FilipPaul/DIPLOMKA/tex/aktualni_19_05_2023/text/zkratky.tex

\cleardoublepage
\chapter*{\listofabbrevname}
\phantomsection
\addcontentsline{toc}{chapter}{\listofabbrevname}

\begin{acronym}[HowMuchSpace]
	\acro{ADC}{Analogově-Digitální Převodník}
	\acro{ARP}{Address Resolution Protocol}
	\acro{A/D}{Analogově-Digitální Převodník}
	\acro{bRC}{piny na spodní straně fixture}
	\acro{DAC}{Digitálně-Analogový Převodník}
	\acro{D/A}{Digitálně-Analogový Převodník}
	\acro{EEPROM}{Electrically Erasable Programmable Read-Only Memory}
	\acro{ESD}{Electrostatic Discharge - elektrostatický výboj}
	\acro{Fixture}{Vyměnitelný adaptér se zakládacím polem pro ICT testery}
	\acro{LED}{Light Emitting Diode}
	\acro{LWIP}{Lightweight IP}
	\acro{I2C}{Inter-Integrated Circuit}
	\acro{MAC}{Media Access Control}
	\acro{MDIX}{Medium Dependent Interface Crossover}
	\acro{PC}{Personal Computer - Počítač}
	\acro{PCB}{Printed Circuit Board - Deska plošných spojů}
	\acro{PHY}{Physical Layer - fyzická vrstva}
	\acro{Probes}{Testovací jehly}
	\acro{USB OTG}{USB On-The-Go}
	\acro{RMII}{Reduced Media Independent Interface}
\end{acronym}
