FilipPaul/DIPLOMKA/tex/aktualni_19_05_2023/text/literatura.tex

% Pro sazbu seznamu literatury použijte jednu z následujících možností

%%%%%%%%%%%%%%%%%%%%%%%%%%%%%%%%%%%%%%%%%%%%%%%%%%%%%%%%%%%%%%%%%%%%%%%%%
%1) Seznam citací definovaný přímo pomocí prostředí literatura / thebibliography

\begin{thebibliography}{99}

\bibitem{HOROWITZ}
    HOROWITZ, P., HILL, W.:
    \emph{The Art of Electronics.}\/ [online].
    2015, New York: Cambridge University Press, [cit.\,27.\,12.\,2022].
    Dostupné z~URL (direct download):\\
    <\url{https://www.uvm.edu/~gpetrucc/courses/Chem219/Lectures/Paul%20Horowitz,%20Winfield%20Hill%20-%20The%20Art%20of%20Electronics-Cambridge%20University%20Press%20(2015).pdf}>.

\bibitem{MARTINT}
    MARTIN, T.:
    \emph{he Insider's Guide to the STM32 ARM Based Microcontroller.}\/ [online].
    2008, T Coventry: Hitex Ltd., UK, [cit.\,27.\,12.\,2022].
    Dostupné z~URL:\\
    <\url{https://www.hitex.com/fileadmin/documents/tools/dev_tools/dt_protected/insiders-guides/stm32/isg-stm32-v18d-scr.pdf
    }>.

\bibitem{ICTkeysight}
    KEYSIGHT TECHNOLOGIES:
    \emph{Keysight Medalist i3070 Series 5}\/ [online].
		2017, Product datasheet Nr. 5990-4344EN [cit.\,27.\,12.\,2022].
    Dostupné z~URL:\\
    <\url{https://www.keysight.com/zz/en/assets/7018-02227/data-sheets/5990-4344.pdf}>.

\bibitem{ICT_picture}
    ACCULOGIC:
    \emph{Keysight (Agilent) 3070 Test Program}\/ [online].
    Keysight (Agilent) 3070 Test Program - product webpage [cit.\,27.\,12.\,2022].
    Dostupné z~URL:\\
    <\url{https://acculogic.com/services/test-engineering-services/in-circuit-test-programming-services/agilent-hp-3070-test-program-development-services/}>.

\bibitem{ICT_guidline}
    TERADYNE, Smith, J. Michael:
    \emph{ICT Fixture Guidelines}\/ [online].
    ICT Fixture Guidelines, Test Techniques and Practices [cit.\,27.\,12.\,2022].
    Dostupné z~URL (direct download):\\
    <\url{https://courseware.zcu.cz/CoursewarePortlets2/DownloadDokumentu?id=114866}>.

\bibitem{CAD_wiki}
    Wikipedia:
    \emph{CAD data exchange}\/ [online].
    2022, Wikipedia - CAD data exchange [cit.\,27.\,12.\,2022].
    Dostupné z~URL:\\
    <\url{https://en.wikipedia.org/wiki/CAD_data_exchange}>.

\bibitem{Sensitivity_embedded}
    Mark Fortunato:
    \emph{Analyzing circuit sensitivity for analog circuit design}\/ [online].
    2008, Analyzing circuit sensitivity for analog circuit design - Embedded Staff magazine [cit.\,27.\,12.\,2022].
    Dostupné z~URL:\\
    <\url{https://www.embedded.com/analyzing-circuit-sensitivity-for-analog-circuit-design/}>.

\bibitem{Sensitivity_2}
    Emmanuel A. Gonzalez,  Martin Christian G. Leonor, Leonard U. Ambata:
    \emph{Analyzing Sensitivity in Electric Circuits}\/ [online].
    2007,Analyzing Sensitivity in Electric Circuits - IEEE MULTIDISCIPLINARY ENGINEERING EDUCATION MAGAZINE [cit.\,27.\,12.\,2022].
    Dostupné z~URL (direct download):\\
    <\url{https://nanopdf.com/download/analyzing-sensitivity-in-electric-circuits_pdf}>.

\bibitem{PMOS_datasheet}
    TOSHIBA:
    \emph{SSM3J358R}\/ [online].
    SSM3J358R - Product datasheet [cit.\,27.\,12.\,2022].
    Dostupné z~URL:\\
    <\url{https://cz.mouser.com/datasheet/2/408/SSM3J358R_datasheet_en_20170124-1916450.pdf}>.

\bibitem{NMOS_datasheet}
    PANJIT Semiconductor:
    \emph{PJA3432}\/ [online].
    PJA3432 - Product datasheet [cit.\,27.\,12.\,2022].
    Dostupné z~URL:\\
    <\url{https://cz.mouser.com/datasheet/2/1057/PJA3432-1867274.pdf}>.

\bibitem{comp_datasheet}
    TEXAS INSTRUMENTS:
    \emph{LM393LV-Q1 Dual and LM339LV-Q1 Quad Low Voltage, RRI Automotive Comparators}\/ [online].
    LM393LV-Q1 Dual and LM339LV-Q1 Quad Low Voltage, RRI Automotive Comparators - Product datasheet [cit.\,27.\,12.\,2022].
    Dostupné z~URL:\\
    <\url{https://www.ti.com/lit/ds/symlink/lm393lv-q1.pdf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}>.

\bibitem{shift_datasheet}
    TEXAS INSTRUMENTS:
    \emph{SNx4AHCT595 8-Bit Shift Registers With 3-State Output Registers}\/ [online].
    SNx4AHCT595 8-Bit Shift Registers With 3-State Output Registers - Product datasheet [cit.\,27.\,12.\,2022].
    Dostupné z~URL:\\
    <\url{https://www.ti.com/lit/ds/symlink/sn74ahct595.pdf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}>.

\bibitem{mux_datasheet}
    TEXAS INSTRUMENTS:
    \emph{TMUX13xx-Q1 Automotive 5-V, Bidirectional 8:1, 1-Channel and 4:1, 2-Channel
    Multiplexers with Injection Current Control}\/ [online].
    TMUX13xx-Q1 Automotive 5-V, Bidirectional 8:1, 1-Channel and 4:1, 2-Channel
    Multiplexers with Injection Current Control - Product datasheet [cit.\,27.\,12.\,2022].
    Dostupné z~URL:\\
    <\url{https://www.ti.com/lit/ds/symlink/tmux1308-q1.pdf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}>.

\bibitem{regulator_datasheet}
    TEXAS INSTRUMENTS:
    \emph{TLV767 1-A, 16-V Precision Linear Voltage Regulator}\/ [online].
    TLV767 1-A, 16-V Precision Linear Voltage Regulator - Product datasheet [cit.\,27.\,12.\,2022].
    Dostupné z~URL:\\
    <\url{https://www.ti.com/lit/ds/symlink/tlv767.pdf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}>.

\bibitem{DAC}
    STMICROELECTRONICS:
    \emph{Extending the DAC performance of STM32 microcontrollers}\/ [online].
    Application note - AN4566 [cit.\,27.\,12.\,2022].
    Dostupné z~URL:\\
    <\url{https://www.st.com/resource/en/application_note/an4566-extending-the-dac-performance-of-stm32-microcontrollers-stmicroelectronics.pdf}>.

\bibitem{DAC_stability}
    Soufiane Bendaoud, Giampaolo Marino:
    \emph{Practical Techniques to Avoid Instability Due to Capacitive Loading}\/ [online].
    Ask The Application Engineer - 32 [cit.\,27.\,12.\,2022].
    Dostupné z~URL:\\
    <\url{https://ez.analog.com/cfs-file/__key/telligent-evolution-components-attachments/00-383-00-00-00-01-74-37/plugin_2D00_capacitive_5F00_loading_2D00_1.pdf}>.

\bibitem{OPA_stability}
    Tim Green, Texas Instruments:
    \emph{Operational Amplifier Stability Part 6 of 15: Capacitance-Load Stability}\/ [online].
    Burr-Brown Products from Texas Instruments, published in analogZone [cit.\,27.\,12.\,2022].
    Dostupné z~URL:\\
    <\url{https://picture.iczhiku.com/resource/eetop/sYKySllZpyOOSBNB.pdf}>.

\bibitem{OPA_datasheet}
    ANALOG DEVICES:
    \emph{Low Cost, 250 mA Output Single-Supply Amplifiers}\/ [online].
    AD8531/AD8532/AD8534 - Product datasheet [cit.\,30.\,04.\,2022].
    Dostupné z~URL:\\
    <\url{https://pdf1.alldatasheet.com/datasheet-pdf/view/48476/AD/AD8532.html}>.

\end{thebibliography}

%%%%%%%%%%%%%%%%%%%%%%%%%%%%%%%%%%%%%%%%%%%%%%%%%%%%%%%%%%%%%%%%%%%%%%%%%
%%2) Seznam citací pomocí BibTeXu
%% Při použití je nutné v TeXnicCenter ve výstupním profilu aktivovat spouštění BibTeXu po překladu.
%% Definice stylu seznamu
%\bibliographystyle{unsrturl}
%% Pro českou sazbu lze použít styl czechiso.bst ze stránek
%% http://www.fit.vutbr.cz/~martinek/latex/czechiso.tar.gz
%%\bibliographystyle{czechiso}
%% Vložení souboru se seznamem citací
%\bibliography{text/literatura}
%
%% Následující příkaz je pouze pro ukázku sazby literatury při použití BibTeXu.
%% Způsobí citaci všech zdrojů v souboru literatura.bib, i když nejsou citovány v textu.
%\nocite{*}
