FilipPaul/DIPLOMKA/tex/aktualni_19_05_2023/obrazky/general_dVF-eps-converted-to.pdf

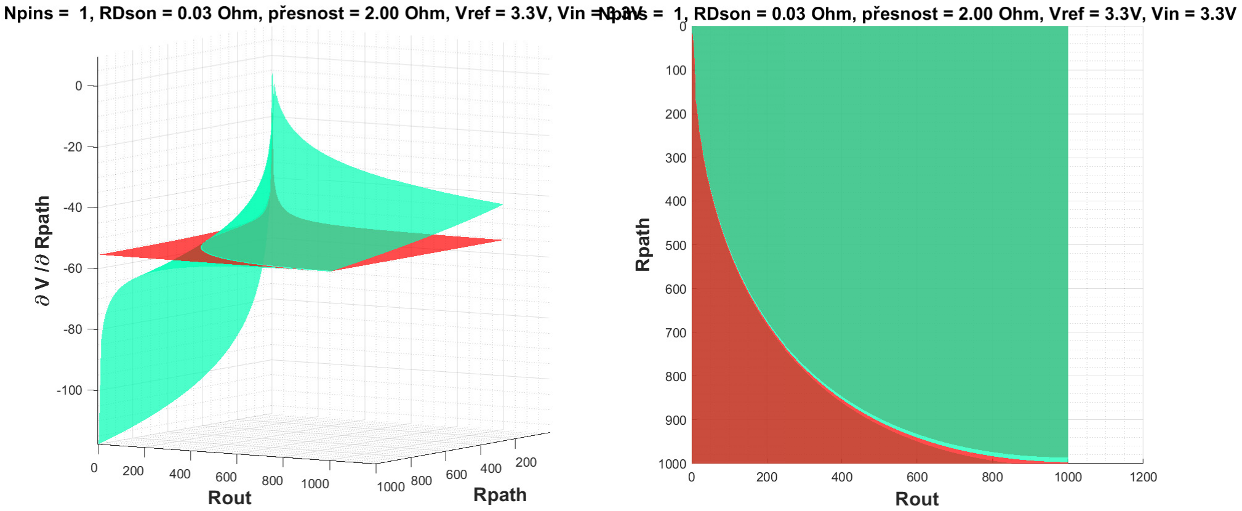
[picture p42: page 1]
