FilipPaul/DIPLOMKA/tex/aktualni_19_05_2023/obrazky/MERENI_JEDNOHO_PINU-eps-converted-to.pdf

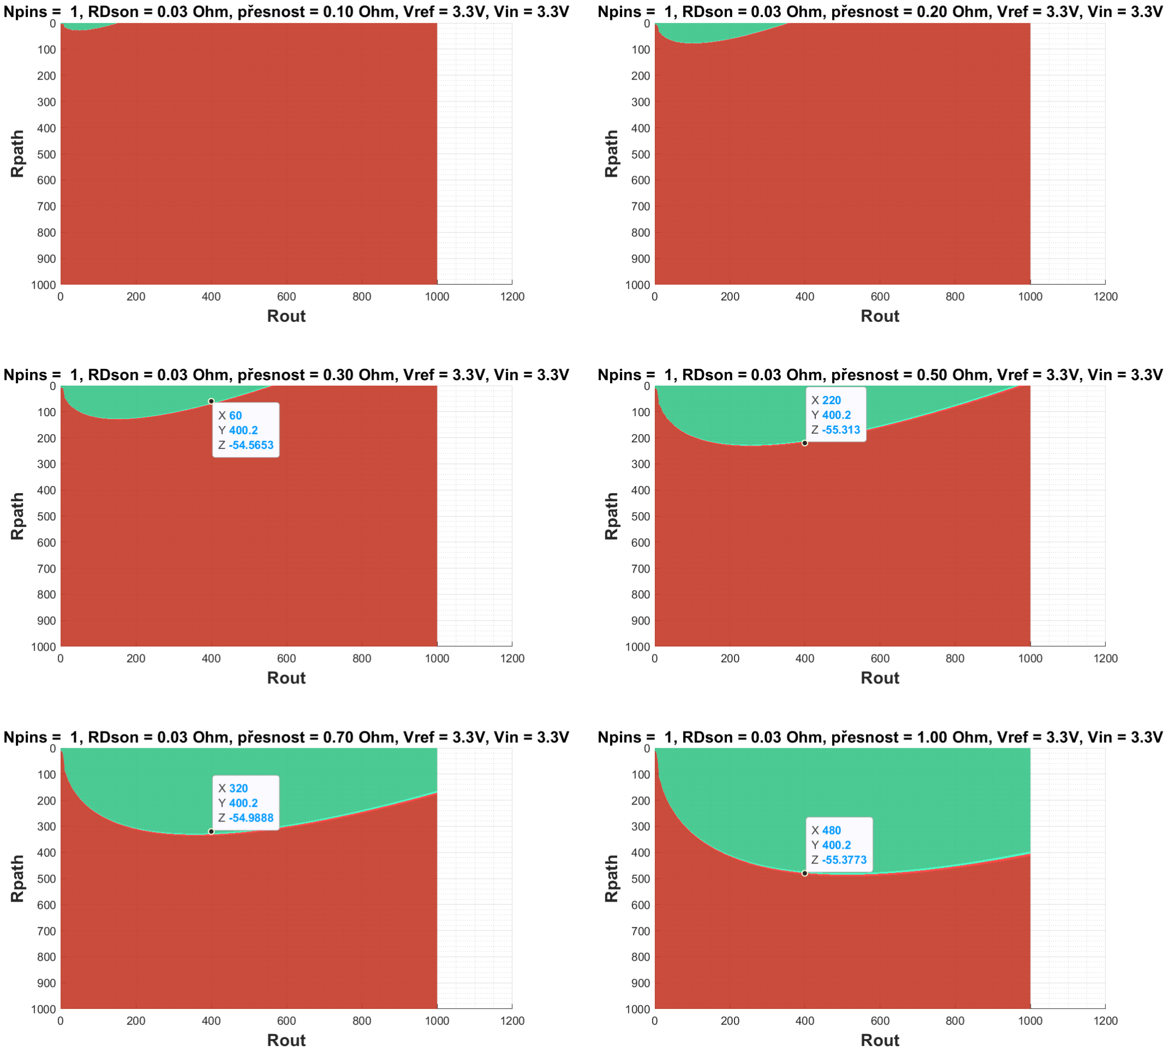
[picture p43: page 1]
