FilipPaul/DIPLOMKA/tex/aktualni_19_05_2023/obrazky/PASS_FAIL_MERENI-eps-converted-to.pdf

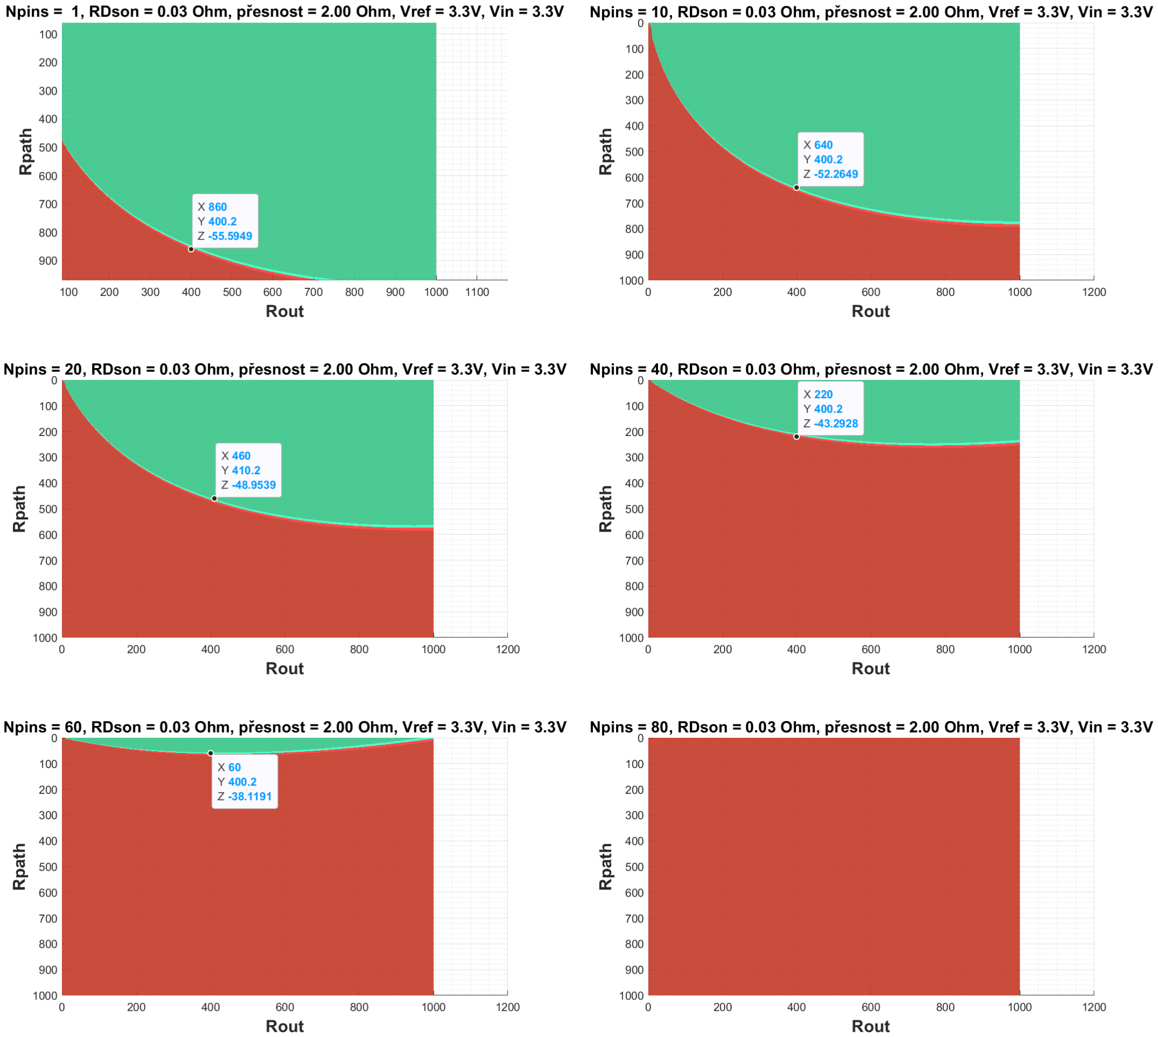
[picture p44: page 1]
