FilipPaul/DIPLOMKA/tex/aktualni_19_05_2023/obrazky/R_net_3D_view-eps-converted-to.pdf

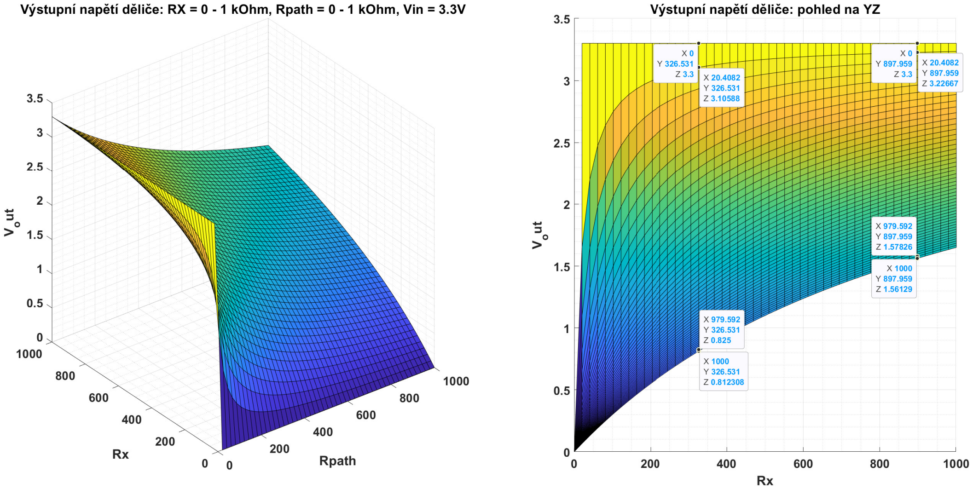
[picture p45: page 1]
