FilipPaul/DIPLOMKA/tex/aktualni_19_05_2023/obrazky/vliv_RDSON-eps-converted-to.pdf

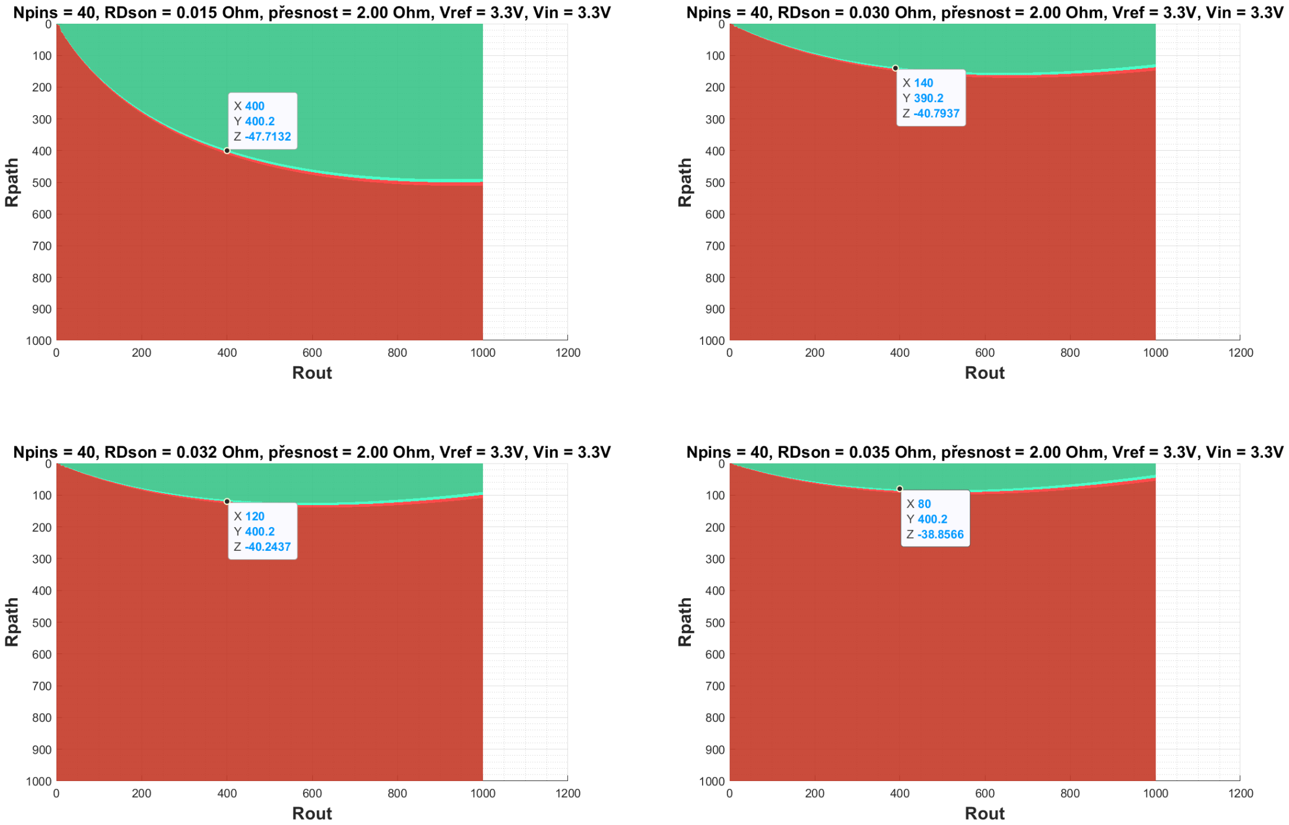
[picture p46: page 1]
