FilipPaul/DIPLOMKA/tex/aktualni_19_05_2023/obrazky/Vout3D-eps-converted-to.pdf

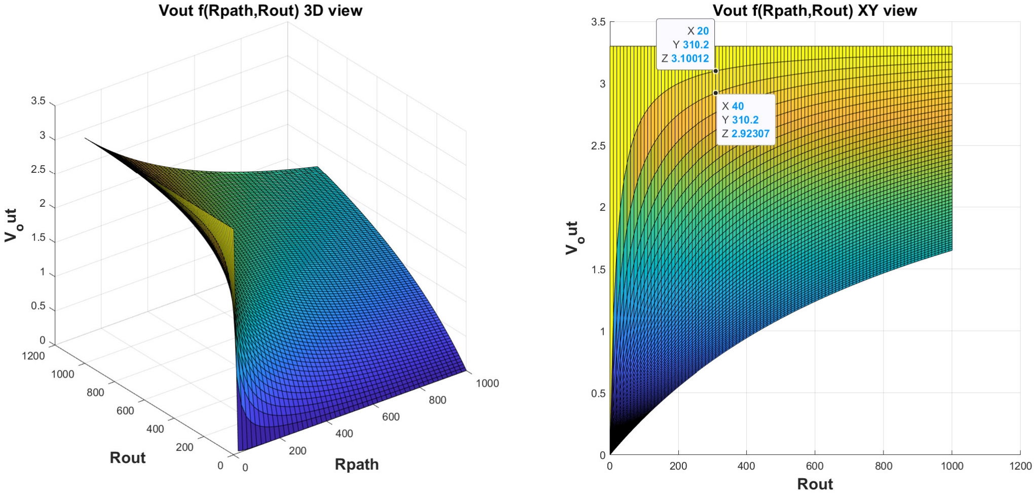
[picture p47: page 1]
