FilipPaul/DIPLOMKA/PSCM_7Fold_STA3/output.png

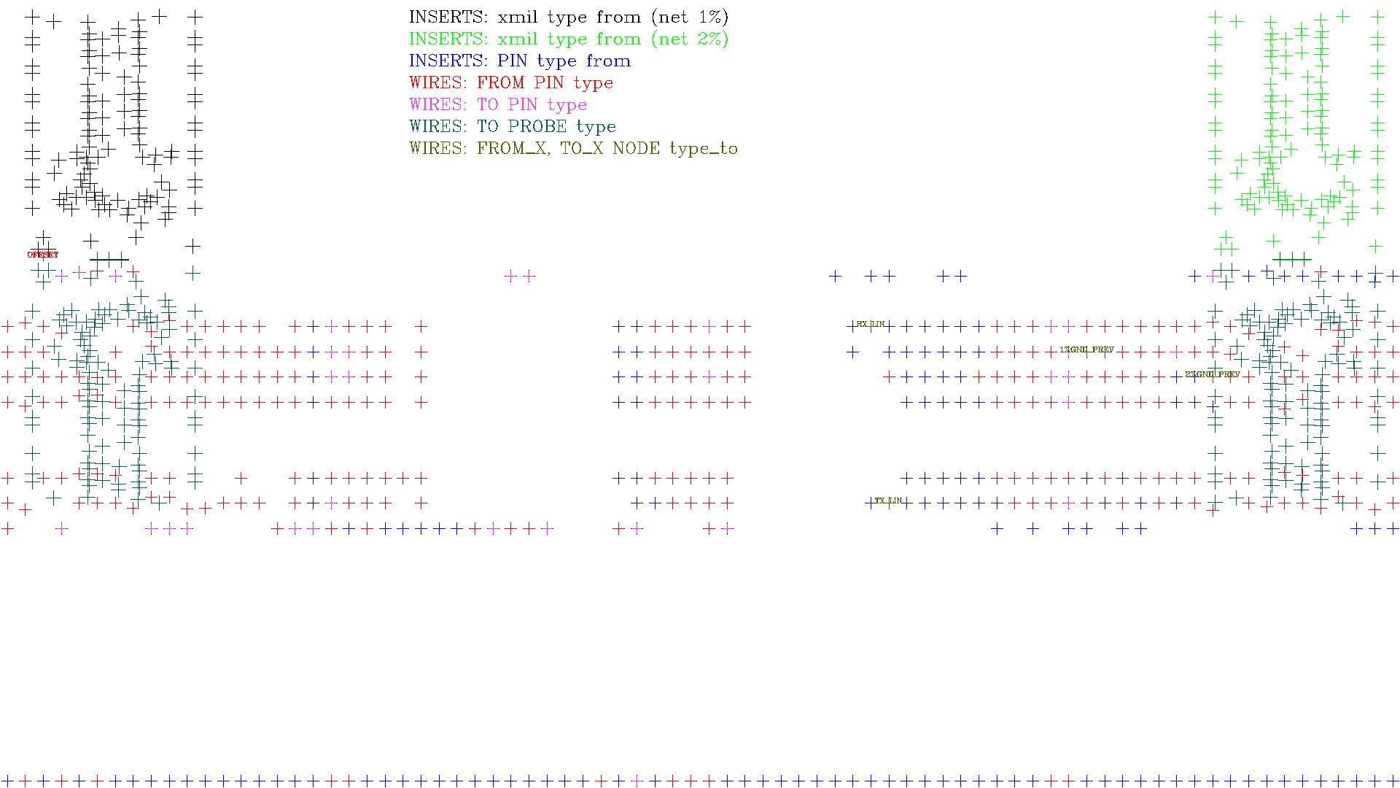
PSCM_7Fold_STA3/output.png
