FilipPaul/DIPLOMKA/PSCM_7Fold_STA3/trace_wires.png

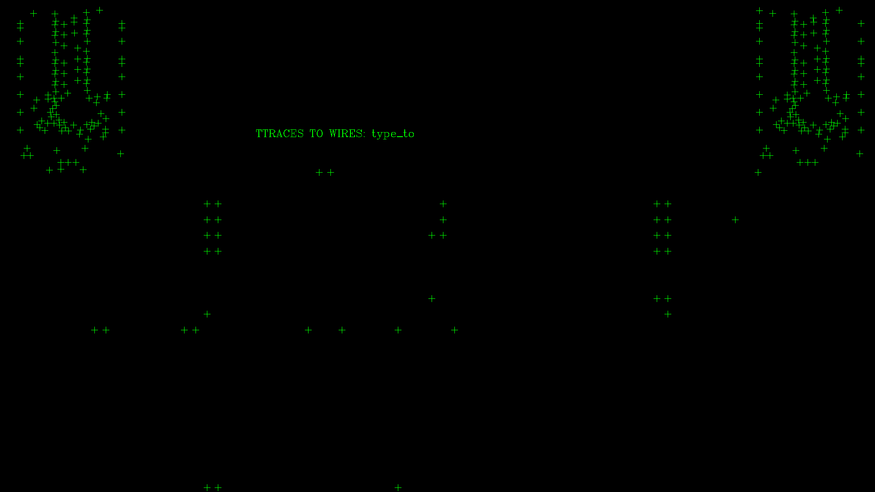
PSCM_7Fold_STA3/trace_wires.png
