FilipPaul/DIPLOMKA/tex/aktualni_19_05_2023/obrazky/CLK_config.png

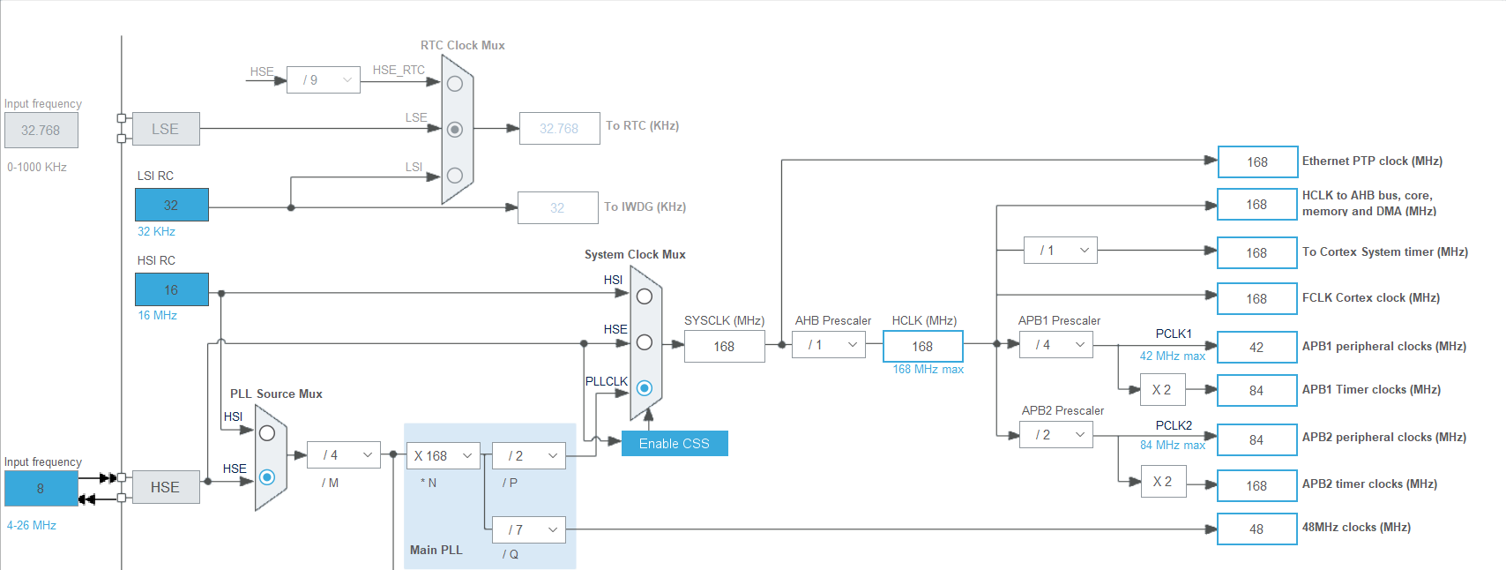
tex/aktualni_19_05_2023/obrazky/CLK_config.png
