FilipPaul/DIPLOMKA/tex/aktualni_19_05_2023/obrazky/CLK_rezonator.png

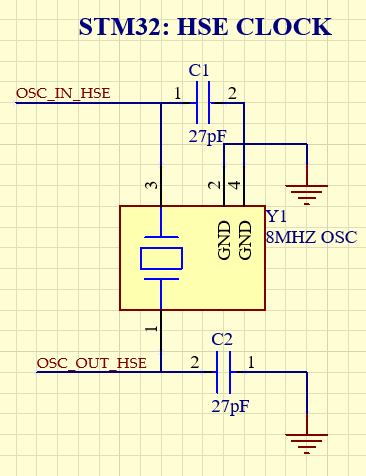
tex/aktualni_19_05_2023/obrazky/CLK_rezonator.png
