FilipPaul/DIPLOMKA/tex/aktualni_19_05_2023/obrazky/final_analog_frontend.png

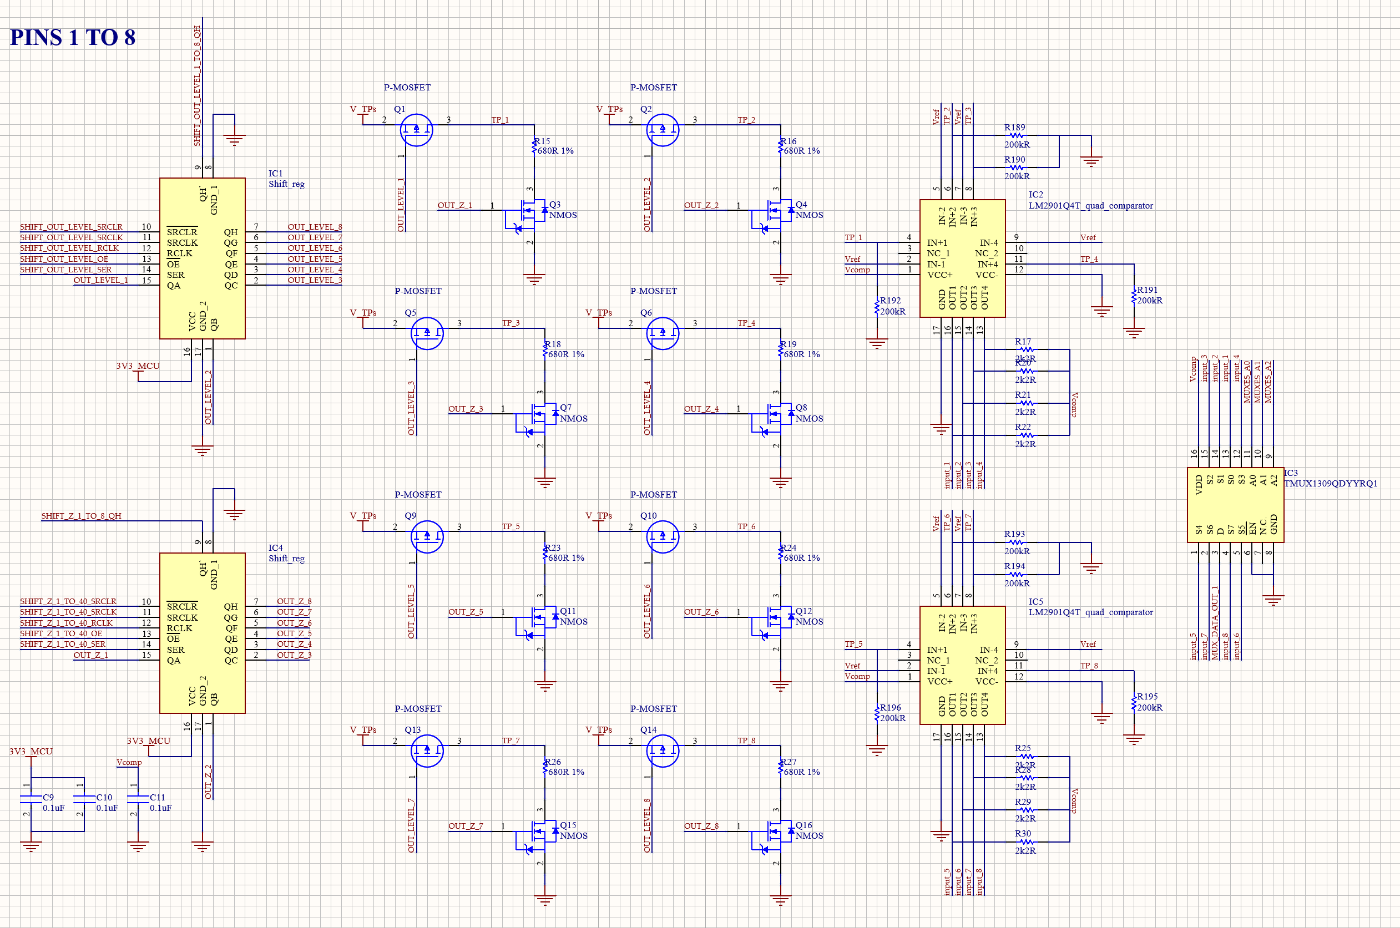
tex/aktualni_19_05_2023/obrazky/final_analog_frontend.png
