FilipPaul/DIPLOMKA/tex/aktualni_19_05_2023/obrazky/IMG_20220402_110809.jpg

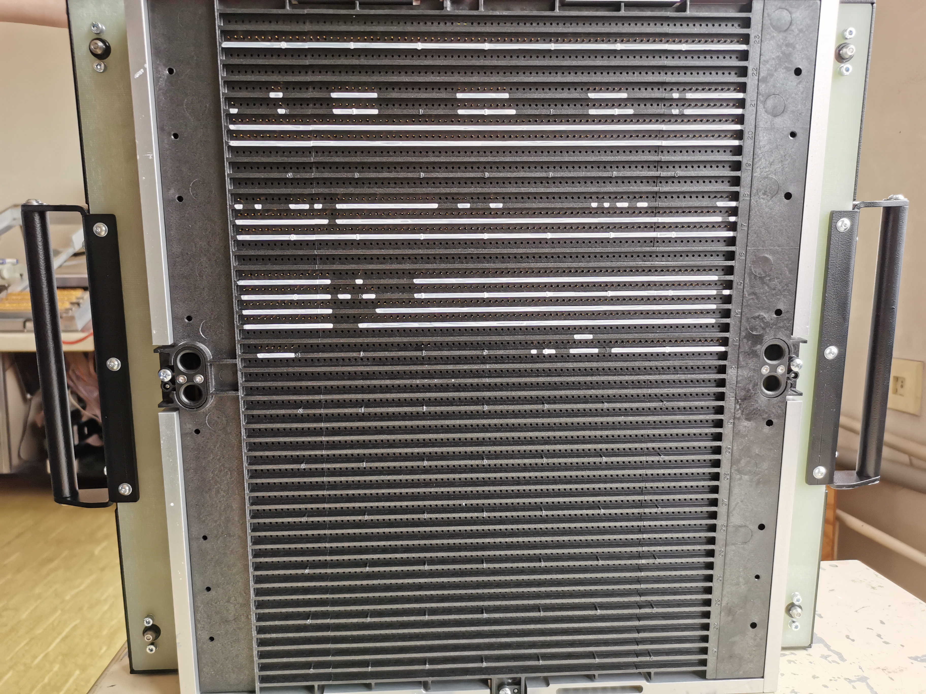
tex/aktualni_19_05_2023/obrazky/IMG_20220402_110809.jpg
