FilipPaul/DIPLOMKA/tex/aktualni_19_05_2023/obrazky/IMG_20220402_110835.jpg

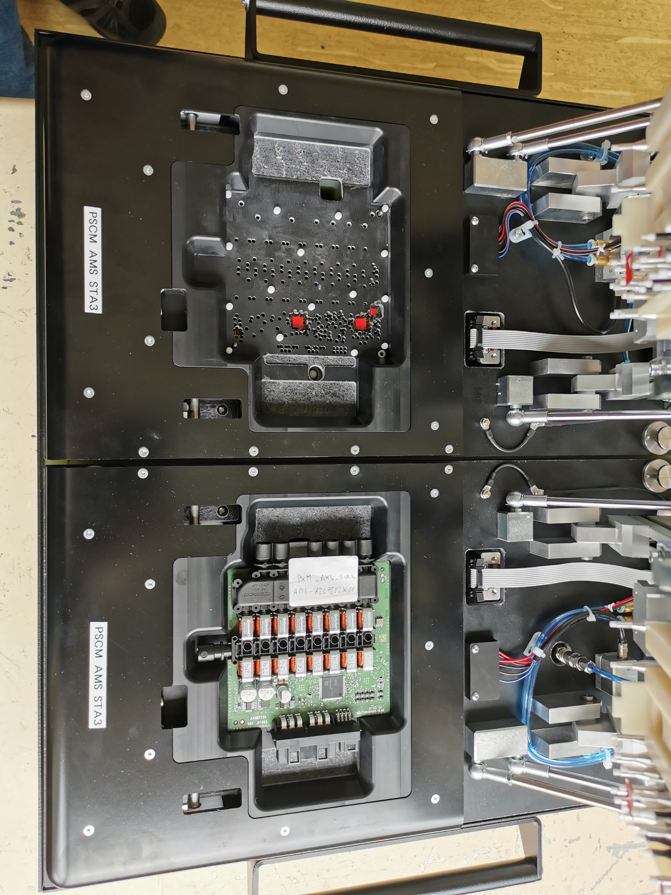
tex/aktualni_19_05_2023/obrazky/IMG_20220402_110835.jpg
