FilipPaul/DIPLOMKA/tex/aktualni_19_05_2023/obrazky/IMG_20221017_144735.jpg

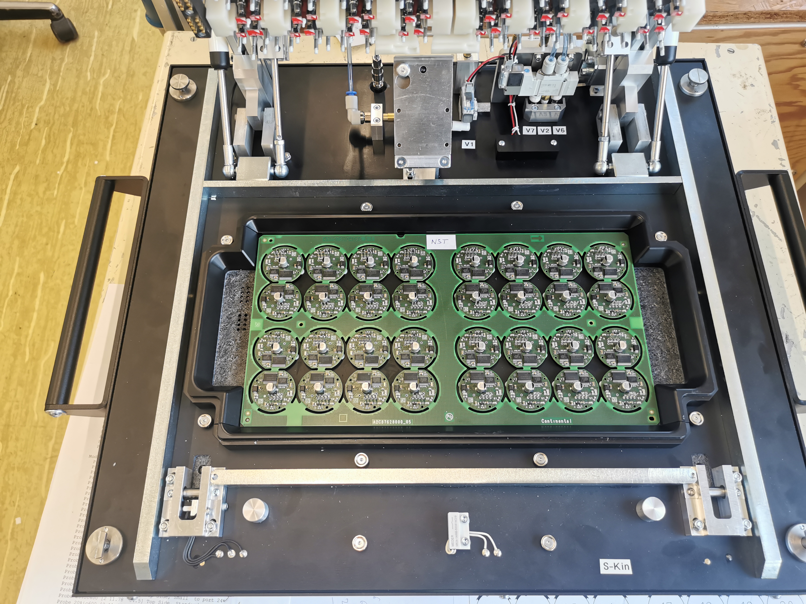
tex/aktualni_19_05_2023/obrazky/IMG_20221017_144735.jpg
