FilipPaul/DIPLOMKA/tex/aktualni_19_05_2023/obrazky/karta_3D_bot.png

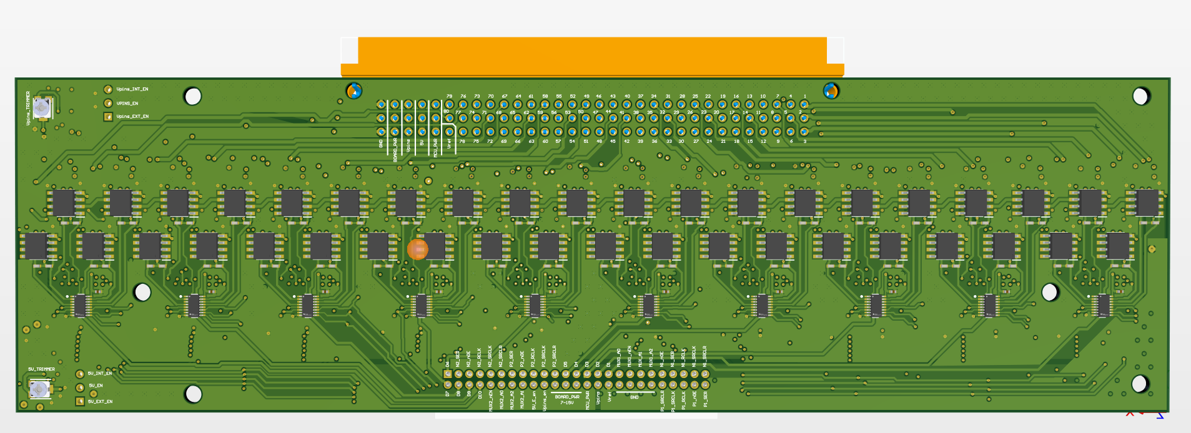
tex/aktualni_19_05_2023/obrazky/karta_3D_bot.png
