FilipPaul/DIPLOMKA/tex/aktualni_19_05_2023/obrazky/layer_3.png

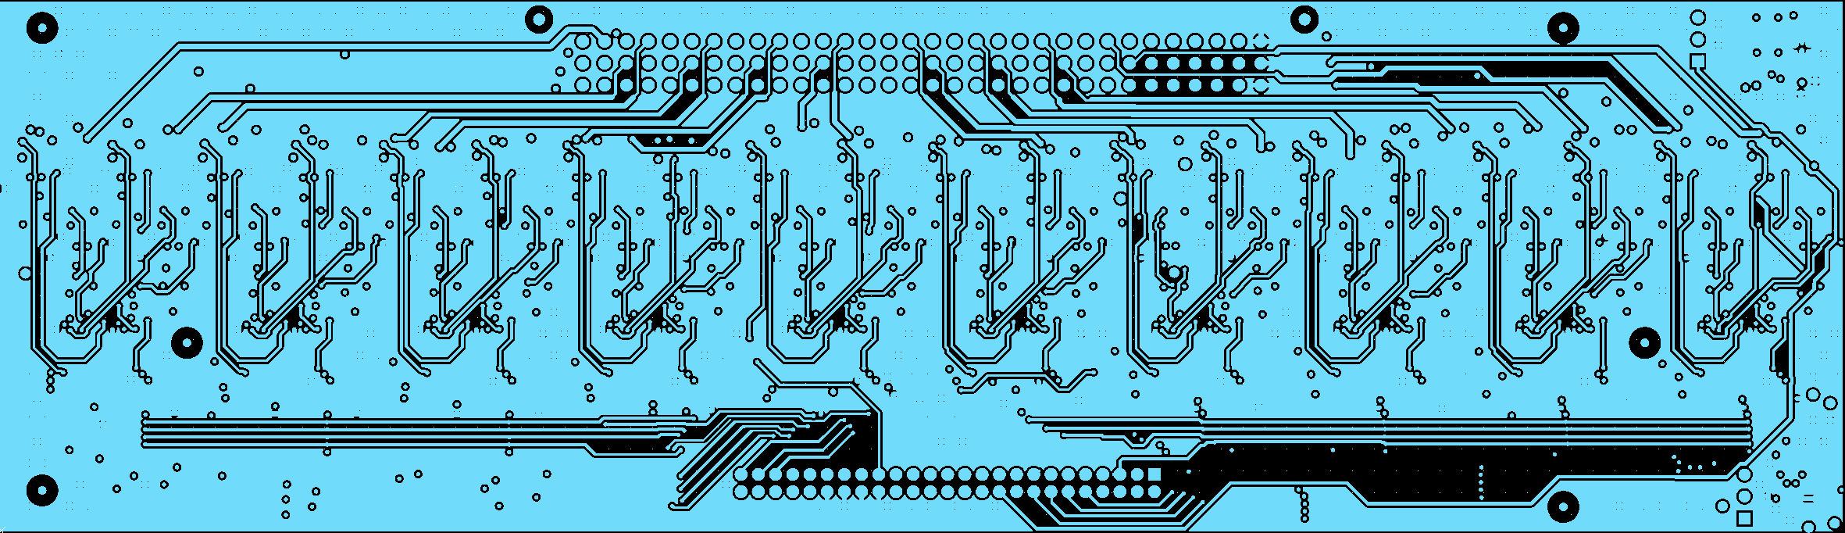
tex/aktualni_19_05_2023/obrazky/layer_3.png
