FilipPaul/DIPLOMKA/tex/aktualni_19_05_2023/obrazky/layer_5.png

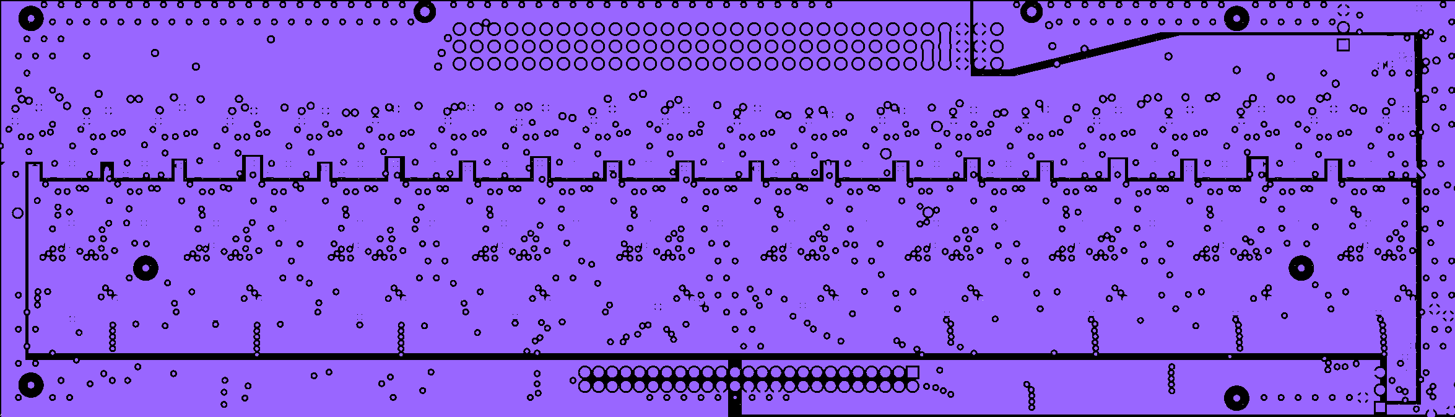
tex/aktualni_19_05_2023/obrazky/layer_5.png
