FilipPaul/DIPLOMKA/tex/aktualni_19_05_2023/obrazky/layer_top.png

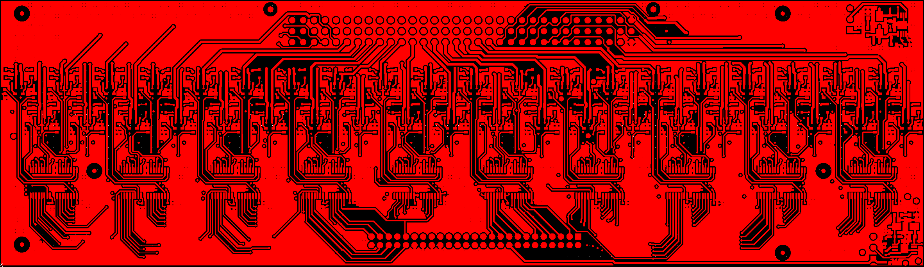
tex/aktualni_19_05_2023/obrazky/layer_top.png
