FilipPaul/DIPLOMKA/tex/aktualni_19_05_2023/obrazky/PC_AP_top_another_one.png

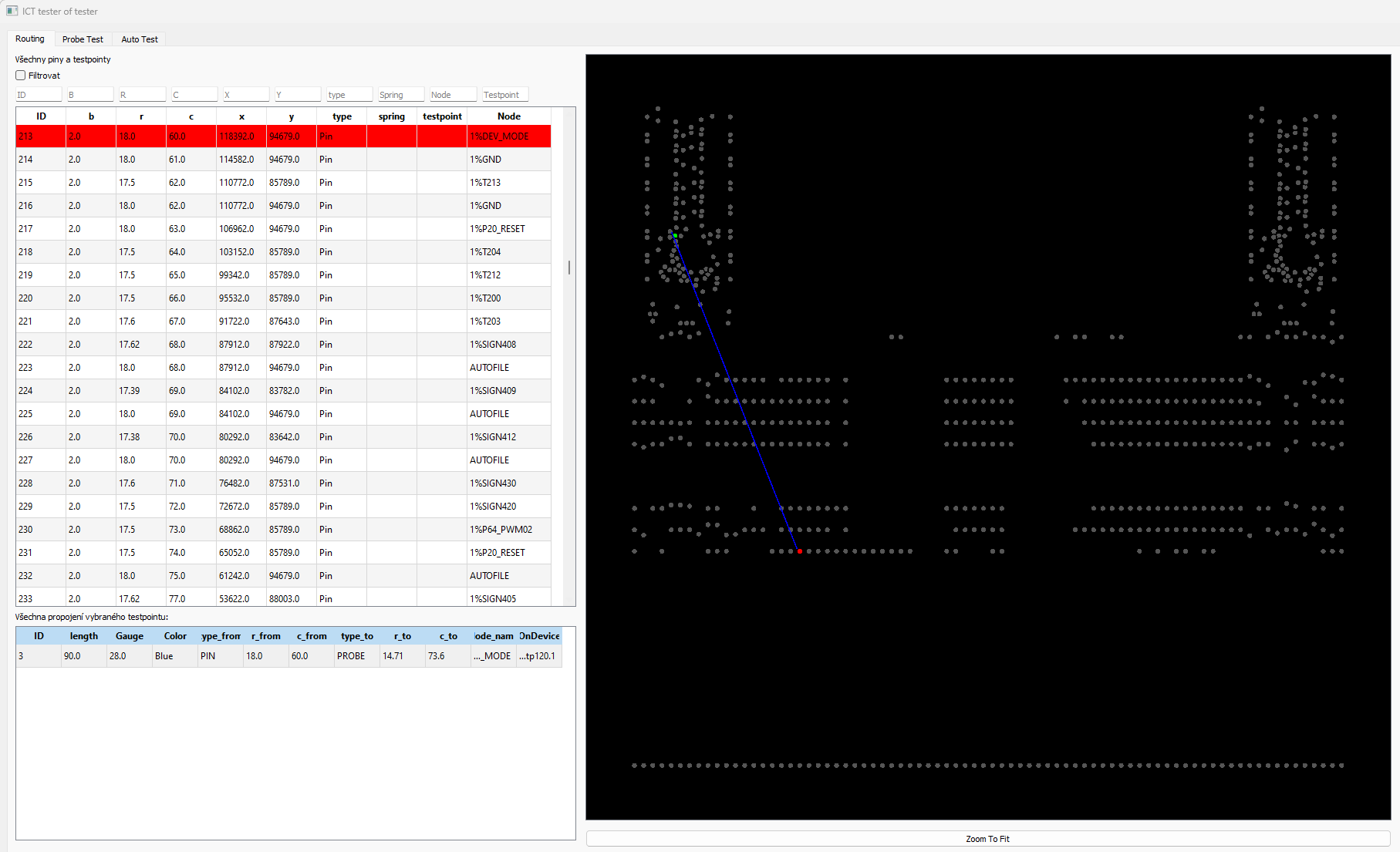
tex/aktualni_19_05_2023/obrazky/PC_AP_top_another_one.png
