FilipPaul/DIPLOMKA/tex/aktualni_19_05_2023/obrazky/placeholder.png

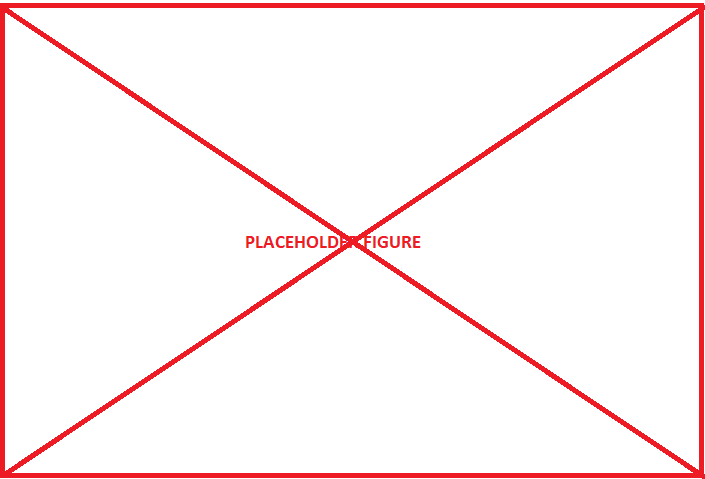
tex/aktualni_19_05_2023/obrazky/placeholder.png
