FilipPaul/DIPLOMKA/tex/aktualni_19_05_2023/obrazky/snubber_values.png

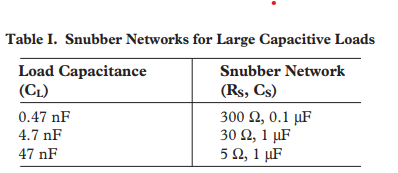
tex/aktualni_19_05_2023/obrazky/snubber_values.png
