FilipPaul/DIPLOMKA/tex/aktualni_19_05_2023/obrazky/system_connection.png

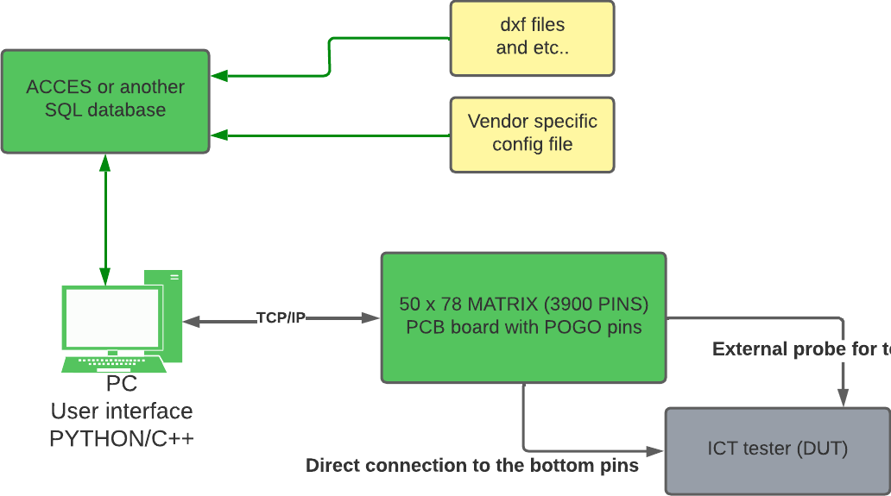
tex/aktualni_19_05_2023/obrazky/system_connection.png
