FilipPaul/DIPLOMKA/tex/aktualni_19_05_2023/obrazky/telnet_communication.png

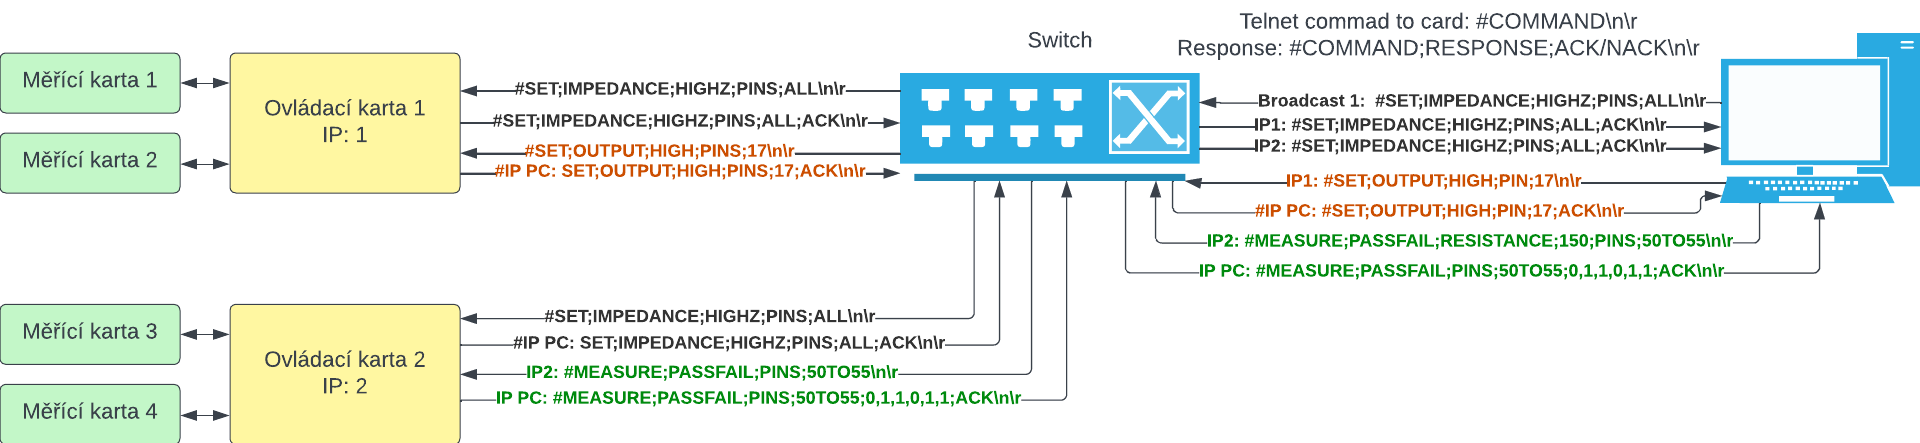
tex/aktualni_19_05_2023/obrazky/telnet_communication.png
