FilipPaul/DIPLOMKA/tex/sablona-cze/obrazky/pcb_layout_ctr_board_draftsman.png

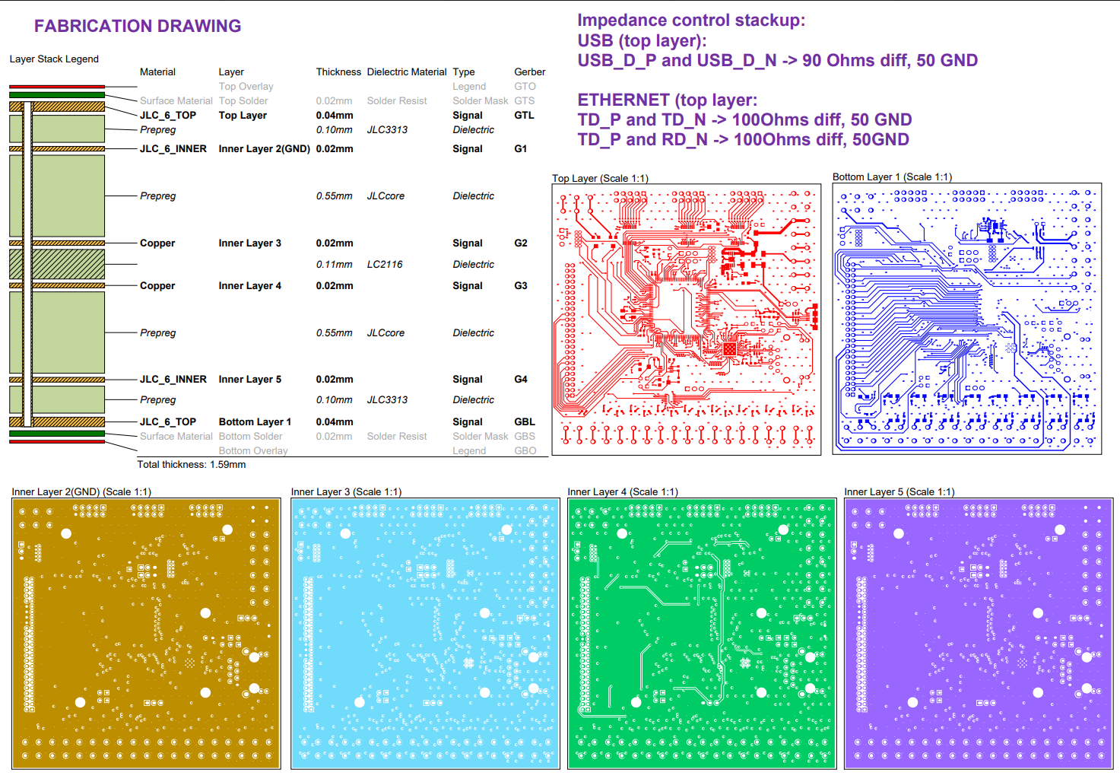
tex/sablona-cze/obrazky/pcb_layout_ctr_board_draftsman.png
