FilipPaul/DIPLOMKA/PCB_merici_karta/osazovak_a_BOM.xlsx

Sheet: BOM-Souhrn
BOM a PICKPLACE pro Analogovou desku testeru zkratů | 2023-03-04
 |  |  |  | Počet desek | 50
LINK | DESCRIPTION1 | DESCRIPTION 2 | DESIGNATOR | Qtty (1deska) | celkem na x deskách
C0402C104K3RACTU KEMET | Mouser Česká Republika (https://cz.mouser.com/ProductDetail/KEMET/C0402C104K3RACTU?qs=YCcZ0GhAU2q7BaxZ%2FluQHA%3D%3D) | 100nF | Cap Ceramic 0.1uF 25V X7R 10% Pad SMD 0402 125C T/R | 8pins1_C18, 8pins1_C19, 8pins1_C20, 8pins2_C18, 8pins2_C19, 8pins2_C20, 8pins3_C18, 8pins3_C19, 8pins3_C20, 8pins4_C18, 8pins4_C19, 8pins4_C20, 8pins5_C18, 8pins5_C19, 8pins5_C20, 8pins6_C18, 8pins6_C19, 8pins6_C20, 8pins7_C18, 8pins7_C19, 8pins7_C20, 8pins8_C18, 8pins8_C19, 8pins8_C20, 8pins9_C18, 8pins9_C19, 8pins9_C20, 8pins10_C18, 8pins10_C19, 8pins10_C20 | 30 | 1500
SN74AHCT595PWR Texas Instruments | Mouser Česká Republika (https://cz.mouser.com/ProductDetail/?qs=spW5eSrOWB5KP%2FLOxGLzFA%3D%3D) | SN74AHCT595PWR | 8-Bit Shift Registers With 3-State Output Registers, PW0016A, LARGE T&R | 8pins1_U2, 8pins1_U4, 8pins2_U2, 8pins2_U4, 8pins3_U2, 8pins3_U4, 8pins4_U2, 8pins4_U4, 8pins5_U2, 8pins5_U4, 8pins6_U2, 8pins6_U4, 8pins7_U2, 8pins7_U4, 8pins8_U2, 8pins8_U4, 8pins9_U2, 8pins9_U4, 8pins10_U2, 8pins10_U4 | 20 | 1000
TMUX1308QDYYRQ1 Texas Instruments | Mouser Česká Republika (https://cz.mouser.com/ProductDetail/Texas-Instruments/TMUX1308QDYYRQ1?qs=xZ%2FP%252Ba9zWqaqz9D2kpWQ%2FA%3D%3D) | TMUX1308QDYYRQ1 | AUTOMOTIVE, 5-V, 8:1, 1-CHANNEL | 8pins1_U3, 8pins2_U3, 8pins3_U3, 8pins4_U3, 8pins5_U3, 8pins6_U3, 8pins7_U3, 8pins8_U3, 8pins9_U3, 8pins10_U3 | 10 | 500
F381A106MMAAH1 KYOCERA AVX | Mouser Česká Republika (https://cz.mouser.com/ProductDetail/KYOCERA-AVX/F381A106MMAAH1) | 10uF | CAP TANT POLY 10UF 10V SMD | C21, C27 | 2 | 100
C1608X7R1E105K080AB TDK | Mouser Česká Republika (https://cz.mouser.com/ProductDetail/TDK/C1608X7R1E105K080AB?qs=NRhsANhppD8okfR52aTdVA%3D%3D) | 1uF 25V | General Purpose Ceramic Capacitor, 0603, 1uF, 10%, X5R, 15%, 25V | C22, C28 | 2 | 100
SML-D12U1WT86 ROHM Semiconductor | Mouser Česká Republika (https://cz.mouser.com/ProductDetail/ROHM-Semiconductor/SML-D12U1WT86?qs=M3jcYzEJUdEySuGkbjHEtQ%3D%3D) | LED | LED RED DIFFUSED 1608 SMD | D1, D3 | 2 | 100
SSA34HE3_A/I Vishay General Semiconductor | Mouser Česká Republika (https://cz.mouser.com/ProductDetail/Vishay-General-Semiconductor/SSA34HE3_A-I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) | SSA34HE3_A_I | Schottky Diode | D11, D13 | 2 | 100
LM393LVQDRQ1 Texas Instruments | Mouser Česká Republika (https://cz.mouser.com/ProductDetail/Texas-Instruments/LM393LVQDRQ1?qs=IS%252B4QmGtzzqk8QFsvXuXMw%3D%3D) | LM393LVQDRQ1 | Integrated Circuit | dTP1_IC1, dTP2_IC1, dTP3_IC1, dTP4_IC1, dTP5_IC1, dTP6_IC1, dTP7_IC1, dTP8_IC1, dTP9_IC1, dTP10_IC1, dTP11_IC1, dTP12_IC1, dTP13_IC1, dTP14_IC1, dTP15_IC1, dTP16_IC1, dTP17_IC1, dTP18_IC1, dTP19_IC1, dTP20_IC1, dTP21_IC1, dTP22_IC1, dTP23_IC1, dTP24_IC1, dTP25_IC1, dTP26_IC1, dTP27_IC1, dTP28_IC1, dTP29_IC1, dTP30_IC1, dTP31_IC1, dTP32_IC1, dTP33_IC1, dTP34_IC1, dTP35_IC1, dTP36_IC1, dTP37_IC1, dTP38_IC1, dTP39_IC1, dTP40_IC1 | 40 | 2000
SSM3J358R,LF Toshiba | Mouser Česká Republika (https://cz.mouser.com/ProductDetail/Toshiba/SSM3J358RLF?qs=HXFqYaX1Q2xwvCtt1GGmkw%3D%3D) | P-MOSFET | MOSFET (P-Channel) - low RDS on | dTP1_Q1, dTP1_Q2, dTP2_Q1, dTP2_Q2, dTP3_Q1, dTP3_Q2, dTP4_Q1, dTP4_Q2, dTP5_Q1, dTP5_Q2, dTP6_Q1, dTP6_Q2, dTP7_Q1, dTP7_Q2, dTP8_Q1, dTP8_Q2, dTP9_Q1, dTP9_Q2, dTP10_Q1, dTP10_Q2, dTP11_Q1, dTP11_Q2, dTP12_Q1, dTP12_Q2, dTP13_Q1, dTP13_Q2, dTP14_Q1, dTP14_Q2, dTP15_Q1, dTP15_Q2, dTP16_Q1, dTP16_Q2, dTP17_Q1, dTP17_Q2, dTP18_Q1, dTP18_Q2, dTP19_Q1, dTP19_Q2, dTP20_Q1, dTP20_Q2, dTP21_Q1, dTP21_Q2, dTP22_Q1, dTP22_Q2, dTP23_Q1, dTP23_Q2, dTP24_Q1, dTP24_Q2, dTP25_Q1, dTP25_Q2, dTP26_Q1, dTP26_Q2, dTP27_Q1, dTP27_Q2, dTP28_Q1, dTP28_Q2, dTP29_Q1, dTP29_Q2, dTP30_Q1, dTP30_Q2, dTP31_Q1, dTP31_Q2, dTP32_Q1, dTP32_Q2, dTP33_Q1, dTP33_Q2, dTP34_Q1, dTP34_Q2, dTP35_Q1, dTP35_Q2, dTP36_Q1, dTP36_Q2, dTP37_Q1, dTP37_Q2, dTP38_Q1, dTP38_Q2, dTP39_Q1, dTP39_Q2, dTP40_Q1, dTP40_Q2 | 80 | 4000
PJA3432_R1_00001 Panjit | Mouser Česká Republika (https://cz.mouser.com/ProductDetail/Panjit/PJA3432_R1_00001?qs=sPbYRqrBIVmGu%2F98hdrYZA%3D%3D) | NMOS | N-Channel MOSFET Transistor PJA3432_R1_00001 | dTP1_Q3, dTP1_Q4, dTP2_Q3, dTP2_Q4, dTP3_Q3, dTP3_Q4, dTP4_Q3, dTP4_Q4, dTP5_Q3, dTP5_Q4, dTP6_Q3, dTP6_Q4, dTP7_Q3, dTP7_Q4, dTP8_Q3, dTP8_Q4, dTP9_Q3, dTP9_Q4, dTP10_Q3, dTP10_Q4, dTP11_Q3, dTP11_Q4, dTP12_Q3, dTP12_Q4, dTP13_Q3, dTP13_Q4, dTP14_Q3, dTP14_Q4, dTP15_Q3, dTP15_Q4, dTP16_Q3, dTP16_Q4, dTP17_Q3, dTP17_Q4, dTP18_Q3, dTP18_Q4, dTP19_Q3, dTP19_Q4, dTP20_Q3, dTP20_Q4, dTP21_Q3, dTP21_Q4, dTP22_Q3, dTP22_Q4, dTP23_Q3, dTP23_Q4, dTP24_Q3, dTP24_Q4, dTP25_Q3, dTP25_Q4, dTP26_Q3, dTP26_Q4, dTP27_Q3, dTP27_Q4, dTP28_Q3, dTP28_Q4, dTP29_Q3, dTP29_Q4, dTP30_Q3, dTP30_Q4, dTP31_Q3, dTP31_Q4, dTP32_Q3, dTP32_Q4, dTP33_Q3, dTP33_Q4, dTP34_Q3, dTP34_Q4, dTP35_Q3, dTP35_Q4, dTP36_Q3, dTP36_Q4, dTP37_Q3, dTP37_Q4, dTP38_Q3, dTP38_Q4, dTP39_Q3, dTP39_Q4, dTP40_Q3, dTP40_Q4 | 80 | 4000
ERJ-PA2F2201X Panasonic | Mouser Česká Republika (https://cz.mouser.com/ProductDetail/Panasonic/ERJ-PA2F2201X) | 2k2 |  | dTP1_R5, dTP1_R6, dTP2_R5, dTP2_R6, dTP3_R5, dTP3_R6, dTP4_R5, dTP4_R6, dTP5_R5, dTP5_R6, dTP6_R5, dTP6_R6, dTP7_R5, dTP7_R6, dTP8_R5, dTP8_R6, dTP9_R5, dTP9_R6, dTP10_R5, dTP10_R6, dTP11_R5, dTP11_R6, dTP12_R5, dTP12_R6, dTP13_R5, dTP13_R6, dTP14_R5, dTP14_R6, dTP15_R5, dTP15_R6, dTP16_R5, dTP16_R6, dTP17_R5, dTP17_R6, dTP18_R5, dTP18_R6, dTP19_R5, dTP19_R6, dTP20_R5, dTP20_R6, dTP21_R5, dTP21_R6, dTP22_R5, dTP22_R6, dTP23_R5, dTP23_R6, dTP24_R5, dTP24_R6, dTP25_R5, dTP25_R6, dTP26_R5, dTP26_R6, dTP27_R5, dTP27_R6, dTP28_R5, dTP28_R6, dTP29_R5, dTP29_R6, dTP30_R5, dTP30_R6, dTP31_R5, dTP31_R6, dTP32_R5, dTP32_R6, dTP33_R5, dTP33_R6, dTP34_R5, dTP34_R6, dTP35_R5, dTP35_R6, dTP36_R5, dTP36_R6, dTP37_R5, dTP37_R6, dTP38_R5, dTP38_R6, dTP39_R5, dTP39_R6, dTP40_R5, dTP40_R6 | 80 | 4000
ERJ-2RKF4700X Panasonic | Mouser Česká Republika (https://cz.mouser.com/ProductDetail/Panasonic/ERJ-2RKF4700X) | 470R 1% |  | dTP1_R7, dTP1_R8, dTP2_R7, dTP2_R8, dTP3_R7, dTP3_R8, dTP4_R7, dTP4_R8, dTP5_R7, dTP5_R8, dTP6_R7, dTP6_R8, dTP7_R7, dTP7_R8, dTP8_R7, dTP8_R8, dTP9_R7, dTP9_R8, dTP10_R7, dTP10_R8, dTP11_R7, dTP11_R8, dTP12_R7, dTP12_R8, dTP13_R7, dTP13_R8, dTP14_R7, dTP14_R8, dTP15_R7, dTP15_R8, dTP16_R7, dTP16_R8, dTP17_R7, dTP17_R8, dTP18_R7, dTP18_R8, dTP19_R7, dTP19_R8, dTP20_R7, dTP20_R8, dTP21_R7, dTP21_R8, dTP22_R7, dTP22_R8, dTP23_R7, dTP23_R8, dTP24_R7, dTP24_R8, dTP25_R7, dTP25_R8, dTP26_R7, dTP26_R8, dTP27_R7, dTP27_R8, dTP28_R7, dTP28_R8, dTP29_R7, dTP29_R8, dTP30_R7, dTP30_R8, dTP31_R7, dTP31_R8, dTP32_R7, dTP32_R8, dTP33_R7, dTP33_R8, dTP34_R7, dTP34_R8, dTP35_R7, dTP35_R8, dTP36_R7, dTP36_R8, dTP37_R7, dTP37_R8, dTP38_R7, dTP38_R8, dTP39_R7, dTP39_R8, dTP40_R7, dTP40_R8 | 80 | 4000
TLV76701DGNR Texas Instruments | Mouser Česká Republika (https://cz.mouser.com/ProductDetail/Texas-Instruments/TLV76701DGNR?qs=QNEnbhJQKvYlzprjZl22mQ%3D%3D) | TLV76701DGNR_LDO | Integrated Circuit | IC2, IC4 | 2 | 100
09033966921 HARTING | Mouser Česká Republika (https://cz.mouser.com/ProductDetail/HARTING/09033966921?qs=gIpPgrDBK%2FiSDuMebe5eaQ%3D%3D) | HARTING 96 PIN 3 rows | Connector | J1 | 1 | 50 | Osazený konektor ze skladu ne z linku!!
87833-5019 Molex | Mouser Česká Republika (https://cz.mouser.com/ProductDetail/Molex/87833-5019?qs=Vr3ZXvgdfhbSPmsYnBrhlw%3D%3D) | 87833-5019 | Connector | J22 | 1 | 50
5-146280-2 TE Connectivity | Mouser Česká Republika (https://cz.mouser.com/ProductDetail/TE-Connectivity/5-146280-2?qs=bwpFY26eRVcxHP%252BQexhLNQ%3D%3D) | 5-146280-2 | Male Header, Pitch 2.54 mm, 1 x 2 Position, Height 8.21 mm, Tail Length 3.05 mm, -65 to 105 degC, RoHS, Bulk | P1, P2 | 2 | 100 | Tohle je 2x1 (2.54mm) header -> koupit/osadit až u nás?
CRCW040250K0FKED Vishay / Dale | Mouser Česká Republika (https://cz.mouser.com/ProductDetail/Vishay-Dale/CRCW040250K0FKED?qs=ZTJSYgkXUA0CX%252BZe0ESa5A%3D%3D) | 50k |  | R1, R2, R10, R16 | 4 | 200 | 50kOhm rezistor nebo podobná hodnota. Musí se koupit
ERJ-2GEJ224X Panasonic | Mouser Česká Republika (https://cz.mouser.com/ProductDetail/Panasonic/ERJ-2GEJ224X?qs=H7k1u0Mp9JQ0o1uy9bJkFg%3D%3D) | 220k |  | R9 | 1 | 50
RT0603FRE071KL YAGEO | Mouser Česká Republika (https://cz.mouser.com/ProductDetail/YAGEO/RT0603FRE071KL?qs=8cPjvKtxWv68ZVEzoi6JxQ%3D%3D) | 1k | Resistor | R11, R17 | 2 | 100
ERJ-S02F1203X Panasonic | Mouser Česká Republika (https://cz.mouser.com/ProductDetail/Panasonic/ERJ-S02F1203X?qs=Zyl8A9hlmJoQeBgjsVTVMg%3D%3D) | 120k |  | R15 | 1 | 50
TC33X-2-503E Bourns | Mouser Česká Republika (https://cz.mouser.com/ProductDetail/Bourns/TC33X-2-503E) | 50k_TRIMMER_TC33X-2-503E | Variable Resistor | VR1, VR3 | 2 | 100

Sheet: PICKPLACE - Souhrn
Designator | Comment | Layer | Footprint | Center-X(mm) | Center-Y(mm) | Rotation | Description
8pins1_C20 | 100nF | BottomLayer | 0402_CAP | 9.3396 | 22.5794 | 0 | Cap Ceramic 0.1uF 25V X7R 10% Pad SMD 0402 125C T/R
8pins1_C19 | 100nF | TopLayer | 0402_CAP | 12.4000 | 14.5949 | 270 | Cap Ceramic 0.1uF 25V X7R 10% Pad SMD 0402 125C T/R
8pins1_C18 | 100nF | TopLayer | 0402_CAP | 18.5000 | 15.0949 | 0 | Cap Ceramic 0.1uF 25V X7R 10% Pad SMD 0402 125C T/R
8pins10_C20 | 100nF | BottomLayer | 0402_CAP | 199.5049 | 22.5596 | 0 | Cap Ceramic 0.1uF 25V X7R 10% Pad SMD 0402 125C T/R
8pins10_C19 | 100nF | TopLayer | 0402_CAP | 202.0804 | 14.5740 | 270 | Cap Ceramic 0.1uF 25V X7R 10% Pad SMD 0402 125C T/R
8pins10_C18 | 100nF | TopLayer | 0402_CAP | 208.6297 | 14.9396 | 0 | Cap Ceramic 0.1uF 25V X7R 10% Pad SMD 0402 125C T/R
8pins9_C20 | 100nF | BottomLayer | 0402_CAP | 178.3759 | 22.5596 | 0 | Cap Ceramic 0.1uF 25V X7R 10% Pad SMD 0402 125C T/R
8pins9_C19 | 100nF | TopLayer | 0402_CAP | 180.9603 | 14.5650 | 270 | Cap Ceramic 0.1uF 25V X7R 10% Pad SMD 0402 125C T/R
8pins9_C18 | 100nF | TopLayer | 0402_CAP | 187.4984 | 14.9419 | 0 | Cap Ceramic 0.1uF 25V X7R 10% Pad SMD 0402 125C T/R
8pins8_C20 | 100nF | BottomLayer | 0402_CAP | 157.2470 | 22.5596 | 0 | Cap Ceramic 0.1uF 25V X7R 10% Pad SMD 0402 125C T/R
8pins8_C19 | 100nF | TopLayer | 0402_CAP | 159.8000 | 14.7949 | 270 | Cap Ceramic 0.1uF 25V X7R 10% Pad SMD 0402 125C T/R
8pins8_C18 | 100nF | TopLayer | 0402_CAP | 166.4000 | 14.8949 | 0 | Cap Ceramic 0.1uF 25V X7R 10% Pad SMD 0402 125C T/R
8pins7_C20 | 100nF | BottomLayer | 0402_CAP | 136.1180 | 22.5596 | 0 | Cap Ceramic 0.1uF 25V X7R 10% Pad SMD 0402 125C T/R
8pins7_C19 | 100nF | TopLayer | 0402_CAP | 138.7024 | 14.5650 | 270 | Cap Ceramic 0.1uF 25V X7R 10% Pad SMD 0402 125C T/R
8pins7_C18 | 100nF | TopLayer | 0402_CAP | 145.2405 | 14.9419 | 0 | Cap Ceramic 0.1uF 25V X7R 10% Pad SMD 0402 125C T/R
8pins6_C20 | 100nF | BottomLayer | 0402_CAP | 114.9890 | 22.5596 | 0 | Cap Ceramic 0.1uF 25V X7R 10% Pad SMD 0402 125C T/R
8pins6_C19 | 100nF | TopLayer | 0402_CAP | 118.1000 | 14.4949 | 270 | Cap Ceramic 0.1uF 25V X7R 10% Pad SMD 0402 125C T/R
8pins6_C18 | 100nF | TopLayer | 0402_CAP | 124.1138 | 14.9396 | 0 | Cap Ceramic 0.1uF 25V X7R 10% Pad SMD 0402 125C T/R
8pins5_C20 | 100nF | BottomLayer | 0402_CAP | 93.8600 | 22.5596 | 0 | Cap Ceramic 0.1uF 25V X7R 10% Pad SMD 0402 125C T/R
8pins5_C19 | 100nF | TopLayer | 0402_CAP | 96.6000 | 14.4949 | 270 | Cap Ceramic 0.1uF 25V X7R 10% Pad SMD 0402 125C T/R
8pins5_C18 | 100nF | TopLayer | 0402_CAP | 102.9848 | 14.9396 | 0 | Cap Ceramic 0.1uF 25V X7R 10% Pad SMD 0402 125C T/R
8pins4_C20 | 100nF | BottomLayer | 0402_CAP | 72.7311 | 22.5596 | 0 | Cap Ceramic 0.1uF 25V X7R 10% Pad SMD 0402 125C T/R
8pins4_C19 | 100nF | TopLayer | 0402_CAP | 75.3155 | 14.5650 | 270 | Cap Ceramic 0.1uF 25V X7R 10% Pad SMD 0402 125C T/R
8pins4_C18 | 100nF | TopLayer | 0402_CAP | 81.8559 | 14.9396 | 0 | Cap Ceramic 0.1uF 25V X7R 10% Pad SMD 0402 125C T/R
8pins3_C20 | 100nF | BottomLayer | 0402_CAP | 51.6021 | 22.5596 | 0 | Cap Ceramic 0.1uF 25V X7R 10% Pad SMD 0402 125C T/R
8pins3_C19 | 100nF | TopLayer | 0402_CAP | 54.5000 | 14.2949 | 270 | Cap Ceramic 0.1uF 25V X7R 10% Pad SMD 0402 125C T/R
8pins3_C18 | 100nF | TopLayer | 0402_CAP | 60.7269 | 14.9396 | 0 | Cap Ceramic 0.1uF 25V X7R 10% Pad SMD 0402 125C T/R
8pins2_C20 | 100nF | BottomLayer | 0402_CAP | 30.4731 | 22.5596 | 0 | Cap Ceramic 0.1uF 25V X7R 10% Pad SMD 0402 125C T/R
8pins2_C19 | 100nF | TopLayer | 0402_CAP | 33.3000 | 14.4949 | 270 | Cap Ceramic 0.1uF 25V X7R 10% Pad SMD 0402 125C T/R
8pins2_C18 | 100nF | TopLayer | 0402_CAP | 39.5979 | 14.9396 | 0 | Cap Ceramic 0.1uF 25V X7R 10% Pad SMD 0402 125C T/R
D3 | LED | TopLayer | 0603_RED_LED | 201.7183 | 54.8206 | 270 | LED RED DIFFUSED 1608 SMD
D1 | LED | TopLayer | 0603_RED_LED | 208.7220 | 12.2389 | 180 | LED RED DIFFUSED 1608 SMD
R17 | 1k | TopLayer | 0603-_SMD_RESISTOR | 201.7340 | 58.6602 | 270 | Resistor
R11 | 1k | TopLayer | 0603-_SMD_RESISTOR | 212.2780 | 12.2389 | 180 | Resistor
C27 | 10uF | TopLayer | 0603_TANTAL | 207.8183 | 51.8956 | 180 | CAP TANT POLY 10UF 10V SMD
C21 | 10uF | TopLayer | 0603_TANTAL | 205.9280 | 6.1429 | 90 | CAP TANT POLY 10UF 10V SMD
C28 | 1uF 25V | TopLayer | 0603-CAP | 206.9683 | 57.8956 | 270 | General Purpose Ceramic Capacitor
C22 | 1uF 25V | TopLayer | 0603-CAP | 212.0240 | 7.1589 | 180 | General Purpose Ceramic Capacitor
J1 | HARTING 96 PIN 3 rows | TopLayer | 09033966921 | 107.5000 | 56.1749 | 180 | Connector
P2 | 5-146280-2 | TopLayer | 2.54MM_HEADER_3X1 | 197.6410 | 57.6656 | 90 | Male Header
P1 | 5-146280-2 | TopLayer | 2.54MM_HEADER_3X1 | 203.0364 | 4.6189 | 90 | Male Header
D13 | SSA34HE3_A_I | TopLayer | DIONM5127X229N | 204.4683 | 56.3956 | 270 | Schottky Diode
D11 | SSA34HE3_A_I | TopLayer | DIONM5127X229N | 210.5000 | 9.4449 | 180 | Schottky Diode
8pins1_U3 | TMUX1308QDYYRQ1 | BottomLayer | FP-DYY0016A-MFG | 12.5844 | 19.9378 | 180 | AUTOMOTIVE
8pins10_U3 | TMUX1308QDYYRQ1 | BottomLayer | FP-DYY0016A-MFG | 202.7497 | 19.9180 | 180 | AUTOMOTIVE
8pins9_U3 | TMUX1308QDYYRQ1 | BottomLayer | FP-DYY0016A-MFG | 181.6207 | 19.9180 | 180 | AUTOMOTIVE
8pins8_U3 | TMUX1308QDYYRQ1 | BottomLayer | FP-DYY0016A-MFG | 160.4918 | 19.9180 | 180 | AUTOMOTIVE
8pins7_U3 | TMUX1308QDYYRQ1 | BottomLayer | FP-DYY0016A-MFG | 139.3628 | 19.9180 | 180 | AUTOMOTIVE
8pins6_U3 | TMUX1308QDYYRQ1 | BottomLayer | FP-DYY0016A-MFG | 118.2338 | 19.9180 | 180 | AUTOMOTIVE
8pins5_U3 | TMUX1308QDYYRQ1 | BottomLayer | FP-DYY0016A-MFG | 97.1048 | 19.9180 | 180 | AUTOMOTIVE
8pins4_U3 | TMUX1308QDYYRQ1 | BottomLayer | FP-DYY0016A-MFG | 75.9759 | 19.9180 | 180 | AUTOMOTIVE
8pins3_U3 | TMUX1308QDYYRQ1 | BottomLayer | FP-DYY0016A-MFG | 54.8469 | 19.9180 | 180 | AUTOMOTIVE
8pins2_U3 | TMUX1308QDYYRQ1 | BottomLayer | FP-DYY0016A-MFG | 33.7179 | 19.9180 | 180 | AUTOMOTIVE
R2 | 50k | TopLayer | RESC1005X40X25NL05T05 | 199.7470 | 55.1754 | 270
R1 | 50k | TopLayer | RESC1005X40X25NL05T05 | 206.3383 | 1.2012 | 180
dTP2_R8 | 470R 1% | TopLayer | RESC1005X40X25NL05T05 | 11.1091 | 34.7159 | 0
dTP2_R7 | 470R 1% | TopLayer | RESC1005X40X25NL05T05 | 8.9091 | 34.7159 | 180
dTP2_R6 | 2k2 | BottomLayer | RESC1005X40X25NL05T05 | 10.3575 | 27.3900 | 0
dTP2_R5 | 2k2 | BottomLayer | RESC1005X40X25NL05T05 | 8.1591 | 27.3659 | 180
R16 | 50k | TopLayer | RESC1005X40X25NL05T05 | 211.0143 | 51.8196 | 0
R15 | 120k | TopLayer | RESC1005X40X25NL05T05 | 206.9683 | 54.6456 | 90
R10 | 50k | TopLayer | RESC1005X40X25NL05T05 | 205.9280 | 3.3489 | 270
R9 | 220k | TopLayer | RESC1005X40X25NL05T05 | 208.4680 | 7.1589 | 0
dTP1_R5 | 2k2 | BottomLayer | RESC1005X40X25NL05T05 | 2.7836 | 35.3872 | 180
dTP1_R6 | 2k2 | BottomLayer | RESC1005X40X25NL05T05 | 5.0337 | 35.3872 | 0
dTP1_R7 | 470R 1% | TopLayer | RESC1005X40X25NL05T05 | 3.5337 | 42.7372 | 180
dTP1_R8 | 470R 1% | TopLayer | RESC1005X40X25NL05T05 | 5.7337 | 42.7372 | 0
dTP40_R8 | 470R 1% | TopLayer | RESC1005X40X25NL05T05 | 211.6433 | 34.6905 | 0
dTP40_R7 | 470R 1% | TopLayer | RESC1005X40X25NL05T05 | 209.4433 | 34.6905 | 180
dTP40_R6 | 2k2 | BottomLayer | RESC1005X40X25NL05T05 | 210.9433 | 27.3405 | 0
dTP40_R5 | 2k2 | BottomLayer | RESC1005X40X25NL05T05 | 208.6933 | 27.3405 | 180
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
dTP30_IC1 | LM393LVQDRQ1 | BottomLayer | SOIC127P600X175-8N | 157.9375 | 31.0405 | 0 | Integrated Circuit
dTP29_IC1 | LM393LVQDRQ1 | BottomLayer | SOIC127P600X175-8N | 152.7203 | 39.0533 | 0 | Integrated Circuit
dTP28_IC1 | LM393LVQDRQ1 | BottomLayer | SOIC127P600X175-8N | 147.3711 | 31.0405 | 0 | Integrated Circuit
dTP27_IC1 | LM393LVQDRQ1 | BottomLayer | SOIC127P600X175-8N | 142.1539 | 39.0533 | 0 | Integrated Circuit
dTP26_IC1 | LM393LVQDRQ1 | BottomLayer | SOIC127P600X175-8N | 136.8301 | 31.0405 | 0 | Integrated Circuit
dTP25_IC1 | LM393LVQDRQ1 | BottomLayer | SOIC127P600X175-8N | 131.5875 | 39.0533 | 0 | Integrated Circuit
dTP24_IC1 | LM393LVQDRQ1 | BottomLayer | SOIC127P600X175-8N | 126.2637 | 31.0405 | 0 | Integrated Circuit
dTP23_IC1 | LM393LVQDRQ1 | BottomLayer | SOIC127P600X175-8N | 121.0211 | 39.0533 | 0 | Integrated Circuit
dTP22_IC1 | LM393LVQDRQ1 | BottomLayer | SOIC127P600X175-8N | 115.7227 | 31.0405 | 0 | Integrated Circuit
dTP21_IC1 | LM393LVQDRQ1 | BottomLayer | SOIC127P600X175-8N | 110.4547 | 39.0533 | 0 | Integrated Circuit
dTP20_IC1 | LM393LVQDRQ1 | BottomLayer | SOIC127P600X175-8N | 105.1563 | 31.0405 | 0 | Integrated Circuit
dTP19_IC1 | LM393LVQDRQ1 | BottomLayer | SOIC127P600X175-8N | 99.8883 | 39.0533 | 0 | Integrated Circuit
dTP18_IC1 | LM393LVQDRQ1 | BottomLayer | SOIC127P600X175-8N | 94.6153 | 31.0405 | 0 | Integrated Circuit
dTP17_IC1 | LM393LVQDRQ1 | BottomLayer | SOIC127P600X175-8N | 89.3219 | 39.0533 | 0 | Integrated Circuit
dTP16_IC1 | LM393LVQDRQ1 | BottomLayer | SOIC127P600X175-8N | 84.0743 | 31.0405 | 0 | Integrated Circuit
dTP15_IC1 | LM393LVQDRQ1 | BottomLayer | SOIC127P600X175-8N | 78.7555 | 39.0533 | 0 | Integrated Circuit
dTP14_IC1 | LM393LVQDRQ1 | BottomLayer | SOIC127P600X175-8N | 73.5079 | 31.0405 | 0 | Integrated Circuit
dTP13_IC1 | LM393LVQDRQ1 | BottomLayer | SOIC127P600X175-8N | 68.1891 | 39.0533 | 0 | Integrated Circuit
dTP12_IC1 | LM393LVQDRQ1 | BottomLayer | SOIC127P600X175-8N | 62.9669 | 31.0405 | 0 | Integrated Circuit
dTP11_IC1 | LM393LVQDRQ1 | BottomLayer | SOIC127P600X175-8N | 57.6227 | 39.0533 | 0 | Integrated Circuit
dTP10_IC1 | LM393LVQDRQ1 | BottomLayer | SOIC127P600X175-8N | 52.4005 | 31.0405 | 0 | Integrated Circuit
dTP9_IC1 | LM393LVQDRQ1 | BottomLayer | SOIC127P600X175-8N | 47.0563 | 39.0533 | 0 | Integrated Circuit
dTP8_IC1 | LM393LVQDRQ1 | BottomLayer | SOIC127P600X175-8N | 41.8595 | 31.0405 | 0 | Integrated Circuit
dTP7_IC1 | LM393LVQDRQ1 | BottomLayer | SOIC127P600X175-8N | 36.4899 | 39.0533 | 0 | Integrated Circuit
dTP6_IC1 | LM393LVQDRQ1 | BottomLayer | SOIC127P600X175-8N | 31.3185 | 31.0405 | 0 | Integrated Circuit
dTP5_IC1 | LM393LVQDRQ1 | BottomLayer | SOIC127P600X175-8N | 25.8909 | 39.0593 | 0 | Integrated Circuit
dTP4_IC1 | LM393LVQDRQ1 | BottomLayer | SOIC127P600X175-8N | 20.7255 | 31.0659 | 0 | Integrated Circuit
dTP3_IC1 | LM393LVQDRQ1 | BottomLayer | SOIC127P600X175-8N | 15.3317 | 39.0787 | 0 | Integrated Circuit
IC4 | TLV76701DGNR_LDO | TopLayer | SOP65P490X110-9N | 209.7183 | 56.3956 | 90 | Integrated Circuit
IC2 | TLV76701DGNR_LDO | TopLayer | SOP65P490X110-9N | 210.2460 | 4.3649 | 0 | Integrated Circuit
dTP2_Q4 | NMOS | TopLayer | SOT95P240X110-3N | 12.1591 | 32.3659 | 180 | N-Channel MOSFET Transistor PJA3432_R1_00001
dTP2_Q3 | NMOS | TopLayer | SOT95P240X110-3N | 7.9091 | 32.3659 | 0 | N-Channel MOSFET Transistor PJA3432_R1_00001
dTP1_Q3 | NMOS | TopLayer | SOT95P240X110-3N | 2.5336 | 40.3872 | 0 | N-Channel MOSFET Transistor PJA3432_R1_00001
dTP1_Q4 | NMOS | TopLayer | SOT95P240X110-3N | 6.7837 | 40.3872 | 180 | N-Channel MOSFET Transistor PJA3432_R1_00001
dTP40_Q4 | NMOS | TopLayer | SOT95P240X110-3N | 212.6933 | 32.3405 | 180 | N-Channel MOSFET Transistor PJA3432_R1_00001
dTP40_Q3 | NMOS | TopLayer | SOT95P240X110-3N | 208.4433 | 32.3405 | 0 | N-Channel MOSFET Transistor PJA3432_R1_00001
dTP39_Q4 | NMOS | TopLayer | SOT95P240X110-3N | 207.5523 | 40.3533 | 180 | N-Channel MOSFET Transistor PJA3432_R1_00001
dTP39_Q3 | NMOS | TopLayer | SOT95P240X110-3N | 203.3023 | 40.3533 | 0 | N-Channel MOSFET Transistor PJA3432_R1_00001
dTP38_Q4 | NMOS | TopLayer | SOT95P240X110-3N | 202.1269 | 32.3405 | 180 | N-Channel MOSFET Transistor PJA3432_R1_00001
dTP38_Q3 | NMOS | TopLayer | SOT95P240X110-3N | 197.8769 | 32.3405 | 0 | N-Channel MOSFET Transistor PJA3432_R1_00001
dTP37_Q4 | NMOS | TopLayer | SOT95P240X110-3N | 196.9859 | 40.3533 | 180 | N-Channel MOSFET Transistor PJA3432_R1_00001
dTP37_Q3 | NMOS | TopLayer | SOT95P240X110-3N | 192.7359 | 40.3533 | 0 | N-Channel MOSFET Transistor PJA3432_R1_00001
dTP36_Q4 | NMOS | TopLayer | SOT95P240X110-3N | 191.5859 | 32.3405 | 180 | N-Channel MOSFET Transistor PJA3432_R1_00001
dTP36_Q3 | NMOS | TopLayer | SOT95P240X110-3N | 187.3359 | 32.3405 | 0 | N-Channel MOSFET Transistor PJA3432_R1_00001
dTP35_Q4 | NMOS | TopLayer | SOT95P240X110-3N | 186.4195 | 40.3533 | 180 | N-Channel MOSFET Transistor PJA3432_R1_00001
dTP35_Q3 | NMOS | TopLayer | SOT95P240X110-3N | 182.1695 | 40.3533 | 0 | N-Channel MOSFET Transistor PJA3432_R1_00001
dTP34_Q4 | NMOS | TopLayer | SOT95P240X110-3N | 181.0195 | 32.3405 | 180 | N-Channel MOSFET Transistor PJA3432_R1_00001
dTP34_Q3 | NMOS | TopLayer | SOT95P240X110-3N | 176.7695 | 32.3405 | 0 | N-Channel MOSFET Transistor PJA3432_R1_00001
dTP33_Q4 | NMOS | TopLayer | SOT95P240X110-3N | 175.8531 | 40.3533 | 180 | N-Channel MOSFET Transistor PJA3432_R1_00001
dTP33_Q3 | NMOS | TopLayer | SOT95P240X110-3N | 171.6031 | 40.3533 | 0 | N-Channel MOSFET Transistor PJA3432_R1_00001
dTP32_Q4 | NMOS | TopLayer | SOT95P240X110-3N | 170.4785 | 32.3405 | 180 | N-Channel MOSFET Transistor PJA3432_R1_00001
dTP32_Q3 | NMOS | TopLayer | SOT95P240X110-3N | 166.2285 | 32.3405 | 0 | N-Channel MOSFET Transistor PJA3432_R1_00001
dTP31_Q4 | NMOS | TopLayer | SOT95P240X110-3N | 165.2867 | 40.3533 | 180 | N-Channel MOSFET Transistor PJA3432_R1_00001
dTP31_Q3 | NMOS | TopLayer | SOT95P240X110-3N | 161.0367 | 40.3533 | 0 | N-Channel MOSFET Transistor PJA3432_R1_00001
dTP30_Q4 | NMOS | TopLayer | SOT95P240X110-3N | 159.9375 | 32.3405 | 180 | N-Channel MOSFET Transistor PJA3432_R1_00001
dTP30_Q3 | NMOS | TopLayer | SOT95P240X110-3N | 155.6875 | 32.3405 | 0 | N-Channel MOSFET Transistor PJA3432_R1_00001
dTP29_Q4 | NMOS | TopLayer | SOT95P240X110-3N | 154.7203 | 40.3533 | 180 | N-Channel MOSFET Transistor PJA3432_R1_00001
dTP29_Q3 | NMOS | TopLayer | SOT95P240X110-3N | 150.4703 | 40.3533 | 0 | N-Channel MOSFET Transistor PJA3432_R1_00001
dTP28_Q4 | NMOS | TopLayer | SOT95P240X110-3N | 149.3711 | 32.3405 | 180 | N-Channel MOSFET Transistor PJA3432_R1_00001
dTP28_Q3 | NMOS | TopLayer | SOT95P240X110-3N | 145.1211 | 32.3405 | 0 | N-Channel MOSFET Transistor PJA3432_R1_00001
dTP27_Q4 | NMOS | TopLayer | SOT95P240X110-3N | 144.1539 | 40.3533 | 180 | N-Channel MOSFET Transistor PJA3432_R1_00001
dTP27_Q3 | NMOS | TopLayer | SOT95P240X110-3N | 139.9039 | 40.3533 | 0 | N-Channel MOSFET Transistor PJA3432_R1_00001
dTP26_Q4 | NMOS | TopLayer | SOT95P240X110-3N | 138.8301 | 32.3405 | 180 | N-Channel MOSFET Transistor PJA3432_R1_00001
dTP26_Q3 | NMOS | TopLayer | SOT95P240X110-3N | 134.5801 | 32.3405 | 0 | N-Channel MOSFET Transistor PJA3432_R1_00001
dTP25_Q4 | NMOS | TopLayer | SOT95P240X110-3N | 133.5875 | 40.3533 | 180 | N-Channel MOSFET Transistor PJA3432_R1_00001
dTP25_Q3 | NMOS | TopLayer | SOT95P240X110-3N | 129.3375 | 40.3533 | 0 | N-Channel MOSFET Transistor PJA3432_R1_00001
dTP24_Q4 | NMOS | TopLayer | SOT95P240X110-3N | 128.2637 | 32.3405 | 180 | N-Channel MOSFET Transistor PJA3432_R1_00001
dTP24_Q3 | NMOS | TopLayer | SOT95P240X110-3N | 124.0137 | 32.3405 | 0 | N-Channel MOSFET Transistor PJA3432_R1_00001
dTP23_Q4 | NMOS | TopLayer | SOT95P240X110-3N | 123.0211 | 40.3533 | 180 | N-Channel MOSFET Transistor PJA3432_R1_00001
dTP23_Q3 | NMOS | TopLayer | SOT95P240X110-3N | 118.7711 | 40.3533 | 0 | N-Channel MOSFET Transistor PJA3432_R1_00001
dTP22_Q4 | NMOS | TopLayer | SOT95P240X110-3N | 117.7227 | 32.3405 | 180 | N-Channel MOSFET Transistor PJA3432_R1_00001
dTP22_Q3 | NMOS | TopLayer | SOT95P240X110-3N | 113.4727 | 32.3405 | 0 | N-Channel MOSFET Transistor PJA3432_R1_00001
dTP21_Q4 | NMOS | TopLayer | SOT95P240X110-3N | 112.4547 | 40.3533 | 180 | N-Channel MOSFET Transistor PJA3432_R1_00001
dTP21_Q3 | NMOS | TopLayer | SOT95P240X110-3N | 108.2047 | 40.3533 | 0 | N-Channel MOSFET Transistor PJA3432_R1_00001
dTP20_Q4 | NMOS | TopLayer | SOT95P240X110-3N | 107.1563 | 32.3405 | 180 | N-Channel MOSFET Transistor PJA3432_R1_00001
dTP20_Q3 | NMOS | TopLayer | SOT95P240X110-3N | 102.9063 | 32.3405 | 0 | N-Channel MOSFET Transistor PJA3432_R1_00001
dTP19_Q4 | NMOS | TopLayer | SOT95P240X110-3N | 101.8883 | 40.3533 | 180 | N-Channel MOSFET Transistor PJA3432_R1_00001
dTP19_Q3 | NMOS | TopLayer | SOT95P240X110-3N | 97.6383 | 40.3533 | 0 | N-Channel MOSFET Transistor PJA3432_R1_00001
dTP18_Q4 | NMOS | TopLayer | SOT95P240X110-3N | 96.6153 | 32.3405 | 180 | N-Channel MOSFET Transistor PJA3432_R1_00001
dTP18_Q3 | NMOS | TopLayer | SOT95P240X110-3N | 92.3653 | 32.3405 | 0 | N-Channel MOSFET Transistor PJA3432_R1_00001
dTP17_Q4 | NMOS | TopLayer | SOT95P240X110-3N | 91.3219 | 40.3533 | 180 | N-Channel MOSFET Transistor PJA3432_R1_00001
dTP17_Q3 | NMOS | TopLayer | SOT95P240X110-3N | 87.0719 | 40.3533 | 0 | N-Channel MOSFET Transistor PJA3432_R1_00001
dTP16_Q4 | NMOS | TopLayer | SOT95P240X110-3N | 86.0743 | 32.3405 | 180 | N-Channel MOSFET Transistor PJA3432_R1_00001
dTP16_Q3 | NMOS | TopLayer | SOT95P240X110-3N | 81.8243 | 32.3405 | 0 | N-Channel MOSFET Transistor PJA3432_R1_00001
dTP15_Q4 | NMOS | TopLayer | SOT95P240X110-3N | 80.7555 | 40.3533 | 180 | N-Channel MOSFET Transistor PJA3432_R1_00001
dTP15_Q3 | NMOS | TopLayer | SOT95P240X110-3N | 76.5055 | 40.3533 | 0 | N-Channel MOSFET Transistor PJA3432_R1_00001
dTP14_Q4 | NMOS | TopLayer | SOT95P240X110-3N | 75.5079 | 32.3405 | 180 | N-Channel MOSFET Transistor PJA3432_R1_00001
dTP14_Q3 | NMOS | TopLayer | SOT95P240X110-3N | 71.2579 | 32.3405 | 0 | N-Channel MOSFET Transistor PJA3432_R1_00001
dTP13_Q4 | NMOS | TopLayer | SOT95P240X110-3N | 70.1891 | 40.3533 | 180 | N-Channel MOSFET Transistor PJA3432_R1_00001
dTP13_Q3 | NMOS | TopLayer | SOT95P240X110-3N | 65.9391 | 40.3533 | 0 | N-Channel MOSFET Transistor PJA3432_R1_00001
dTP12_Q4 | NMOS | TopLayer | SOT95P240X110-3N | 64.9669 | 32.3405 | 180 | N-Channel MOSFET Transistor PJA3432_R1_00001
dTP12_Q3 | NMOS | TopLayer | SOT95P240X110-3N | 60.7169 | 32.3405 | 0 | N-Channel MOSFET Transistor PJA3432_R1_00001
dTP11_Q4 | NMOS | TopLayer | SOT95P240X110-3N | 59.6227 | 40.3533 | 180 | N-Channel MOSFET Transistor PJA3432_R1_00001
dTP11_Q3 | NMOS | TopLayer | SOT95P240X110-3N | 55.3727 | 40.3533 | 0 | N-Channel MOSFET Transistor PJA3432_R1_00001
dTP10_Q4 | NMOS | TopLayer | SOT95P240X110-3N | 54.4005 | 32.3405 | 180 | N-Channel MOSFET Transistor PJA3432_R1_00001
dTP10_Q3 | NMOS | TopLayer | SOT95P240X110-3N | 50.1505 | 32.3405 | 0 | N-Channel MOSFET Transistor PJA3432_R1_00001
dTP9_Q4 | NMOS | TopLayer | SOT95P240X110-3N | 49.0563 | 40.3533 | 180 | N-Channel MOSFET Transistor PJA3432_R1_00001
dTP9_Q3 | NMOS | TopLayer | SOT95P240X110-3N | 44.8063 | 40.3533 | 0 | N-Channel MOSFET Transistor PJA3432_R1_00001
dTP8_Q4 | NMOS | TopLayer | SOT95P240X110-3N | 43.8595 | 32.3405 | 180 | N-Channel MOSFET Transistor PJA3432_R1_00001
dTP8_Q3 | NMOS | TopLayer | SOT95P240X110-3N | 39.6095 | 32.3405 | 0 | N-Channel MOSFET Transistor PJA3432_R1_00001
dTP7_Q4 | NMOS | TopLayer | SOT95P240X110-3N | 38.4899 | 40.3533 | 180 | N-Channel MOSFET Transistor PJA3432_R1_00001
dTP7_Q3 | NMOS | TopLayer | SOT95P240X110-3N | 34.2399 | 40.3533 | 0 | N-Channel MOSFET Transistor PJA3432_R1_00001
dTP6_Q4 | NMOS | TopLayer | SOT95P240X110-3N | 33.3185 | 32.3405 | 180 | N-Channel MOSFET Transistor PJA3432_R1_00001
dTP6_Q3 | NMOS | TopLayer | SOT95P240X110-3N | 29.0685 | 32.3405 | 0 | N-Channel MOSFET Transistor PJA3432_R1_00001
dTP5_Q4 | NMOS | TopLayer | SOT95P240X110-3N | 27.8909 | 40.3593 | 180 | N-Channel MOSFET Transistor PJA3432_R1_00001
dTP5_Q3 | NMOS | TopLayer | SOT95P240X110-3N | 23.6409 | 40.3593 | 0 | N-Channel MOSFET Transistor PJA3432_R1_00001
dTP4_Q4 | NMOS | TopLayer | SOT95P240X110-3N | 22.7255 | 32.3659 | 180 | N-Channel MOSFET Transistor PJA3432_R1_00001
dTP4_Q3 | NMOS | TopLayer | SOT95P240X110-3N | 18.4755 | 32.3659 | 0 | N-Channel MOSFET Transistor PJA3432_R1_00001
dTP3_Q4 | NMOS | TopLayer | SOT95P240X110-3N | 17.3317 | 40.3787 | 180 | N-Channel MOSFET Transistor PJA3432_R1_00001
dTP3_Q3 | NMOS | TopLayer | SOT95P240X110-3N | 13.0817 | 40.3787 | 0 | N-Channel MOSFET Transistor PJA3432_R1_00001
dTP2_Q2 | P-MOSFET | TopLayer | SOTFL95P240X88-3N | 8.2091 | 37.0159 | 0 | MOSFET (P-Channel) - low RDS on
dTP2_Q1 | P-MOSFET | TopLayer | SOTFL95P240X88-3N | 11.8091 | 37.0159 | 180 | MOSFET (P-Channel) - low RDS on
dTP1_Q1 | P-MOSFET | TopLayer | SOTFL95P240X88-3N | 6.4337 | 45.0372 | 180 | MOSFET (P-Channel) - low RDS on
dTP1_Q2 | P-MOSFET | TopLayer | SOTFL95P240X88-3N | 2.8337 | 45.0372 | 0 | MOSFET (P-Channel) - low RDS on
dTP40_Q2 | P-MOSFET | TopLayer | SOTFL95P240X88-3N | 208.7433 | 36.9905 | 0 | MOSFET (P-Channel) - low RDS on
dTP40_Q1 | P-MOSFET | TopLayer | SOTFL95P240X88-3N | 212.3433 | 36.9905 | 180 | MOSFET (P-Channel) - low RDS on
dTP39_Q2 | P-MOSFET | TopLayer | SOTFL95P240X88-3N | 203.6023 | 45.0033 | 0 | MOSFET (P-Channel) - low RDS on
dTP39_Q1 | P-MOSFET | TopLayer | SOTFL95P240X88-3N | 207.2023 | 45.0033 | 180 | MOSFET (P-Channel) - low RDS on
dTP38_Q2 | P-MOSFET | TopLayer | SOTFL95P240X88-3N | 198.1769 | 36.9905 | 0 | MOSFET (P-Channel) - low RDS on
dTP38_Q1 | P-MOSFET | TopLayer | SOTFL95P240X88-3N | 201.7769 | 36.9905 | 180 | MOSFET (P-Channel) - low RDS on
dTP37_Q2 | P-MOSFET | TopLayer | SOTFL95P240X88-3N | 193.0359 | 45.0033 | 0 | MOSFET (P-Channel) - low RDS on
dTP37_Q1 | P-MOSFET | TopLayer | SOTFL95P240X88-3N | 196.6359 | 45.0033 | 180 | MOSFET (P-Channel) - low RDS on
dTP36_Q2 | P-MOSFET | TopLayer | SOTFL95P240X88-3N | 187.6359 | 36.9905 | 0 | MOSFET (P-Channel) - low RDS on
dTP36_Q1 | P-MOSFET | TopLayer | SOTFL95P240X88-3N | 191.2359 | 36.9905 | 180 | MOSFET (P-Channel) - low RDS on
dTP35_Q2 | P-MOSFET | TopLayer | SOTFL95P240X88-3N | 182.4695 | 45.0033 | 0 | MOSFET (P-Channel) - low RDS on
dTP35_Q1 | P-MOSFET | TopLayer | SOTFL95P240X88-3N | 186.0695 | 45.0033 | 180 | MOSFET (P-Channel) - low RDS on
dTP34_Q2 | P-MOSFET | TopLayer | SOTFL95P240X88-3N | 177.0695 | 36.9905 | 0 | MOSFET (P-Channel) - low RDS on
dTP34_Q1 | P-MOSFET | TopLayer | SOTFL95P240X88-3N | 180.6695 | 36.9905 | 180 | MOSFET (P-Channel) - low RDS on
dTP33_Q2 | P-MOSFET | TopLayer | SOTFL95P240X88-3N | 171.9031 | 45.0033 | 0 | MOSFET (P-Channel) - low RDS on
dTP33_Q1 | P-MOSFET | TopLayer | SOTFL95P240X88-3N | 175.5031 | 45.0033 | 180 | MOSFET (P-Channel) - low RDS on
dTP32_Q2 | P-MOSFET | TopLayer | SOTFL95P240X88-3N | 166.5285 | 36.9905 | 0 | MOSFET (P-Channel) - low RDS on
dTP32_Q1 | P-MOSFET | TopLayer | SOTFL95P240X88-3N | 170.1285 | 36.9905 | 180 | MOSFET (P-Channel) - low RDS on
dTP31_Q2 | P-MOSFET | TopLayer | SOTFL95P240X88-3N | 161.3367 | 45.0033 | 0 | MOSFET (P-Channel) - low RDS on
dTP31_Q1 | P-MOSFET | TopLayer | SOTFL95P240X88-3N | 164.9367 | 45.0033 | 180 | MOSFET (P-Channel) - low RDS on
dTP30_Q2 | P-MOSFET | TopLayer | SOTFL95P240X88-3N | 155.9875 | 36.9905 | 0 | MOSFET (P-Channel) - low RDS on
dTP30_Q1 | P-MOSFET | TopLayer | SOTFL95P240X88-3N | 159.5875 | 36.9905 | 180 | MOSFET (P-Channel) - low RDS on
dTP29_Q2 | P-MOSFET | TopLayer | SOTFL95P240X88-3N | 150.7703 | 45.0033 | 0 | MOSFET (P-Channel) - low RDS on
dTP29_Q1 | P-MOSFET | TopLayer | SOTFL95P240X88-3N | 154.3703 | 45.0033 | 180 | MOSFET (P-Channel) - low RDS on
dTP28_Q2 | P-MOSFET | TopLayer | SOTFL95P240X88-3N | 145.4211 | 36.9905 | 0 | MOSFET (P-Channel) - low RDS on
dTP28_Q1 | P-MOSFET | TopLayer | SOTFL95P240X88-3N | 149.0211 | 36.9905 | 180 | MOSFET (P-Channel) - low RDS on
dTP27_Q2 | P-MOSFET | TopLayer | SOTFL95P240X88-3N | 140.2039 | 45.0033 | 0 | MOSFET (P-Channel) - low RDS on
dTP27_Q1 | P-MOSFET | TopLayer | SOTFL95P240X88-3N | 143.8039 | 45.0033 | 180 | MOSFET (P-Channel) - low RDS on
dTP26_Q2 | P-MOSFET | TopLayer | SOTFL95P240X88-3N | 134.8801 | 36.9905 | 0 | MOSFET (P-Channel) - low RDS on
dTP26_Q1 | P-MOSFET | TopLayer | SOTFL95P240X88-3N | 138.4801 | 36.9905 | 180 | MOSFET (P-Channel) - low RDS on
dTP25_Q2 | P-MOSFET | TopLayer | SOTFL95P240X88-3N | 129.6375 | 45.0033 | 0 | MOSFET (P-Channel) - low RDS on
dTP25_Q1 | P-MOSFET | TopLayer | SOTFL95P240X88-3N | 133.2375 | 45.0033 | 180 | MOSFET (P-Channel) - low RDS on
dTP24_Q2 | P-MOSFET | TopLayer | SOTFL95P240X88-3N | 124.3137 | 36.9905 | 0 | MOSFET (P-Channel) - low RDS on
dTP24_Q1 | P-MOSFET | TopLayer | SOTFL95P240X88-3N | 127.9137 | 36.9905 | 180 | MOSFET (P-Channel) - low RDS on
dTP23_Q2 | P-MOSFET | TopLayer | SOTFL95P240X88-3N | 119.0711 | 45.0033 | 0 | MOSFET (P-Channel) - low RDS on
dTP23_Q1 | P-MOSFET | TopLayer | SOTFL95P240X88-3N | 122.6711 | 45.0033 | 180 | MOSFET (P-Channel) - low RDS on
dTP22_Q2 | P-MOSFET | TopLayer | SOTFL95P240X88-3N | 113.7727 | 36.9905 | 0 | MOSFET (P-Channel) - low RDS on
dTP22_Q1 | P-MOSFET | TopLayer | SOTFL95P240X88-3N | 117.3727 | 36.9905 | 180 | MOSFET (P-Channel) - low RDS on
dTP21_Q2 | P-MOSFET | TopLayer | SOTFL95P240X88-3N | 108.5047 | 45.0033 | 0 | MOSFET (P-Channel) - low RDS on
dTP21_Q1 | P-MOSFET | TopLayer | SOTFL95P240X88-3N | 112.1047 | 45.0033 | 180 | MOSFET (P-Channel) - low RDS on
dTP20_Q2 | P-MOSFET | TopLayer | SOTFL95P240X88-3N | 103.2063 | 36.9905 | 0 | MOSFET (P-Channel) - low RDS on
dTP20_Q1 | P-MOSFET | TopLayer | SOTFL95P240X88-3N | 106.8063 | 36.9905 | 180 | MOSFET (P-Channel) - low RDS on
dTP19_Q2 | P-MOSFET | TopLayer | SOTFL95P240X88-3N | 97.9383 | 45.0033 | 0 | MOSFET (P-Channel) - low RDS on
dTP19_Q1 | P-MOSFET | TopLayer | SOTFL95P240X88-3N | 101.5383 | 45.0033 | 180 | MOSFET (P-Channel) - low RDS on
dTP18_Q2 | P-MOSFET | TopLayer | SOTFL95P240X88-3N | 92.6653 | 36.9905 | 0 | MOSFET (P-Channel) - low RDS on
dTP18_Q1 | P-MOSFET | TopLayer | SOTFL95P240X88-3N | 96.2653 | 36.9905 | 180 | MOSFET (P-Channel) - low RDS on
dTP17_Q2 | P-MOSFET | TopLayer | SOTFL95P240X88-3N | 87.3719 | 45.0033 | 0 | MOSFET (P-Channel) - low RDS on
dTP17_Q1 | P-MOSFET | TopLayer | SOTFL95P240X88-3N | 90.9719 | 45.0033 | 180 | MOSFET (P-Channel) - low RDS on
dTP16_Q2 | P-MOSFET | TopLayer | SOTFL95P240X88-3N | 82.1243 | 36.9905 | 0 | MOSFET (P-Channel) - low RDS on
dTP16_Q1 | P-MOSFET | TopLayer | SOTFL95P240X88-3N | 85.7243 | 36.9905 | 180 | MOSFET (P-Channel) - low RDS on
dTP15_Q2 | P-MOSFET | TopLayer | SOTFL95P240X88-3N | 76.8055 | 45.0033 | 0 | MOSFET (P-Channel) - low RDS on
dTP15_Q1 | P-MOSFET | TopLayer | SOTFL95P240X88-3N | 80.4055 | 45.0033 | 180 | MOSFET (P-Channel) - low RDS on
dTP14_Q2 | P-MOSFET | TopLayer | SOTFL95P240X88-3N | 71.5579 | 36.9905 | 0 | MOSFET (P-Channel) - low RDS on
dTP14_Q1 | P-MOSFET | TopLayer | SOTFL95P240X88-3N | 75.1579 | 36.9905 | 180 | MOSFET (P-Channel) - low RDS on
dTP13_Q2 | P-MOSFET | TopLayer | SOTFL95P240X88-3N | 66.2391 | 45.0033 | 0 | MOSFET (P-Channel) - low RDS on
dTP13_Q1 | P-MOSFET | TopLayer | SOTFL95P240X88-3N | 69.8391 | 45.0033 | 180 | MOSFET (P-Channel) - low RDS on
dTP12_Q2 | P-MOSFET | TopLayer | SOTFL95P240X88-3N | 61.0169 | 36.9905 | 0 | MOSFET (P-Channel) - low RDS on
dTP12_Q1 | P-MOSFET | TopLayer | SOTFL95P240X88-3N | 64.6169 | 36.9905 | 180 | MOSFET (P-Channel) - low RDS on
dTP11_Q2 | P-MOSFET | TopLayer | SOTFL95P240X88-3N | 55.6727 | 45.0033 | 0 | MOSFET (P-Channel) - low RDS on
dTP11_Q1 | P-MOSFET | TopLayer | SOTFL95P240X88-3N | 59.2727 | 45.0033 | 180 | MOSFET (P-Channel) - low RDS on
dTP10_Q2 | P-MOSFET | TopLayer | SOTFL95P240X88-3N | 50.4505 | 36.9905 | 0 | MOSFET (P-Channel) - low RDS on
dTP10_Q1 | P-MOSFET | TopLayer | SOTFL95P240X88-3N | 54.0505 | 36.9905 | 180 | MOSFET (P-Channel) - low RDS on
dTP9_Q2 | P-MOSFET | TopLayer | SOTFL95P240X88-3N | 45.1063 | 45.0033 | 0 | MOSFET (P-Channel) - low RDS on
dTP9_Q1 | P-MOSFET | TopLayer | SOTFL95P240X88-3N | 48.7063 | 45.0033 | 180 | MOSFET (P-Channel) - low RDS on
dTP8_Q2 | P-MOSFET | TopLayer | SOTFL95P240X88-3N | 39.9095 | 36.9905 | 0 | MOSFET (P-Channel) - low RDS on
dTP8_Q1 | P-MOSFET | TopLayer | SOTFL95P240X88-3N | 43.5095 | 36.9905 | 180 | MOSFET (P-Channel) - low RDS on
dTP7_Q2 | P-MOSFET | TopLayer | SOTFL95P240X88-3N | 34.5399 | 45.0033 | 0 | MOSFET (P-Channel) - low RDS on
dTP7_Q1 | P-MOSFET | TopLayer | SOTFL95P240X88-3N | 38.1399 | 45.0033 | 180 | MOSFET (P-Channel) - low RDS on
dTP6_Q2 | P-MOSFET | TopLayer | SOTFL95P240X88-3N | 29.3685 | 36.9905 | 0 | MOSFET (P-Channel) - low RDS on
dTP6_Q1 | P-MOSFET | TopLayer | SOTFL95P240X88-3N | 32.9685 | 36.9905 | 180 | MOSFET (P-Channel) - low RDS on
dTP5_Q2 | P-MOSFET | TopLayer | SOTFL95P240X88-3N | 23.9409 | 45.0093 | 0 | MOSFET (P-Channel) - low RDS on
dTP5_Q1 | P-MOSFET | TopLayer | SOTFL95P240X88-3N | 27.5409 | 45.0093 | 180 | MOSFET (P-Channel) - low RDS on
dTP4_Q2 | P-MOSFET | TopLayer | SOTFL95P240X88-3N | 18.7755 | 37.0159 | 0 | MOSFET (P-Channel) - low RDS on
dTP4_Q1 | P-MOSFET | TopLayer | SOTFL95P240X88-3N | 22.3755 | 37.0159 | 180 | MOSFET (P-Channel) - low RDS on
dTP3_Q2 | P-MOSFET | TopLayer | SOTFL95P240X88-3N | 13.3817 | 45.0287 | 0 | MOSFET (P-Channel) - low RDS on
dTP3_Q1 | P-MOSFET | TopLayer | SOTFL95P240X88-3N | 16.9817 | 45.0287 | 180 | MOSFET (P-Channel) - low RDS on
8pins1_U4 | SN74AHCT595PWR | TopLayer | SSOT16 | 9.6132 | 19.6620 | 270 | 8-Bit Shift Registers With 3-State Output Registers
8pins1_U2 | SN74AHCT595PWR | TopLayer | SSOT16 | 15.7848 | 19.6330 | 270 | 8-Bit Shift Registers With 3-State Output Registers
8pins10_U4 | SN74AHCT595PWR | TopLayer | SSOT16 | 199.7785 | 19.6422 | 270 | 8-Bit Shift Registers With 3-State Output Registers
8pins10_U2 | SN74AHCT595PWR | TopLayer | SSOT16 | 205.9501 | 19.6132 | 270 | 8-Bit Shift Registers With 3-State Output Registers
8pins9_U4 | SN74AHCT595PWR | TopLayer | SSOT16 | 178.6495 | 19.6422 | 270 | 8-Bit Shift Registers With 3-State Output Registers
8pins9_U2 | SN74AHCT595PWR | TopLayer | SSOT16 | 184.8211 | 19.6132 | 270 | 8-Bit Shift Registers With 3-State Output Registers
8pins8_U4 | SN74AHCT595PWR | TopLayer | SSOT16 | 157.5206 | 19.6422 | 270 | 8-Bit Shift Registers With 3-State Output Registers
8pins8_U2 | SN74AHCT595PWR | TopLayer | SSOT16 | 163.6922 | 19.6132 | 270 | 8-Bit Shift Registers With 3-State Output Registers
8pins7_U4 | SN74AHCT595PWR | TopLayer | SSOT16 | 136.3916 | 19.6422 | 270 | 8-Bit Shift Registers With 3-State Output Registers
8pins7_U2 | SN74AHCT595PWR | TopLayer | SSOT16 | 142.5632 | 19.6132 | 270 | 8-Bit Shift Registers With 3-State Output Registers
8pins6_U4 | SN74AHCT595PWR | TopLayer | SSOT16 | 115.2626 | 19.6422 | 270 | 8-Bit Shift Registers With 3-State Output Registers
8pins6_U2 | SN74AHCT595PWR | TopLayer | SSOT16 | 121.4342 | 19.6132 | 270 | 8-Bit Shift Registers With 3-State Output Registers
8pins5_U4 | SN74AHCT595PWR | TopLayer | SSOT16 | 94.1336 | 19.6422 | 270 | 8-Bit Shift Registers With 3-State Output Registers
8pins5_U2 | SN74AHCT595PWR | TopLayer | SSOT16 | 100.3052 | 19.6132 | 270 | 8-Bit Shift Registers With 3-State Output Registers
8pins4_U4 | SN74AHCT595PWR | TopLayer | SSOT16 | 73.0047 | 19.6422 | 270 | 8-Bit Shift Registers With 3-State Output Registers
8pins4_U2 | SN74AHCT595PWR | TopLayer | SSOT16 | 79.1763 | 19.6132 | 270 | 8-Bit Shift Registers With 3-State Output Registers
8pins3_U4 | SN74AHCT595PWR | TopLayer | SSOT16 | 51.8757 | 19.6422 | 270 | 8-Bit Shift Registers With 3-State Output Registers
8pins3_U2 | SN74AHCT595PWR | TopLayer | SSOT16 | 58.0473 | 19.6132 | 270 | 8-Bit Shift Registers With 3-State Output Registers
8pins2_U4 | SN74AHCT595PWR | TopLayer | SSOT16 | 30.7467 | 19.6422 | 270 | 8-Bit Shift Registers With 3-State Output Registers
8pins2_U2 | SN74AHCT595PWR | TopLayer | SSOT16 | 36.9183 | 19.6132 | 270 | 8-Bit Shift Registers With 3-State Output Registers
VR3 | 50k_TRIMMER_TC33X-2-503E | BottomLayer | TC33X2503E | 209.7183 | 56.7206 | 0 | Variable Resistor
VR1 | 50k_TRIMMER_TC33X-2-503E | BottomLayer | TC33X2503E | 210.3990 | 4.3809 | 270 | Variable Resistor

Sheet: PICKPLACE1
Designator | Comment | Layer | Footprint | Center-X(mm) | Center-Y(mm) | Rotation | Description
8pins1_C20 | 100nF | BottomLayer | 0402_CAP | 9.3396 | 22.5794 | 0 | Cap Ceramic 0.1uF 25V X7R 10% Pad SMD 0402 125C T/R
8pins1_C19 | 100nF | TopLayer | 0402_CAP | 12.4000 | 14.5949 | 270 | Cap Ceramic 0.1uF 25V X7R 10% Pad SMD 0402 125C T/R
8pins1_C18 | 100nF | TopLayer | 0402_CAP | 18.5000 | 15.0949 | 0 | Cap Ceramic 0.1uF 25V X7R 10% Pad SMD 0402 125C T/R
8pins10_C20 | 100nF | BottomLayer | 0402_CAP | 199.5049 | 22.5596 | 0 | Cap Ceramic 0.1uF 25V X7R 10% Pad SMD 0402 125C T/R
8pins10_C19 | 100nF | TopLayer | 0402_CAP | 202.0804 | 14.5740 | 270 | Cap Ceramic 0.1uF 25V X7R 10% Pad SMD 0402 125C T/R
8pins10_C18 | 100nF | TopLayer | 0402_CAP | 208.6297 | 14.9396 | 0 | Cap Ceramic 0.1uF 25V X7R 10% Pad SMD 0402 125C T/R
8pins9_C20 | 100nF | BottomLayer | 0402_CAP | 178.3759 | 22.5596 | 0 | Cap Ceramic 0.1uF 25V X7R 10% Pad SMD 0402 125C T/R
8pins9_C19 | 100nF | TopLayer | 0402_CAP | 180.9603 | 14.5650 | 270 | Cap Ceramic 0.1uF 25V X7R 10% Pad SMD 0402 125C T/R
8pins9_C18 | 100nF | TopLayer | 0402_CAP | 187.4984 | 14.9419 | 0 | Cap Ceramic 0.1uF 25V X7R 10% Pad SMD 0402 125C T/R
8pins8_C20 | 100nF | BottomLayer | 0402_CAP | 157.2470 | 22.5596 | 0 | Cap Ceramic 0.1uF 25V X7R 10% Pad SMD 0402 125C T/R
8pins8_C19 | 100nF | TopLayer | 0402_CAP | 159.8000 | 14.7949 | 270 | Cap Ceramic 0.1uF 25V X7R 10% Pad SMD 0402 125C T/R
8pins8_C18 | 100nF | TopLayer | 0402_CAP | 166.4000 | 14.8949 | 0 | Cap Ceramic 0.1uF 25V X7R 10% Pad SMD 0402 125C T/R
8pins7_C20 | 100nF | BottomLayer | 0402_CAP | 136.1180 | 22.5596 | 0 | Cap Ceramic 0.1uF 25V X7R 10% Pad SMD 0402 125C T/R
8pins7_C19 | 100nF | TopLayer | 0402_CAP | 138.7024 | 14.5650 | 270 | Cap Ceramic 0.1uF 25V X7R 10% Pad SMD 0402 125C T/R
8pins7_C18 | 100nF | TopLayer | 0402_CAP | 145.2405 | 14.9419 | 0 | Cap Ceramic 0.1uF 25V X7R 10% Pad SMD 0402 125C T/R
8pins6_C20 | 100nF | BottomLayer | 0402_CAP | 114.9890 | 22.5596 | 0 | Cap Ceramic 0.1uF 25V X7R 10% Pad SMD 0402 125C T/R
8pins6_C19 | 100nF | TopLayer | 0402_CAP | 118.1000 | 14.4949 | 270 | Cap Ceramic 0.1uF 25V X7R 10% Pad SMD 0402 125C T/R
8pins6_C18 | 100nF | TopLayer | 0402_CAP | 124.1138 | 14.9396 | 0 | Cap Ceramic 0.1uF 25V X7R 10% Pad SMD 0402 125C T/R
8pins5_C20 | 100nF | BottomLayer | 0402_CAP | 93.8600 | 22.5596 | 0 | Cap Ceramic 0.1uF 25V X7R 10% Pad SMD 0402 125C T/R
8pins5_C19 | 100nF | TopLayer | 0402_CAP | 96.6000 | 14.4949 | 270 | Cap Ceramic 0.1uF 25V X7R 10% Pad SMD 0402 125C T/R
8pins5_C18 | 100nF | TopLayer | 0402_CAP | 102.9848 | 14.9396 | 0 | Cap Ceramic 0.1uF 25V X7R 10% Pad SMD 0402 125C T/R
8pins4_C20 | 100nF | BottomLayer | 0402_CAP | 72.7311 | 22.5596 | 0 | Cap Ceramic 0.1uF 25V X7R 10% Pad SMD 0402 125C T/R
8pins4_C19 | 100nF | TopLayer | 0402_CAP | 75.3155 | 14.5650 | 270 | Cap Ceramic 0.1uF 25V X7R 10% Pad SMD 0402 125C T/R
8pins4_C18 | 100nF | TopLayer | 0402_CAP | 81.8559 | 14.9396 | 0 | Cap Ceramic 0.1uF 25V X7R 10% Pad SMD 0402 125C T/R
8pins3_C20 | 100nF | BottomLayer | 0402_CAP | 51.6021 | 22.5596 | 0 | Cap Ceramic 0.1uF 25V X7R 10% Pad SMD 0402 125C T/R
8pins3_C19 | 100nF | TopLayer | 0402_CAP | 54.5000 | 14.2949 | 270 | Cap Ceramic 0.1uF 25V X7R 10% Pad SMD 0402 125C T/R
8pins3_C18 | 100nF | TopLayer | 0402_CAP | 60.7269 | 14.9396 | 0 | Cap Ceramic 0.1uF 25V X7R 10% Pad SMD 0402 125C T/R
8pins2_C20 | 100nF | BottomLayer | 0402_CAP | 30.4731 | 22.5596 | 0 | Cap Ceramic 0.1uF 25V X7R 10% Pad SMD 0402 125C T/R
8pins2_C19 | 100nF | TopLayer | 0402_CAP | 33.3000 | 14.4949 | 270 | Cap Ceramic 0.1uF 25V X7R 10% Pad SMD 0402 125C T/R
8pins2_C18 | 100nF | TopLayer | 0402_CAP | 39.5979 | 14.9396 | 0 | Cap Ceramic 0.1uF 25V X7R 10% Pad SMD 0402 125C T/R
C0402C104K3RACTU KEMET | Mouser Česká Republika (https://cz.mouser.com/ProductDetail/KEMET/C0402C104K3RACTU?qs=YCcZ0GhAU2q7BaxZ%2FluQHA%3D%3D) |  |  |  |  |  | Počet na 1 desku | 30
Designator | Comment | Layer | Footprint | Center-X(mm) | Center-Y(mm) | Rotation | Description
D13 | SSA34HE3_A_I | TopLayer | DIONM5127X229N | 204.4683 | 56.3956 | 270 | Schottky Diode
D11 | SSA34HE3_A_I | TopLayer | DIONM5127X229N | 210.5000 | 9.4449 | 180 | Schottky Diode
SSA34HE3_A/I Vishay General Semiconductor | Mouser Česká Republika (https://cz.mouser.com/ProductDetail/Vishay-General-Semiconductor/SSA34HE3_A-I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) |  |  |  |  |  | Počet na 1 desku | 2
Designator | Comment | Layer | Footprint | Center-X(mm) | Center-Y(mm) | Rotation | Description
R17 | 1k | TopLayer | 0603-_SMD_RESISTOR | 201.7340 | 58.6602 | 270 | Resistor
R11 | 1k | TopLayer | 0603-_SMD_RESISTOR | 212.2780 | 12.2389 | 180 | Resistor
RT0603FRE071KL YAGEO | Mouser Česká Republika (https://cz.mouser.com/ProductDetail/YAGEO/RT0603FRE071KL?qs=8cPjvKtxWv68ZVEzoi6JxQ%3D%3D) |  |  |  |  |  | Počet na 1 desku | 2
Designator | Comment | Layer | Footprint | Center-X(mm) | Center-Y(mm) | Rotation | Description
C27 | 10uF | TopLayer | 0603_TANTAL | 207.8183 | 51.8956 | 180 | CAP TANT POLY 10UF 10V SMD
C21 | 10uF | TopLayer | 0603_TANTAL | 205.9280 | 6.1429 | 90 | CAP TANT POLY 10UF 10V SMD
F381A106MMAAH1 KYOCERA AVX | Mouser Česká Republika (https://cz.mouser.com/ProductDetail/KYOCERA-AVX/F381A106MMAAH1) |  |  |  |  |  | Počet na 1 desku | 2
Designator | Comment | Layer | Footprint | Center-X(mm) | Center-Y(mm) | Rotation | Description
C28 | 1uF 25V | TopLayer | 0603-CAP | 206.9683 | 57.8956 | 270 | General Purpose Ceramic Capacitor
C22 | 1uF 25V | TopLayer | 0603-CAP | 212.0240 | 7.1589 | 180 | General Purpose Ceramic Capacitor
F381A106MMAAH1 KYOCERA AVX | Mouser Česká Republika (https://cz.mouser.com/ProductDetail/KYOCERA-AVX/F381A106MMAAH1) |  |  |  |  |  | Počet na 1 desku | 2
Designator | Comment | Layer | Footprint | Center-X(mm) | Center-Y(mm) | Rotation | Description
VR3 | 50k_TRIMMER_TC33X-2-503E | BottomLayer | TC33X2503E | 209.7183 | 56.7206 | 0 | Variable Resistor
VR1 | 50k_TRIMMER_TC33X-2-503E | BottomLayer | TC33X2503E | 210.3990 | 4.3809 | 270 | Variable Resistor
TC33X-2-503E Bourns | Mouser Česká Republika (https://cz.mouser.com/ProductDetail/Bourns/TC33X-2-503E) |  |  |  |  |  | Počet na 1 desku | 2
Designator | Comment | Layer | Footprint | Center-X(mm) | Center-Y(mm) | Rotation | Description
R9 | 220k | TopLayer | RESC1005X40X25NL05T05 | 208.4680 | 7.1589 | 0
ERJ-2GEJ224X Panasonic | Mouser Česká Republika (https://cz.mouser.com/ProductDetail/Panasonic/ERJ-2GEJ224X?qs=H7k1u0Mp9JQ0o1uy9bJkFg%3D%3D) |  |  |  |  |  | Počet na 1 desku | 1
Designator | Comment | Layer | Footprint | Center-X(mm) | Center-Y(mm) | Rotation | Description
dTP2_R8 | 470R 1% | TopLayer | RESC1005X40X25NL05T05 | 11.1091 | 34.7159 | 0
dTP2_R7 | 470R 1% | TopLayer | RESC1005X40X25NL05T05 | 8.9091 | 34.7159 | 180
dTP1_R7 | 470R 1% | TopLayer | RESC1005X40X25NL05T05 | 3.5337 | 42.7372 | 180
dTP1_R8 | 470R 1% | TopLayer | RESC1005X40X25NL05T05 | 5.7337 | 42.7372 | 0
dTP40_R8 | 470R 1% | TopLayer | RESC1005X40X25NL05T05 | 211.6433 | 34.6905 | 0
dTP40_R7 | 470R 1% | TopLayer | RESC1005X40X25NL05T05 | 209.4433 | 34.6905 | 180
dTP39_R8 | 470R 1% | TopLayer | RESC1005X40X25NL05T05 | 206.5023 | 42.7033 | 0
dTP39_R7 | 470R 1% | TopLayer | RESC1005X40X25NL05T05 | 204.3023 | 42.7033 | 180
dTP38_R8 | 470R 1% | TopLayer | RESC1005X40X25NL05T05 | 201.0769 | 34.6905 | 0
dTP38_R7 | 470R 1% | TopLayer | RESC1005X40X25NL05T05 | 198.8769 | 34.6905 | 180
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
dTP14_R6 | 2k2 | BottomLayer | RESC1005X40X25NL05T05 | 73.7579 | 27.3405 | 0
dTP14_R5 | 2k2 | BottomLayer | RESC1005X40X25NL05T05 | 71.5079 | 27.3405 | 180
dTP13_R6 | 2k2 | BottomLayer | RESC1005X40X25NL05T05 | 68.4391 | 35.3533 | 0
dTP13_R5 | 2k2 | BottomLayer | RESC1005X40X25NL05T05 | 66.1891 | 35.3533 | 180
dTP12_R6 | 2k2 | BottomLayer | RESC1005X40X25NL05T05 | 63.2169 | 27.3405 | 0
dTP12_R5 | 2k2 | BottomLayer | RESC1005X40X25NL05T05 | 60.9669 | 27.3405 | 180
dTP11_R6 | 2k2 | BottomLayer | RESC1005X40X25NL05T05 | 57.8727 | 35.3533 | 0
dTP11_R5 | 2k2 | BottomLayer | RESC1005X40X25NL05T05 | 55.6227 | 35.3533 | 180
dTP10_R6 | 2k2 | BottomLayer | RESC1005X40X25NL05T05 | 52.6505 | 27.3405 | 0
dTP10_R5 | 2k2 | BottomLayer | RESC1005X40X25NL05T05 | 50.4005 | 27.3405 | 180
dTP9_R6 | 2k2 | BottomLayer | RESC1005X40X25NL05T05 | 47.3063 | 35.3533 | 0
dTP9_R5 | 2k2 | BottomLayer | RESC1005X40X25NL05T05 | 45.0563 | 35.3533 | 180
dTP8_R6 | 2k2 | BottomLayer | RESC1005X40X25NL05T05 | 42.1095 | 27.3405 | 0
dTP8_R5 | 2k2 | BottomLayer | RESC1005X40X25NL05T05 | 39.8595 | 27.3405 | 180
dTP7_R6 | 2k2 | BottomLayer | RESC1005X40X25NL05T05 | 36.7399 | 35.3533 | 0
dTP7_R5 | 2k2 | BottomLayer | RESC1005X40X25NL05T05 | 34.4899 | 35.3533 | 180
dTP6_R6 | 2k2 | BottomLayer | RESC1005X40X25NL05T05 | 31.5685 | 27.3405 | 0
dTP6_R5 | 2k2 | BottomLayer | RESC1005X40X25NL05T05 | 29.3185 | 27.3405 | 180
dTP5_R6 | 2k2 | BottomLayer | RESC1005X40X25NL05T05 | 26.1409 | 35.3593 | 0
dTP5_R5 | 2k2 | BottomLayer | RESC1005X40X25NL05T05 | 23.8909 | 35.3593 | 180
dTP4_R6 | 2k2 | BottomLayer | RESC1005X40X25NL05T05 | 20.9755 | 27.3659 | 0
dTP4_R5 | 2k2 | BottomLayer | RESC1005X40X25NL05T05 | 18.7255 | 27.3659 | 180
dTP3_R6 | 2k2 | BottomLayer | RESC1005X40X25NL05T05 | 15.5817 | 35.3787 | 0
dTP3_R5 | 2k2 | BottomLayer | RESC1005X40X25NL05T05 | 13.3317 | 35.3787 | 180
ERJ-PA2F2201X Panasonic | Mouser Česká Republika (https://cz.mouser.com/ProductDetail/Panasonic/ERJ-PA2F2201X) |  |  |  |  |  | Počet na 1 desku | 80

Sheet: PICKPLACE2
Designator | Comment | Layer | Footprint | Center-X(mm) | Center-Y(mm) | Rotation | Description
dTP2_IC1 | LM393LVQDRQ1 | BottomLayer | SOIC127P600X175-8N | 10.1591 | 31.0659 | 0 | Integrated Circuit
dTP1_IC1 | LM393LVQDRQ1 | BottomLayer | SOIC127P600X175-8N | 4.7837 | 39.0872 | 0 | Integrated Circuit
dTP40_IC1 | LM393LVQDRQ1 | BottomLayer | SOIC127P600X175-8N | 210.6933 | 31.0405 | 0 | Integrated Circuit
dTP39_IC1 | LM393LVQDRQ1 | BottomLayer | SOIC127P600X175-8N | 205.5523 | 39.0533 | 0 | Integrated Circuit
dTP38_IC1 | LM393LVQDRQ1 | BottomLayer | SOIC127P600X175-8N | 200.1269 | 31.0405 | 0 | Integrated Circuit
dTP37_IC1 | LM393LVQDRQ1 | BottomLayer | SOIC127P600X175-8N | 194.9859 | 39.0533 | 0 | Integrated Circuit
dTP36_IC1 | LM393LVQDRQ1 | BottomLayer | SOIC127P600X175-8N | 189.5859 | 31.0405 | 0 | Integrated Circuit
dTP35_IC1 | LM393LVQDRQ1 | BottomLayer | SOIC127P600X175-8N | 184.4195 | 39.0533 | 0 | Integrated Circuit
dTP34_IC1 | LM393LVQDRQ1 | BottomLayer | SOIC127P600X175-8N | 179.0195 | 31.0405 | 0 | Integrated Circuit
dTP33_IC1 | LM393LVQDRQ1 | BottomLayer | SOIC127P600X175-8N | 173.8531 | 39.0533 | 0 | Integrated Circuit
dTP32_IC1 | LM393LVQDRQ1 | BottomLayer | SOIC127P600X175-8N | 168.4785 | 31.0405 | 0 | Integrated Circuit
dTP31_IC1 | LM393LVQDRQ1 | BottomLayer | SOIC127P600X175-8N | 163.2867 | 39.0533 | 0 | Integrated Circuit
dTP30_IC1 | LM393LVQDRQ1 | BottomLayer | SOIC127P600X175-8N | 157.9375 | 31.0405 | 0 | Integrated Circuit
dTP29_IC1 | LM393LVQDRQ1 | BottomLayer | SOIC127P600X175-8N | 152.7203 | 39.0533 | 0 | Integrated Circuit
dTP28_IC1 | LM393LVQDRQ1 | BottomLayer | SOIC127P600X175-8N | 147.3711 | 31.0405 | 0 | Integrated Circuit
dTP27_IC1 | LM393LVQDRQ1 | BottomLayer | SOIC127P600X175-8N | 142.1539 | 39.0533 | 0 | Integrated Circuit
dTP26_IC1 | LM393LVQDRQ1 | BottomLayer | SOIC127P600X175-8N | 136.8301 | 31.0405 | 0 | Integrated Circuit
dTP25_IC1 | LM393LVQDRQ1 | BottomLayer | SOIC127P600X175-8N | 131.5875 | 39.0533 | 0 | Integrated Circuit
dTP24_IC1 | LM393LVQDRQ1 | BottomLayer | SOIC127P600X175-8N | 126.2637 | 31.0405 | 0 | Integrated Circuit
dTP23_IC1 | LM393LVQDRQ1 | BottomLayer | SOIC127P600X175-8N | 121.0211 | 39.0533 | 0 | Integrated Circuit
dTP22_IC1 | LM393LVQDRQ1 | BottomLayer | SOIC127P600X175-8N | 115.7227 | 31.0405 | 0 | Integrated Circuit
dTP21_IC1 | LM393LVQDRQ1 | BottomLayer | SOIC127P600X175-8N | 110.4547 | 39.0533 | 0 | Integrated Circuit
dTP20_IC1 | LM393LVQDRQ1 | BottomLayer | SOIC127P600X175-8N | 105.1563 | 31.0405 | 0 | Integrated Circuit
dTP19_IC1 | LM393LVQDRQ1 | BottomLayer | SOIC127P600X175-8N | 99.8883 | 39.0533 | 0 | Integrated Circuit
dTP18_IC1 | LM393LVQDRQ1 | BottomLayer | SOIC127P600X175-8N | 94.6153 | 31.0405 | 0 | Integrated Circuit
dTP17_IC1 | LM393LVQDRQ1 | BottomLayer | SOIC127P600X175-8N | 89.3219 | 39.0533 | 0 | Integrated Circuit
dTP16_IC1 | LM393LVQDRQ1 | BottomLayer | SOIC127P600X175-8N | 84.0743 | 31.0405 | 0 | Integrated Circuit
dTP15_IC1 | LM393LVQDRQ1 | BottomLayer | SOIC127P600X175-8N | 78.7555 | 39.0533 | 0 | Integrated Circuit
dTP14_IC1 | LM393LVQDRQ1 | BottomLayer | SOIC127P600X175-8N | 73.5079 | 31.0405 | 0 | Integrated Circuit
dTP13_IC1 | LM393LVQDRQ1 | BottomLayer | SOIC127P600X175-8N | 68.1891 | 39.0533 | 0 | Integrated Circuit
dTP12_IC1 | LM393LVQDRQ1 | BottomLayer | SOIC127P600X175-8N | 62.9669 | 31.0405 | 0 | Integrated Circuit
dTP11_IC1 | LM393LVQDRQ1 | BottomLayer | SOIC127P600X175-8N | 57.6227 | 39.0533 | 0 | Integrated Circuit
dTP10_IC1 | LM393LVQDRQ1 | BottomLayer | SOIC127P600X175-8N | 52.4005 | 31.0405 | 0 | Integrated Circuit
dTP9_IC1 | LM393LVQDRQ1 | BottomLayer | SOIC127P600X175-8N | 47.0563 | 39.0533 | 0 | Integrated Circuit
dTP8_IC1 | LM393LVQDRQ1 | BottomLayer | SOIC127P600X175-8N | 41.8595 | 31.0405 | 0 | Integrated Circuit
dTP7_IC1 | LM393LVQDRQ1 | BottomLayer | SOIC127P600X175-8N | 36.4899 | 39.0533 | 0 | Integrated Circuit
dTP6_IC1 | LM393LVQDRQ1 | BottomLayer | SOIC127P600X175-8N | 31.3185 | 31.0405 | 0 | Integrated Circuit
dTP5_IC1 | LM393LVQDRQ1 | BottomLayer | SOIC127P600X175-8N | 25.8909 | 39.0593 | 0 | Integrated Circuit
dTP4_IC1 | LM393LVQDRQ1 | BottomLayer | SOIC127P600X175-8N | 20.7255 | 31.0659 | 0 | Integrated Circuit
dTP3_IC1 | LM393LVQDRQ1 | BottomLayer | SOIC127P600X175-8N | 15.3317 | 39.0787 | 0 | Integrated Circuit
LM393LVQDRQ1 Texas Instruments | Mouser Česká Republika (https://cz.mouser.com/ProductDetail/Texas-Instruments/LM393LVQDRQ1?qs=IS%252B4QmGtzzqk8QFsvXuXMw%3D%3D) |  |  |  |  |  | Počet na 1 desku | 40
Designator | Comment | Layer | Footprint | Center-X(mm) | Center-Y(mm) | Rotation | Description
R15 | 120k | TopLayer | RESC1005X40X25NL05T05 | 206.9683 | 54.6456 | 90
ERJ-S02F1203X Panasonic | Mouser Česká Republika (https://cz.mouser.com/ProductDetail/Panasonic/ERJ-S02F1203X?qs=Zyl8A9hlmJoQeBgjsVTVMg%3D%3D) |  |  |  |  |  | Počet na 1 desku | 1
Designator | Comment | Layer | Footprint | Center-X(mm) | Center-Y(mm) | Rotation | Description
D3 | LED | TopLayer | 0603_RED_LED | 201.7183 | 54.8206 | 270 | LED RED DIFFUSED 1608 SMD
D1 | LED | TopLayer | 0603_RED_LED | 208.7220 | 12.2389 | 180 | LED RED DIFFUSED 1608 SMD
SML-D12U1WT86 ROHM Semiconductor | Mouser Česká Republika (https://cz.mouser.com/ProductDetail/ROHM-Semiconductor/SML-D12U1WT86?qs=M3jcYzEJUdEySuGkbjHEtQ%3D%3D) |  |  |  |  |  | Počet na 1 desku | 2
Designator | Comment | Layer | Footprint | Center-X(mm) | Center-Y(mm) | Rotation | Description
J1 | HARTING 96 PIN 3 rows | TopLayer | 09033966921 | 107.5000 | 56.1749 | 180 | Connector
09033966921 HARTING | Mouser Česká Republika (https://cz.mouser.com/ProductDetail/HARTING/09033966921?qs=gIpPgrDBK%2FiSDuMebe5eaQ%3D%3D) | Tady je osazený konektor ze skladu (ne z linku) |  |  |  |  | Počet na 1 desku | 1
Designator | Comment | Layer | Footprint | Center-X(mm) | Center-Y(mm) | Rotation | Description
IC4 | TLV76701DGNR_LDO | TopLayer | SOP65P490X110-9N | 209.7183 | 56.3956 | 90 | Integrated Circuit
IC2 | TLV76701DGNR_LDO | TopLayer | SOP65P490X110-9N | 210.2460 | 4.3649 | 0 | Integrated Circuit
TLV76701DGNR Texas Instruments | Mouser Česká Republika (https://cz.mouser.com/ProductDetail/Texas-Instruments/TLV76701DGNR?qs=QNEnbhJQKvYlzprjZl22mQ%3D%3D) |  |  |  |  |  | Počet na 1 desku | 2
Designator | Comment | Layer | Footprint | Center-X(mm) | Center-Y(mm) | Rotation | Description
8pins1_U3 | TMUX1308QDYYRQ1 | BottomLayer | FP-DYY0016A-MFG | 12.5844 | 19.9378 | 180 | AUTOMOTIVE
8pins10_U3 | TMUX1308QDYYRQ1 | BottomLayer | FP-DYY0016A-MFG | 202.7497 | 19.9180 | 180 | AUTOMOTIVE
8pins9_U3 | TMUX1308QDYYRQ1 | BottomLayer | FP-DYY0016A-MFG | 181.6207 | 19.9180 | 180 | AUTOMOTIVE
8pins8_U3 | TMUX1308QDYYRQ1 | BottomLayer | FP-DYY0016A-MFG | 160.4918 | 19.9180 | 180 | AUTOMOTIVE
8pins7_U3 | TMUX1308QDYYRQ1 | BottomLayer | FP-DYY0016A-MFG | 139.3628 | 19.9180 | 180 | AUTOMOTIVE
8pins6_U3 | TMUX1308QDYYRQ1 | BottomLayer | FP-DYY0016A-MFG | 118.2338 | 19.9180 | 180 | AUTOMOTIVE
8pins5_U3 | TMUX1308QDYYRQ1 | BottomLayer | FP-DYY0016A-MFG | 97.1048 | 19.9180 | 180 | AUTOMOTIVE
8pins4_U3 | TMUX1308QDYYRQ1 | BottomLayer | FP-DYY0016A-MFG | 75.9759 | 19.9180 | 180 | AUTOMOTIVE
8pins3_U3 | TMUX1308QDYYRQ1 | BottomLayer | FP-DYY0016A-MFG | 54.8469 | 19.9180 | 180 | AUTOMOTIVE
8pins2_U3 | TMUX1308QDYYRQ1 | BottomLayer | FP-DYY0016A-MFG | 33.7179 | 19.9180 | 180 | AUTOMOTIVE
TMUX1308QDYYRQ1 Texas Instruments | Mouser Česká Republika (https://cz.mouser.com/ProductDetail/Texas-Instruments/TMUX1308QDYYRQ1?qs=xZ%2FP%252Ba9zWqaqz9D2kpWQ%2FA%3D%3D) |  |  |  |  |  | Počet na 1 desku | 10
Designator | Comment | Layer | Footprint | Center-X(mm) | Center-Y(mm) | Rotation | Description
8pins1_U4 | SN74AHCT595PWR | TopLayer | SSOT16 | 9.6132 | 19.6620 | 270 | 8-Bit Shift Registers With 3-State Output Registers
8pins1_U2 | SN74AHCT595PWR | TopLayer | SSOT16 | 15.7848 | 19.6330 | 270 | 8-Bit Shift Registers With 3-State Output Registers
8pins10_U4 | SN74AHCT595PWR | TopLayer | SSOT16 | 199.7785 | 19.6422 | 270 | 8-Bit Shift Registers With 3-State Output Registers
8pins10_U2 | SN74AHCT595PWR | TopLayer | SSOT16 | 205.9501 | 19.6132 | 270 | 8-Bit Shift Registers With 3-State Output Registers
8pins9_U4 | SN74AHCT595PWR | TopLayer | SSOT16 | 178.6495 | 19.6422 | 270 | 8-Bit Shift Registers With 3-State Output Registers
8pins9_U2 | SN74AHCT595PWR | TopLayer | SSOT16 | 184.8211 | 19.6132 | 270 | 8-Bit Shift Registers With 3-State Output Registers
8pins8_U4 | SN74AHCT595PWR | TopLayer | SSOT16 | 157.5206 | 19.6422 | 270 | 8-Bit Shift Registers With 3-State Output Registers
8pins8_U2 | SN74AHCT595PWR | TopLayer | SSOT16 | 163.6922 | 19.6132 | 270 | 8-Bit Shift Registers With 3-State Output Registers
8pins7_U4 | SN74AHCT595PWR | TopLayer | SSOT16 | 136.3916 | 19.6422 | 270 | 8-Bit Shift Registers With 3-State Output Registers
8pins7_U2 | SN74AHCT595PWR | TopLayer | SSOT16 | 142.5632 | 19.6132 | 270 | 8-Bit Shift Registers With 3-State Output Registers
8pins6_U4 | SN74AHCT595PWR | TopLayer | SSOT16 | 115.2626 | 19.6422 | 270 | 8-Bit Shift Registers With 3-State Output Registers
8pins6_U2 | SN74AHCT595PWR | TopLayer | SSOT16 | 121.4342 | 19.6132 | 270 | 8-Bit Shift Registers With 3-State Output Registers
8pins5_U4 | SN74AHCT595PWR | TopLayer | SSOT16 | 94.1336 | 19.6422 | 270 | 8-Bit Shift Registers With 3-State Output Registers
8pins5_U2 | SN74AHCT595PWR | TopLayer | SSOT16 | 100.3052 | 19.6132 | 270 | 8-Bit Shift Registers With 3-State Output Registers
8pins4_U4 | SN74AHCT595PWR | TopLayer | SSOT16 | 73.0047 | 19.6422 | 270 | 8-Bit Shift Registers With 3-State Output Registers
8pins4_U2 | SN74AHCT595PWR | TopLayer | SSOT16 | 79.1763 | 19.6132 | 270 | 8-Bit Shift Registers With 3-State Output Registers
8pins3_U4 | SN74AHCT595PWR | TopLayer | SSOT16 | 51.8757 | 19.6422 | 270 | 8-Bit Shift Registers With 3-State Output Registers
8pins3_U2 | SN74AHCT595PWR | TopLayer | SSOT16 | 58.0473 | 19.6132 | 270 | 8-Bit Shift Registers With 3-State Output Registers
8pins2_U4 | SN74AHCT595PWR | TopLayer | SSOT16 | 30.7467 | 19.6422 | 270 | 8-Bit Shift Registers With 3-State Output Registers
8pins2_U2 | SN74AHCT595PWR | TopLayer | SSOT16 | 36.9183 | 19.6132 | 270 | 8-Bit Shift Registers With 3-State Output Registers
SN74AHCT595PWR Texas Instruments | Mouser Česká Republika (https://cz.mouser.com/ProductDetail/?qs=spW5eSrOWB5KP%2FLOxGLzFA%3D%3D) |  |  |  |  |  | Počet na 1 desku | 20
Designator | Comment | Layer | Footprint | Center-X(mm) | Center-Y(mm) | Rotation | Description
dTP2_Q2 | P-MOSFET | TopLayer | SOTFL95P240X88-3N | 8.2091 | 37.0159 | 0 | MOSFET (P-Channel) - low RDS on
dTP2_Q1 | P-MOSFET | TopLayer | SOTFL95P240X88-3N | 11.8091 | 37.0159 | 180 | MOSFET (P-Channel) - low RDS on
dTP1_Q1 | P-MOSFET | TopLayer | SOTFL95P240X88-3N | 6.4337 | 45.0372 | 180 | MOSFET (P-Channel) - low RDS on
dTP1_Q2 | P-MOSFET | TopLayer | SOTFL95P240X88-3N | 2.8337 | 45.0372 | 0 | MOSFET (P-Channel) - low RDS on
dTP40_Q2 | P-MOSFET | TopLayer | SOTFL95P240X88-3N | 208.7433 | 36.9905 | 0 | MOSFET (P-Channel) - low RDS on
dTP40_Q1 | P-MOSFET | TopLayer | SOTFL95P240X88-3N | 212.3433 | 36.9905 | 180 | MOSFET (P-Channel) - low RDS on
dTP39_Q2 | P-MOSFET | TopLayer | SOTFL95P240X88-3N | 203.6023 | 45.0033 | 0 | MOSFET (P-Channel) - low RDS on
dTP39_Q1 | P-MOSFET | TopLayer | SOTFL95P240X88-3N | 207.2023 | 45.0033 | 180 | MOSFET (P-Channel) - low RDS on
dTP38_Q2 | P-MOSFET | TopLayer | SOTFL95P240X88-3N | 198.1769 | 36.9905 | 0 | MOSFET (P-Channel) - low RDS on
dTP38_Q1 | P-MOSFET | TopLayer | SOTFL95P240X88-3N | 201.7769 | 36.9905 | 180 | MOSFET (P-Channel) - low RDS on
dTP37_Q2 | P-MOSFET | TopLayer | SOTFL95P240X88-3N | 193.0359 | 45.0033 | 0 | MOSFET (P-Channel) - low RDS on
dTP37_Q1 | P-MOSFET | TopLayer | SOTFL95P240X88-3N | 196.6359 | 45.0033 | 180 | MOSFET (P-Channel) - low RDS on
dTP36_Q2 | P-MOSFET | TopLayer | SOTFL95P240X88-3N | 187.6359 | 36.9905 | 0 | MOSFET (P-Channel) - low RDS on
dTP36_Q1 | P-MOSFET | TopLayer | SOTFL95P240X88-3N | 191.2359 | 36.9905 | 180 | MOSFET (P-Channel) - low RDS on
dTP35_Q2 | P-MOSFET | TopLayer | SOTFL95P240X88-3N | 182.4695 | 45.0033 | 0 | MOSFET (P-Channel) - low RDS on
dTP35_Q1 | P-MOSFET | TopLayer | SOTFL95P240X88-3N | 186.0695 | 45.0033 | 180 | MOSFET (P-Channel) - low RDS on
dTP34_Q2 | P-MOSFET | TopLayer | SOTFL95P240X88-3N | 177.0695 | 36.9905 | 0 | MOSFET (P-Channel) - low RDS on
dTP34_Q1 | P-MOSFET | TopLayer | SOTFL95P240X88-3N | 180.6695 | 36.9905 | 180 | MOSFET (P-Channel) - low RDS on
dTP33_Q2 | P-MOSFET | TopLayer | SOTFL95P240X88-3N | 171.9031 | 45.0033 | 0 | MOSFET (P-Channel) - low RDS on
dTP33_Q1 | P-MOSFET | TopLayer | SOTFL95P240X88-3N | 175.5031 | 45.0033 | 180 | MOSFET (P-Channel) - low RDS on
dTP32_Q2 | P-MOSFET | TopLayer | SOTFL95P240X88-3N | 166.5285 | 36.9905 | 0 | MOSFET (P-Channel) - low RDS on
dTP32_Q1 | P-MOSFET | TopLayer | SOTFL95P240X88-3N | 170.1285 | 36.9905 | 180 | MOSFET (P-Channel) - low RDS on
dTP31_Q2 | P-MOSFET | TopLayer | SOTFL95P240X88-3N | 161.3367 | 45.0033 | 0 | MOSFET (P-Channel) - low RDS on
dTP31_Q1 | P-MOSFET | TopLayer | SOTFL95P240X88-3N | 164.9367 | 45.0033 | 180 | MOSFET (P-Channel) - low RDS on
dTP30_Q2 | P-MOSFET | TopLayer | SOTFL95P240X88-3N | 155.9875 | 36.9905 | 0 | MOSFET (P-Channel) - low RDS on
dTP30_Q1 | P-MOSFET | TopLayer | SOTFL95P240X88-3N | 159.5875 | 36.9905 | 180 | MOSFET (P-Channel) - low RDS on
dTP29_Q2 | P-MOSFET | TopLayer | SOTFL95P240X88-3N | 150.7703 | 45.0033 | 0 | MOSFET (P-Channel) - low RDS on
dTP29_Q1 | P-MOSFET | TopLayer | SOTFL95P240X88-3N | 154.3703 | 45.0033 | 180 | MOSFET (P-Channel) - low RDS on
dTP28_Q2 | P-MOSFET | TopLayer | SOTFL95P240X88-3N | 145.4211 | 36.9905 | 0 | MOSFET (P-Channel) - low RDS on
dTP28_Q1 | P-MOSFET | TopLayer | SOTFL95P240X88-3N | 149.0211 | 36.9905 | 180 | MOSFET (P-Channel) - low RDS on
dTP27_Q2 | P-MOSFET | TopLayer | SOTFL95P240X88-3N | 140.2039 | 45.0033 | 0 | MOSFET (P-Channel) - low RDS on
dTP27_Q1 | P-MOSFET | TopLayer | SOTFL95P240X88-3N | 143.8039 | 45.0033 | 180 | MOSFET (P-Channel) - low RDS on
dTP26_Q2 | P-MOSFET | TopLayer | SOTFL95P240X88-3N | 134.8801 | 36.9905 | 0 | MOSFET (P-Channel) - low RDS on
dTP26_Q1 | P-MOSFET | TopLayer | SOTFL95P240X88-3N | 138.4801 | 36.9905 | 180 | MOSFET (P-Channel) - low RDS on
dTP25_Q2 | P-MOSFET | TopLayer | SOTFL95P240X88-3N | 129.6375 | 45.0033 | 0 | MOSFET (P-Channel) - low RDS on
dTP25_Q1 | P-MOSFET | TopLayer | SOTFL95P240X88-3N | 133.2375 | 45.0033 | 180 | MOSFET (P-Channel) - low RDS on
dTP24_Q2 | P-MOSFET | TopLayer | SOTFL95P240X88-3N | 124.3137 | 36.9905 | 0 | MOSFET (P-Channel) - low RDS on
dTP24_Q1 | P-MOSFET | TopLayer | SOTFL95P240X88-3N | 127.9137 | 36.9905 | 180 | MOSFET (P-Channel) - low RDS on
dTP23_Q2 | P-MOSFET | TopLayer | SOTFL95P240X88-3N | 119.0711 | 45.0033 | 0 | MOSFET (P-Channel) - low RDS on
dTP23_Q1 | P-MOSFET | TopLayer | SOTFL95P240X88-3N | 122.6711 | 45.0033 | 180 | MOSFET (P-Channel) - low RDS on
dTP22_Q2 | P-MOSFET | TopLayer | SOTFL95P240X88-3N | 113.7727 | 36.9905 | 0 | MOSFET (P-Channel) - low RDS on
dTP22_Q1 | P-MOSFET | TopLayer | SOTFL95P240X88-3N | 117.3727 | 36.9905 | 180 | MOSFET (P-Channel) - low RDS on
dTP21_Q2 | P-MOSFET | TopLayer | SOTFL95P240X88-3N | 108.5047 | 45.0033 | 0 | MOSFET (P-Channel) - low RDS on
dTP21_Q1 | P-MOSFET | TopLayer | SOTFL95P240X88-3N | 112.1047 | 45.0033 | 180 | MOSFET (P-Channel) - low RDS on
dTP20_Q2 | P-MOSFET | TopLayer | SOTFL95P240X88-3N | 103.2063 | 36.9905 | 0 | MOSFET (P-Channel) - low RDS on
dTP20_Q1 | P-MOSFET | TopLayer | SOTFL95P240X88-3N | 106.8063 | 36.9905 | 180 | MOSFET (P-Channel) - low RDS on
dTP19_Q2 | P-MOSFET | TopLayer | SOTFL95P240X88-3N | 97.9383 | 45.0033 | 0 | MOSFET (P-Channel) - low RDS on
dTP19_Q1 | P-MOSFET | TopLayer | SOTFL95P240X88-3N | 101.5383 | 45.0033 | 180 | MOSFET (P-Channel) - low RDS on
dTP18_Q2 | P-MOSFET | TopLayer | SOTFL95P240X88-3N | 92.6653 | 36.9905 | 0 | MOSFET (P-Channel) - low RDS on
dTP18_Q1 | P-MOSFET | TopLayer | SOTFL95P240X88-3N | 96.2653 | 36.9905 | 180 | MOSFET (P-Channel) - low RDS on
dTP17_Q2 | P-MOSFET | TopLayer | SOTFL95P240X88-3N | 87.3719 | 45.0033 | 0 | MOSFET (P-Channel) - low RDS on
dTP17_Q1 | P-MOSFET | TopLayer | SOTFL95P240X88-3N | 90.9719 | 45.0033 | 180 | MOSFET (P-Channel) - low RDS on
dTP16_Q2 | P-MOSFET | TopLayer | SOTFL95P240X88-3N | 82.1243 | 36.9905 | 0 | MOSFET (P-Channel) - low RDS on
dTP16_Q1 | P-MOSFET | TopLayer | SOTFL95P240X88-3N | 85.7243 | 36.9905 | 180 | MOSFET (P-Channel) - low RDS on
dTP15_Q2 | P-MOSFET | TopLayer | SOTFL95P240X88-3N | 76.8055 | 45.0033 | 0 | MOSFET (P-Channel) - low RDS on
dTP15_Q1 | P-MOSFET | TopLayer | SOTFL95P240X88-3N | 80.4055 | 45.0033 | 180 | MOSFET (P-Channel) - low RDS on
dTP14_Q2 | P-MOSFET | TopLayer | SOTFL95P240X88-3N | 71.5579 | 36.9905 | 0 | MOSFET (P-Channel) - low RDS on
dTP14_Q1 | P-MOSFET | TopLayer | SOTFL95P240X88-3N | 75.1579 | 36.9905 | 180 | MOSFET (P-Channel) - low RDS on
dTP13_Q2 | P-MOSFET | TopLayer | SOTFL95P240X88-3N | 66.2391 | 45.0033 | 0 | MOSFET (P-Channel) - low RDS on
dTP13_Q1 | P-MOSFET | TopLayer | SOTFL95P240X88-3N | 69.8391 | 45.0033 | 180 | MOSFET (P-Channel) - low RDS on
dTP12_Q2 | P-MOSFET | TopLayer | SOTFL95P240X88-3N | 61.0169 | 36.9905 | 0 | MOSFET (P-Channel) - low RDS on
dTP12_Q1 | P-MOSFET | TopLayer | SOTFL95P240X88-3N | 64.6169 | 36.9905 | 180 | MOSFET (P-Channel) - low RDS on
dTP11_Q2 | P-MOSFET | TopLayer | SOTFL95P240X88-3N | 55.6727 | 45.0033 | 0 | MOSFET (P-Channel) - low RDS on
dTP11_Q1 | P-MOSFET | TopLayer | SOTFL95P240X88-3N | 59.2727 | 45.0033 | 180 | MOSFET (P-Channel) - low RDS on
dTP10_Q2 | P-MOSFET | TopLayer | SOTFL95P240X88-3N | 50.4505 | 36.9905 | 0 | MOSFET (P-Channel) - low RDS on
dTP10_Q1 | P-MOSFET | TopLayer | SOTFL95P240X88-3N | 54.0505 | 36.9905 | 180 | MOSFET (P-Channel) - low RDS on
dTP9_Q2 | P-MOSFET | TopLayer | SOTFL95P240X88-3N | 45.1063 | 45.0033 | 0 | MOSFET (P-Channel) - low RDS on
dTP9_Q1 | P-MOSFET | TopLayer | SOTFL95P240X88-3N | 48.7063 | 45.0033 | 180 | MOSFET (P-Channel) - low RDS on
dTP8_Q2 | P-MOSFET | TopLayer | SOTFL95P240X88-3N | 39.9095 | 36.9905 | 0 | MOSFET (P-Channel) - low RDS on
dTP8_Q1 | P-MOSFET | TopLayer | SOTFL95P240X88-3N | 43.5095 | 36.9905 | 180 | MOSFET (P-Channel) - low RDS on
dTP7_Q2 | P-MOSFET | TopLayer | SOTFL95P240X88-3N | 34.5399 | 45.0033 | 0 | MOSFET (P-Channel) - low RDS on
dTP7_Q1 | P-MOSFET | TopLayer | SOTFL95P240X88-3N | 38.1399 | 45.0033 | 180 | MOSFET (P-Channel) - low RDS on
dTP6_Q2 | P-MOSFET | TopLayer | SOTFL95P240X88-3N | 29.3685 | 36.9905 | 0 | MOSFET (P-Channel) - low RDS on
dTP6_Q1 | P-MOSFET | TopLayer | SOTFL95P240X88-3N | 32.9685 | 36.9905 | 180 | MOSFET (P-Channel) - low RDS on
dTP5_Q2 | P-MOSFET | TopLayer | SOTFL95P240X88-3N | 23.9409 | 45.0093 | 0 | MOSFET (P-Channel) - low RDS on
dTP5_Q1 | P-MOSFET | TopLayer | SOTFL95P240X88-3N | 27.5409 | 45.0093 | 180 | MOSFET (P-Channel) - low RDS on
dTP4_Q2 | P-MOSFET | TopLayer | SOTFL95P240X88-3N | 18.7755 | 37.0159 | 0 | MOSFET (P-Channel) - low RDS on
dTP4_Q1 | P-MOSFET | TopLayer | SOTFL95P240X88-3N | 22.3755 | 37.0159 | 180 | MOSFET (P-Channel) - low RDS on
dTP3_Q2 | P-MOSFET | TopLayer | SOTFL95P240X88-3N | 13.3817 | 45.0287 | 0 | MOSFET (P-Channel) - low RDS on
dTP3_Q1 | P-MOSFET | TopLayer | SOTFL95P240X88-3N | 16.9817 | 45.0287 | 180 | MOSFET (P-Channel) - low RDS on
SSM3J358R,LF Toshiba | Mouser Česká Republika (https://cz.mouser.com/ProductDetail/Toshiba/SSM3J358RLF?qs=HXFqYaX1Q2xwvCtt1GGmkw%3D%3D) |  |  |  |  |  | Počet na 1 desku | 80

Sheet: PICKPLACE3
Designator | Comment | Layer | Footprint | Center-X(mm) | Center-Y(mm) | Rotation | Description
dTP2_Q4 | NMOS | TopLayer | SOT95P240X110-3N | 12.1591 | 32.3659 | 180 | N-Channel MOSFET Transistor PJA3432_R1_00001
dTP2_Q3 | NMOS | TopLayer | SOT95P240X110-3N | 7.9091 | 32.3659 | 0 | N-Channel MOSFET Transistor PJA3432_R1_00001
dTP1_Q3 | NMOS | TopLayer | SOT95P240X110-3N | 2.5336 | 40.3872 | 0 | N-Channel MOSFET Transistor PJA3432_R1_00001
dTP1_Q4 | NMOS | TopLayer | SOT95P240X110-3N | 6.7837 | 40.3872 | 180 | N-Channel MOSFET Transistor PJA3432_R1_00001
dTP40_Q4 | NMOS | TopLayer | SOT95P240X110-3N | 212.6933 | 32.3405 | 180 | N-Channel MOSFET Transistor PJA3432_R1_00001
dTP40_Q3 | NMOS | TopLayer | SOT95P240X110-3N | 208.4433 | 32.3405 | 0 | N-Channel MOSFET Transistor PJA3432_R1_00001
dTP39_Q4 | NMOS | TopLayer | SOT95P240X110-3N | 207.5523 | 40.3533 | 180 | N-Channel MOSFET Transistor PJA3432_R1_00001
dTP39_Q3 | NMOS | TopLayer | SOT95P240X110-3N | 203.3023 | 40.3533 | 0 | N-Channel MOSFET Transistor PJA3432_R1_00001
dTP38_Q4 | NMOS | TopLayer | SOT95P240X110-3N | 202.1269 | 32.3405 | 180 | N-Channel MOSFET Transistor PJA3432_R1_00001
dTP38_Q3 | NMOS | TopLayer | SOT95P240X110-3N | 197.8769 | 32.3405 | 0 | N-Channel MOSFET Transistor PJA3432_R1_00001
dTP37_Q4 | NMOS | TopLayer | SOT95P240X110-3N | 196.9859 | 40.3533 | 180 | N-Channel MOSFET Transistor PJA3432_R1_00001
dTP37_Q3 | NMOS | TopLayer | SOT95P240X110-3N | 192.7359 | 40.3533 | 0 | N-Channel MOSFET Transistor PJA3432_R1_00001
dTP36_Q4 | NMOS | TopLayer | SOT95P240X110-3N | 191.5859 | 32.3405 | 180 | N-Channel MOSFET Transistor PJA3432_R1_00001
dTP36_Q3 | NMOS | TopLayer | SOT95P240X110-3N | 187.3359 | 32.3405 | 0 | N-Channel MOSFET Transistor PJA3432_R1_00001
dTP35_Q4 | NMOS | TopLayer | SOT95P240X110-3N | 186.4195 | 40.3533 | 180 | N-Channel MOSFET Transistor PJA3432_R1_00001
dTP35_Q3 | NMOS | TopLayer | SOT95P240X110-3N | 182.1695 | 40.3533 | 0 | N-Channel MOSFET Transistor PJA3432_R1_00001
dTP34_Q4 | NMOS | TopLayer | SOT95P240X110-3N | 181.0195 | 32.3405 | 180 | N-Channel MOSFET Transistor PJA3432_R1_00001
dTP34_Q3 | NMOS | TopLayer | SOT95P240X110-3N | 176.7695 | 32.3405 | 0 | N-Channel MOSFET Transistor PJA3432_R1_00001
dTP33_Q4 | NMOS | TopLayer | SOT95P240X110-3N | 175.8531 | 40.3533 | 180 | N-Channel MOSFET Transistor PJA3432_R1_00001
dTP33_Q3 | NMOS | TopLayer | SOT95P240X110-3N | 171.6031 | 40.3533 | 0 | N-Channel MOSFET Transistor PJA3432_R1_00001
dTP32_Q4 | NMOS | TopLayer | SOT95P240X110-3N | 170.4785 | 32.3405 | 180 | N-Channel MOSFET Transistor PJA3432_R1_00001
dTP32_Q3 | NMOS | TopLayer | SOT95P240X110-3N | 166.2285 | 32.3405 | 0 | N-Channel MOSFET Transistor PJA3432_R1_00001
dTP31_Q4 | NMOS | TopLayer | SOT95P240X110-3N | 165.2867 | 40.3533 | 180 | N-Channel MOSFET Transistor PJA3432_R1_00001
dTP31_Q3 | NMOS | TopLayer | SOT95P240X110-3N | 161.0367 | 40.3533 | 0 | N-Channel MOSFET Transistor PJA3432_R1_00001
dTP30_Q4 | NMOS | TopLayer | SOT95P240X110-3N | 159.9375 | 32.3405 | 180 | N-Channel MOSFET Transistor PJA3432_R1_00001
dTP30_Q3 | NMOS | TopLayer | SOT95P240X110-3N | 155.6875 | 32.3405 | 0 | N-Channel MOSFET Transistor PJA3432_R1_00001
dTP29_Q4 | NMOS | TopLayer | SOT95P240X110-3N | 154.7203 | 40.3533 | 180 | N-Channel MOSFET Transistor PJA3432_R1_00001
dTP29_Q3 | NMOS | TopLayer | SOT95P240X110-3N | 150.4703 | 40.3533 | 0 | N-Channel MOSFET Transistor PJA3432_R1_00001
dTP28_Q4 | NMOS | TopLayer | SOT95P240X110-3N | 149.3711 | 32.3405 | 180 | N-Channel MOSFET Transistor PJA3432_R1_00001
dTP28_Q3 | NMOS | TopLayer | SOT95P240X110-3N | 145.1211 | 32.3405 | 0 | N-Channel MOSFET Transistor PJA3432_R1_00001
dTP27_Q4 | NMOS | TopLayer | SOT95P240X110-3N | 144.1539 | 40.3533 | 180 | N-Channel MOSFET Transistor PJA3432_R1_00001
dTP27_Q3 | NMOS | TopLayer | SOT95P240X110-3N | 139.9039 | 40.3533 | 0 | N-Channel MOSFET Transistor PJA3432_R1_00001
dTP26_Q4 | NMOS | TopLayer | SOT95P240X110-3N | 138.8301 | 32.3405 | 180 | N-Channel MOSFET Transistor PJA3432_R1_00001
dTP26_Q3 | NMOS | TopLayer | SOT95P240X110-3N | 134.5801 | 32.3405 | 0 | N-Channel MOSFET Transistor PJA3432_R1_00001
dTP25_Q4 | NMOS | TopLayer | SOT95P240X110-3N | 133.5875 | 40.3533 | 180 | N-Channel MOSFET Transistor PJA3432_R1_00001
dTP25_Q3 | NMOS | TopLayer | SOT95P240X110-3N | 129.3375 | 40.3533 | 0 | N-Channel MOSFET Transistor PJA3432_R1_00001
dTP24_Q4 | NMOS | TopLayer | SOT95P240X110-3N | 128.2637 | 32.3405 | 180 | N-Channel MOSFET Transistor PJA3432_R1_00001
dTP24_Q3 | NMOS | TopLayer | SOT95P240X110-3N | 124.0137 | 32.3405 | 0 | N-Channel MOSFET Transistor PJA3432_R1_00001
dTP23_Q4 | NMOS | TopLayer | SOT95P240X110-3N | 123.0211 | 40.3533 | 180 | N-Channel MOSFET Transistor PJA3432_R1_00001
dTP23_Q3 | NMOS | TopLayer | SOT95P240X110-3N | 118.7711 | 40.3533 | 0 | N-Channel MOSFET Transistor PJA3432_R1_00001
dTP22_Q4 | NMOS | TopLayer | SOT95P240X110-3N | 117.7227 | 32.3405 | 180 | N-Channel MOSFET Transistor PJA3432_R1_00001
dTP22_Q3 | NMOS | TopLayer | SOT95P240X110-3N | 113.4727 | 32.3405 | 0 | N-Channel MOSFET Transistor PJA3432_R1_00001
dTP21_Q4 | NMOS | TopLayer | SOT95P240X110-3N | 112.4547 | 40.3533 | 180 | N-Channel MOSFET Transistor PJA3432_R1_00001
dTP21_Q3 | NMOS | TopLayer | SOT95P240X110-3N | 108.2047 | 40.3533 | 0 | N-Channel MOSFET Transistor PJA3432_R1_00001
dTP20_Q4 | NMOS | TopLayer | SOT95P240X110-3N | 107.1563 | 32.3405 | 180 | N-Channel MOSFET Transistor PJA3432_R1_00001
dTP20_Q3 | NMOS | TopLayer | SOT95P240X110-3N | 102.9063 | 32.3405 | 0 | N-Channel MOSFET Transistor PJA3432_R1_00001
dTP19_Q4 | NMOS | TopLayer | SOT95P240X110-3N | 101.8883 | 40.3533 | 180 | N-Channel MOSFET Transistor PJA3432_R1_00001
dTP19_Q3 | NMOS | TopLayer | SOT95P240X110-3N | 97.6383 | 40.3533 | 0 | N-Channel MOSFET Transistor PJA3432_R1_00001
dTP18_Q4 | NMOS | TopLayer | SOT95P240X110-3N | 96.6153 | 32.3405 | 180 | N-Channel MOSFET Transistor PJA3432_R1_00001
dTP18_Q3 | NMOS | TopLayer | SOT95P240X110-3N | 92.3653 | 32.3405 | 0 | N-Channel MOSFET Transistor PJA3432_R1_00001
dTP17_Q4 | NMOS | TopLayer | SOT95P240X110-3N | 91.3219 | 40.3533 | 180 | N-Channel MOSFET Transistor PJA3432_R1_00001
dTP17_Q3 | NMOS | TopLayer | SOT95P240X110-3N | 87.0719 | 40.3533 | 0 | N-Channel MOSFET Transistor PJA3432_R1_00001
dTP16_Q4 | NMOS | TopLayer | SOT95P240X110-3N | 86.0743 | 32.3405 | 180 | N-Channel MOSFET Transistor PJA3432_R1_00001
dTP16_Q3 | NMOS | TopLayer | SOT95P240X110-3N | 81.8243 | 32.3405 | 0 | N-Channel MOSFET Transistor PJA3432_R1_00001
dTP15_Q4 | NMOS | TopLayer | SOT95P240X110-3N | 80.7555 | 40.3533 | 180 | N-Channel MOSFET Transistor PJA3432_R1_00001
dTP15_Q3 | NMOS | TopLayer | SOT95P240X110-3N | 76.5055 | 40.3533 | 0 | N-Channel MOSFET Transistor PJA3432_R1_00001
dTP14_Q4 | NMOS | TopLayer | SOT95P240X110-3N | 75.5079 | 32.3405 | 180 | N-Channel MOSFET Transistor PJA3432_R1_00001
dTP14_Q3 | NMOS | TopLayer | SOT95P240X110-3N | 71.2579 | 32.3405 | 0 | N-Channel MOSFET Transistor PJA3432_R1_00001
dTP13_Q4 | NMOS | TopLayer | SOT95P240X110-3N | 70.1891 | 40.3533 | 180 | N-Channel MOSFET Transistor PJA3432_R1_00001
dTP13_Q3 | NMOS | TopLayer | SOT95P240X110-3N | 65.9391 | 40.3533 | 0 | N-Channel MOSFET Transistor PJA3432_R1_00001
dTP12_Q4 | NMOS | TopLayer | SOT95P240X110-3N | 64.9669 | 32.3405 | 180 | N-Channel MOSFET Transistor PJA3432_R1_00001
dTP12_Q3 | NMOS | TopLayer | SOT95P240X110-3N | 60.7169 | 32.3405 | 0 | N-Channel MOSFET Transistor PJA3432_R1_00001
dTP11_Q4 | NMOS | TopLayer | SOT95P240X110-3N | 59.6227 | 40.3533 | 180 | N-Channel MOSFET Transistor PJA3432_R1_00001
dTP11_Q3 | NMOS | TopLayer | SOT95P240X110-3N | 55.3727 | 40.3533 | 0 | N-Channel MOSFET Transistor PJA3432_R1_00001
dTP10_Q4 | NMOS | TopLayer | SOT95P240X110-3N | 54.4005 | 32.3405 | 180 | N-Channel MOSFET Transistor PJA3432_R1_00001
dTP10_Q3 | NMOS | TopLayer | SOT95P240X110-3N | 50.1505 | 32.3405 | 0 | N-Channel MOSFET Transistor PJA3432_R1_00001
dTP9_Q4 | NMOS | TopLayer | SOT95P240X110-3N | 49.0563 | 40.3533 | 180 | N-Channel MOSFET Transistor PJA3432_R1_00001
dTP9_Q3 | NMOS | TopLayer | SOT95P240X110-3N | 44.8063 | 40.3533 | 0 | N-Channel MOSFET Transistor PJA3432_R1_00001
dTP8_Q4 | NMOS | TopLayer | SOT95P240X110-3N | 43.8595 | 32.3405 | 180 | N-Channel MOSFET Transistor PJA3432_R1_00001
dTP8_Q3 | NMOS | TopLayer | SOT95P240X110-3N | 39.6095 | 32.3405 | 0 | N-Channel MOSFET Transistor PJA3432_R1_00001
dTP7_Q4 | NMOS | TopLayer | SOT95P240X110-3N | 38.4899 | 40.3533 | 180 | N-Channel MOSFET Transistor PJA3432_R1_00001
dTP7_Q3 | NMOS | TopLayer | SOT95P240X110-3N | 34.2399 | 40.3533 | 0 | N-Channel MOSFET Transistor PJA3432_R1_00001
dTP6_Q4 | NMOS | TopLayer | SOT95P240X110-3N | 33.3185 | 32.3405 | 180 | N-Channel MOSFET Transistor PJA3432_R1_00001
dTP6_Q3 | NMOS | TopLayer | SOT95P240X110-3N | 29.0685 | 32.3405 | 0 | N-Channel MOSFET Transistor PJA3432_R1_00001
dTP5_Q4 | NMOS | TopLayer | SOT95P240X110-3N | 27.8909 | 40.3593 | 180 | N-Channel MOSFET Transistor PJA3432_R1_00001
dTP5_Q3 | NMOS | TopLayer | SOT95P240X110-3N | 23.6409 | 40.3593 | 0 | N-Channel MOSFET Transistor PJA3432_R1_00001
dTP4_Q4 | NMOS | TopLayer | SOT95P240X110-3N | 22.7255 | 32.3659 | 180 | N-Channel MOSFET Transistor PJA3432_R1_00001
dTP4_Q3 | NMOS | TopLayer | SOT95P240X110-3N | 18.4755 | 32.3659 | 0 | N-Channel MOSFET Transistor PJA3432_R1_00001
dTP3_Q4 | NMOS | TopLayer | SOT95P240X110-3N | 17.3317 | 40.3787 | 180 | N-Channel MOSFET Transistor PJA3432_R1_00001
dTP3_Q3 | NMOS | TopLayer | SOT95P240X110-3N | 13.0817 | 40.3787 | 0 | N-Channel MOSFET Transistor PJA3432_R1_00001
PJA3432_R1_00001 Panjit | Mouser Česká Republika (https://cz.mouser.com/ProductDetail/Panjit/PJA3432_R1_00001?qs=sPbYRqrBIVmGu%2F98hdrYZA%3D%3D) |  |  |  |  |  | Počet na 1 desku | 80

Sheet: PICKPLACE4
Designator | Comment | Layer | Footprint | Center-X(mm) | Center-Y(mm) | Rotation | Description
J22 | 87833-5019 | TopLayer | SHDRRA50W55P200_2X25_5265X640X630P | 110.5000 | 6.1750 | 180 | Connector
87833-5019 Molex | Mouser Česká Republika (https://cz.mouser.com/ProductDetail/Molex/87833-5019?qs=Vr3ZXvgdfhbSPmsYnBrhlw%3D%3D) |  |  |  |  |  | Počet na 1 desku | 1
Designator | Comment | Layer | Footprint | Center-X(mm) | Center-Y(mm) | Rotation | Description
P2 | 5-146280-2 | TopLayer | 2.54MM_HEADER_3X1 | 197.6410 | 57.6656 | 90 | Male Header
P1 | 5-146280-2 | TopLayer | 2.54MM_HEADER_3X1 | 203.0364 | 4.6189 | 90 | Male Header
5-146280-2 TE Connectivity | Mouser Česká Republika (https://cz.mouser.com/ProductDetail/TE-Connectivity/5-146280-2?qs=bwpFY26eRVcxHP%252BQexhLNQ%3D%3D) |  |  |  |  |  | Počet na 1 desku | 2
Designator | Comment | Layer | Footprint | Center-X(mm) | Center-Y(mm) | Rotation | Description
R2 | 50k | TopLayer | RESC1005X40X25NL05T05 | 199.7470 | 55.1754 | 270
R1 | 50k | TopLayer | RESC1005X40X25NL05T05 | 206.3383 | 1.2012 | 180
R16 | 50k | TopLayer | RESC1005X40X25NL05T05 | 211.0143 | 51.8196 | 0
R10 | 50k | TopLayer | RESC1005X40X25NL05T05 | 205.9280 | 3.3489 | 270
CRCW040250K0FKED Vishay / Dale | Mouser Česká Republika (https://cz.mouser.com/ProductDetail/Vishay-Dale/CRCW040250K0FKED?qs=ZTJSYgkXUA0CX%252BZe0ESa5A%3D%3D) |  |  |  |  |  | Počet na 1 desku | 4
