FilipPaul/DIPLOMKA/(list of files, cad)

Other CAD files:
PSCM_7Fold_STA3/test_line.dxf
