FilipPaul/DIPLOMKA/measuredMatrix/1793_1796/Tester1/WIRELIST.TXT

  * fixture 9_10_07 *

/N0003    #0428 #0429;
/N0004    #0433 #0434;
/N0005    #0468 #0466 #0462 #0459 #0456 #0458;
/N0006    #0627 #0705;
/N0007    #0849 #0923;
/N0008    #0019 #0020 #0677 #0678 #0684 #0762 #0839 #0918,
          #0996 #0761 #0683 #0917 #0833 #0834;
/N0009    #0040 #0059 #0060 #0118 #0098 #0176 #0215 #0742,
          #0741 #0722 #0721 #0898 #0897 #0878 #0877 #0955,
          #0956 #0971 #0039 #0137 #0097 #0117 #0175 #0216,
          #0138 #0643 #0644 #0663 #0664 #0799 #0800 #0819,
          #0820 #0840 #0975 #0976 #0995 #0195 #0196 #0273,
          #0253 #0254 #0274 #0293 #0294 #0352 #0332 #0331,
          #0442 #0450 #0371 #0372 #0448 #0444 #0507 #0487,
          #0508 #0527 #0528 #0488 #0606 #0605 #0586 #0585,
          #0566 #0565 #0985 #0989 #0991;
/N0011    #0905 #0904;
/N0012    #0829 #0902;
/N0013    #0818 #0830;
/N0014    #0827 #0903;
/N0015    #0452 #0906 #0987;
/N0016    #0899 #0890;
/N0018    #0808 #0809;
/N0019    #0886 #0883;
/N0020    #0853 #0931;
/N0021    #0851 #0929;
/N0022    #0913 #0912;
/N0023    #0810 #0811;
/N0024    #0881 #0880;
/N0025    #0453 #0930;
/N0026    #0852 #0988;
/N0027    #0842 #0992;
/N0028    #0814 #0892;
/N0029    #0115 #0451;
/N0030    #0449 #0596;
/N0031    #0374 #0445;
/N0032    #0139 #0990;
/N0033    #0126 #0986;
/N0034    #0373 #0443;
/N0035    #0646 #0724;
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
