FilipPaul/DIPLOMKA/measuredMatrix/1893_1896/Tester3/WIRELIST.TXT

  * 1893_1896 *

/N0001    #0072 #0071;
/N0002    #0073 #0075 #0074;
/N0003    #0584 #0585;
/N0004    #0589 #0590;
/N0005    #0624 #0622 #0618 #0614 #0615;
/N0006    #0369 #0600;
/N0007    #0452 #0608;
/N0008    #0506 #0594;
/N0009    #0428 #0598;
/N0010    #0097 #0098 #0118 #0117 #0138 #0216 #0215 #0176,
          #0175 #0254 #0273 #0196 #0274 #0372 #0664 #0684,
          #0722 #0721 #0799 #0819 #0761 #0917 #0898 #0897,
          #0878 #0877 #0955 #0984 #0996 #0998 #0137 #0195,
          #0371 #0050 #0049 #0293 #0294 #0253 #0643 #0644,
          #0663 #0683 #0741 #0800 #0820 #0839 #0956 #0351,
          #0449 #0352 #0450 #0430 #0429 #0409 #0487 #0488,
          #0508 #0595 #0609 #0602 #0601 #0599 #0507 #0975,
         ;
/N0011    #0023 #0679 #0680 #0742 #0762 #0995 #0840 #0918,
          #0976 #0017 #0773 #0772;
/N0012    #0013 #0014;
/N0013    #0808 #0886;
/N0014    #0698 #0699;
/N0015    #0776 #0833;
/N0016    #0775 #0838;
/N0017    #0774 #0835;
/N0018    #0696 #0987 #0989;
/N0019    #0844 #0921;
/N0020    #0636 #0714;
/N0021    #0635 #0713;
/N0022    #0630 #0709;
/N0023    #0018 #0638 #0717;
/N0024    #0015 #0016;
/N0025    #0632 #0711;
/N0026    #0826 #0990;
/N0027    #0827 #0988;
/N0028    #0830 #0831;
/N0029    #0451 #0603;
/N0030    #0807 #0887;
/N0031    #0367 #0993;
/N0032    #0295 #0997;
/N0033    #0350 #0985;
/N0034    #0272 #0983;
/N0035    #0019 #0020;
/N0036    #0986 #0991 #0994;
/N0037    #0656 #0657;
/N0038    #0760 #0757;
/N0039    #0677 #0764;
/N0040    #0686 #0763;
/N0041    #0678 #0753;
/N0042    #0758 #0979 #0981;
/N0043    #0642 #0726;
/N0044    #0024 #0648 #0725;
/N0045    #0021 #0022;
/N0046    #0655 #0734;
/N0047    #0650 #0727;
/N0048    #0641 #0738;
/N0049    #0737 #0736;
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
