FilipPaul/DIPLOMKA/tex/aktualni_19_05_2023/obrazky/matlab_generated/VOLTAGE_TESTER/output_log_calibrated.txt

0.7482900619506836,3679.000000,3554.000000,3019.000000,2643.000000,1152.000000,297.000000,-2,1233.000000,2.99513513
1.4954063892364502,3678.000000,3552.000000,3020.000000,2643.000000,1152.000000,296.000000,-2,1238.000000,2.99513856
2.249568223953247,3679.000000,3553.000000,3020.000000,2643.000000,1152.000000,296.000000,-2,1236.000000,2.99514036
2.9987733364105225,3678.000000,3553.000000,3021.000000,2643.000000,1151.000000,297.000000,-2,1240.000000,2.99515318
3.745415687561035,3678.000000,3553.000000,3019.000000,2641.000000,1151.000000,297.000000,-2,1237.000000,2.99514902
4.4950666427612305,3679.000000,3555.000000,3020.000000,2644.000000,1152.000000,296.000000,-2,1237.000000,2.99513654
5.243968963623047,3678.000000,3554.000000,3021.000000,2643.000000,1152.000000,295.000000,-2,1239.000000,2.99513296
5.996350288391113,3678.000000,3554.000000,3020.000000,2644.000000,1151.000000,297.000000,-2,1237.000000,2.99513626
6.742673635482788,3678.000000,3553.000000,3020.000000,2642.000000,1150.000000,297.000000,-2,1240.000000,2.99512666
7.492225885391235,3678.000000,3553.000000,3019.000000,2643.000000,1152.000000,297.000000,-2,1235.000000,2.99512217
8.242064952850342,3678.000000,3553.000000,3020.000000,2643.000000,1151.000000,298.000000,-2,1238.000000,2.9951091
8.991276025772095,3677.000000,3553.000000,3018.000000,2643.000000,1151.000000,297.000000,-2,1235.000000,2.99510131
9.73932433128357,3677.000000,3552.000000,3019.000000,2642.000000,1151.000000,296.000000,-2,1237.000000,2.99509502
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
29.226551294326782,3678.000000,3552.000000,3019.000000,2641.000000,1152.000000,297.000000,-2,1236.000000,2.9950957
29.972962379455566,3678.000000,3552.000000,3019.000000,2643.000000,1151.000000,296.000000,-2,1240.000000,2.99508829
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
