FilipPaul/DIPLOMKA/tex/sablona-cze/obrazky/matlab_generated/VOLTAGE_TESTER/calib_resistor_part2-eps-converted-to.pdf

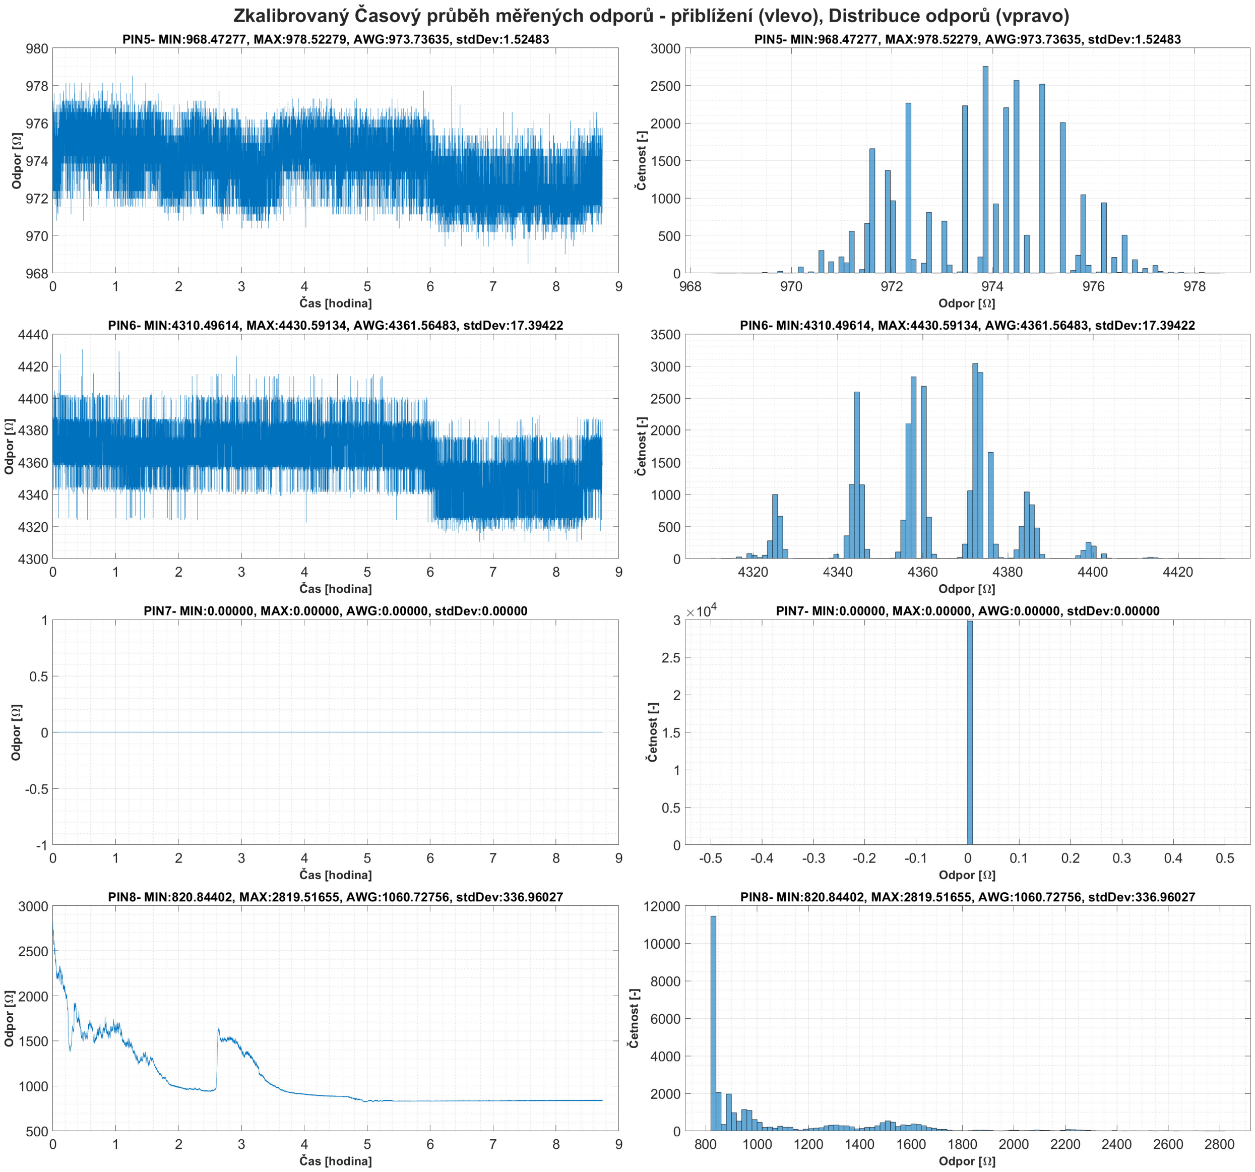
[picture p72: page 1]
