FilipPaul/DIPLOMKA/tex/sablona-cze/obrazky/matlab_generated/VOLTAGE_TESTER/dlouhodoba_stabilita_calibrated_voltage_part1-eps-converted-to.pdf

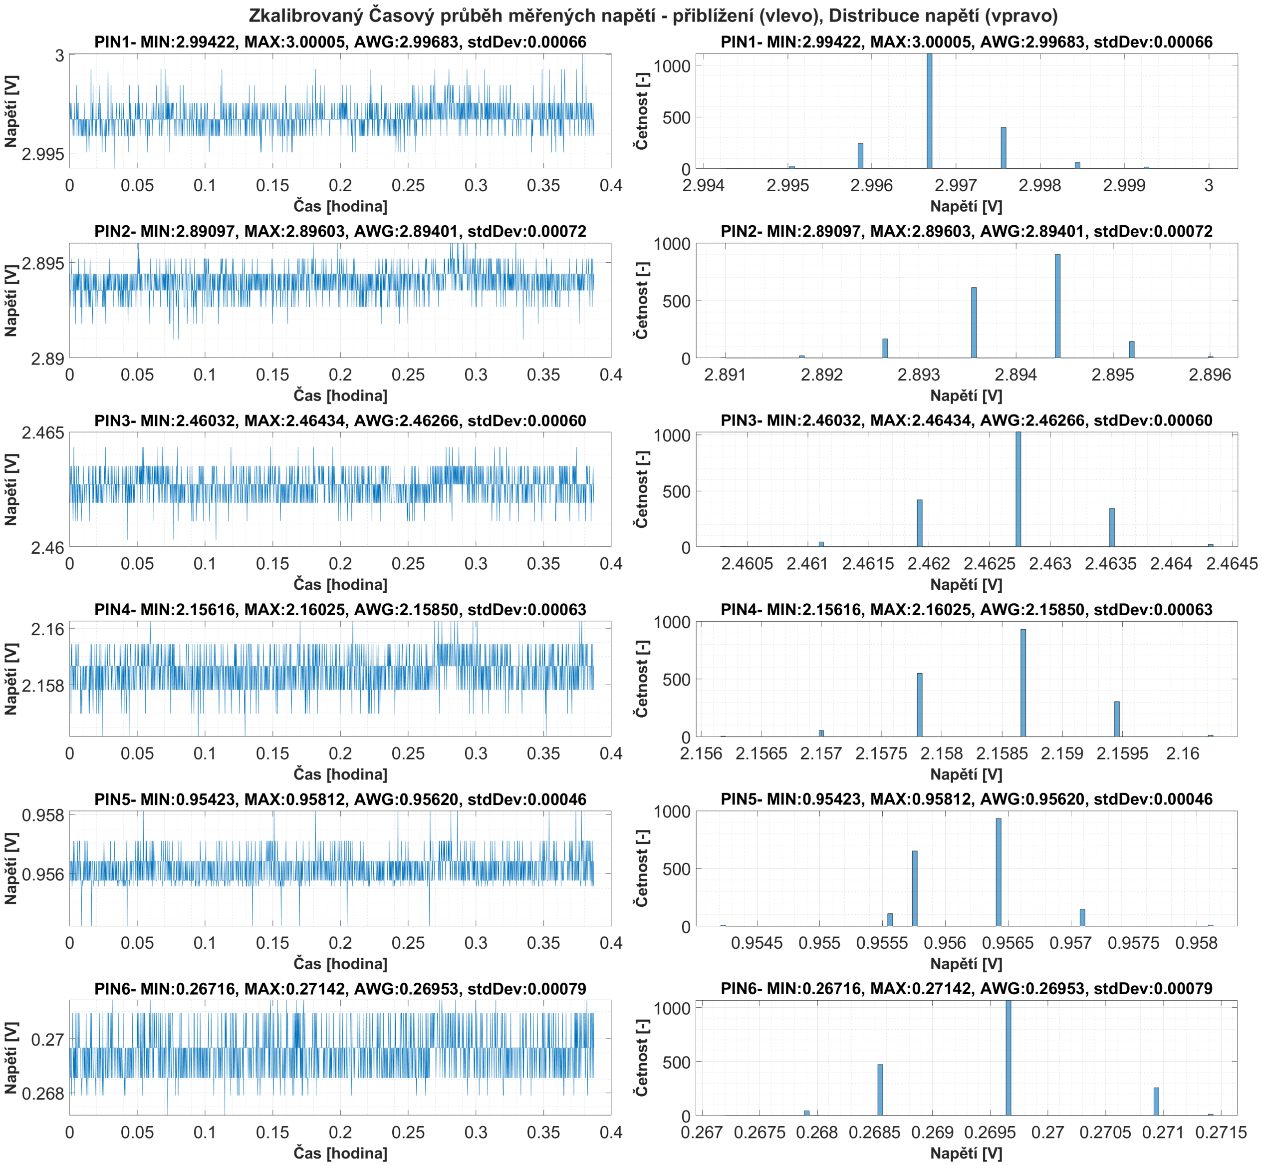
[picture p73: page 1]
