FilipPaul/DIPLOMKA/tex/sablona-cze/obrazky/matlab_generated/VOLTAGE_TESTER/dlouhodoba_stabilita_resistor_part1_obhj-eps-converted-to.pdf

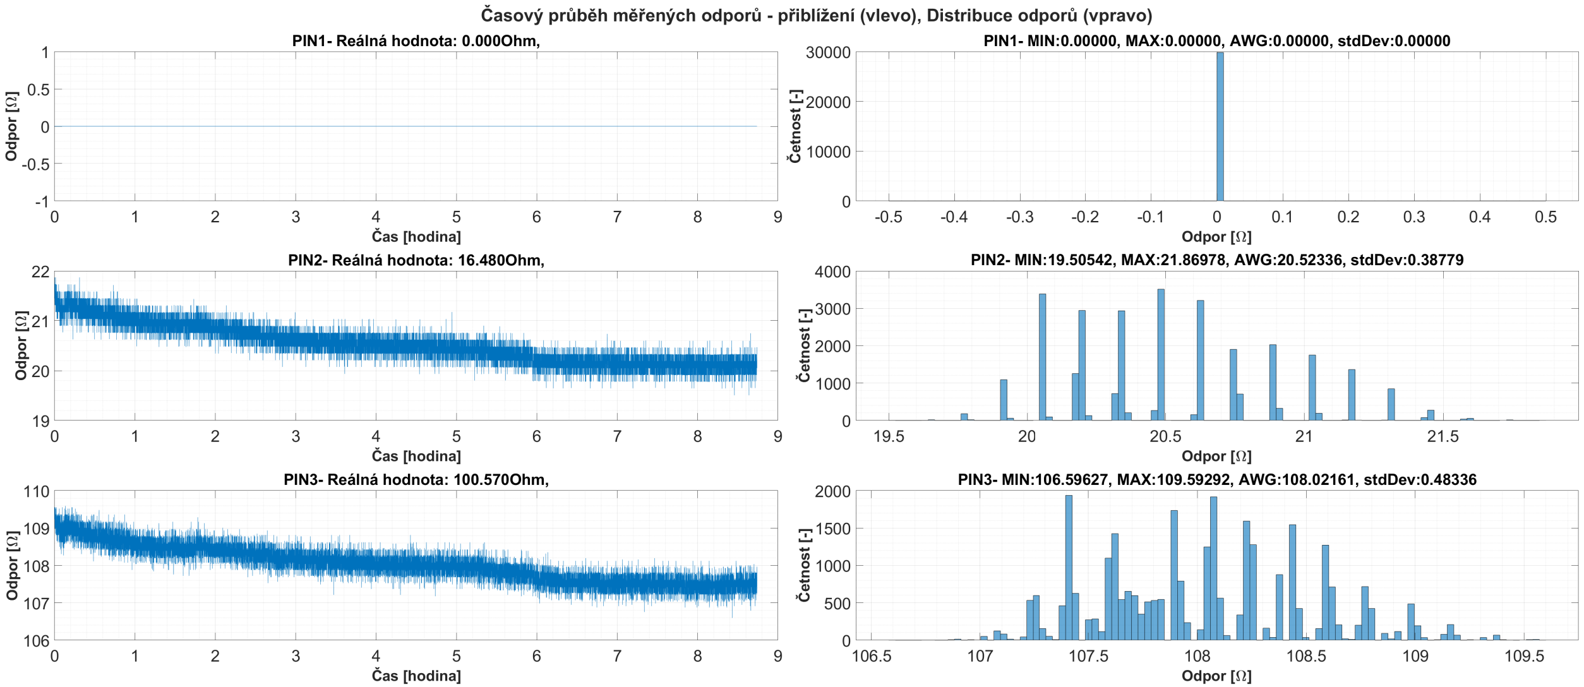
[picture p74: page 1]
