FilipPaul/DIPLOMKA/tex/aktualni_19_05_2023/obrazky/matlab_generated/VOLTAGE_TESTER/calib_resistor_part1-eps-converted-to.pdf

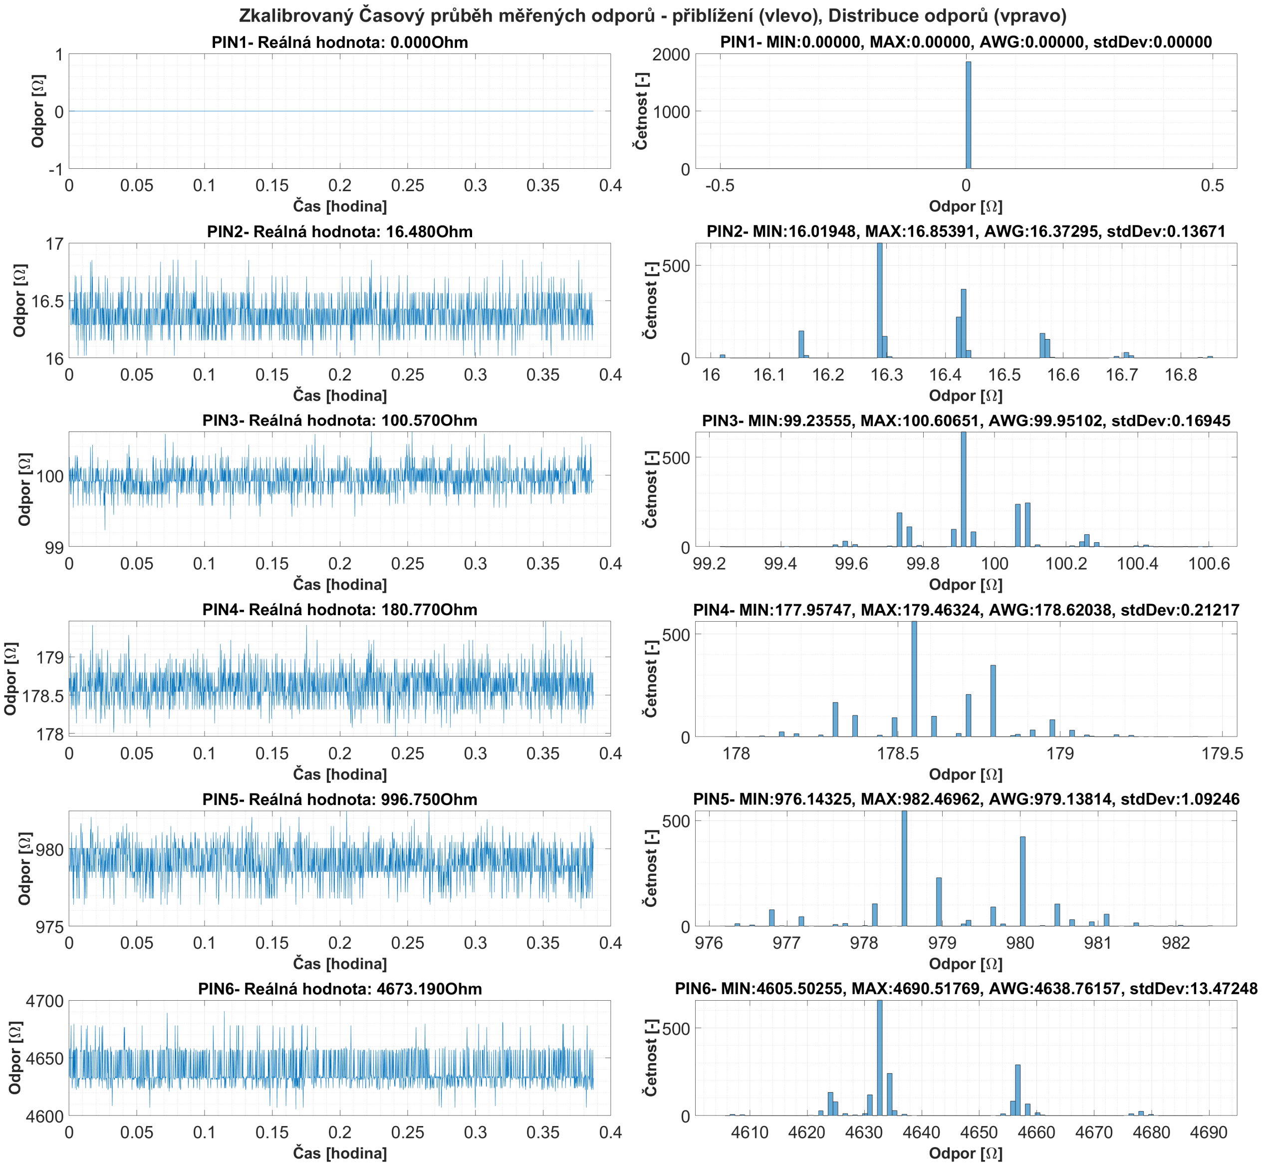
[picture p75: page 1]
