FilipPaul/DIPLOMKA/tex/aktualni_19_05_2023/obrazky/matlab_generated/VOLTAGE_TESTER/dlouhodoba_stabilita_cas_prehled-eps-converted-to.pdf

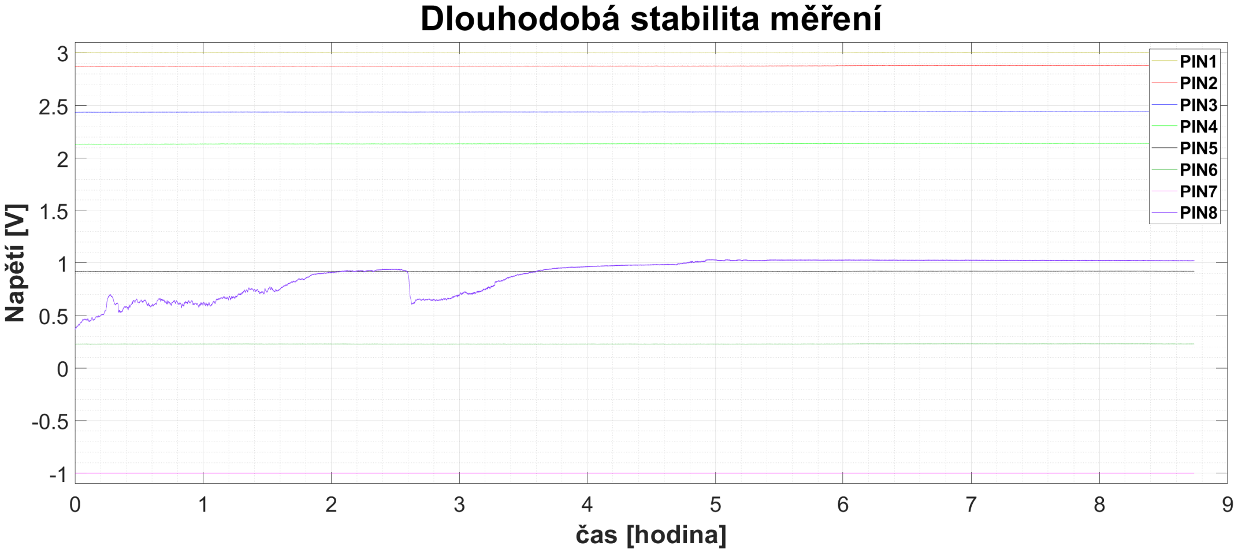
[picture p76: page 1]
