FilipPaul/DIPLOMKA/tex/aktualni_19_05_2023/obrazky/matlab_generated/VOLTAGE_TESTER/dlouhodoba_stabilita_resistor_part2-eps-converted-to.pdf

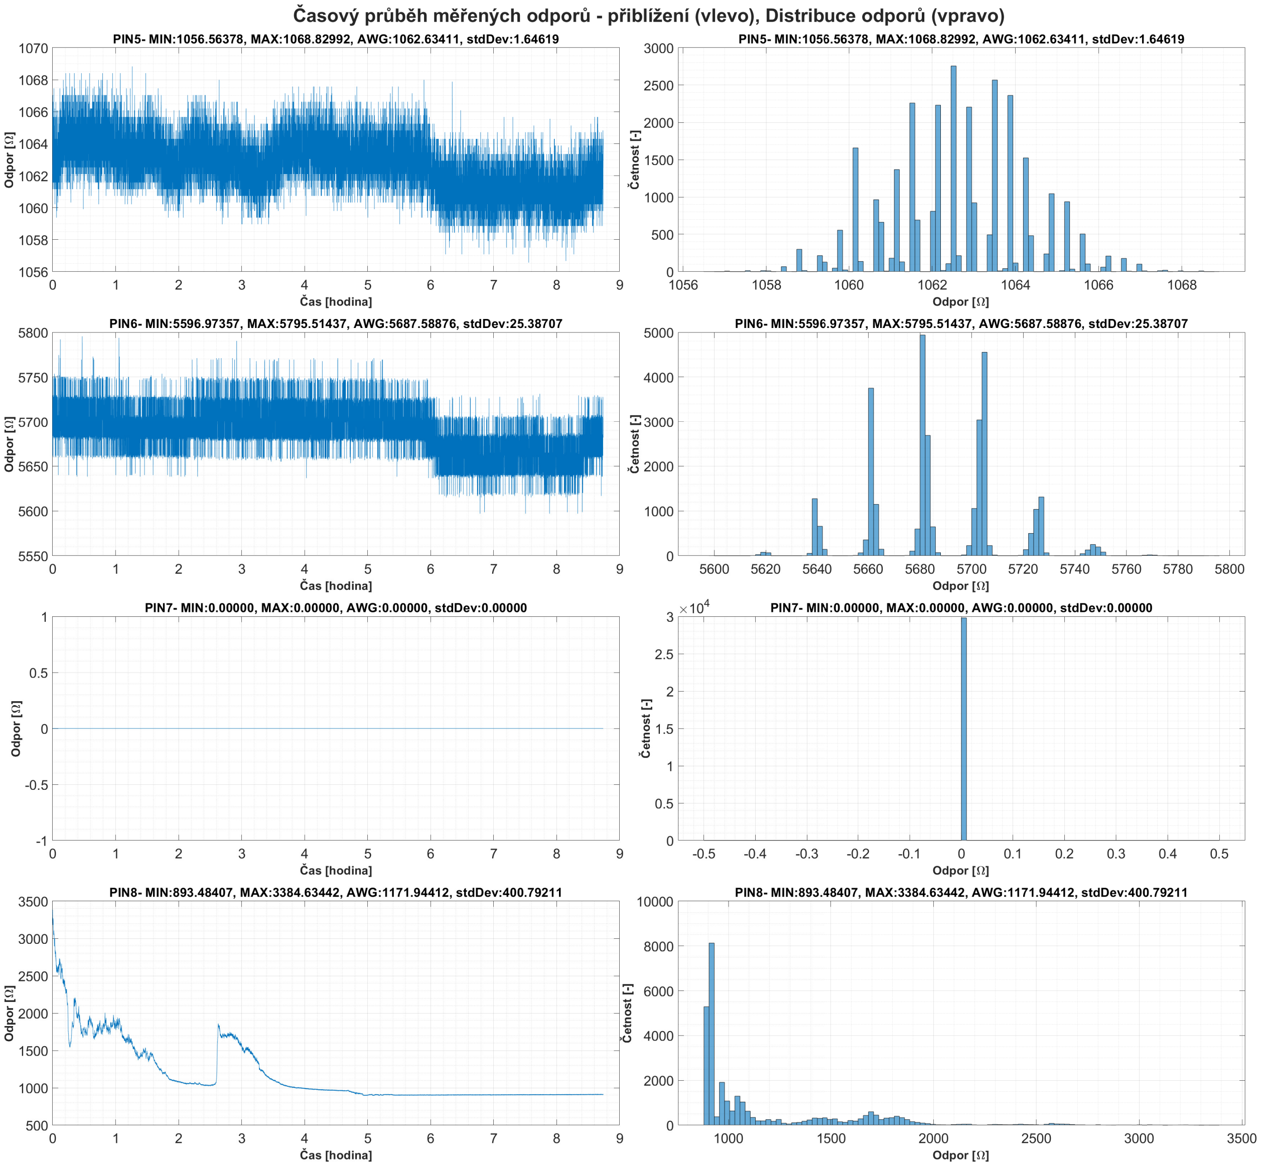
[picture p78: page 1]
