FilipPaul/DIPLOMKA/tex/aktualni_19_05_2023/obrazky/matlab_generated/VOLTAGE_TESTER/dlouhodoba_stabilita_voltage_part1-eps-converted-to.pdf

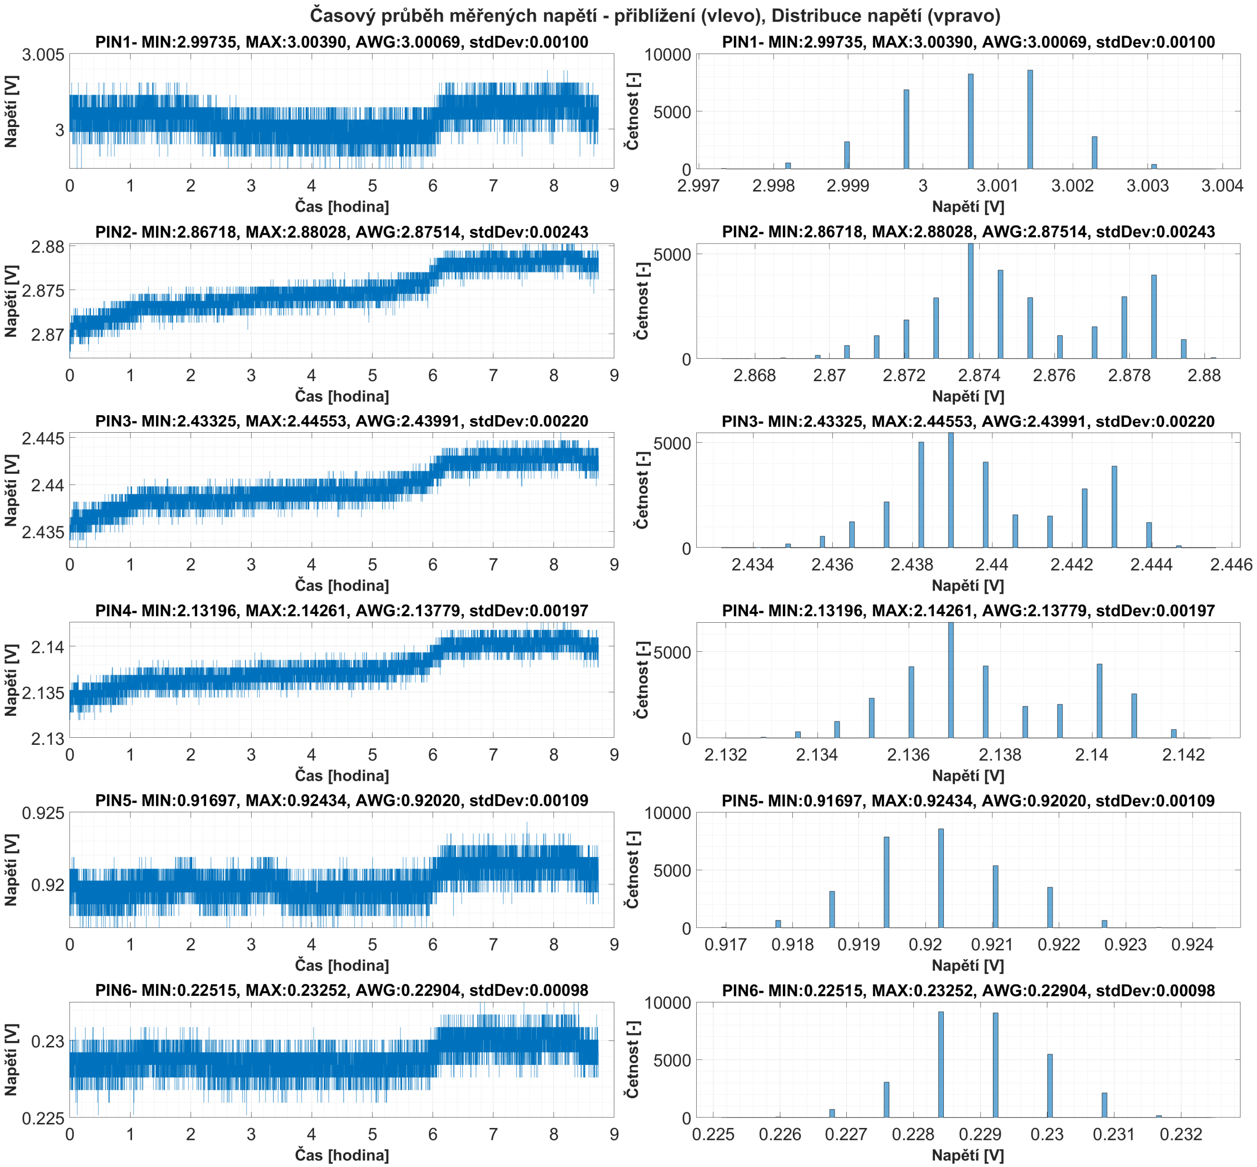
[picture p79: page 1]
