FilipPaul/DIPLOMKA/tex/aktualni_19_05_2023/obrazky/matlab_generated/VOLTAGE_TESTER/DMM DataLog-PIN1_0.csv

Product | GWInstek | GDM9061 | GEW921489 | 1.12 | 1.14
FileName | DMM DataLog-DMM DataLog-PIN1.csv_0.csv
Function(1ST) | DC Voltage | 100/s
Function(2ND) | OFF | NONE
LogUnit | Auto
MathFunction | Off
Interval | 00:00:00.032
Software | V1.06 | 20200921 | Win 10 64bit
==========
Index | Time | 1ST Value | Unit1 | 2ND Value | Unit2
1 | 2023/05/04 00:38:45.0 | +03.00359 | VDC | -------- | ---
2 | 2023/05/04 00:38:45.1 | +03.00359 | VDC | -------- | ---
3 | 2023/05/04 00:38:45.1 | +03.00357 | VDC | -------- | ---
4 | 2023/05/04 00:38:45.2 | +03.00357 | VDC | -------- | ---
5 | 2023/05/04 00:38:45.2 | +03.00357 | VDC | -------- | ---
6 | 2023/05/04 00:38:45.2 | +03.00356 | VDC | -------- | ---
7 | 2023/05/04 00:38:45.3 | +03.00356 | VDC | -------- | ---
8 | 2023/05/04 00:38:45.3 | +03.00355 | VDC | -------- | ---
9 | 2023/05/04 00:38:45.3 | +03.00358 | VDC | -------- | ---
10 | 2023/05/04 00:38:45.3 | +03.00359 | VDC | -------- | ---
11 | 2023/05/04 00:38:45.4 | +03.00360 | VDC | -------- | ---
12 | 2023/05/04 00:38:45.4 | +03.00362 | VDC | -------- | ---
13 | 2023/05/04 00:38:45.4 | +03.00364 | VDC | -------- | ---
14 | 2023/05/04 00:38:45.5 | +03.00366 | VDC | -------- | ---
15 | 2023/05/04 00:38:45.5 | +03.00368 | VDC | -------- | ---
16 | 2023/05/04 00:38:45.5 | +03.00369 | VDC | -------- | ---
17 | 2023/05/04 00:38:45.6 | +03.00371 | VDC | -------- | ---
18 | 2023/05/04 00:38:45.6 | +03.00373 | VDC | -------- | ---
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
997 | 2023/05/04 00:39:16.9 | +03.00337 | VDC | -------- | ---
998 | 2023/05/04 00:39:17.0 | +03.00337 | VDC | -------- | ---
999 | 2023/05/04 00:39:17.0 | +03.00335 | VDC | -------- | ---
1000 | 2023/05/04 00:39:17.0 | +03.00333 | VDC | -------- | ---
