FilipPaul/DIPLOMKA/tex/aktualni_19_05_2023/obrazky/matlab_generated/VOLTAGE_TESTER/DMM DataLog-PIN2.csv

Product | GWInstek | GDM9061 | GEW921489 | 1.12 | 1.14
FileName | DMM DataLog-DMM DataLog-PIN1.csv_0.csv
Function(1ST) | DC Voltage | 100/s
Function(2ND) | OFF | NONE
LogUnit | Auto
MathFunction | Off
Interval | 00:00:00.032
Software | V1.06 | 20200921 | Win 10 64bit
==========
Index | Time | 1ST Value | Unit1 | 2ND Value | Unit2
1 | 2023/05/04 00:34:36.9 | +02.90134 | VDC | -------- | ---
2 | 2023/05/04 00:34:36.9 | +02.90118 | VDC | -------- | ---
3 | 2023/05/04 00:34:36.9 | +02.90105 | VDC | -------- | ---
4 | 2023/05/04 00:34:37.0 | +02.90090 | VDC | -------- | ---
5 | 2023/05/04 00:34:37.0 | +02.90076 | VDC | -------- | ---
6 | 2023/05/04 00:34:37.0 | +02.90063 | VDC | -------- | ---
7 | 2023/05/04 00:34:37.1 | +02.90047 | VDC | -------- | ---
8 | 2023/05/04 00:34:37.1 | +02.90034 | VDC | -------- | ---
9 | 2023/05/04 00:34:37.1 | +02.90019 | VDC | -------- | ---
10 | 2023/05/04 00:34:37.2 | +02.90007 | VDC | -------- | ---
11 | 2023/05/04 00:34:37.2 | +02.90008 | VDC | -------- | ---
12 | 2023/05/04 00:34:37.2 | +02.90007 | VDC | -------- | ---
13 | 2023/05/04 00:34:37.2 | +02.90006 | VDC | -------- | ---
14 | 2023/05/04 00:34:37.3 | +02.90007 | VDC | -------- | ---
15 | 2023/05/04 00:34:37.3 | +02.90006 | VDC | -------- | ---
16 | 2023/05/04 00:34:37.3 | +02.90006 | VDC | -------- | ---
17 | 2023/05/04 00:34:37.4 | +02.90007 | VDC | -------- | ---
18 | 2023/05/04 00:34:37.4 | +02.90007 | VDC | -------- | ---
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
997 | 2023/05/04 00:35:08.8 | +02.89899 | VDC | -------- | ---
998 | 2023/05/04 00:35:08.8 | +02.89899 | VDC | -------- | ---
999 | 2023/05/04 00:35:08.8 | +02.89900 | VDC | -------- | ---
1000 | 2023/05/04 00:35:08.9 | +02.89900 | VDC | -------- | ---
