FilipPaul/DIPLOMKA/tex/aktualni_19_05_2023/obrazky/matlab_generated/VOLTAGE_TESTER/DMM DataLog-PIN4.csv

Product | GWInstek | GDM9061 | GEW921489 | 1.12 | 1.14
FileName | DMM DataLog-DMM DataLog-PIN4.csv.csv_0.csv
Function(1ST) | DC Voltage | 100/s
Function(2ND) | OFF | NONE
LogUnit | Auto
MathFunction | Off
Interval | 00:00:00.032
Software | V1.06 | 20200921 | Win 10 64bit
==========
Index | Time | 1ST Value | Unit1 | 2ND Value | Unit2
1 | 2023/05/04 00:32:42.2 | +02.15089 | VDC | -------- | ---
2 | 2023/05/04 00:32:42.2 | +02.15090 | VDC | -------- | ---
3 | 2023/05/04 00:32:42.2 | +02.15093 | VDC | -------- | ---
4 | 2023/05/04 00:32:42.3 | +02.15093 | VDC | -------- | ---
5 | 2023/05/04 00:32:42.3 | +02.15090 | VDC | -------- | ---
6 | 2023/05/04 00:32:42.3 | +02.15091 | VDC | -------- | ---
7 | 2023/05/04 00:32:42.4 | +02.15088 | VDC | -------- | ---
8 | 2023/05/04 00:32:42.4 | +02.15088 | VDC | -------- | ---
9 | 2023/05/04 00:32:42.4 | +02.15089 | VDC | -------- | ---
10 | 2023/05/04 00:32:42.5 | +02.15089 | VDC | -------- | ---
11 | 2023/05/04 00:32:42.5 | +02.15089 | VDC | -------- | ---
12 | 2023/05/04 00:32:42.5 | +02.15089 | VDC | -------- | ---
13 | 2023/05/04 00:32:42.6 | +02.15089 | VDC | -------- | ---
14 | 2023/05/04 00:32:42.6 | +02.15089 | VDC | -------- | ---
15 | 2023/05/04 00:32:42.6 | +02.15089 | VDC | -------- | ---
16 | 2023/05/04 00:32:42.7 | +02.15088 | VDC | -------- | ---
17 | 2023/05/04 00:32:42.7 | +02.15088 | VDC | -------- | ---
18 | 2023/05/04 00:32:42.7 | +02.15088 | VDC | -------- | ---
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
997 | 2023/05/04 00:33:14.1 | +02.15096 | VDC | -------- | ---
998 | 2023/05/04 00:33:14.1 | +02.15095 | VDC | -------- | ---
999 | 2023/05/04 00:33:14.1 | +02.15097 | VDC | -------- | ---
1000 | 2023/05/04 00:33:14.2 | +02.15096 | VDC | -------- | ---
