FilipPaul/DIPLOMKA/tex/aktualni_19_05_2023/obrazky/matlab_generated/VOLTAGE_TESTER/DMM DataLog-PIN5_0.csv

Product | GWInstek | GDM9061 | GEW921489 | 1.12 | 1.14
FileName | DMM DataLog-DMM DataLog-PIN5.csv_0.csv
Function(1ST) | DC Voltage | 100/s
Function(2ND) | OFF | NONE
LogUnit | Auto
MathFunction | Off
Interval | 00:00:00.032
Software | V1.06 | 20200921 | Win 10 64bit
==========
Index | Time | 1ST Value | Unit1 | 2ND Value | Unit2
1 | 2023/05/04 00:37:05.7 | +0.970586 | VDC | -------- | ---
2 | 2023/05/04 00:37:05.7 | +0.970576 | VDC | -------- | ---
3 | 2023/05/04 00:37:05.8 | +0.970571 | VDC | -------- | ---
4 | 2023/05/04 00:37:05.8 | +0.970562 | VDC | -------- | ---
5 | 2023/05/04 00:37:05.8 | +0.970562 | VDC | -------- | ---
6 | 2023/05/04 00:37:05.9 | +0.970562 | VDC | -------- | ---
7 | 2023/05/04 00:37:05.9 | +0.970557 | VDC | -------- | ---
8 | 2023/05/04 00:37:05.9 | +0.970554 | VDC | -------- | ---
9 | 2023/05/04 00:37:06.0 | +0.970547 | VDC | -------- | ---
10 | 2023/05/04 00:37:06.0 | +0.970546 | VDC | -------- | ---
11 | 2023/05/04 00:37:06.0 | +0.970541 | VDC | -------- | ---
12 | 2023/05/04 00:37:06.1 | +0.970547 | VDC | -------- | ---
13 | 2023/05/04 00:37:06.1 | +0.970554 | VDC | -------- | ---
14 | 2023/05/04 00:37:06.1 | +0.970554 | VDC | -------- | ---
15 | 2023/05/04 00:37:06.2 | +0.970555 | VDC | -------- | ---
16 | 2023/05/04 00:37:06.2 | +0.970549 | VDC | -------- | ---
17 | 2023/05/04 00:37:06.2 | +0.970548 | VDC | -------- | ---
18 | 2023/05/04 00:37:06.3 | +0.970553 | VDC | -------- | ---
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
530 | 2023/05/04 00:37:22.6 | +0.970792 | VDC | -------- | ---
531 | 2023/05/04 00:37:22.7 | +0.970795 | VDC | -------- | ---
532 | 2023/05/04 00:37:22.7 | +0.970801 | VDC | -------- | ---
533 | 2023/05/04 00:37:22.7 | +0.970802 | VDC | -------- | ---
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
