FilipPaul/DIPLOMKA/PSCM_7Fold_STA3/test_line.png

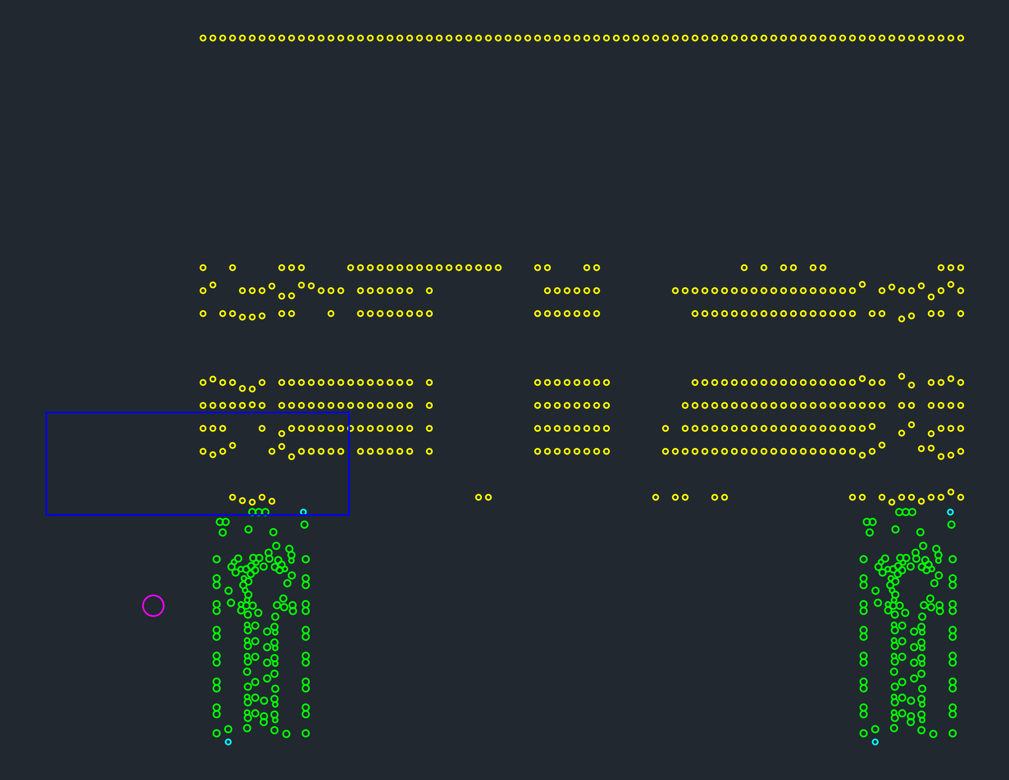
PSCM_7Fold_STA3/test_line.png
