FilipPaul/DIPLOMKA/tex/aktualni_19_05_2023/obrazky/test_fixture.png

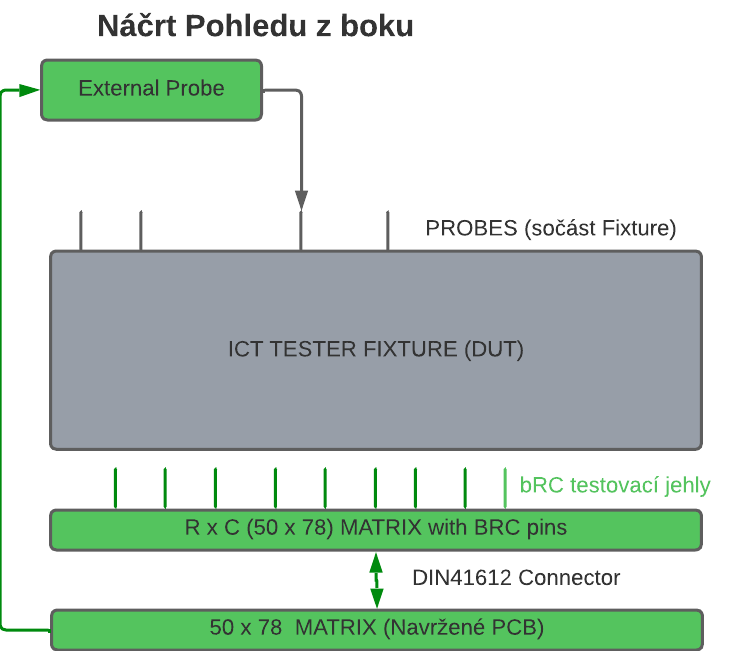
tex/aktualni_19_05_2023/obrazky/test_fixture.png
