FilipPaul/DIPLOMKA/PCB_merici_karta/Project Outputs for diplomka_hiearchical/Schematic Print/Schema.PDF

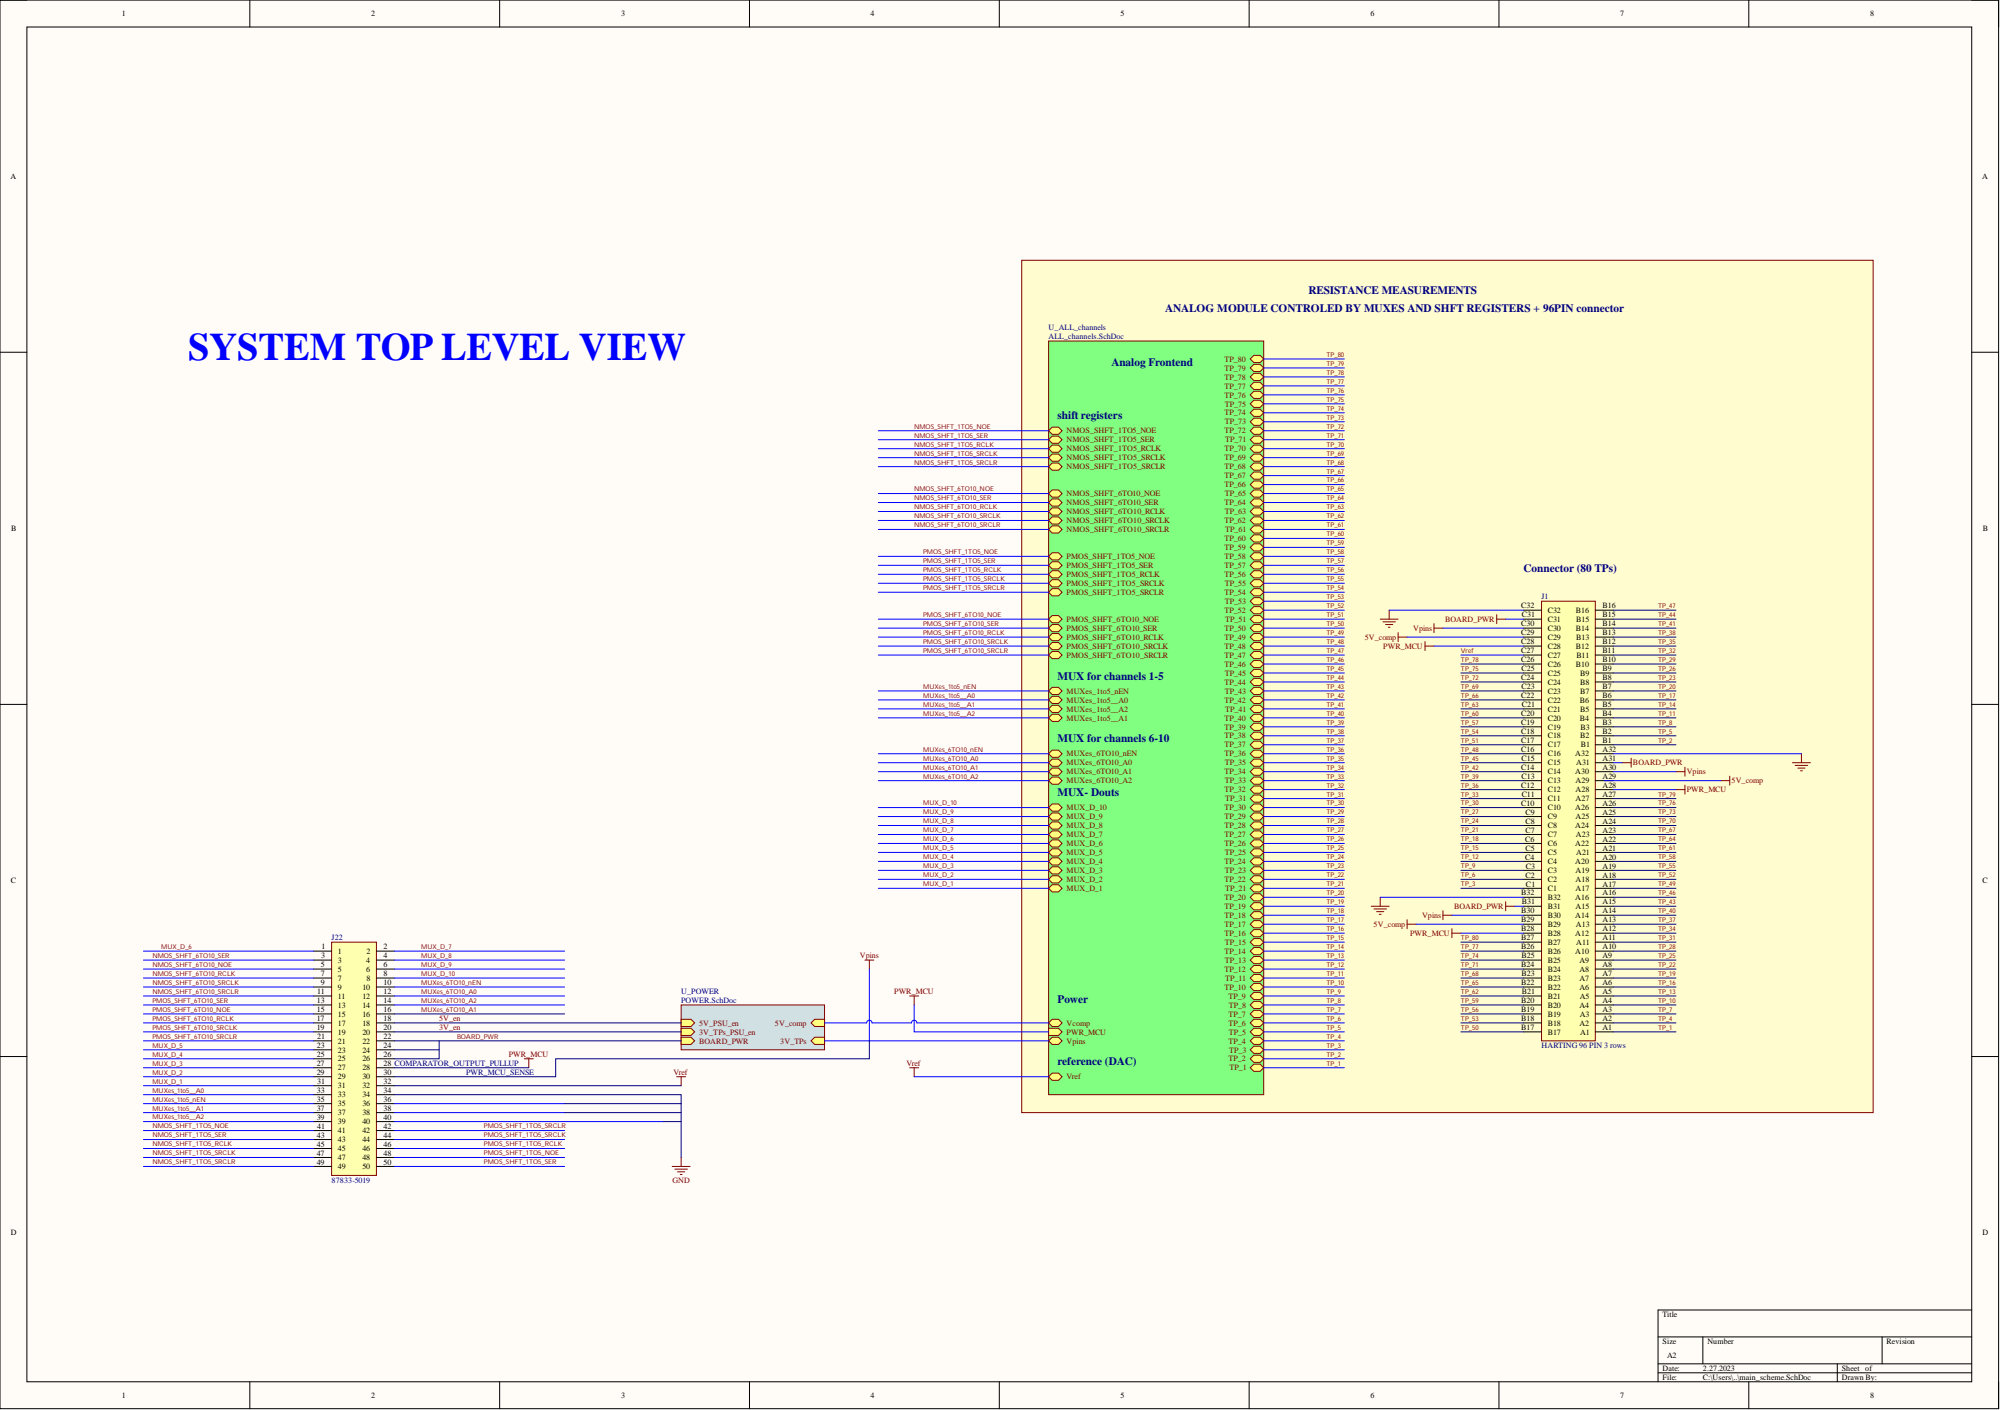
[picture p83: page 1]

2 4 | E | Vref
2 6 | Vref

3 6
3 8
4 0
4 2 PMO S_S H F T_1T O5_S R C L R

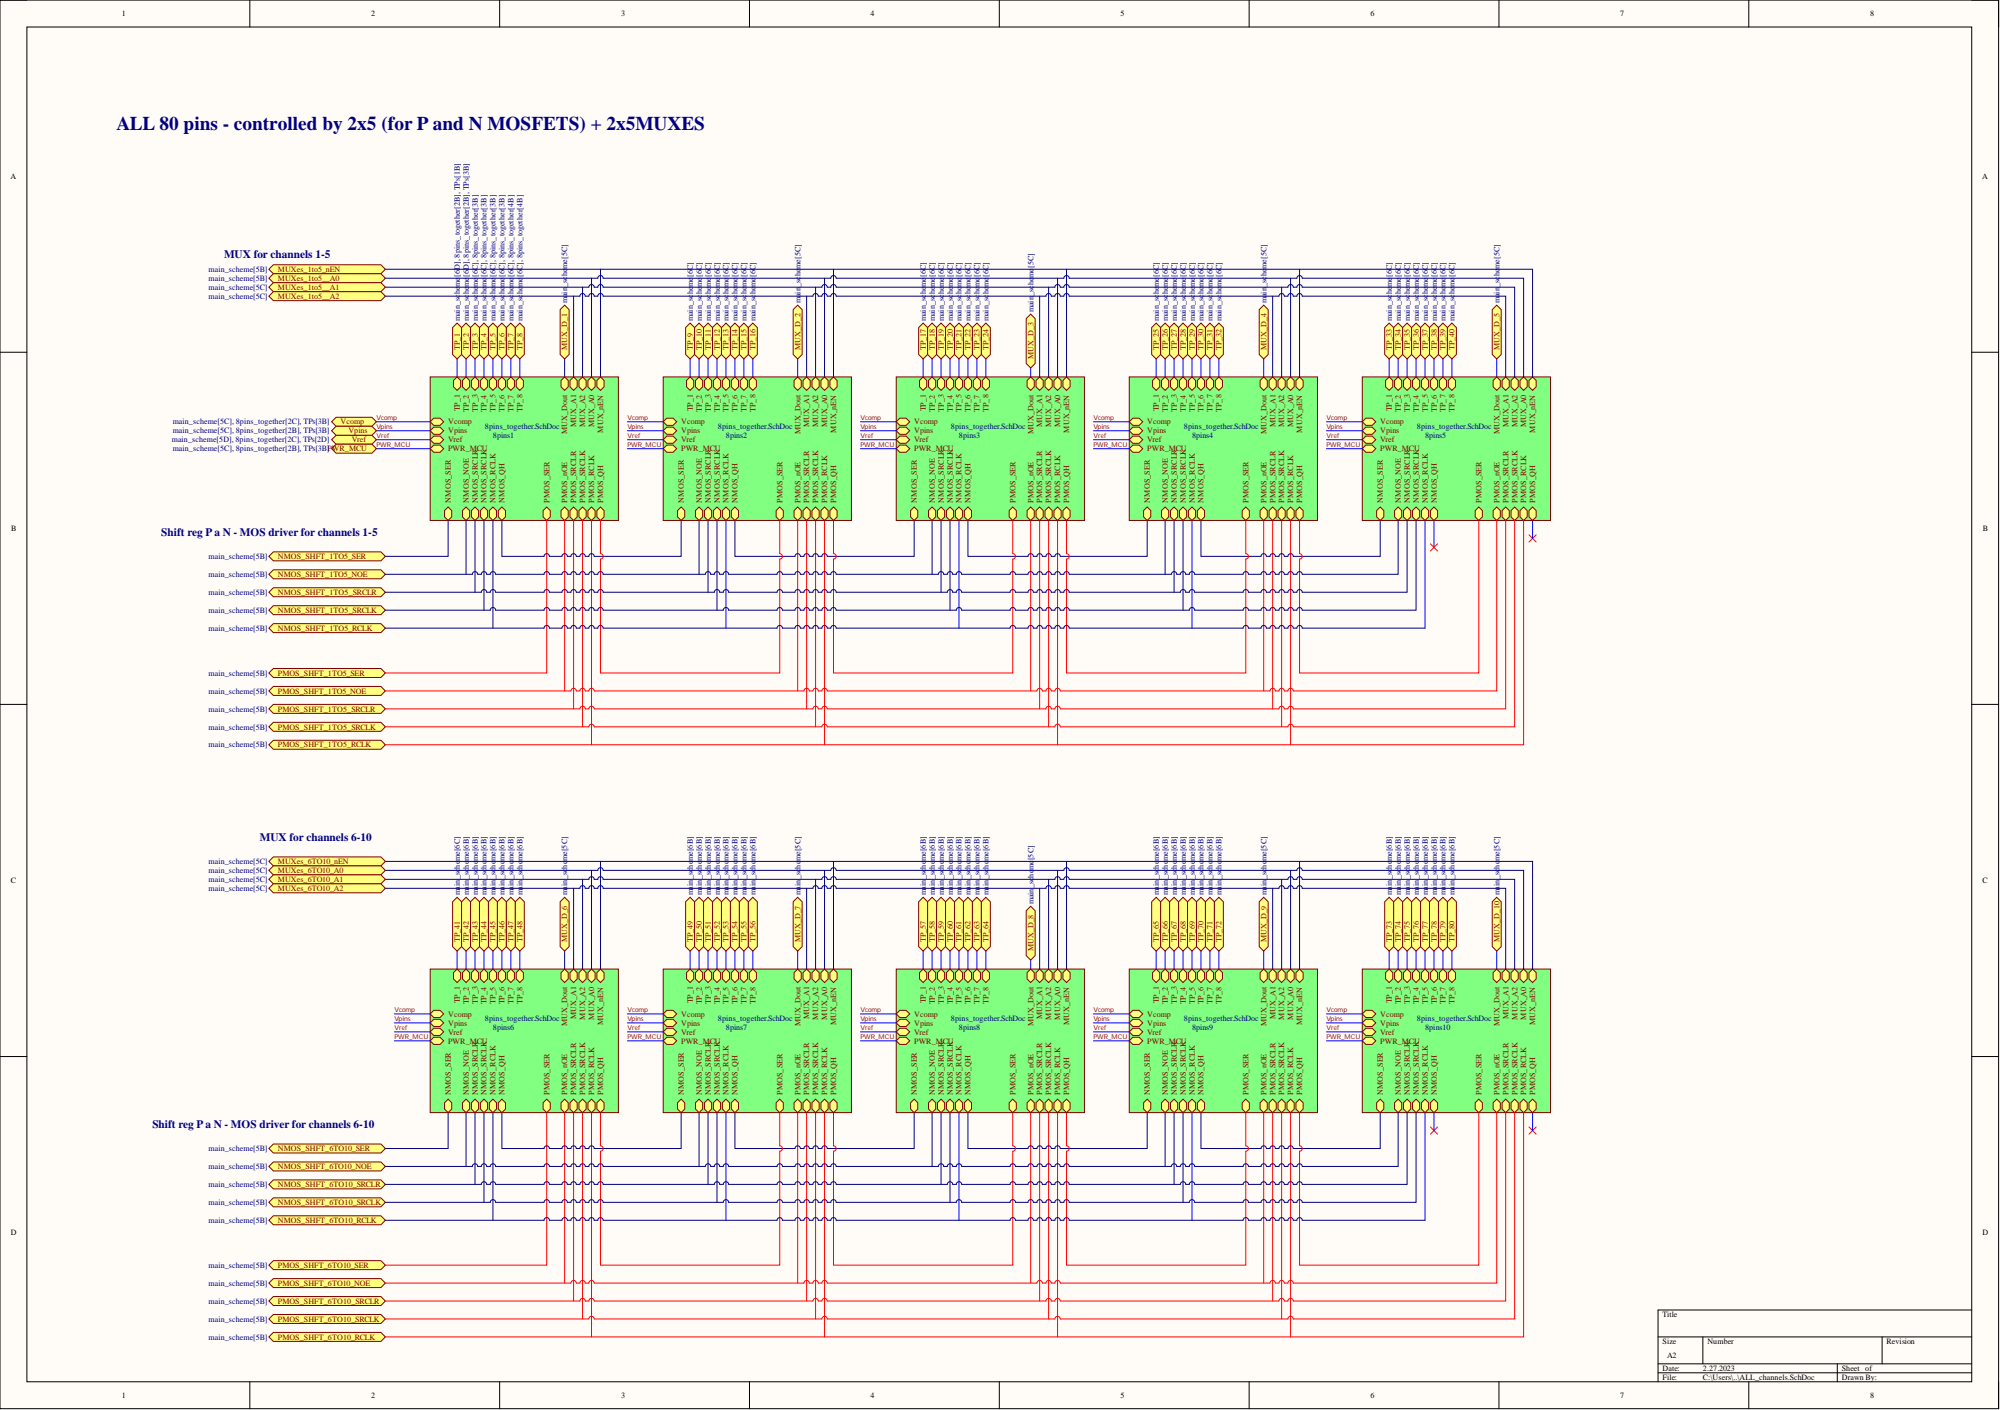
[picture p84: page 2]

ALL 80 pins - controlled by 2x5 (for P and N MOSFETS) + 2x5MUXES

Shift reg P a N - MOS driver for channels 1-5

Shift reg P a N - MOS driver for channels 6-10

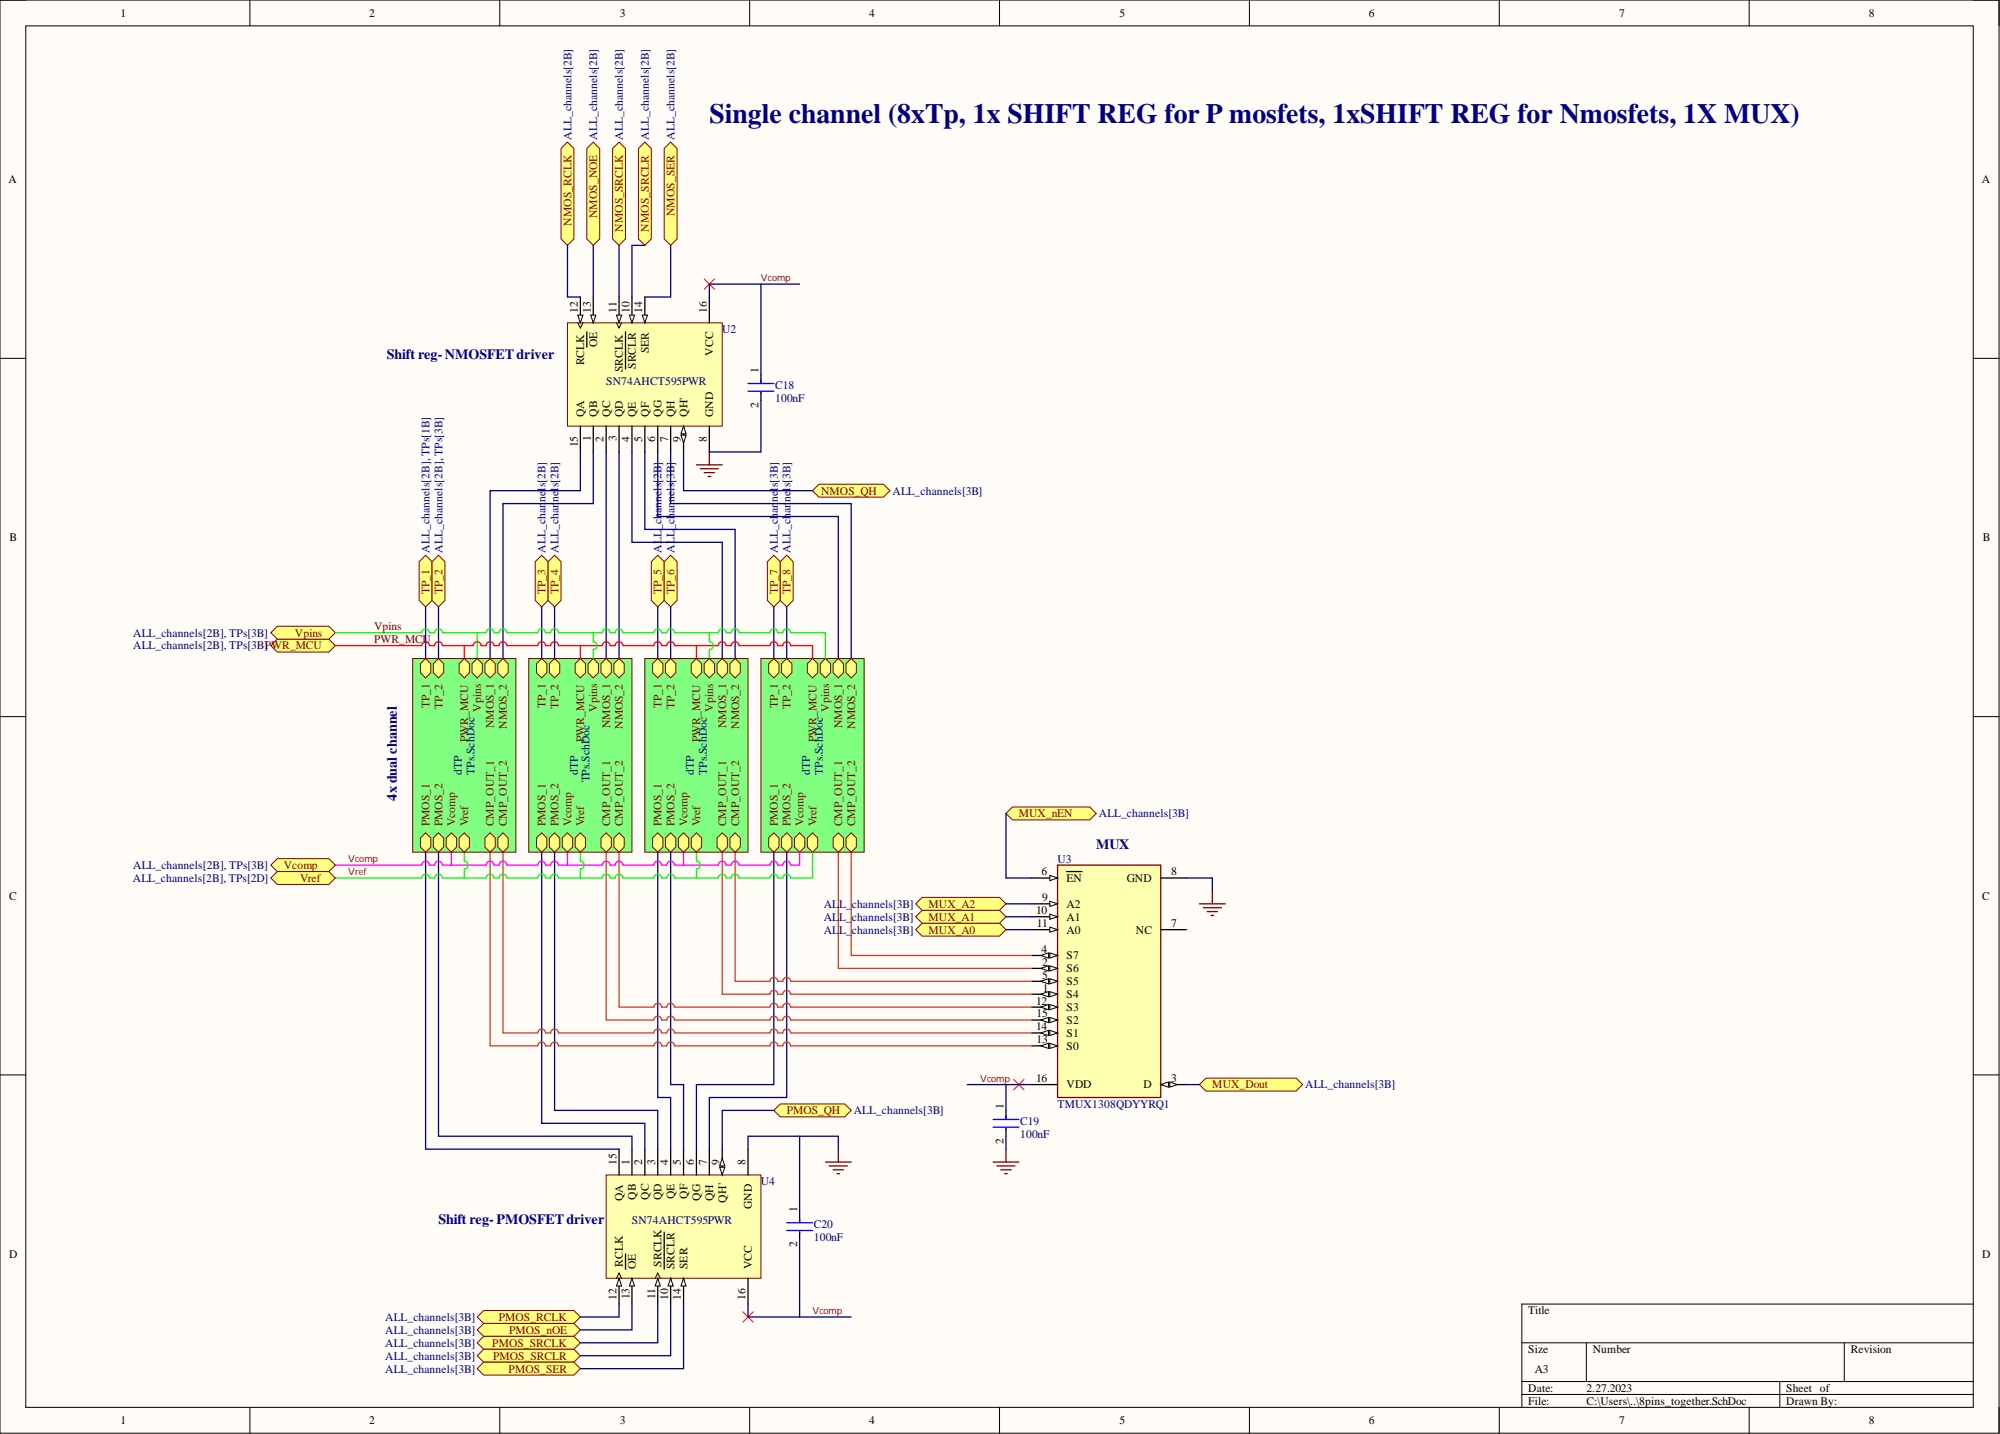
[picture p85: page 3]

Single channel (8xTp, 1x SHIFT REG for P mosfets, 1xSHIFT REG for Nmosfets, 1X MUX)

Shift reg- NMOSFET driver

Shift reg- PMOSFET driver

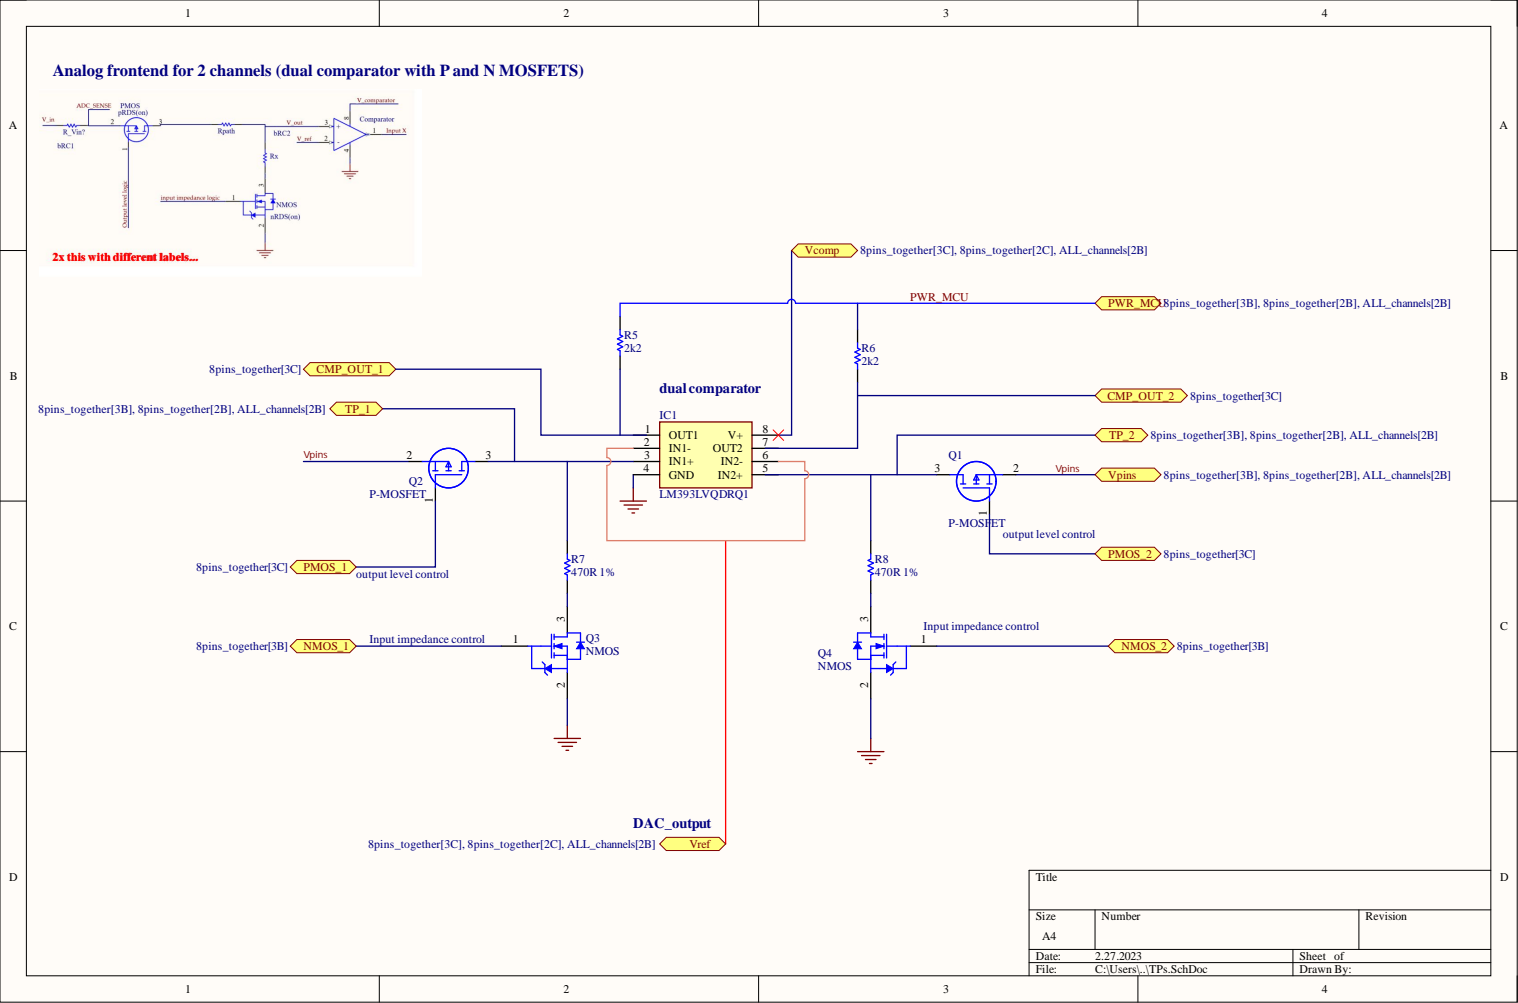
[picture p86: page 4]

Analog frontend for 2 channels (dual comparator with P and N MOSFETS)

2x this with different labels...

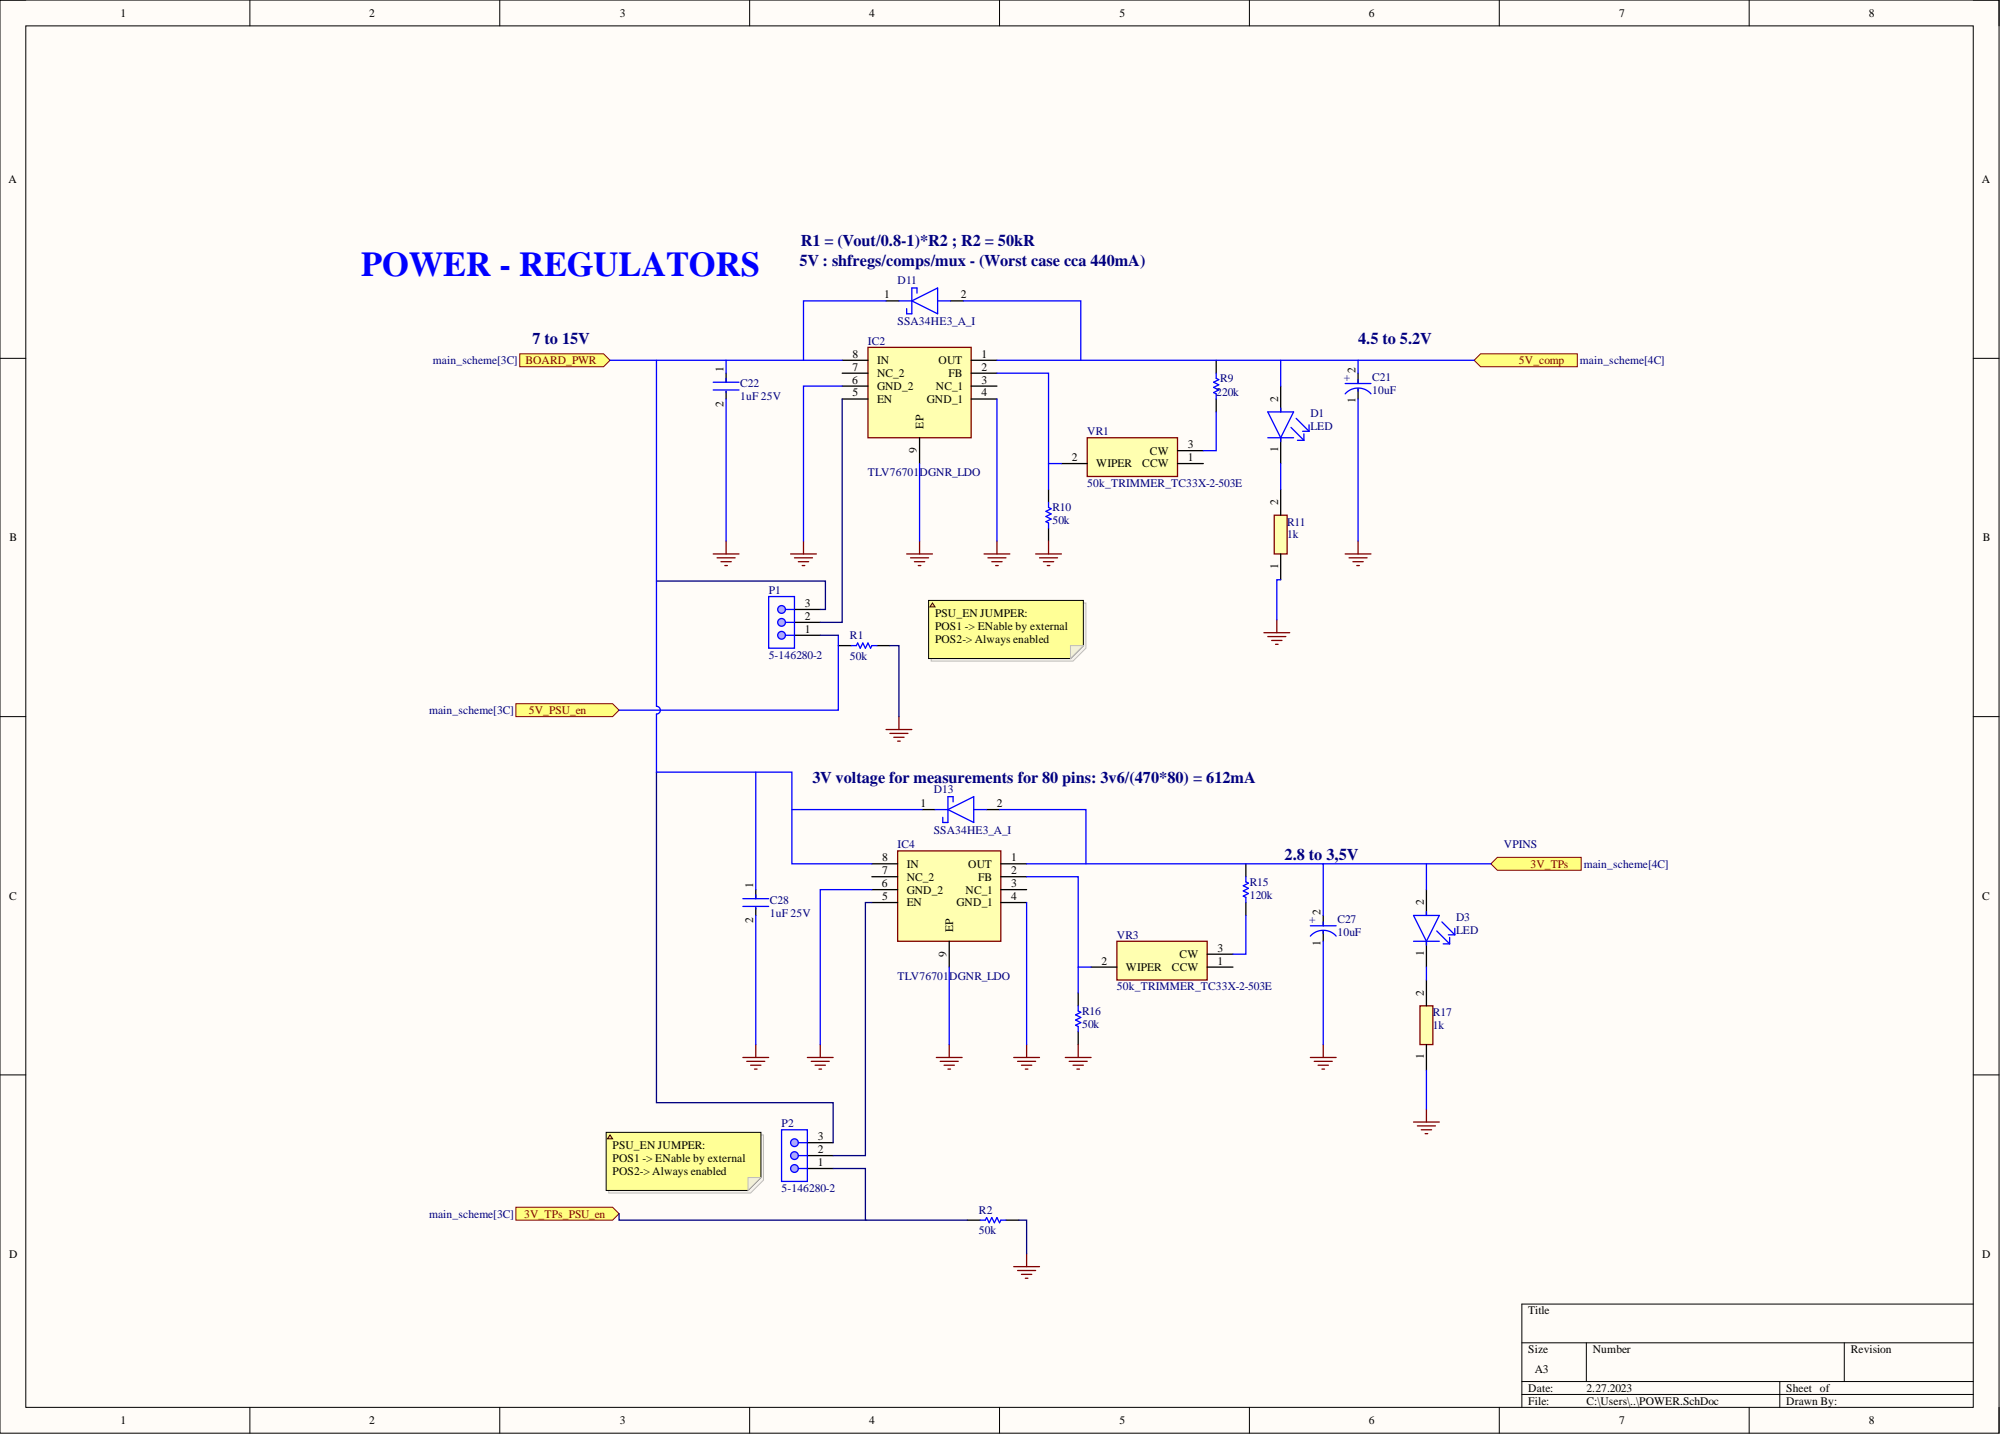
[picture p87: page 5]

R1 = (Vout/0.8-1)*R2 ; R2 = 50kR
5V : shfregs/comps/mux - (Worst case cca 440mA)

3V voltage for measurements for 80 pins: 3v6/(470*80) = 612mA
