FilipPaul/DIPLOMKA/PCB_ovladaci_karta/Ovladaci_karta/Project Outputs for Ovladaci_karta/Schematic Print/Schematic Prints.PDF

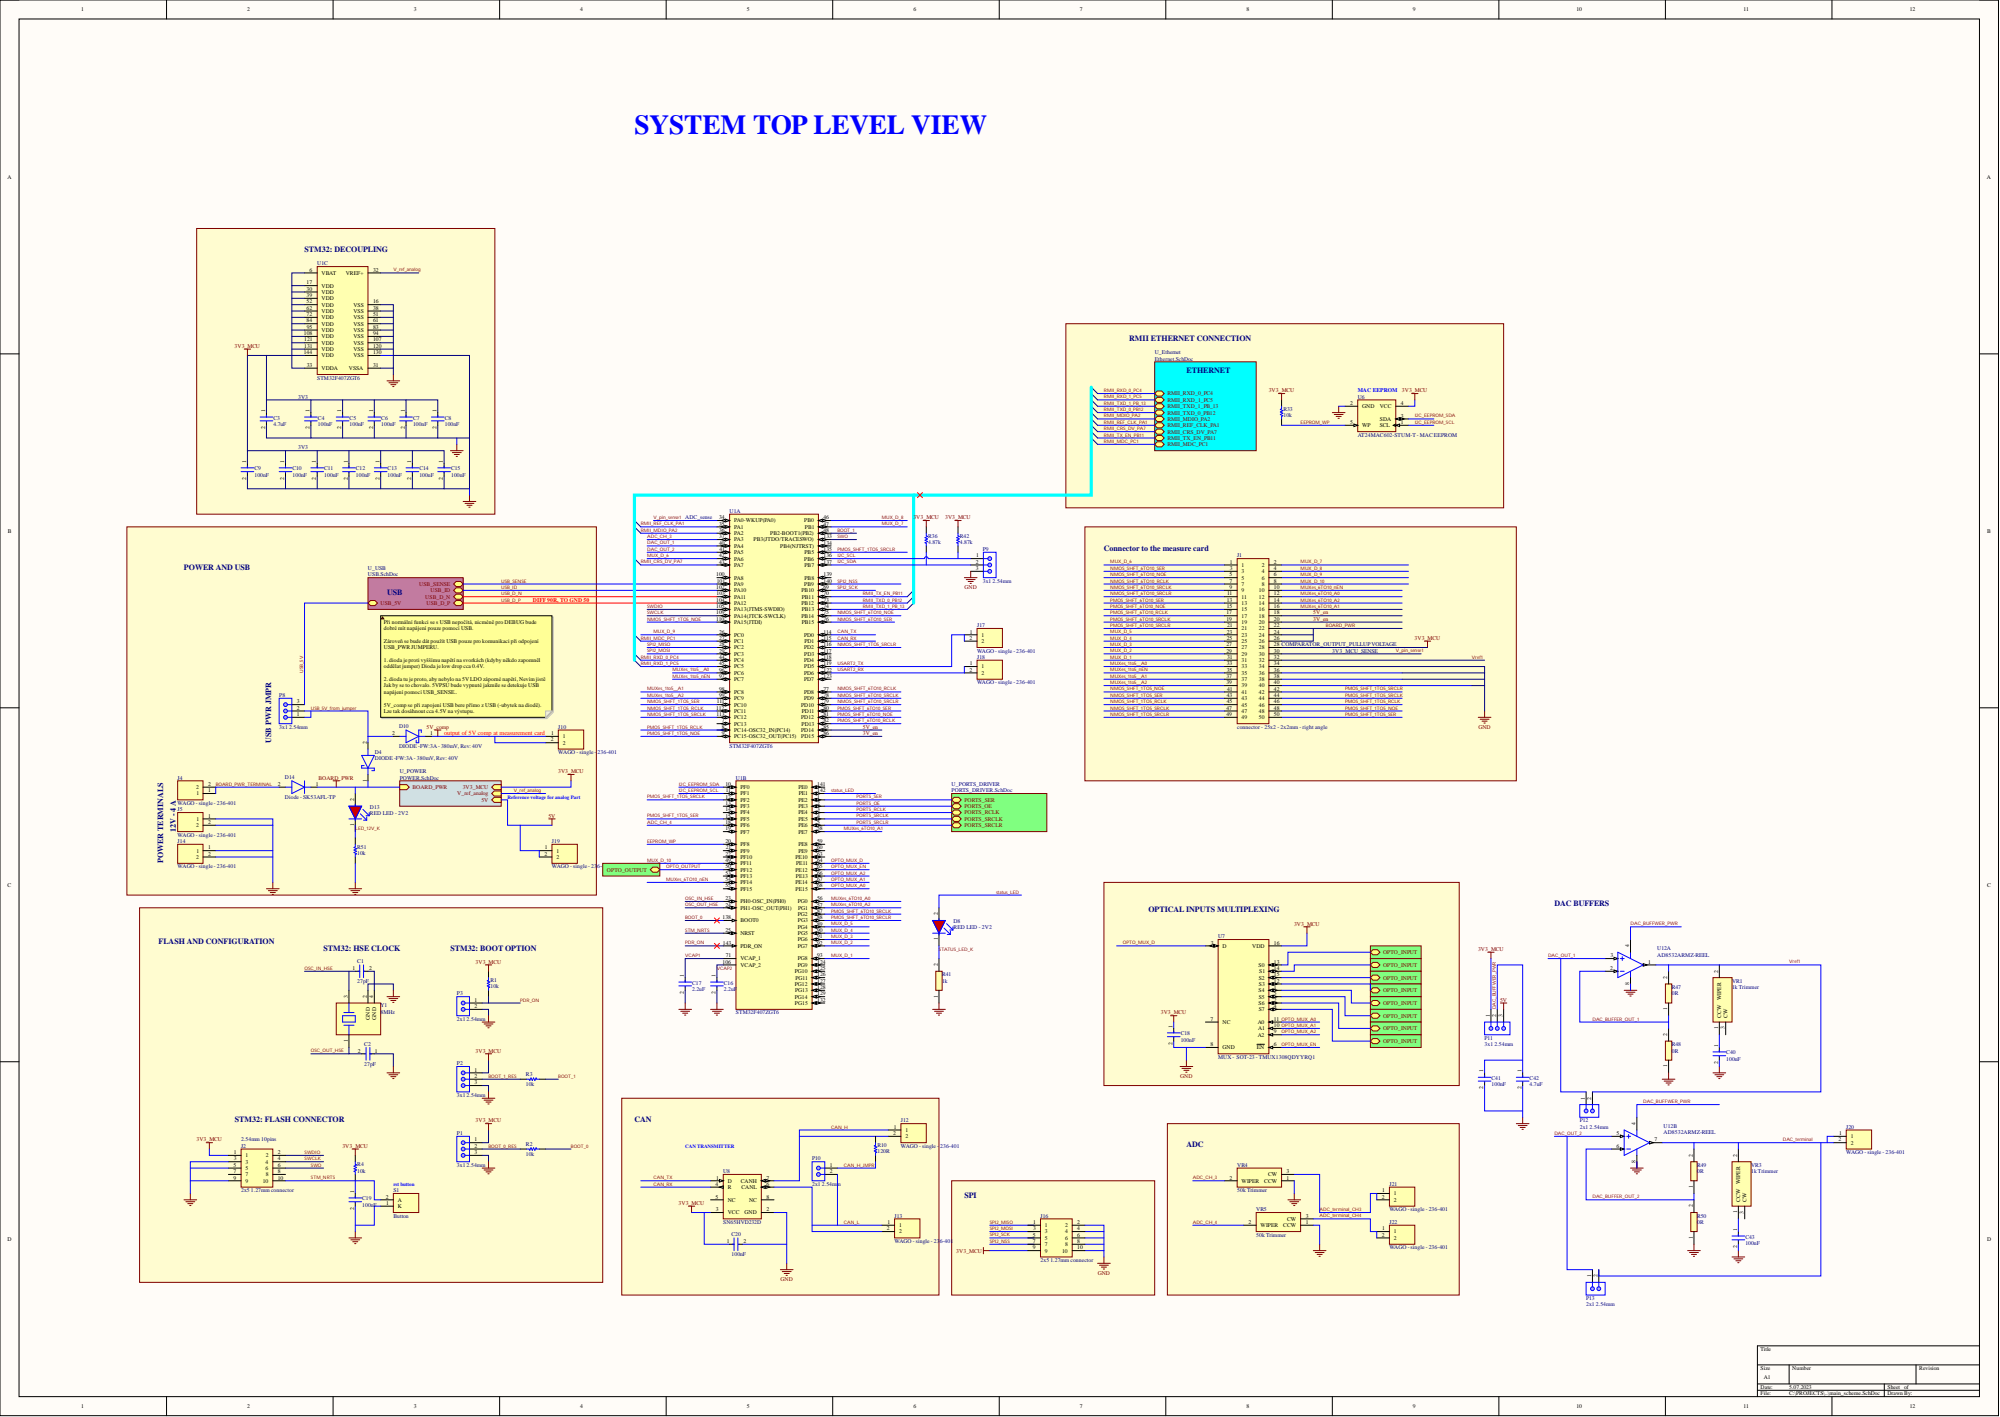
[picture p88: page 1]

SYSTEM TOP LEVEL VIEW

Při normální funkci se s USB nepočítá, nicméně pro DEBUG bude
dobré mít napájení pouze pomocí USB.

Zároveň se bude dát použít USB pouze pro komunikaci při odpojení
USB_PWR JUMPERU.

1. dioda je proti vyššímu napětí na svorkách (kdyby někdo zapomněl
oddělat jumper) Dioda je low drop cca 0.4V.

2. dioda tu je proto, aby nebylo na 5V LDO záporné napětí, Nevím jistě
Jak by se to chovalo. 5VPSU bude vypnuté jakmile se detekuje USB
napájení pomocí USB_SENSE..

5V_comp se při zapojení USB bere přímo z USB (-ubytek na diodě).
Lze tak dosáhnout cca 4.5V na výstupu.

output of 5V comp at measurement card

V_ref_analog
Reference voltage for analog Part

DAC_BUFFER_OUT_2

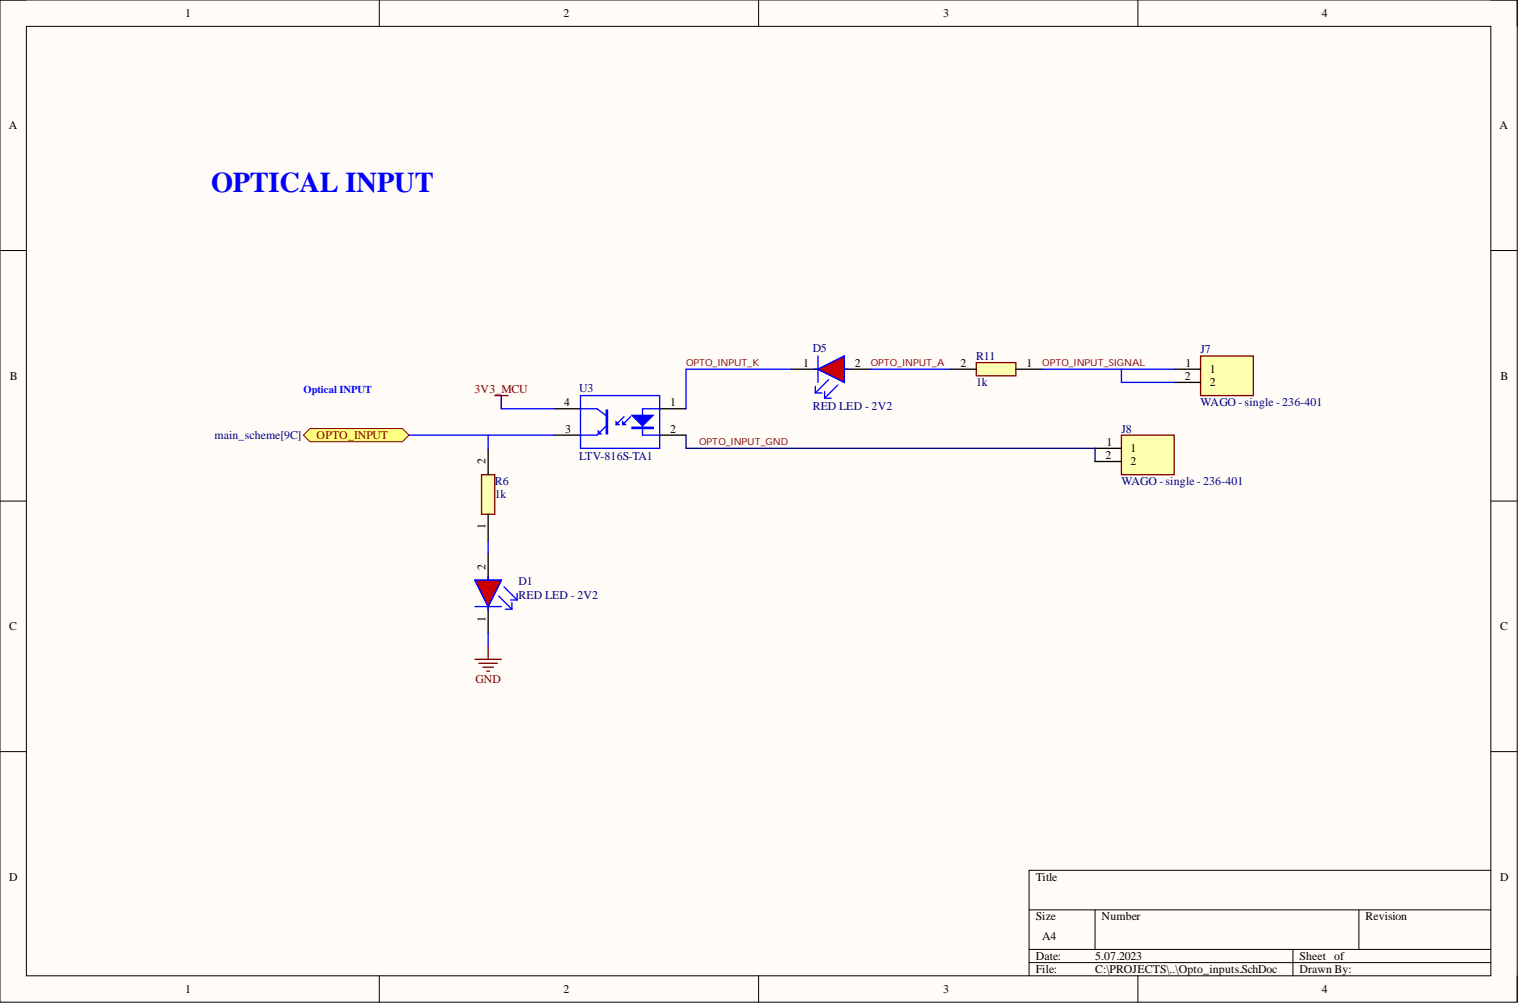
[picture p89: page 2]

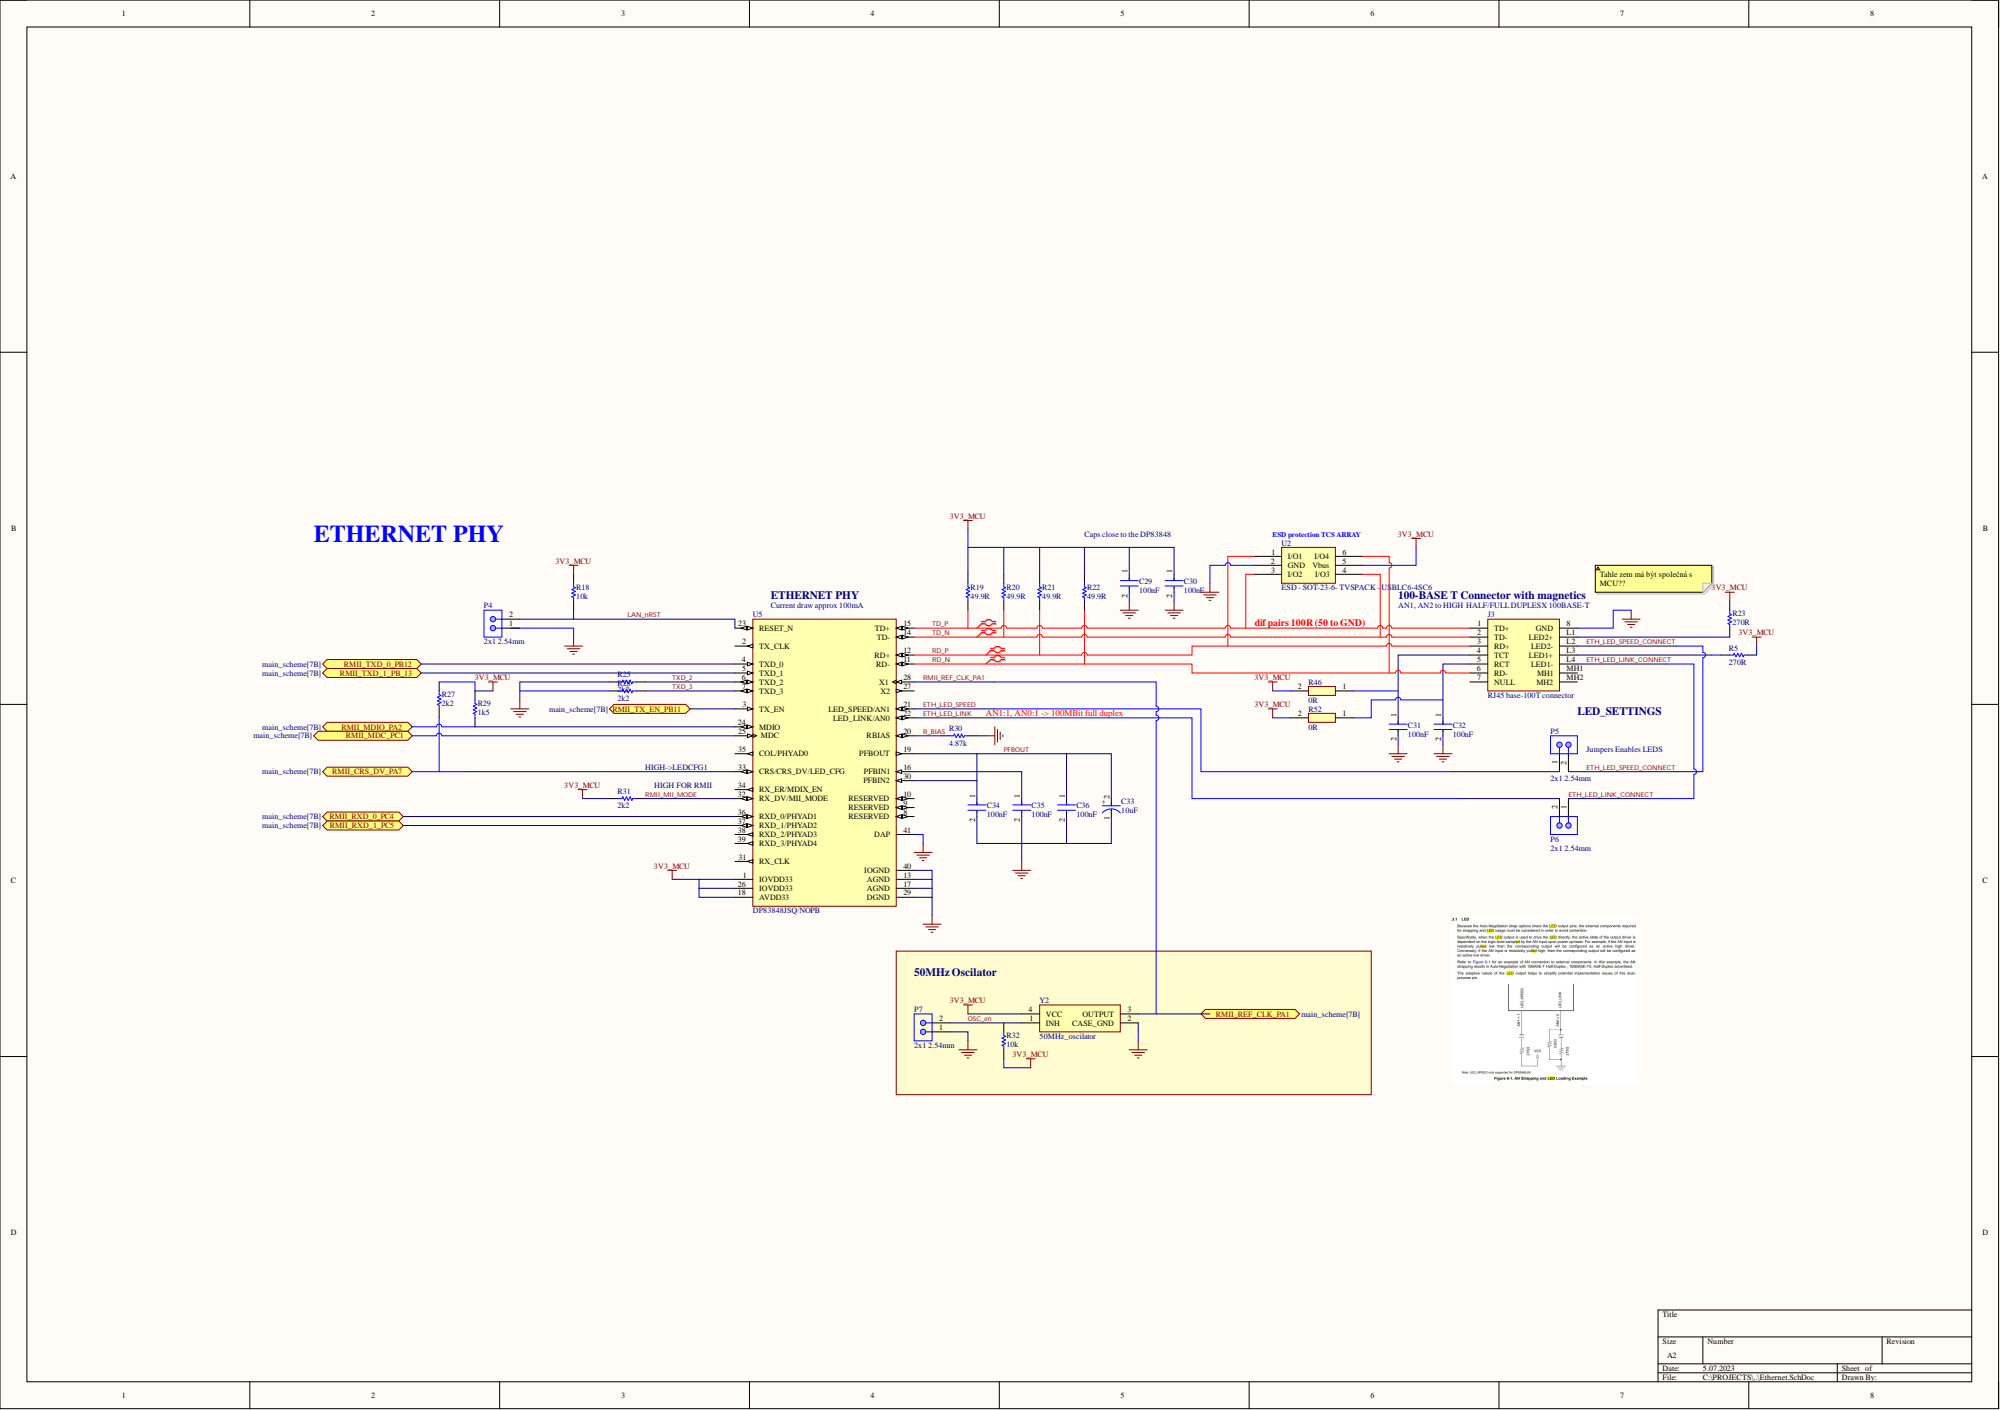
[picture p90: page 3]

Caps close to the DP83848

Tahle zem má být společná s
MCU??

100-BASE T Connector with magnetics
AN1, AN2 to HIGH HALF/FULLDUPLESX 100BASE-T

dif pairs 100R (50 to GND)

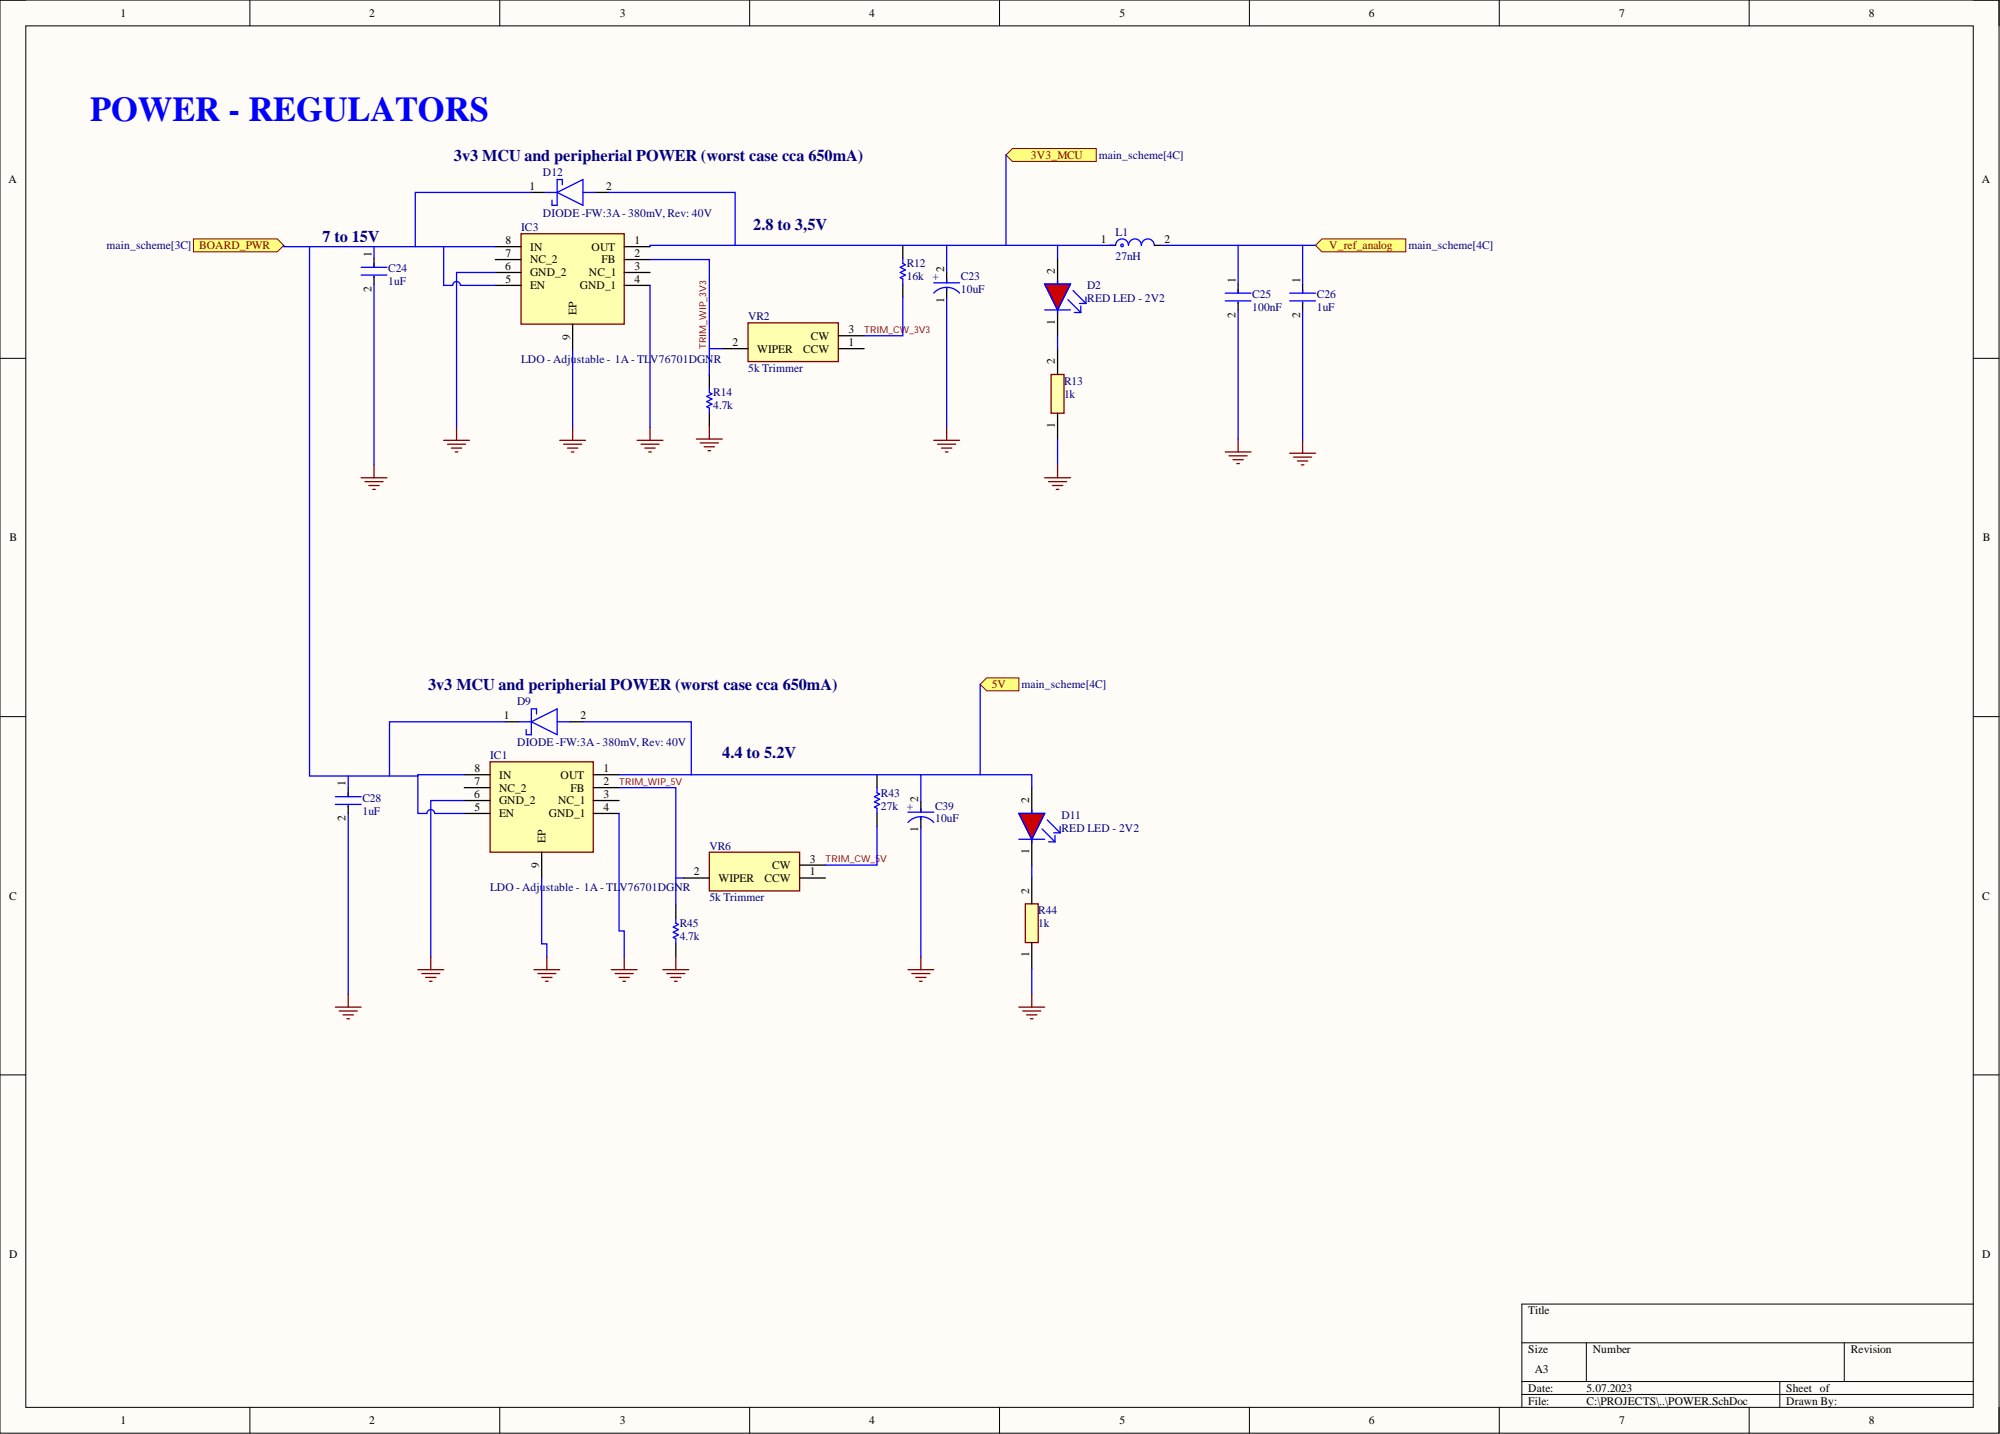
[picture p91: page 4]

3v3 MCU and peripherial POWER (worst case cca 650mA)

IN 8 | FB NC_1
NC_2 7 | 2 TRIM_WIP_5V | R43
GND_2 6 | 3

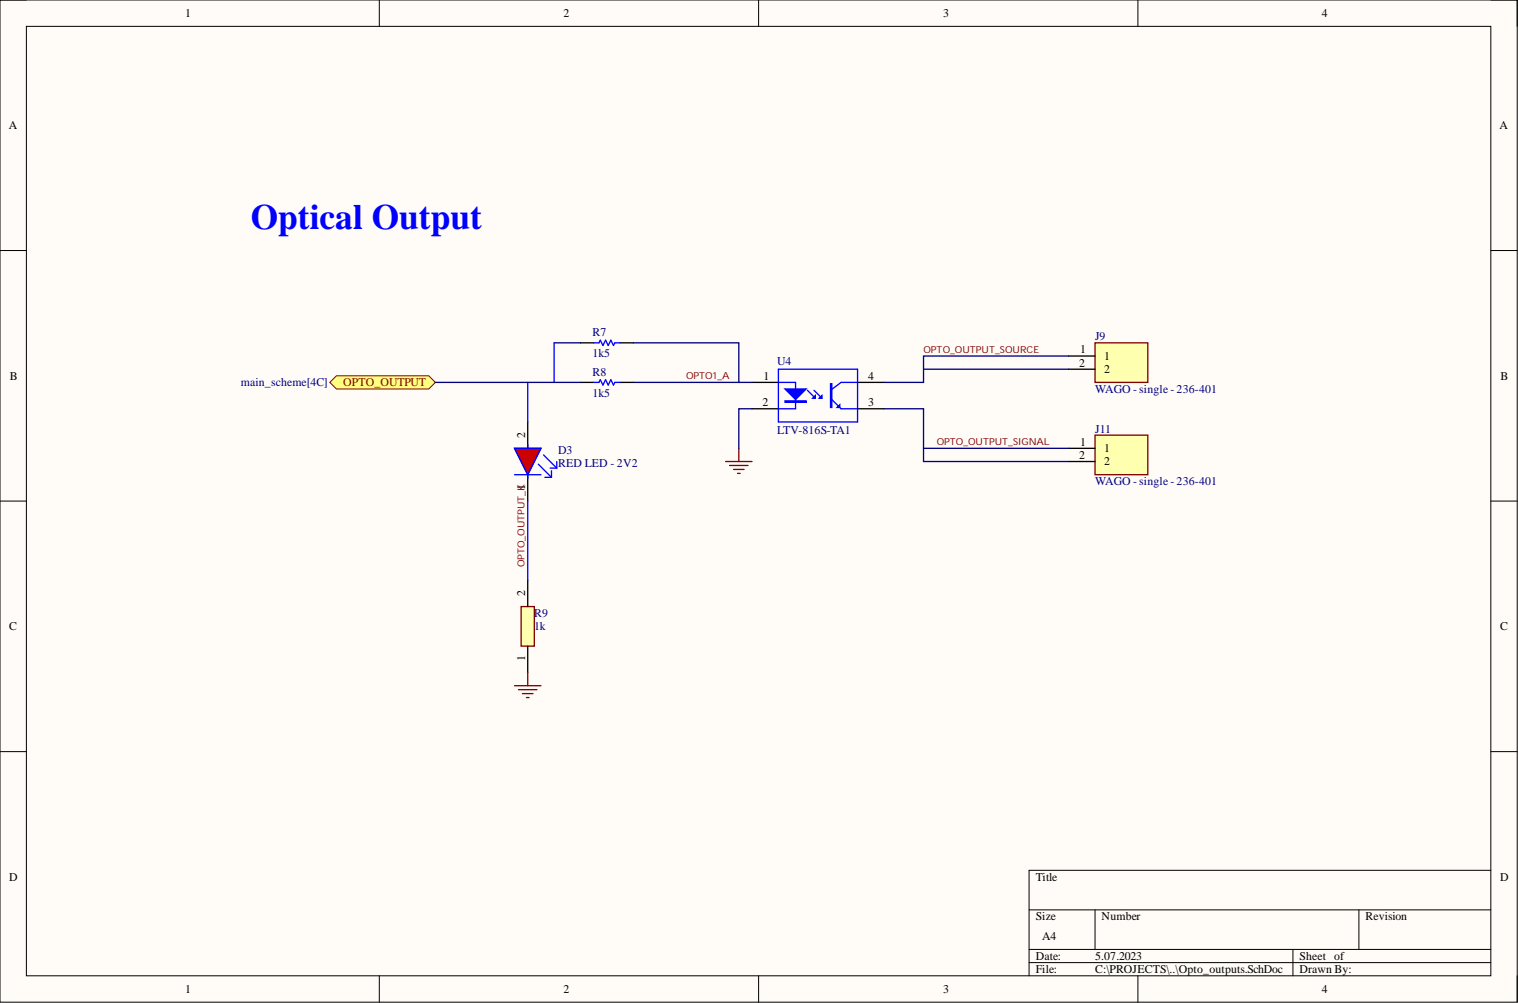
[picture p92: page 5]

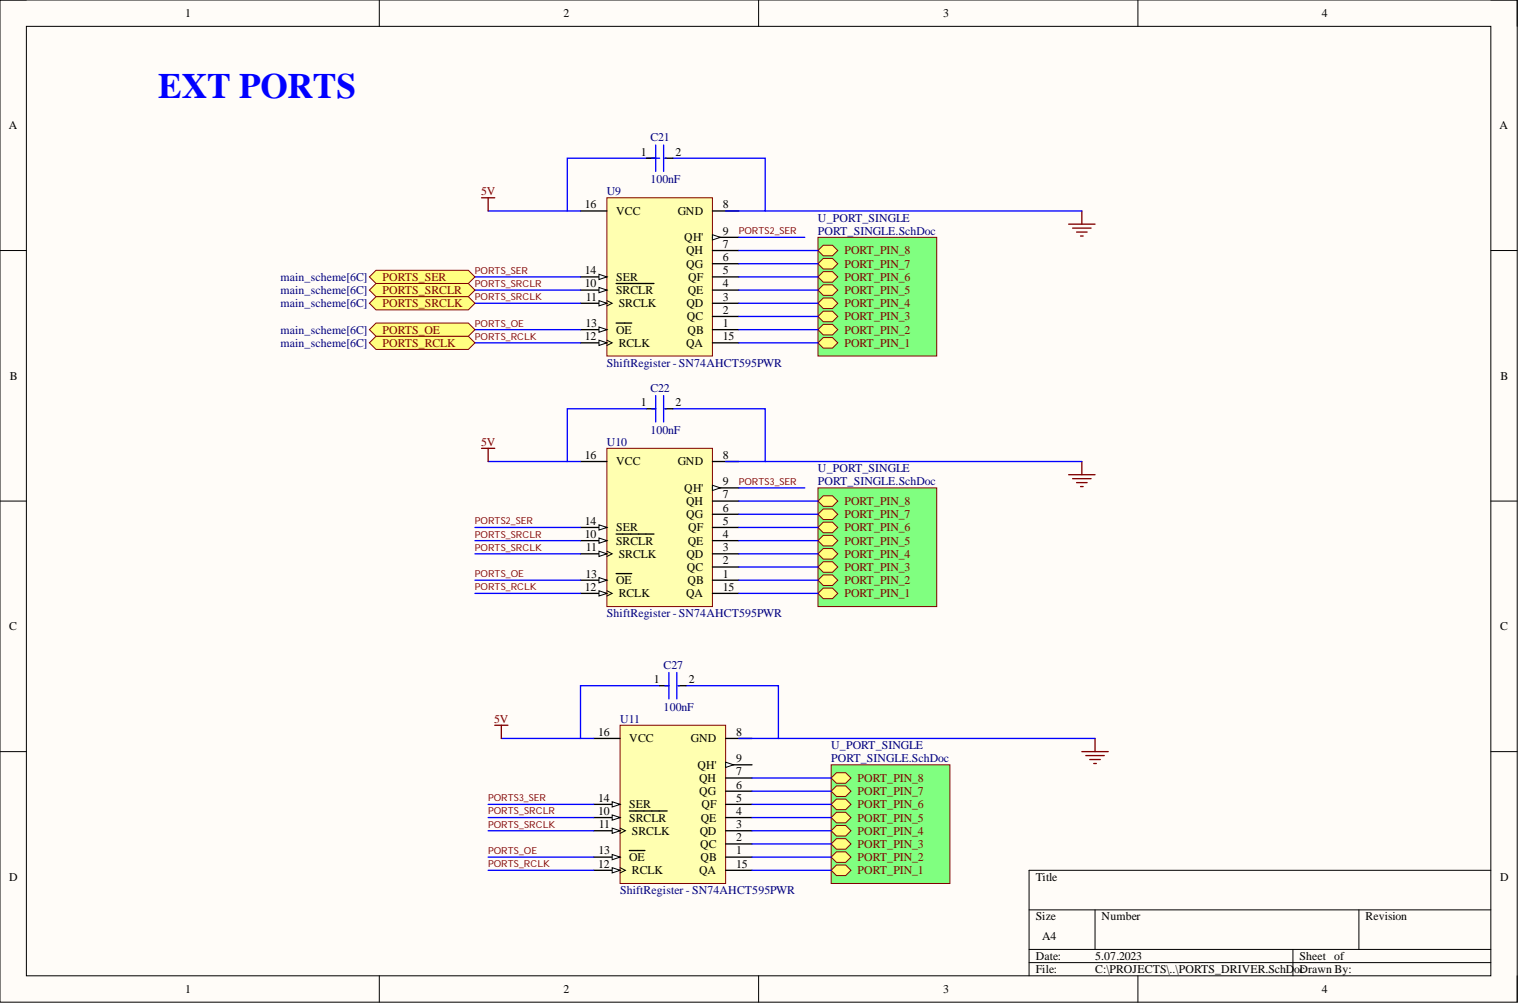
[picture p93: page 6]

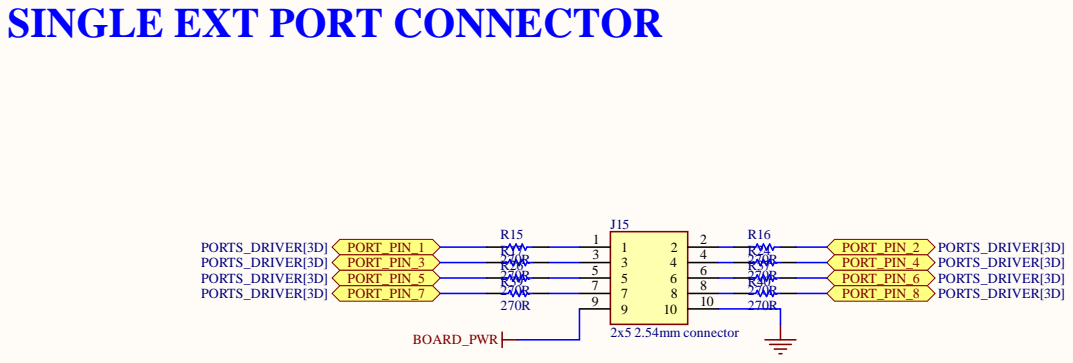
[picture p94: page 7]

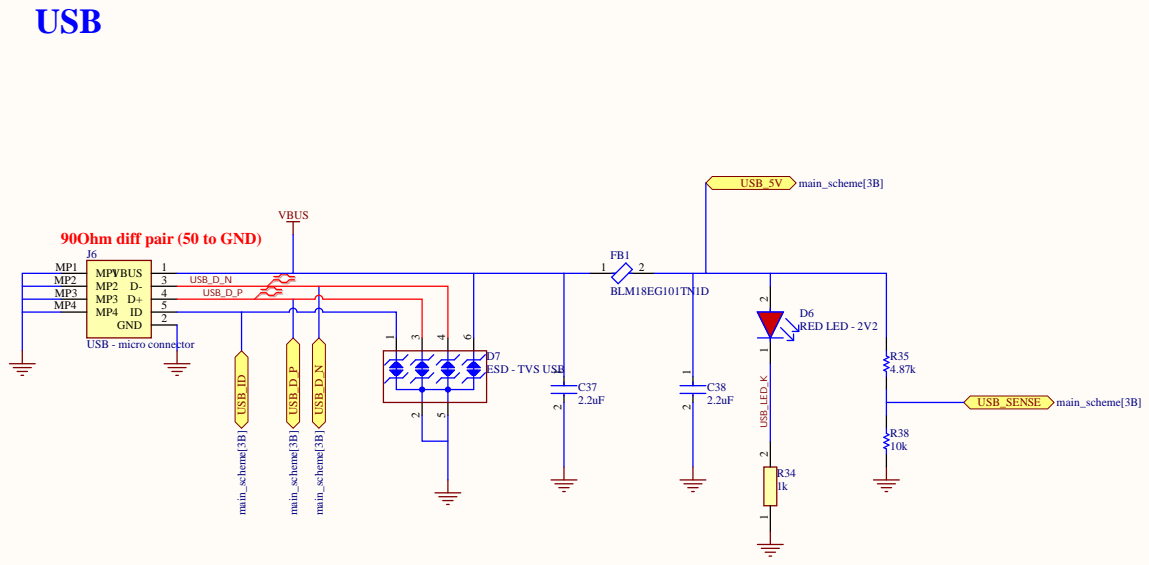
[picture p95: page 8]
