FilipPaul/DIPLOMKA/tex/aktualni_19_05_2023/obrazky/matlab_generated/pin_step1-eps-converted-to.pdf

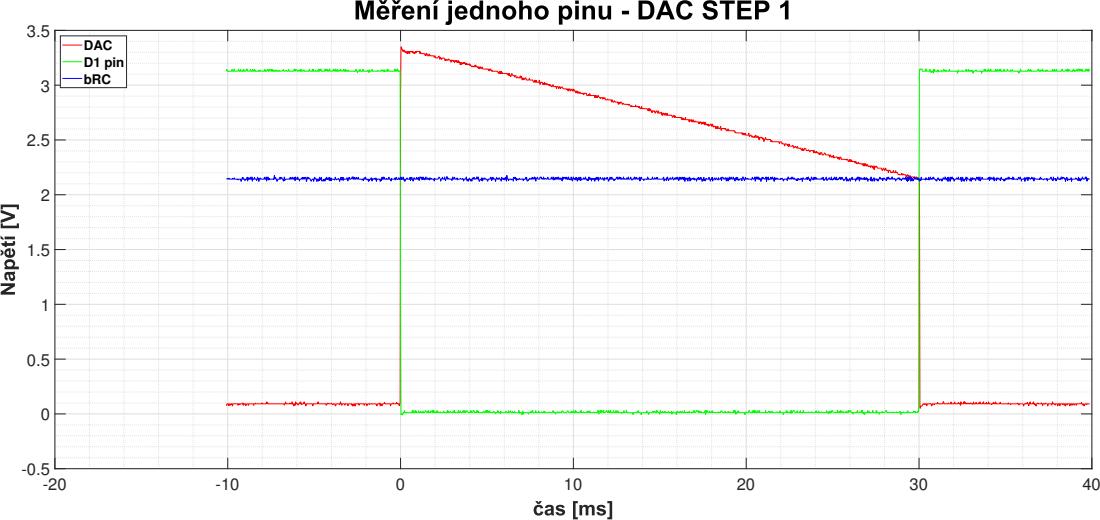
[picture p96: page 1]

DAC
D1 pin
bRC
