FilipPaul/DIPLOMKA/tex/aktualni_19_05_2023/obrazky/matlab_generated/pin_step5-eps-converted-to.pdf

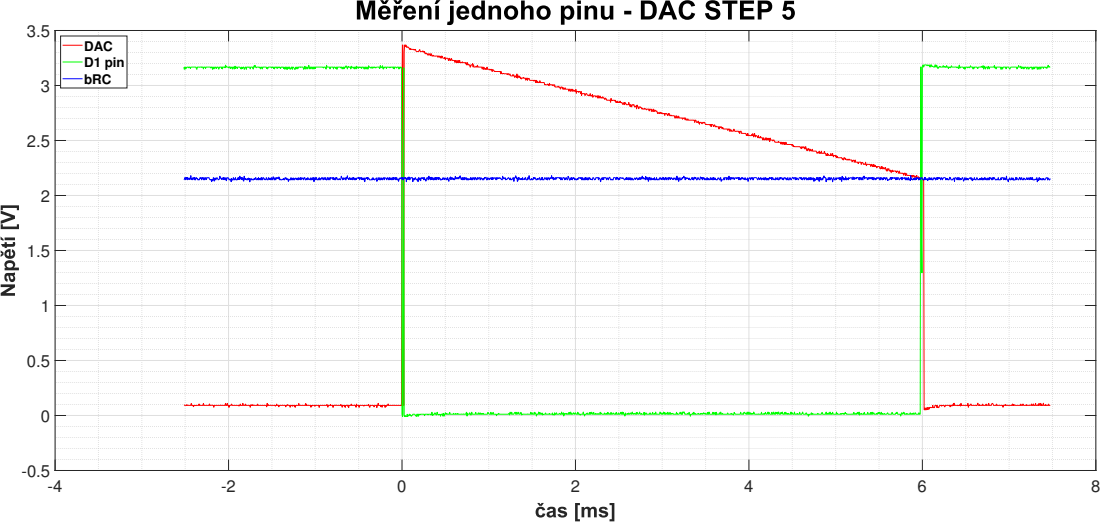
[picture p97: page 1]

DAC
D1 pin
bRC
