FilipPaul/DIPLOMKA/tex/aktualni_19_05_2023/pdf/schema_merici_karta.PDF

## ANALOG MODULE CONTROLED BY MUXES AND SHFT REGISTERS + 96PIN connector

## RESISTANCE MEASUREMENTS

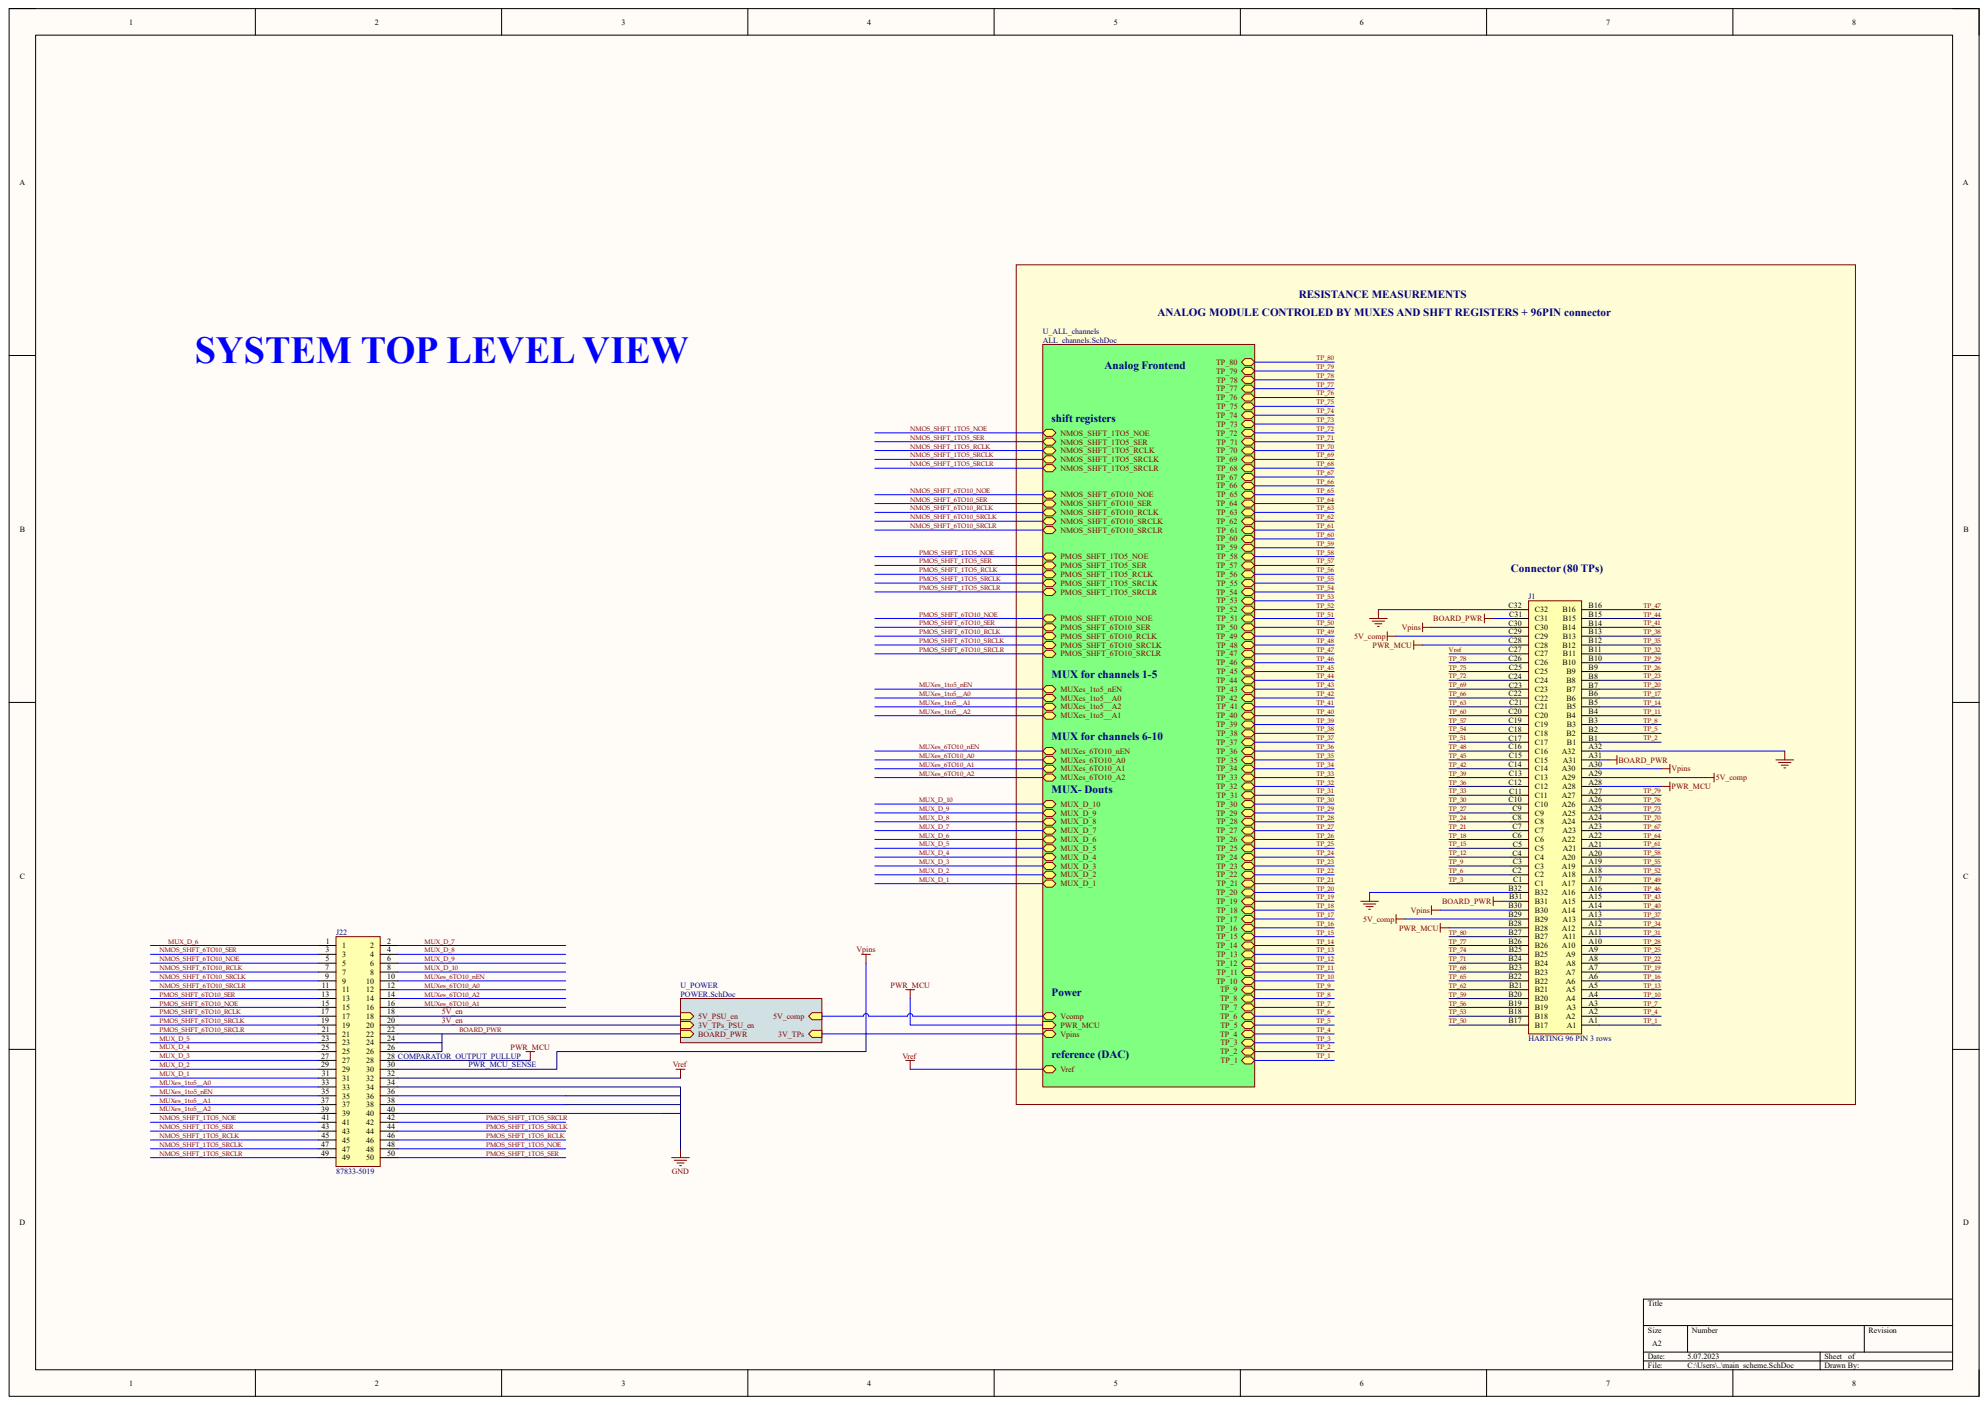
[picture p98: page 1]

SYSTEM TOP LEVEL VIEW

# ALL 80 pins - controlled by 2x5 (for P and N MOSFETS) + 2x5MUXES

## MUX for channels 1-5

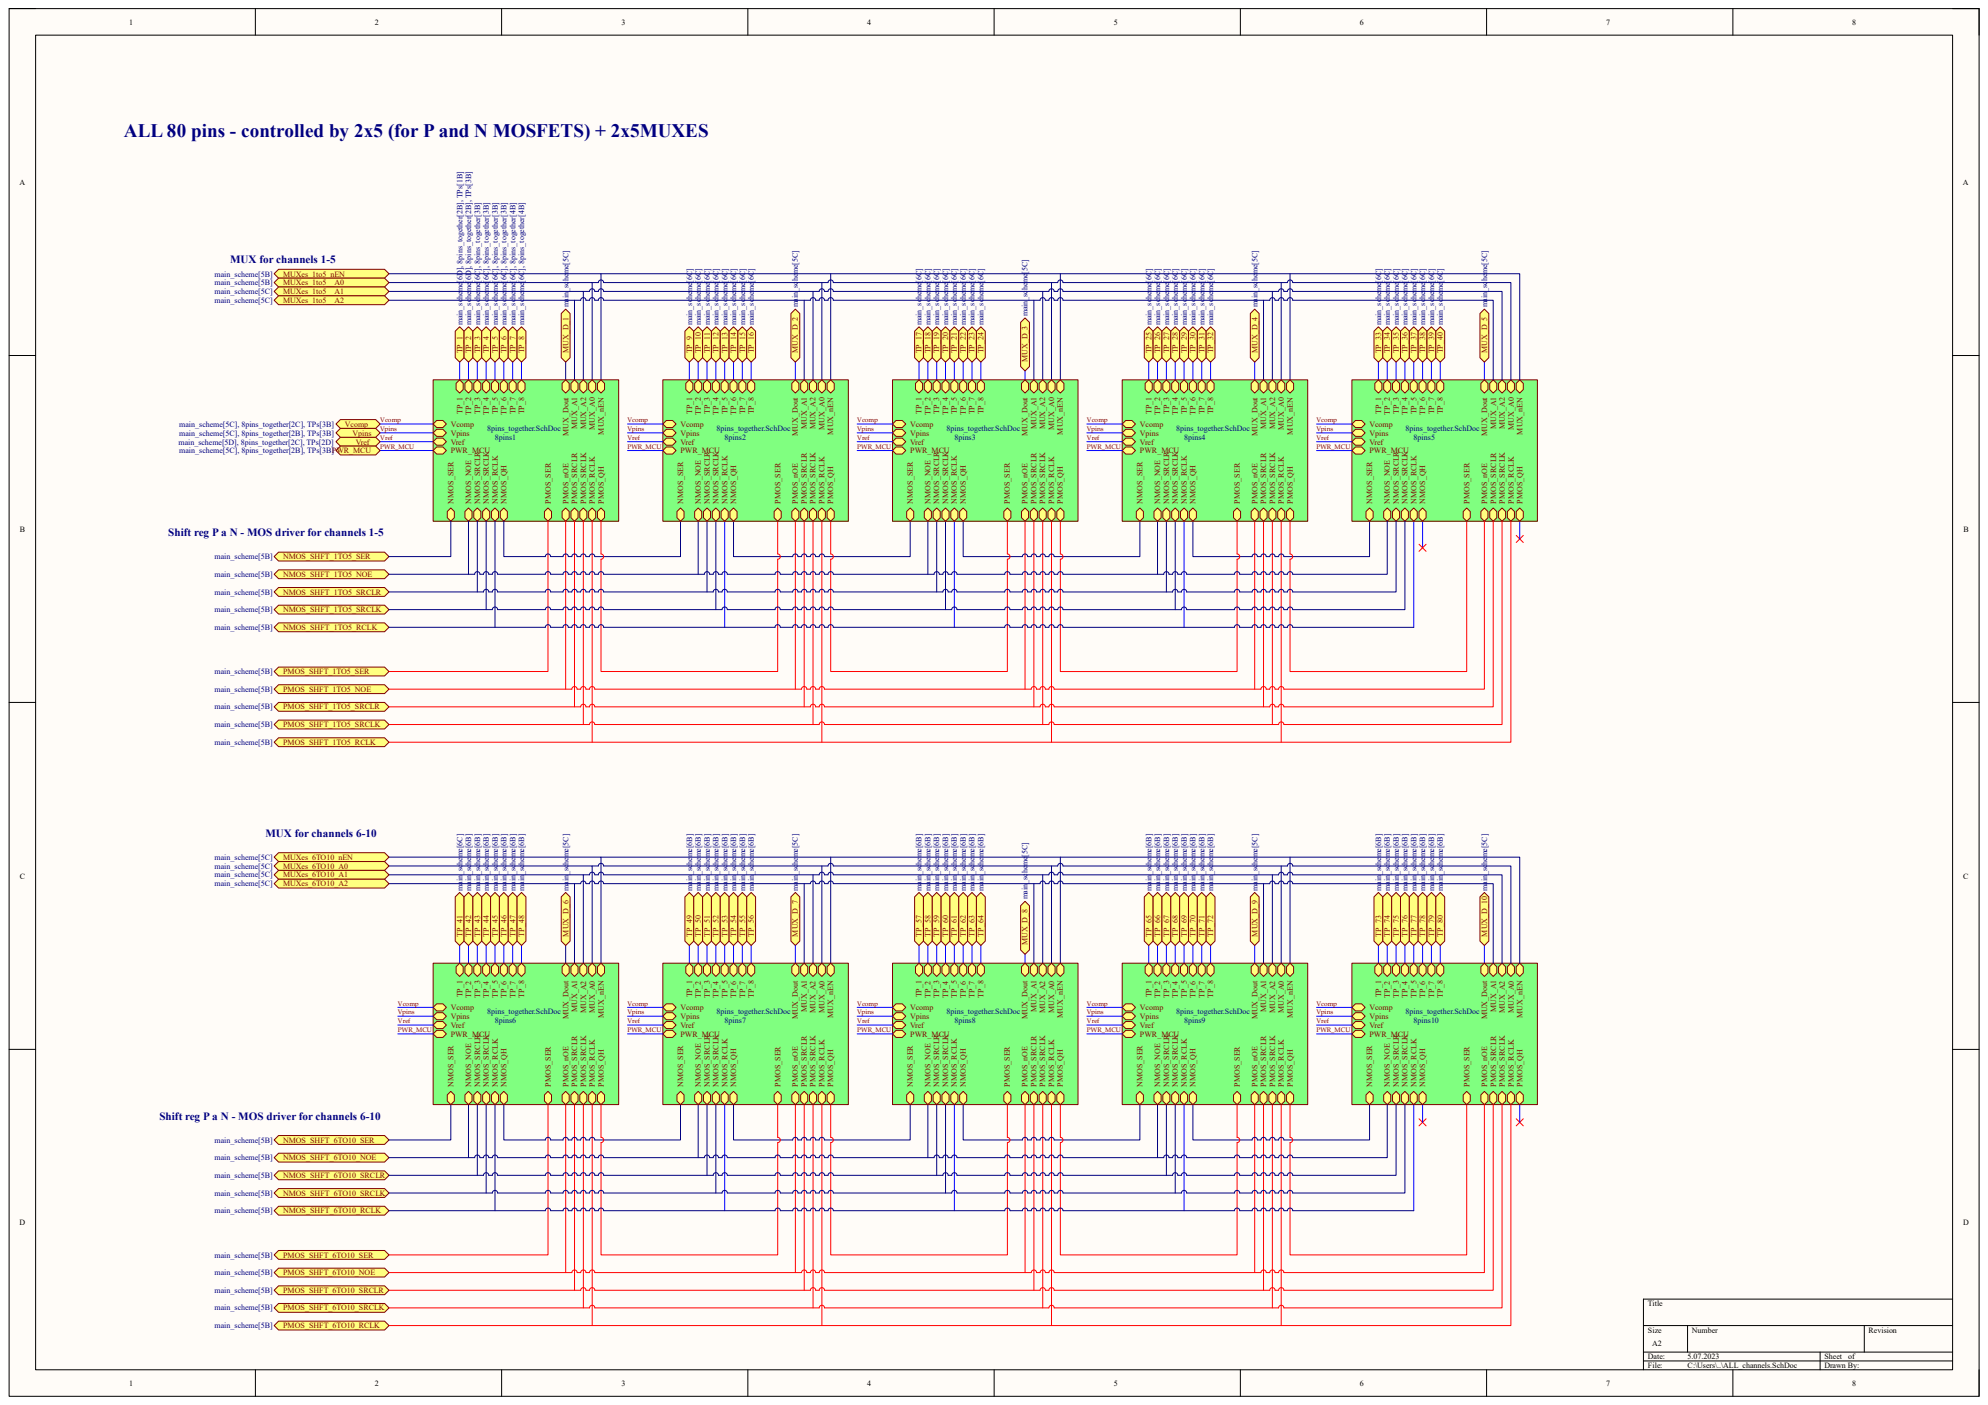
[picture p99: page 2]
Title; File:; C:\Users\..\ALL_channels.SchDoc; Drawn By:; main_scheme[5B] NMOS_SHFT_1TO5_SER; main_scheme[5B] NMOS_SHFT_1TO5_NOE; main_scheme[5B] NMOS_SHFT_1TO5_SRCLR; main_scheme[5B] NMOS_SHFT_1TO5_SRCLK; main_scheme[5B] NMOS_SHFT_1TO5_RCLK; main_scheme[5B] PMOS_SHFT_1TO5_SER; main_scheme[5B] PMOS_SHFT_1TO5_NOE; main_scheme[5B] PMOS_SHFT_1TO5_SRCLR; main_scheme[5B] PMOS_SHFT_1TO5_SRCLK; main_scheme[5B] PMOS_SHFT_1TO5_RCLK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

Shift reg P a N - MOS driver for channels 1-5

MUX for channels 6-10

Shift reg P a N - MOS driver for channels 6-10

A A

U2

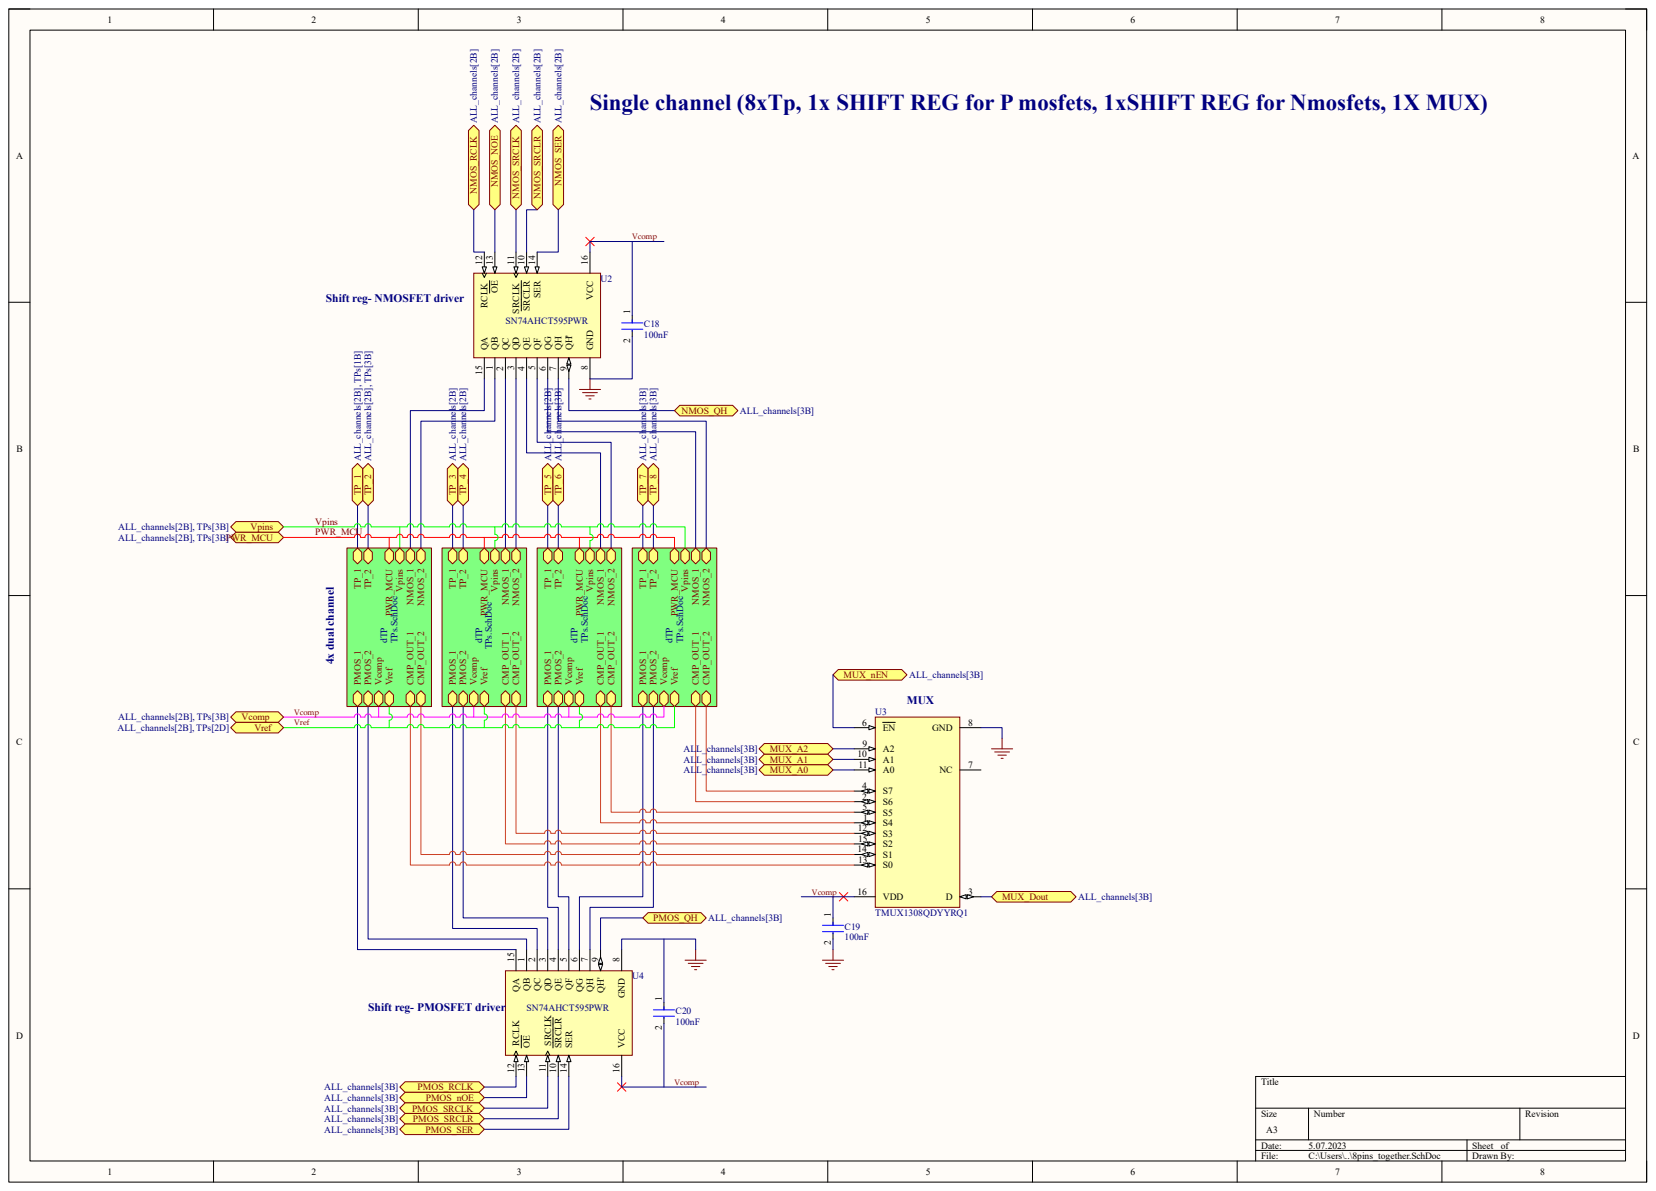
[picture p100: page 3]
Title; File:; C:\Users\..\8pins_together.SchDoc; Drawn By: QB; 7 GND; SN74AHCT595PWR TP_1 ALL_channels[2B], TPs[1B] TP_2 ALL_channels[2B], TPs[3B]; TP_3 ALL_channels[2B] TP_4 ALL_channels[2B]; TP_5 ALL_channels[2B] TP_6 ALL_channels[3B]; TP_7 ALL_channels[3B] TP_8 ALL_channels[3B] NMOS_RCLK ALL_channels[2B]; NMOS_NOE ALL_channels[2B]; NMOS_SRCLK ALL_channels[2B]; NMOS_SRCLR ALL_channels[2B]; NMOS_SER ALL_channels[2B]; NMOS_QH ALL_channels[3B] ¹ ² C18 100nF; ALL_channels[3B]; PMOS_RCLK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

Shift reg- NMOSFET driver 4x dual channel
SN74AHCT595PWR QB

Single channel (8xTp, 1x SHIFT REG for P mosfets, 1xSHIFT REG for Nmosfets, 1X MUX)

8 QH' 9 SRCLR 10 SRCLK 11 RCLK 12 OE 13 SER 14 QA 15 VCC 16 QC

Shift reg- PMOSFET driver

A A

# Analog frontend for 2 channels (dual comparator with P and N MOSFETS)

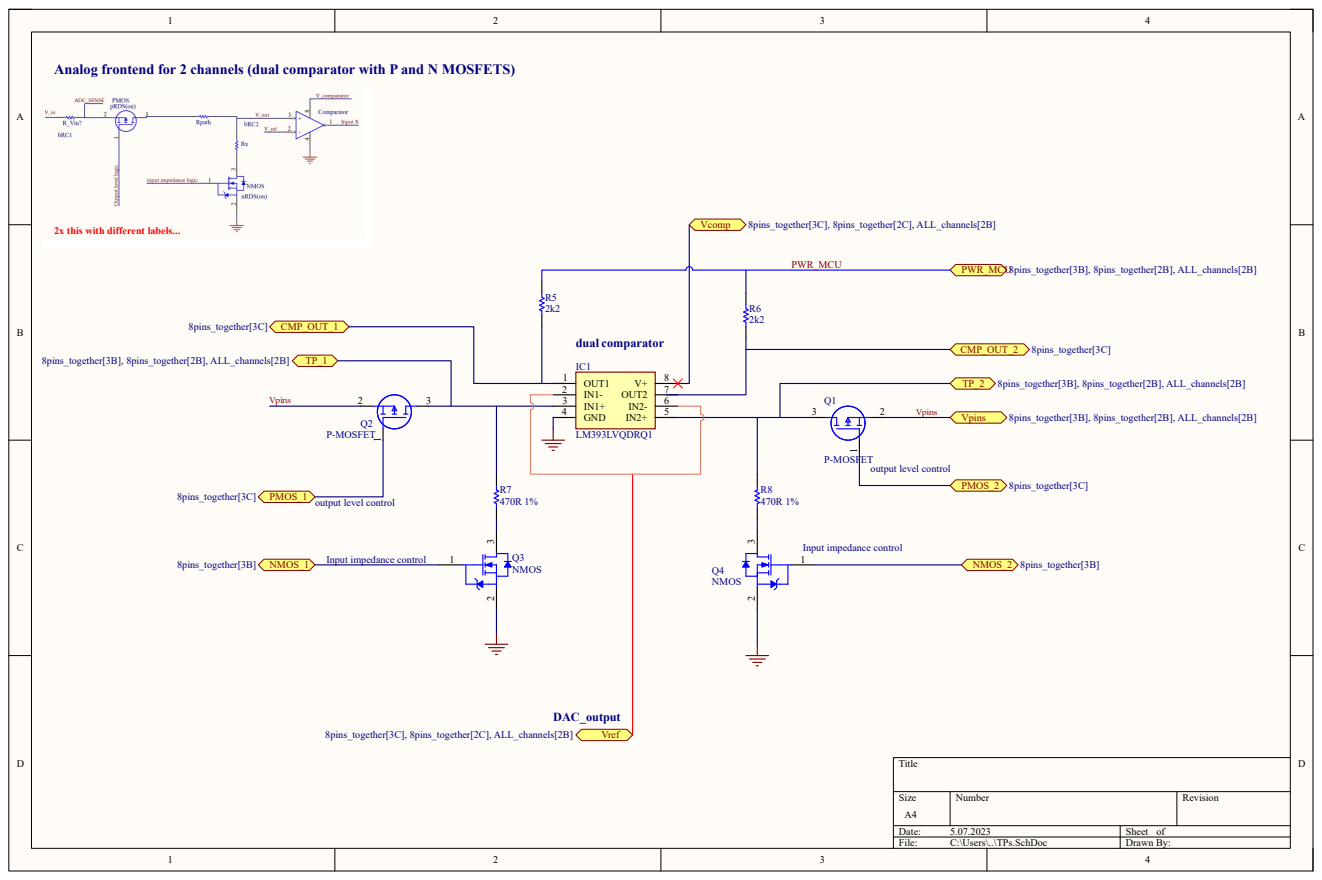
[picture p101: page 4]

2x this with different labels...

A A

## OUT 1

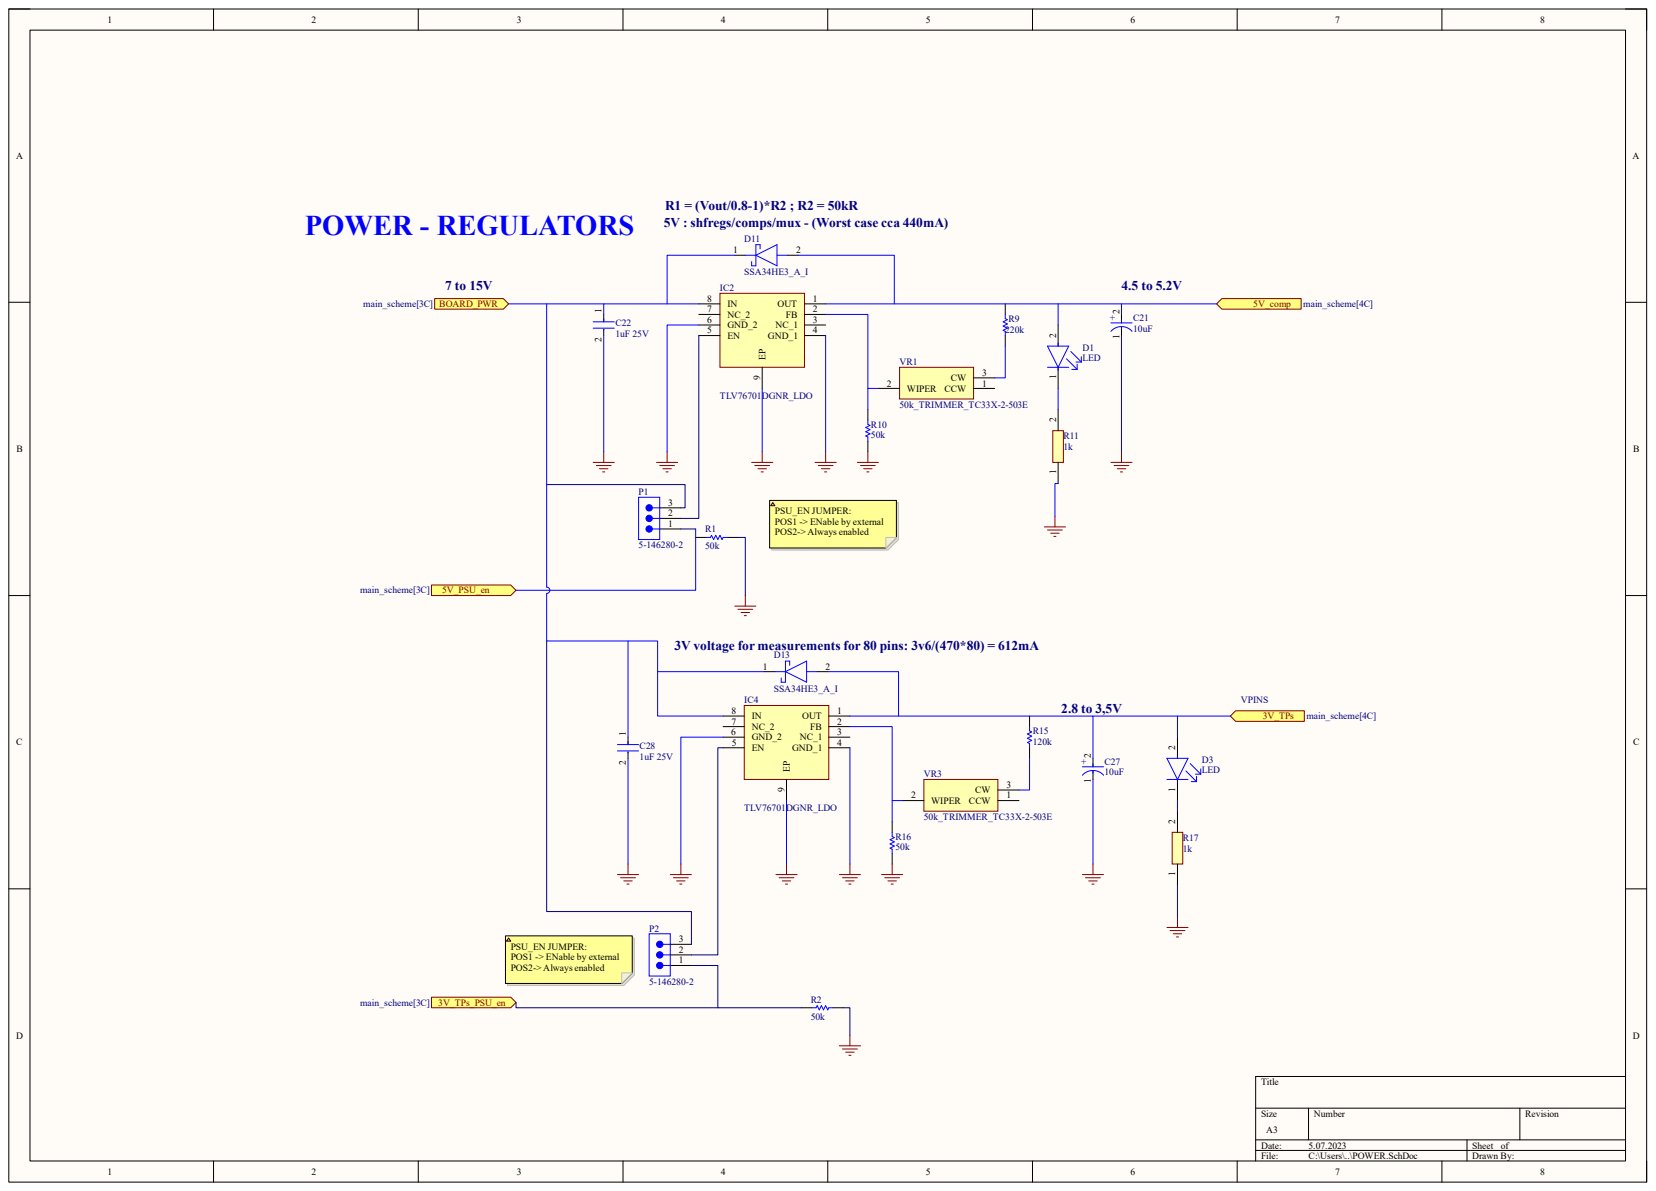
[picture p102: page 5]

R1 = (Vout/0.8-1)*R2 ; R2 = 50kR
5V : shfregs/comps/mux - (Worst case cca 440mA)

3V voltage for measurements for 80 pins: 3v6/(470*80) = 612mA
