FilipPaul/DIPLOMKA/tex/aktualni_19_05_2023/pdf/schema_ovl_karta.PDF

## STM32: DECOUPLING

## RMII ETHERNET CONNECTION

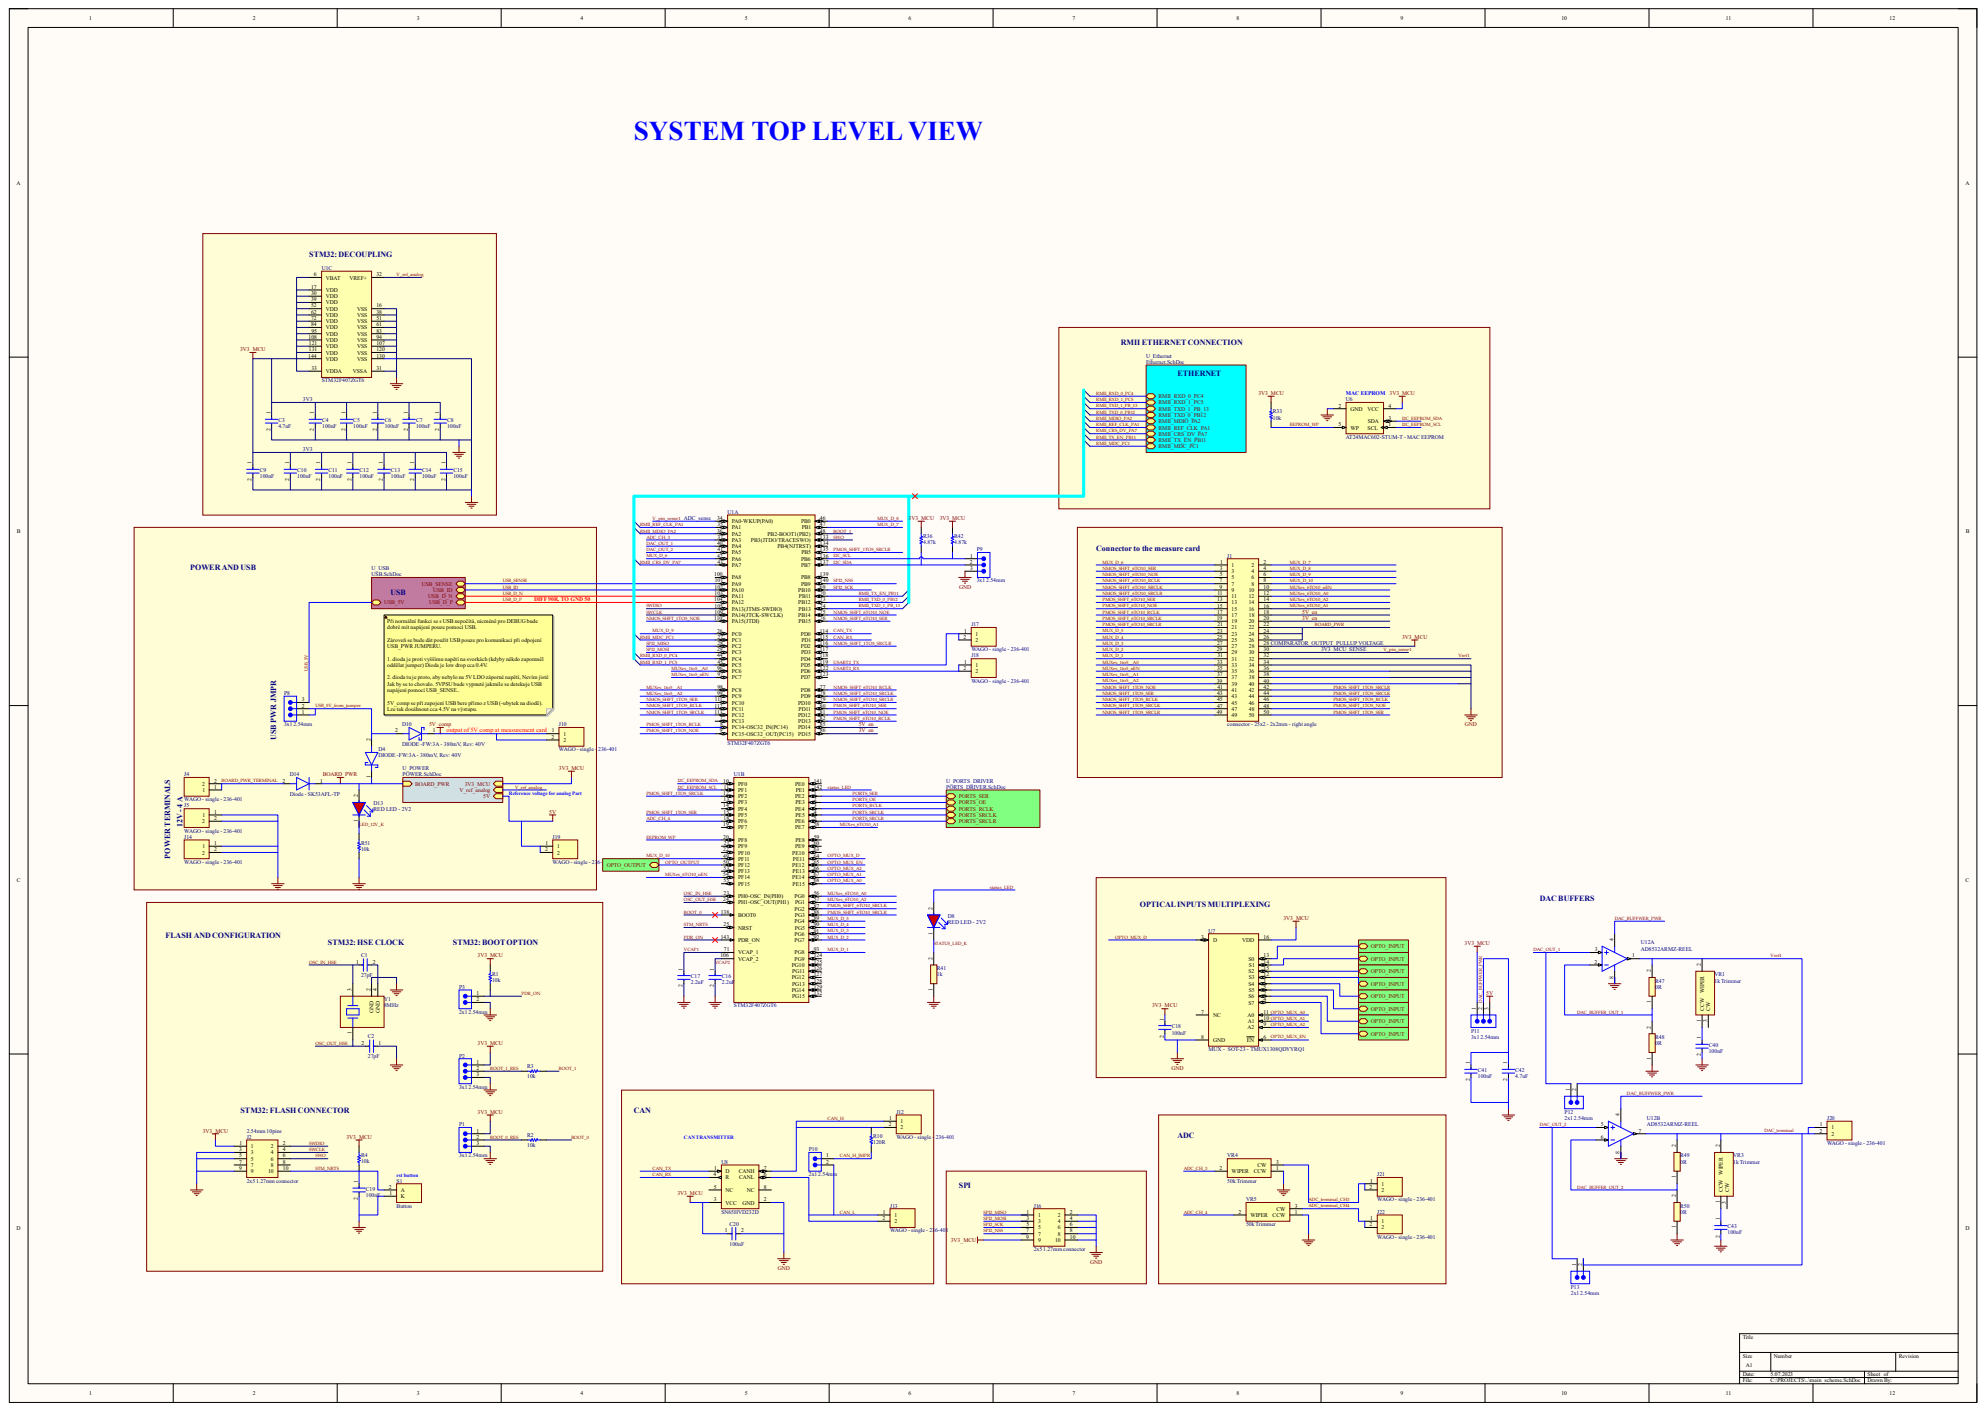
[picture p103: page 1]

SYSTEM TOP LEVEL VIEW

Při normální funkci se s USB nepočítá, nicméně pro DEBUG bude
dobré mít napájení pouze pomocí USB.

Zároveň se bude dát použít USB pouze pro komunikaci při odpojení
USB_PWR JUMPERU.

1. dioda je proti vyššímu napětí na svorkách (kdyby někdo zapomněl
oddělat jumper) Dioda je low drop cca 0.4V.

2. dioda tu je proto, aby nebylo na 5V LDO záporné napětí, Nevím jistě
Jak by se to chovalo. 5VPSU bude vypnuté jakmile se detekuje USB
napájení pomocí USB_SENSE..

5V_comp se při zapojení USB bere přímo z USB (-ubytek na diodě).
Lze tak dosáhnout cca 4.5V na výstupu.

5V_comp
output of 5V comp at measurement card

V_ref_analog
Reference voltage for analog Part

A A

# OPTICAL INPUT

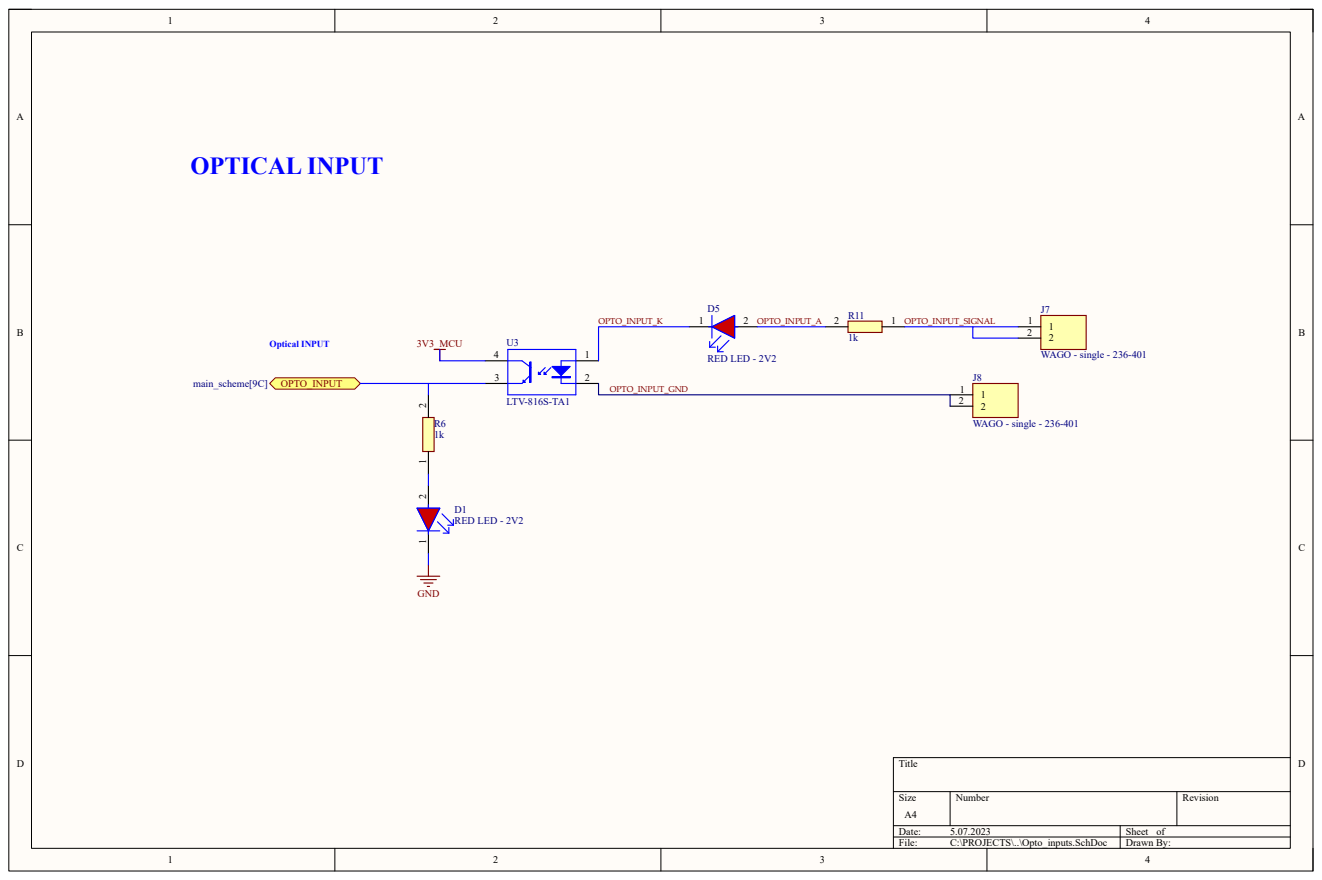
[picture p104: page 2]
Title; Size; Number; Revision; File:; C:\PROJECTS\..\Opto_inputs.SchDoc; Drawn By:; Optical INPUT; LTV-816S-TA1; WAGO - single - 236-401; OPTO_INPUT_GND; OPTO_INPUT_SIGNAL; 3V3_MCU; RED LED - 2V2; OPTO_INPUT_K; OPTO_INPUT_A; main_scheme[9C] OPTO_INPUT; D1 RED LED - 2V2; GND

A A

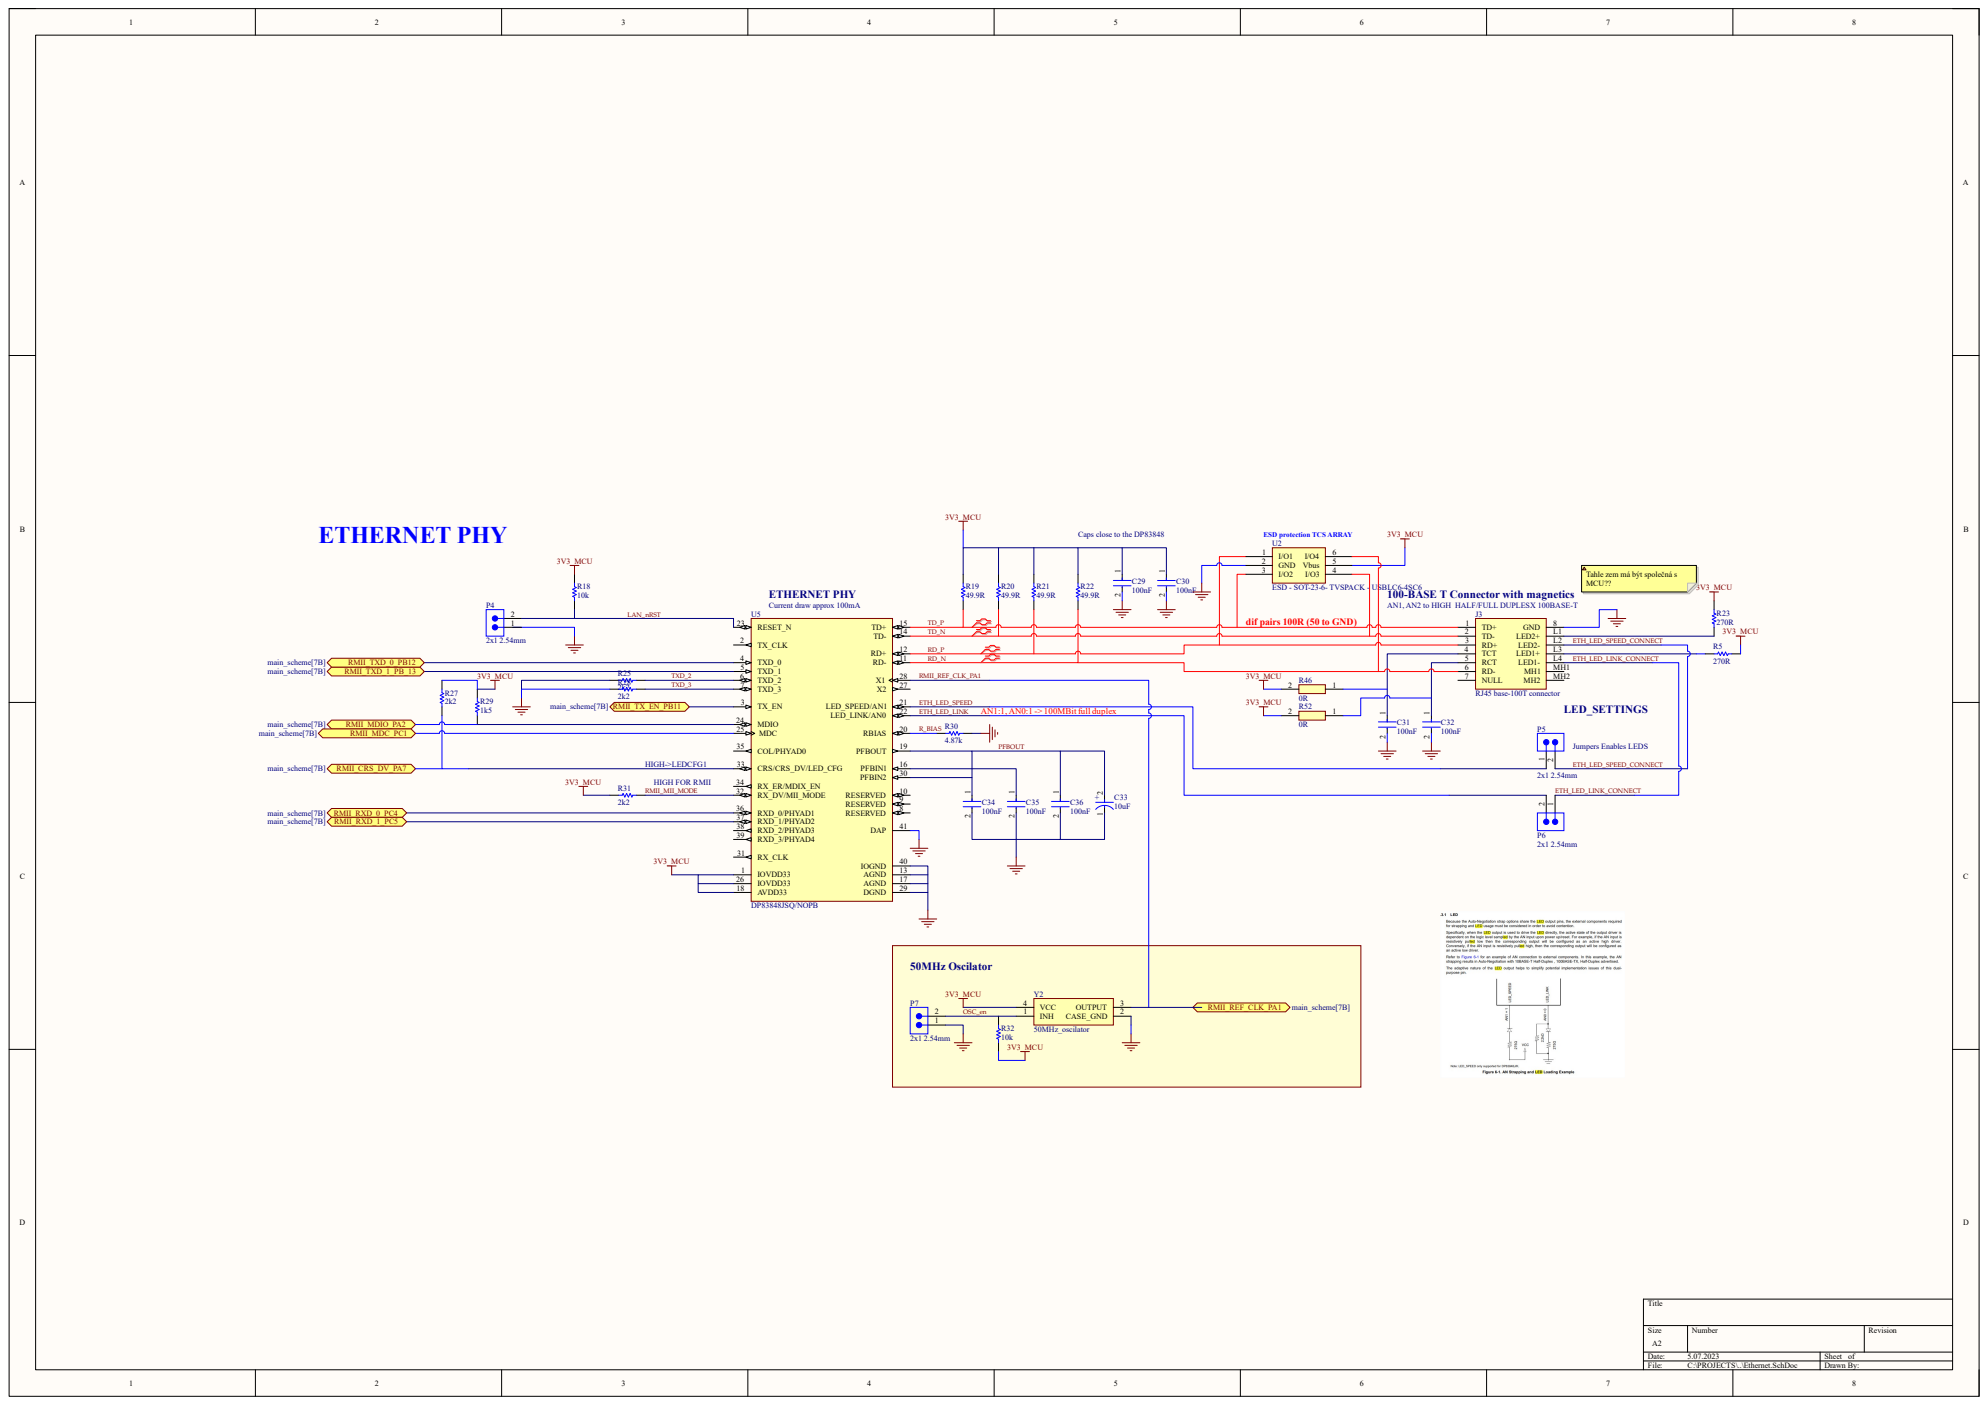
[picture p105: page 3]

Caps close to the DP83848

Tahle zem má být společná s
MCU??

100-BASE T Connector with magnetics
AN1, AN2 to HIGH HALF/FULL DUPLESX 100BASE-T

dif pairs 100R (50 to GND)

A A

R12

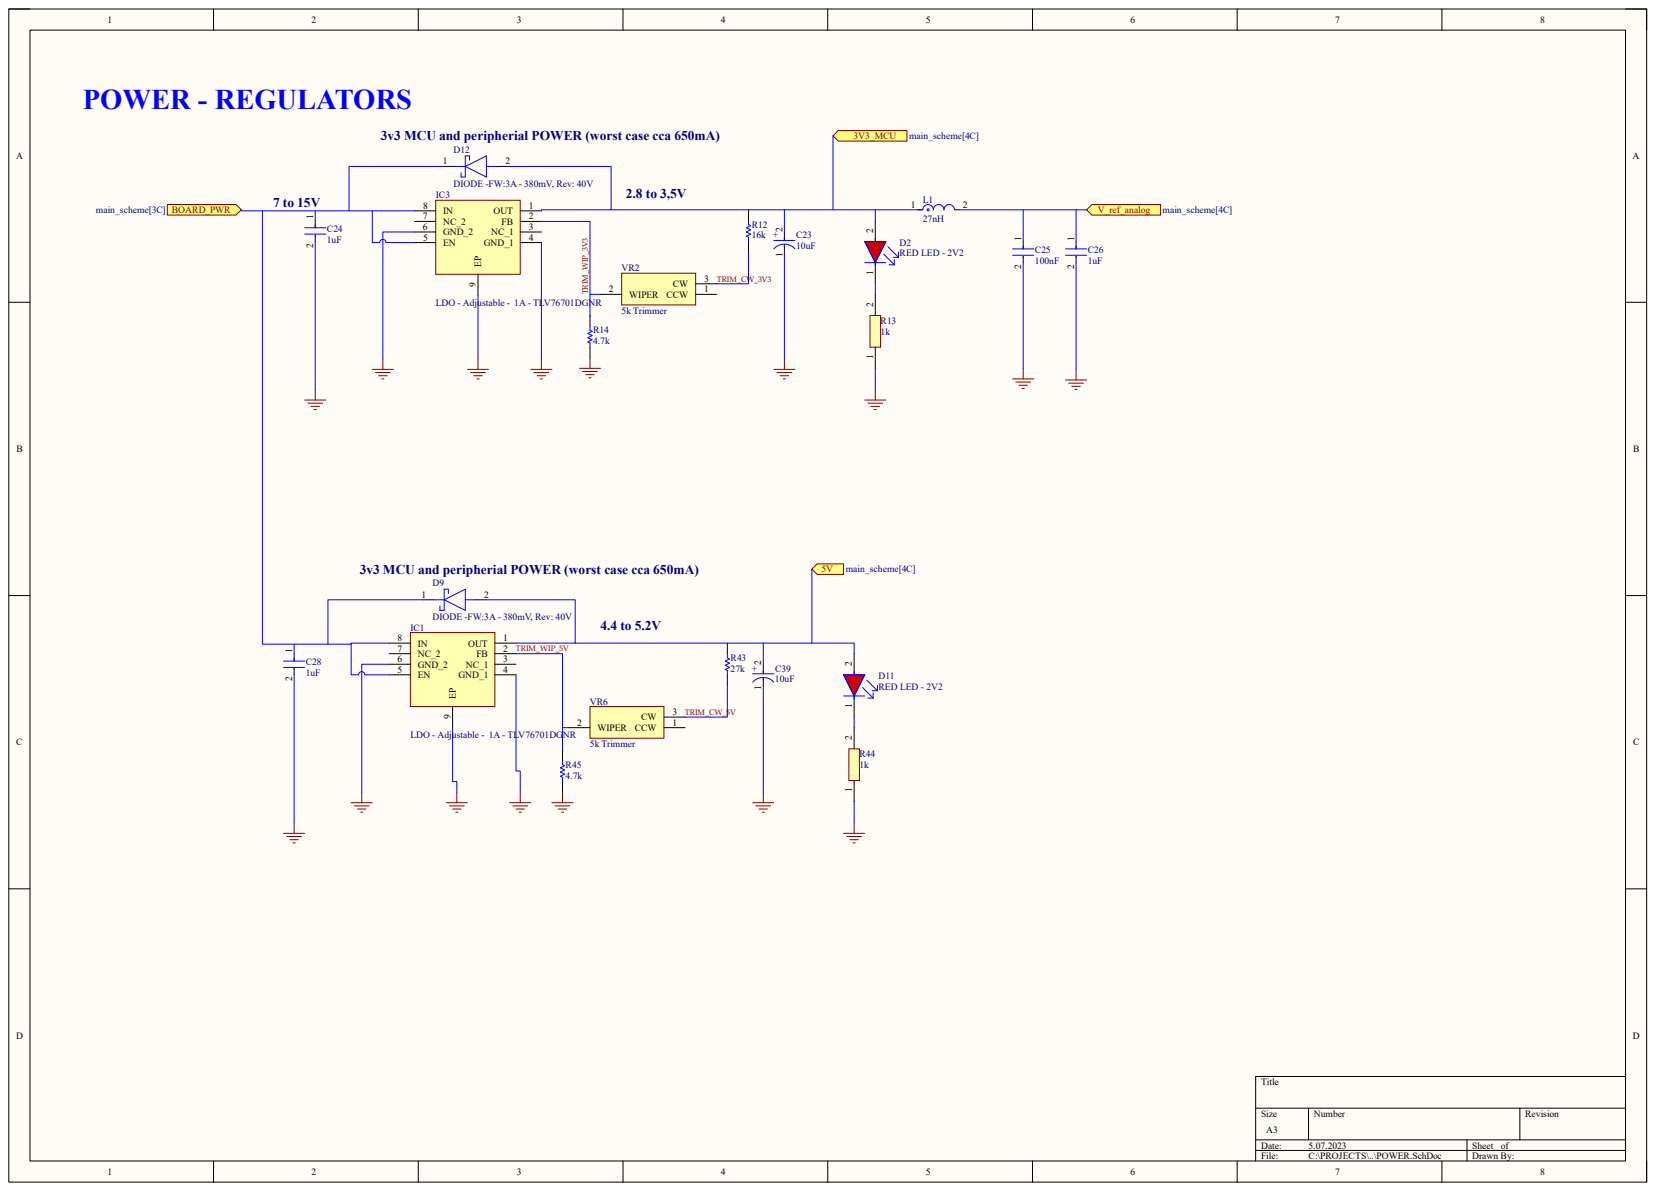
[picture p106: page 4]

3v3 MCU and peripherial POWER (worst case cca 650mA)

A A

# Optical Output 2 1

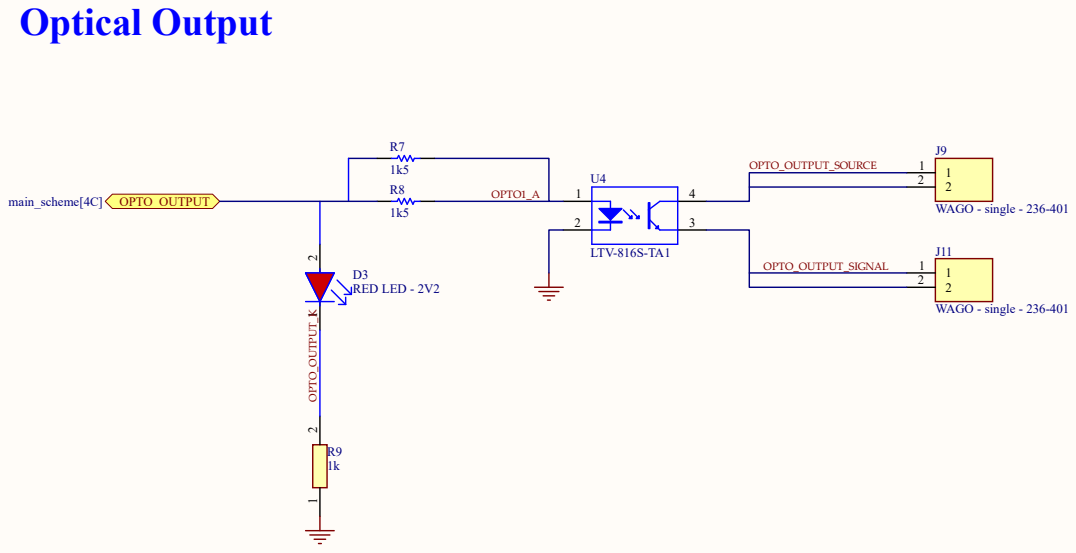
[picture p107: page 5]
Title; Size; Number; Revision; File:; C:\PROJECTS\..\Opto_outputs.SchDoc; Drawn By:; LTV-816S-TA1; WAGO - single - 236-401; OPTO_OUTPUT_SOURCE; OPTO1_A; D3 RED LED - 2V2 1 2; 1k OPTO_OUTPUT_K; OPTO_OUTPUT_SIGNAL; main_scheme[4C] OPTO_OUTPUT

A A

# GND 8

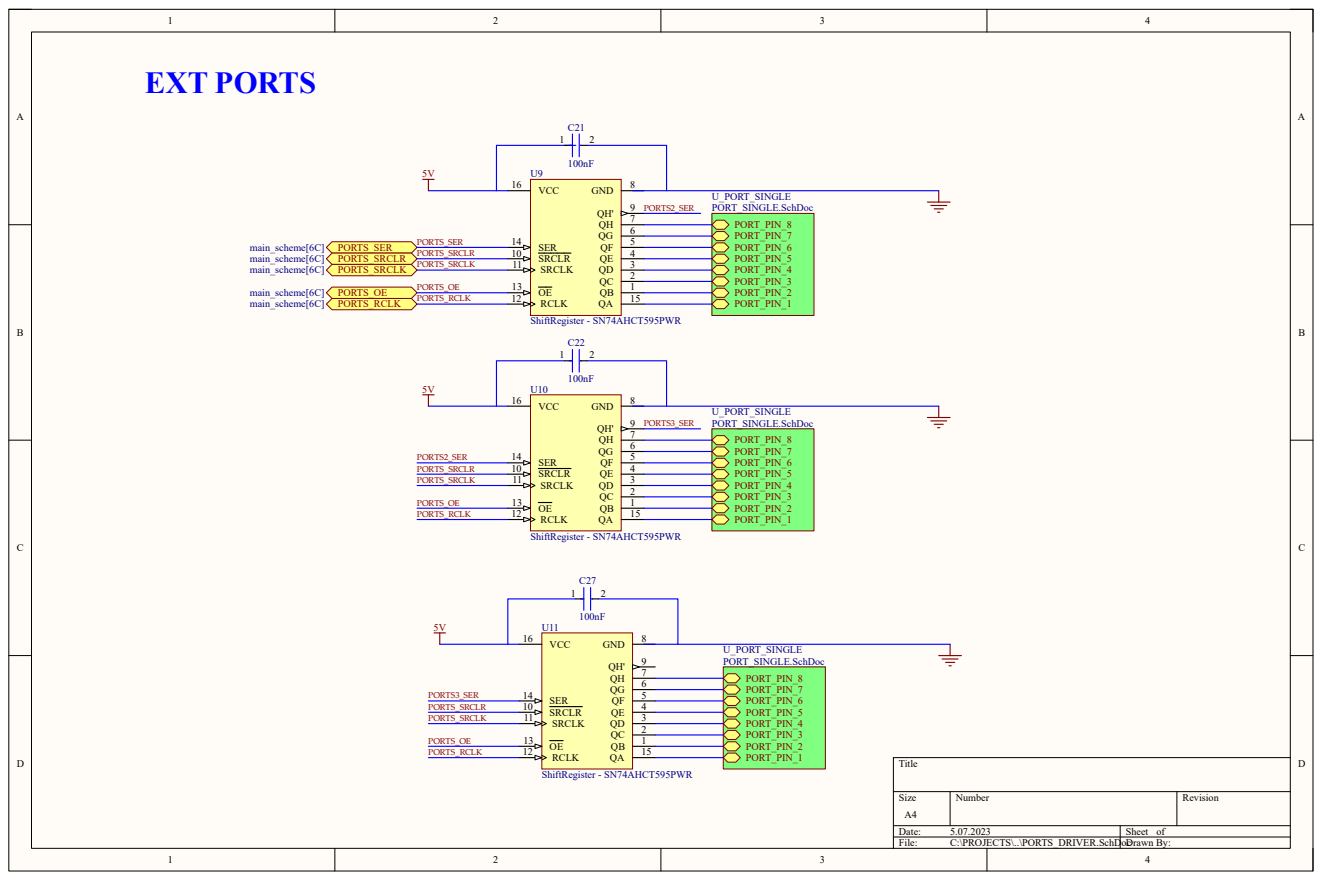
[picture p108: page 6]
Title; Size; Number; Revision; File:; C:\PROJECTS\..\PORTS_DRIVER.SchDocDrawn By:; SRCLR 10 SRCLK 11; RCLK 12; SER 14; VCC 16; ShiftRegister - SN74AHCT595PWR; PORTS_SER PORTS_SRCLR PORTS_SRCLK; PORTS_OE; PORTS_RCLK; PORT_PIN_1; PORT_PIN_2; PORT_PIN_3; PORT_PIN_4; PORT_PIN_5; PORT_PIN_6; PORT_PIN_7; PORT_PIN_8; U_PORT_SINGLE; PORTS2_SER; PORT_SINGLE.SchDoc; GND; PORTS2_SER PORTS_SRCLR PORTS_SRCLK; PORTS3_SER; PORTS3_SER PORTS_SRCLR PORTS_SRCLK; U_PORT_SINGLE PORT_SINGLE.SchDoc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

A A

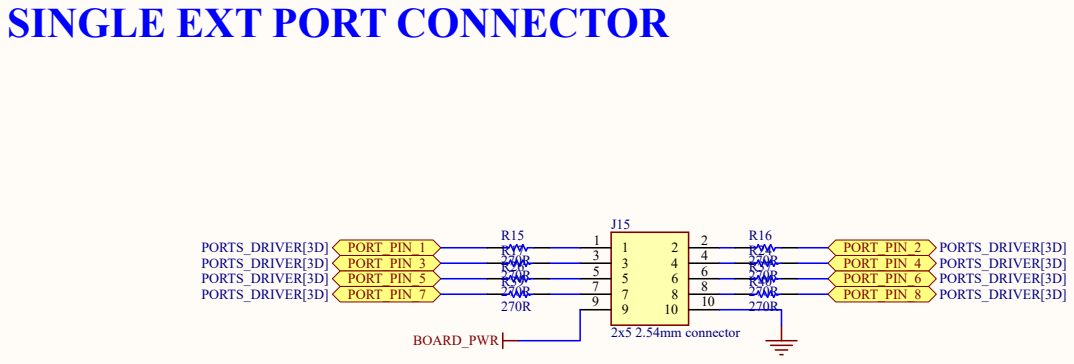
[picture p109: page 7]

SINGLE EXT PORT CONNECTOR

A A

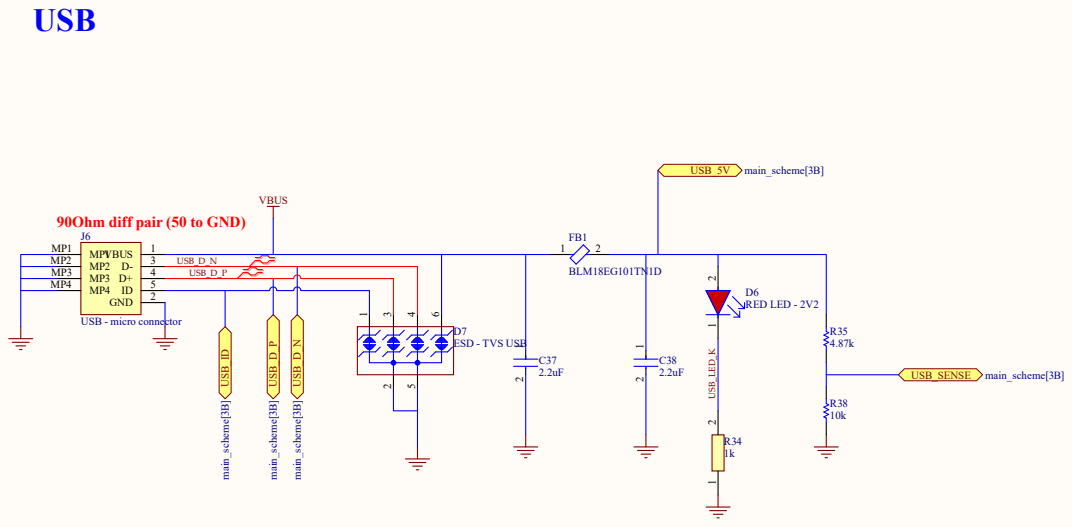
[picture p110: page 8]
