FilipPaul/DIPLOMKA/tex/aktualni_19_05_2023/obrazky/matlab_generated/all_pins-eps-converted-to.pdf

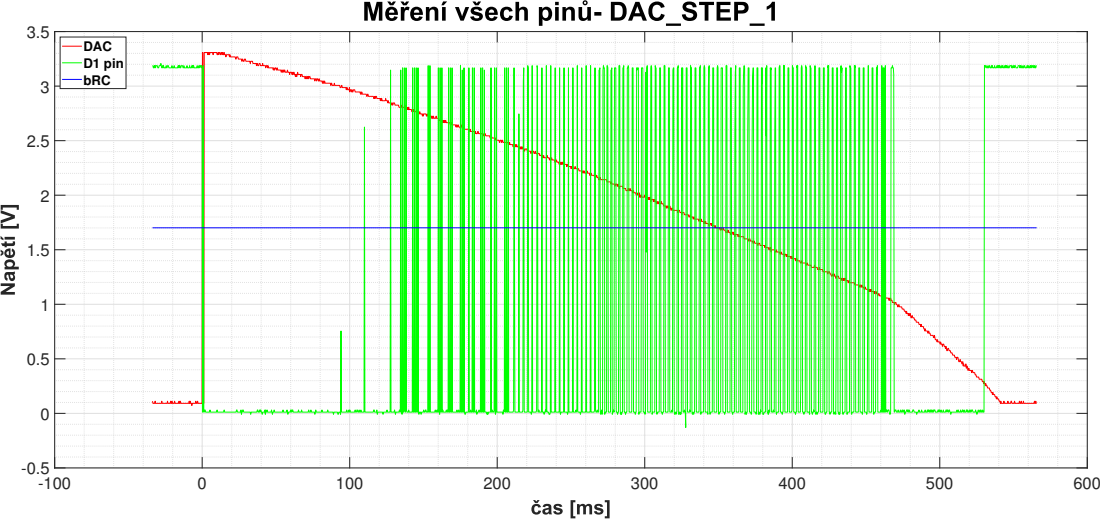
[picture p111: page 1]

DAC
D1 pin
bRC
