FilipPaul/DIPLOMKA/tex/aktualni_19_05_2023/obrazky/matlab_generated/pin_out_of_range-eps-converted-to.pdf

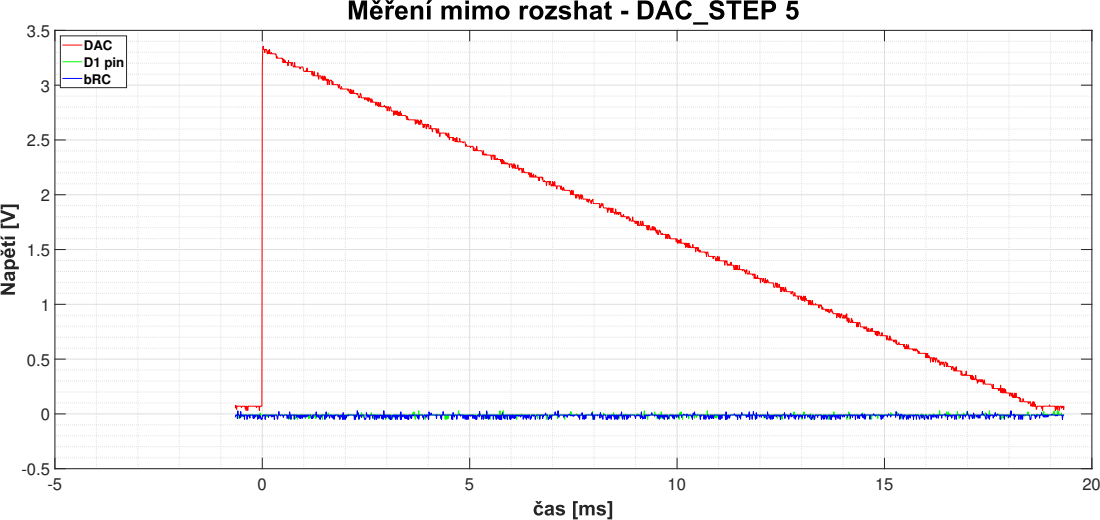
[picture p112: page 1]

DAC
D1 pin
bRC
