FilipPaul/DIPLOMKA/PCB_merici_karta/Project Outputs for diplomka_hiearchical/Assembly Drawings.PDF

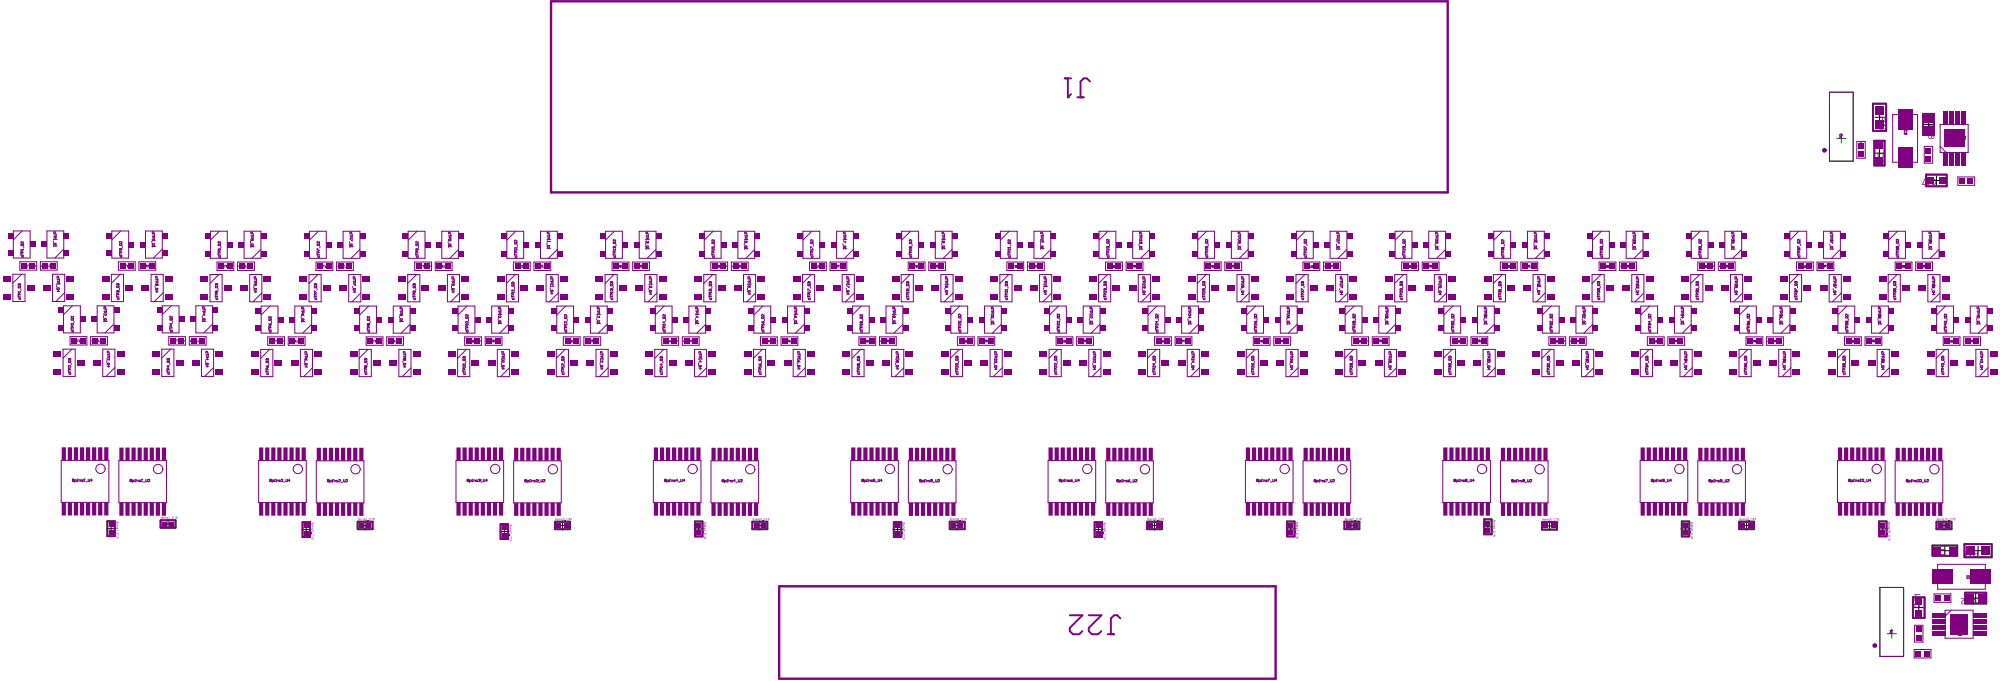
[picture p114: page 1]

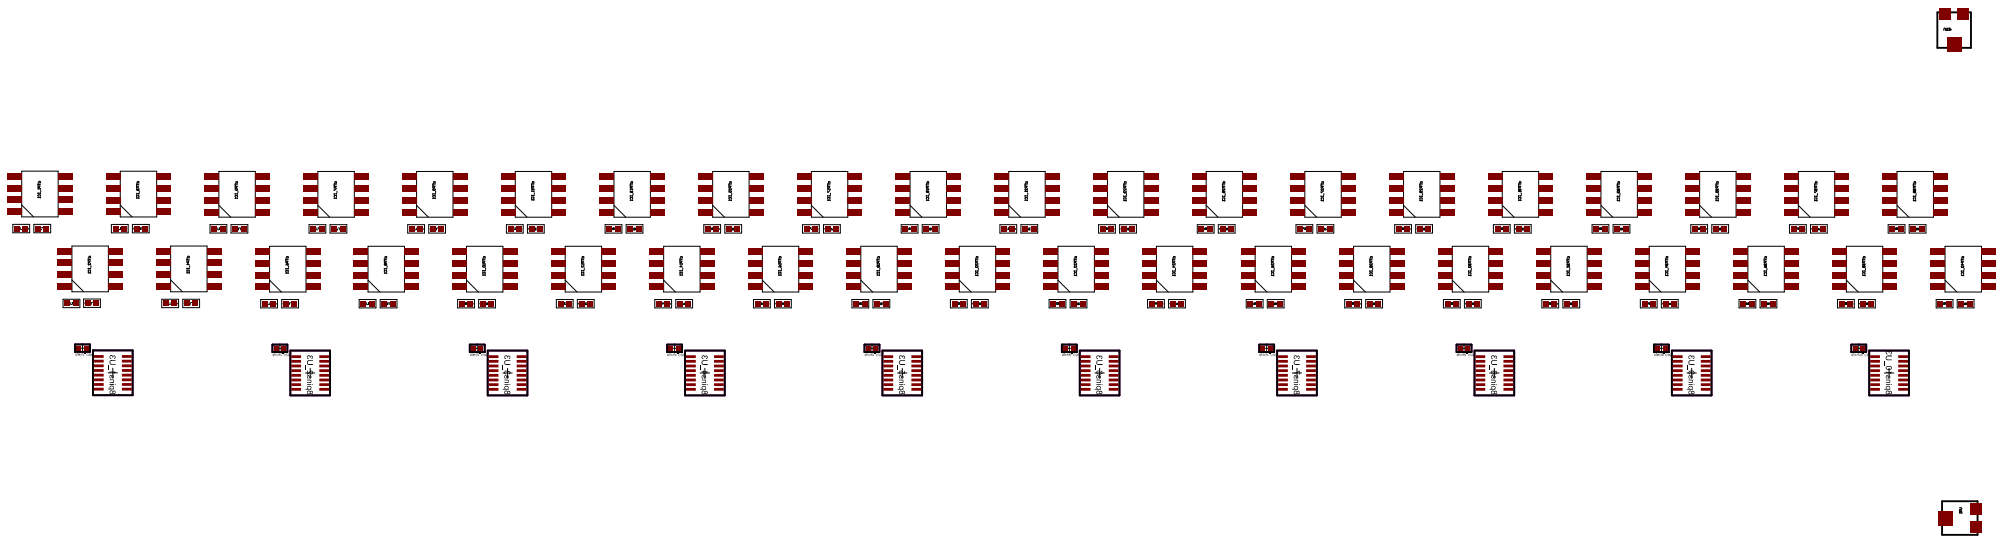
[picture p115: page 2]
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
