FilipPaul/DIPLOMKA/PCB_merici_karta/Project Outputs for diplomka_hiearchical/PCB Print/Guides.PDF

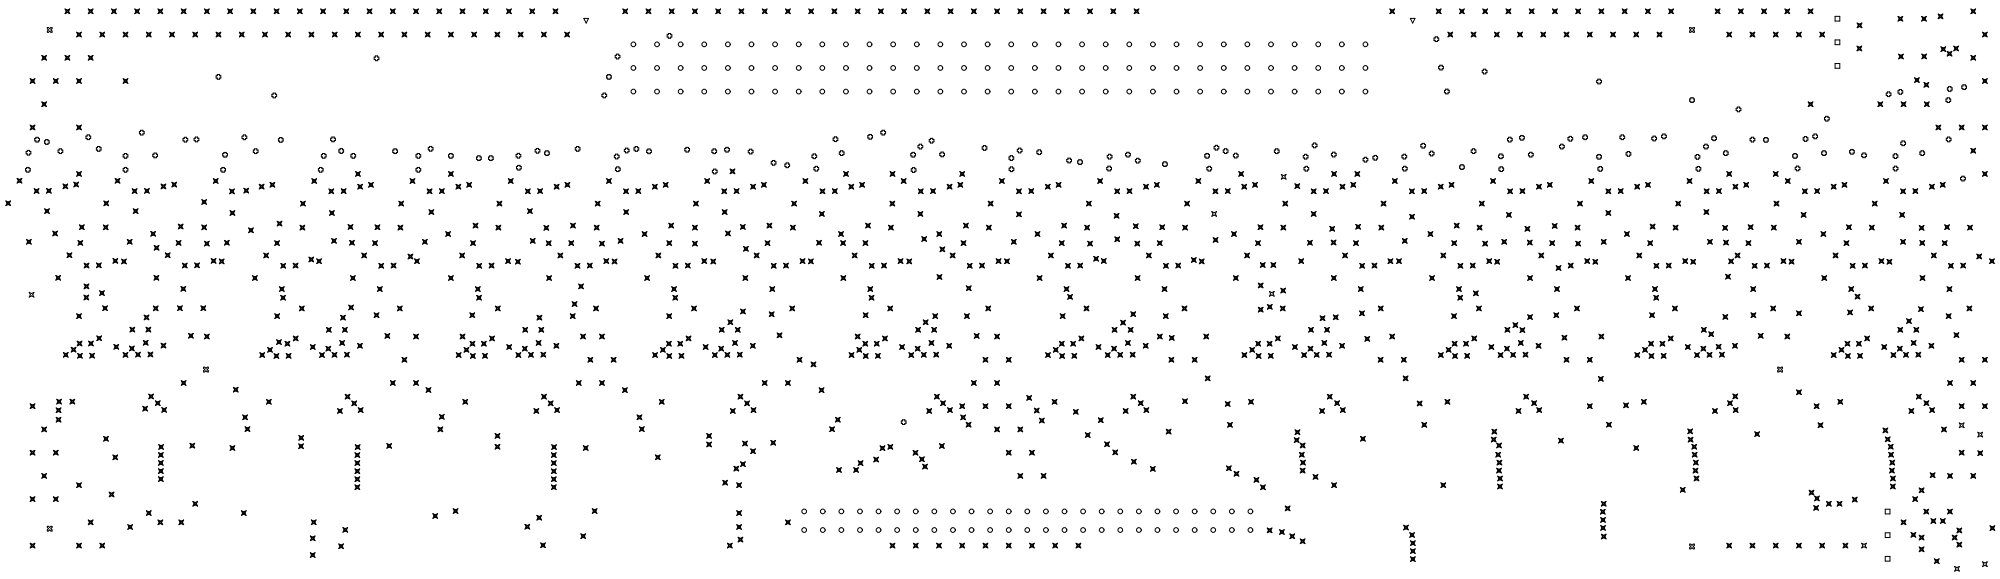
[picture p116: page 1]

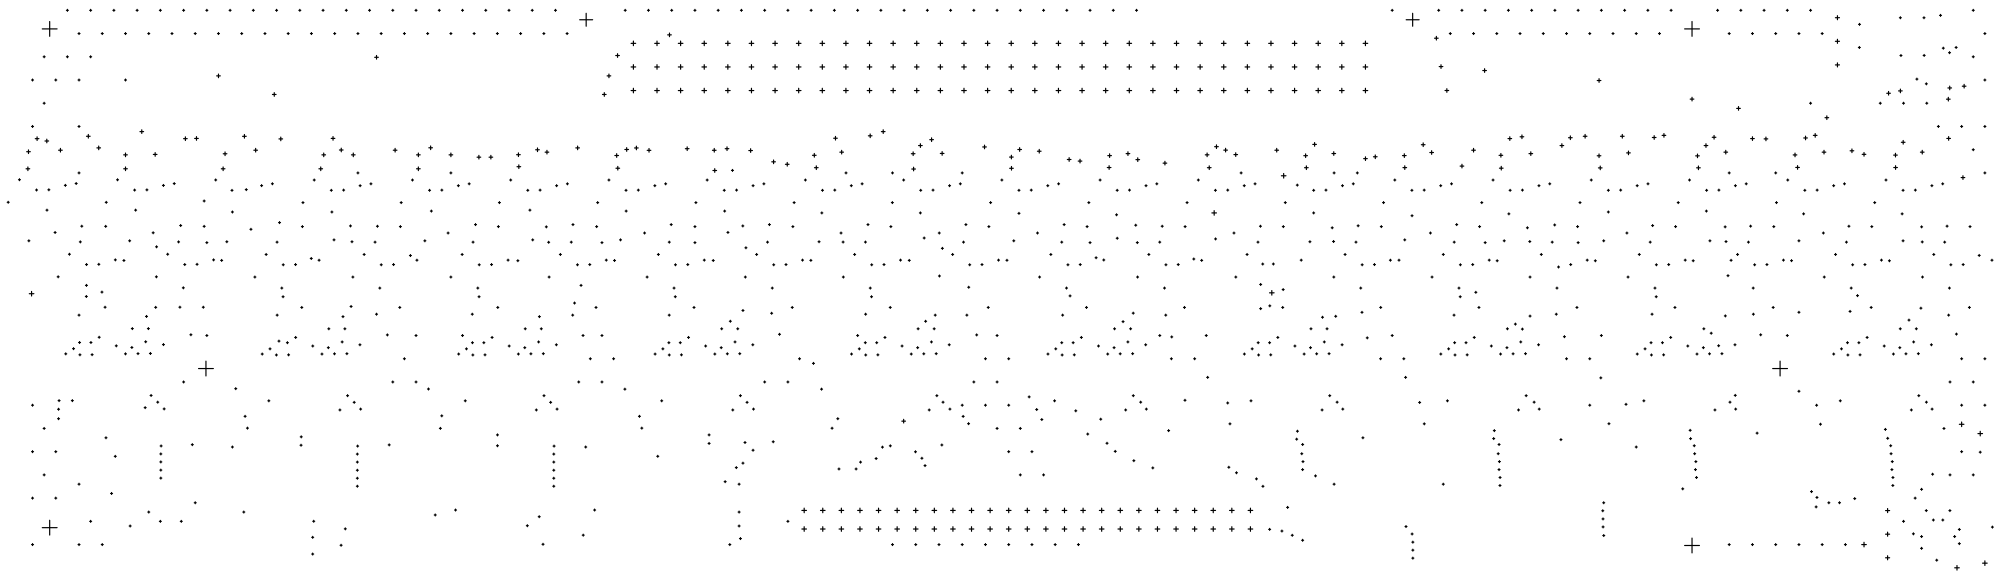
[picture p117: page 2]
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
