FilipPaul/DIPLOMKA/PCB_ovladaci_karta/Ovladaci_karta/Project Outputs for Ovladaci_karta/PCB Print/Assembly Drawings.PDF

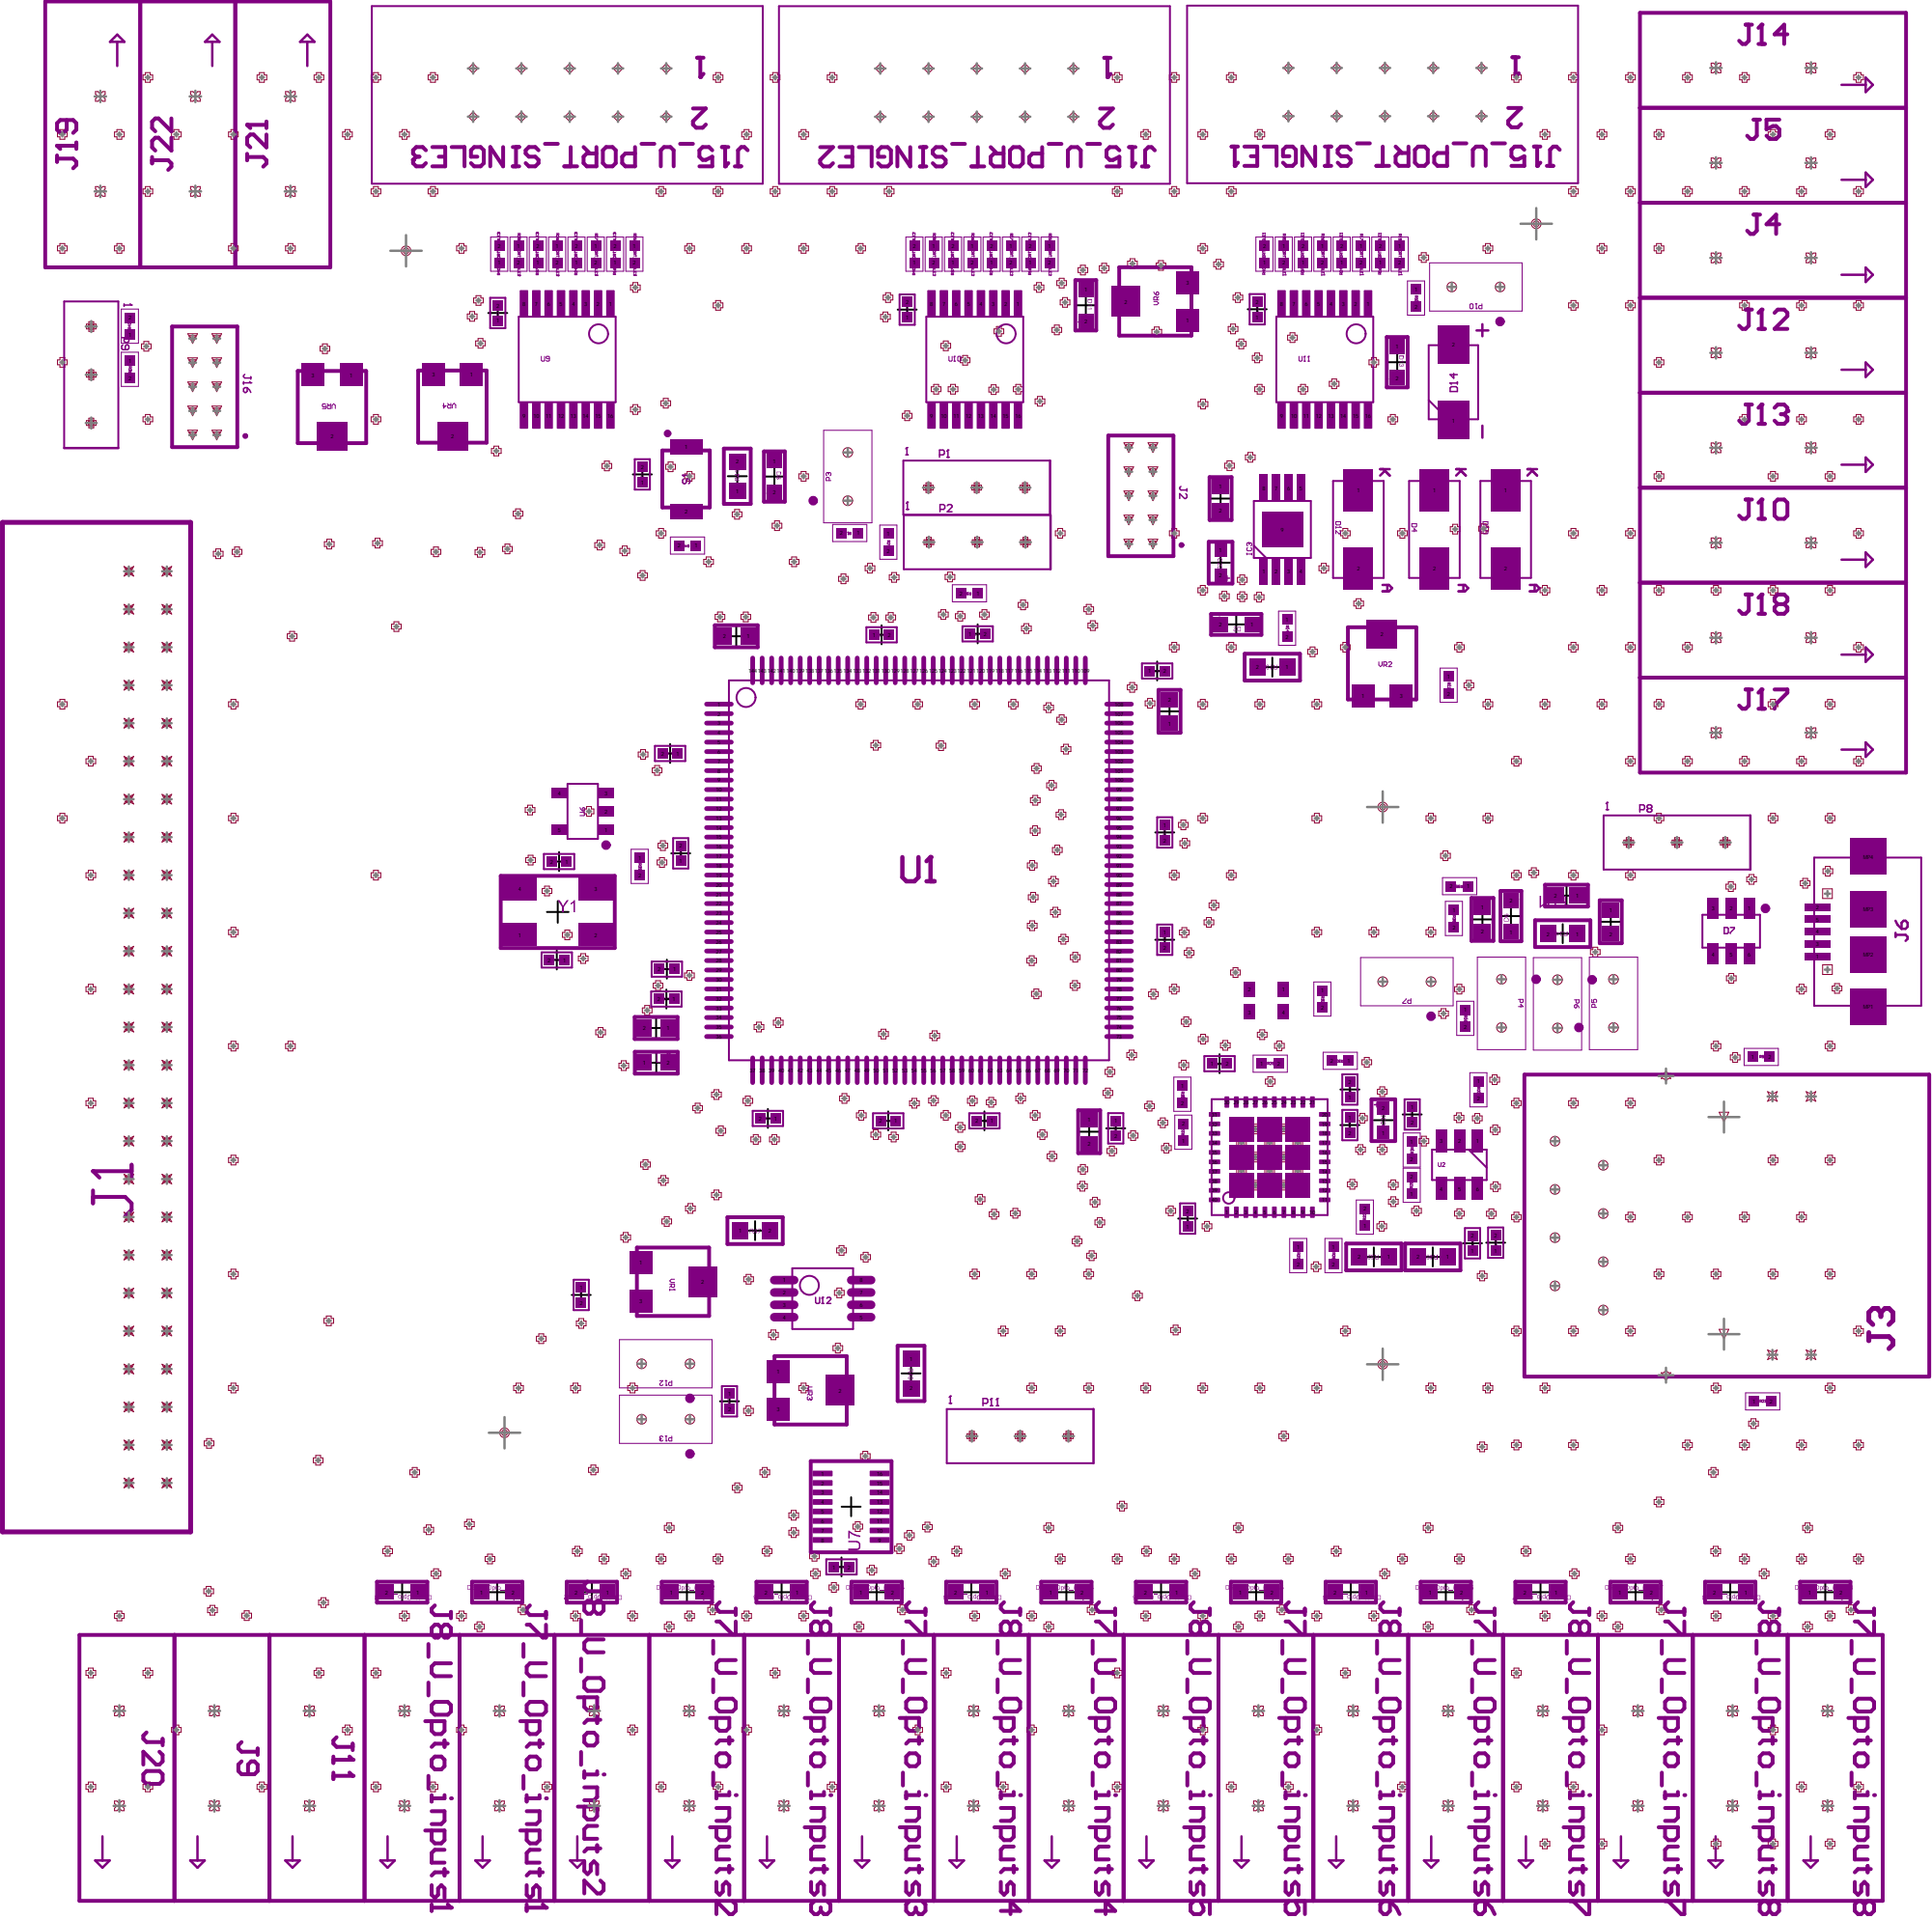
[picture p118: page 1]

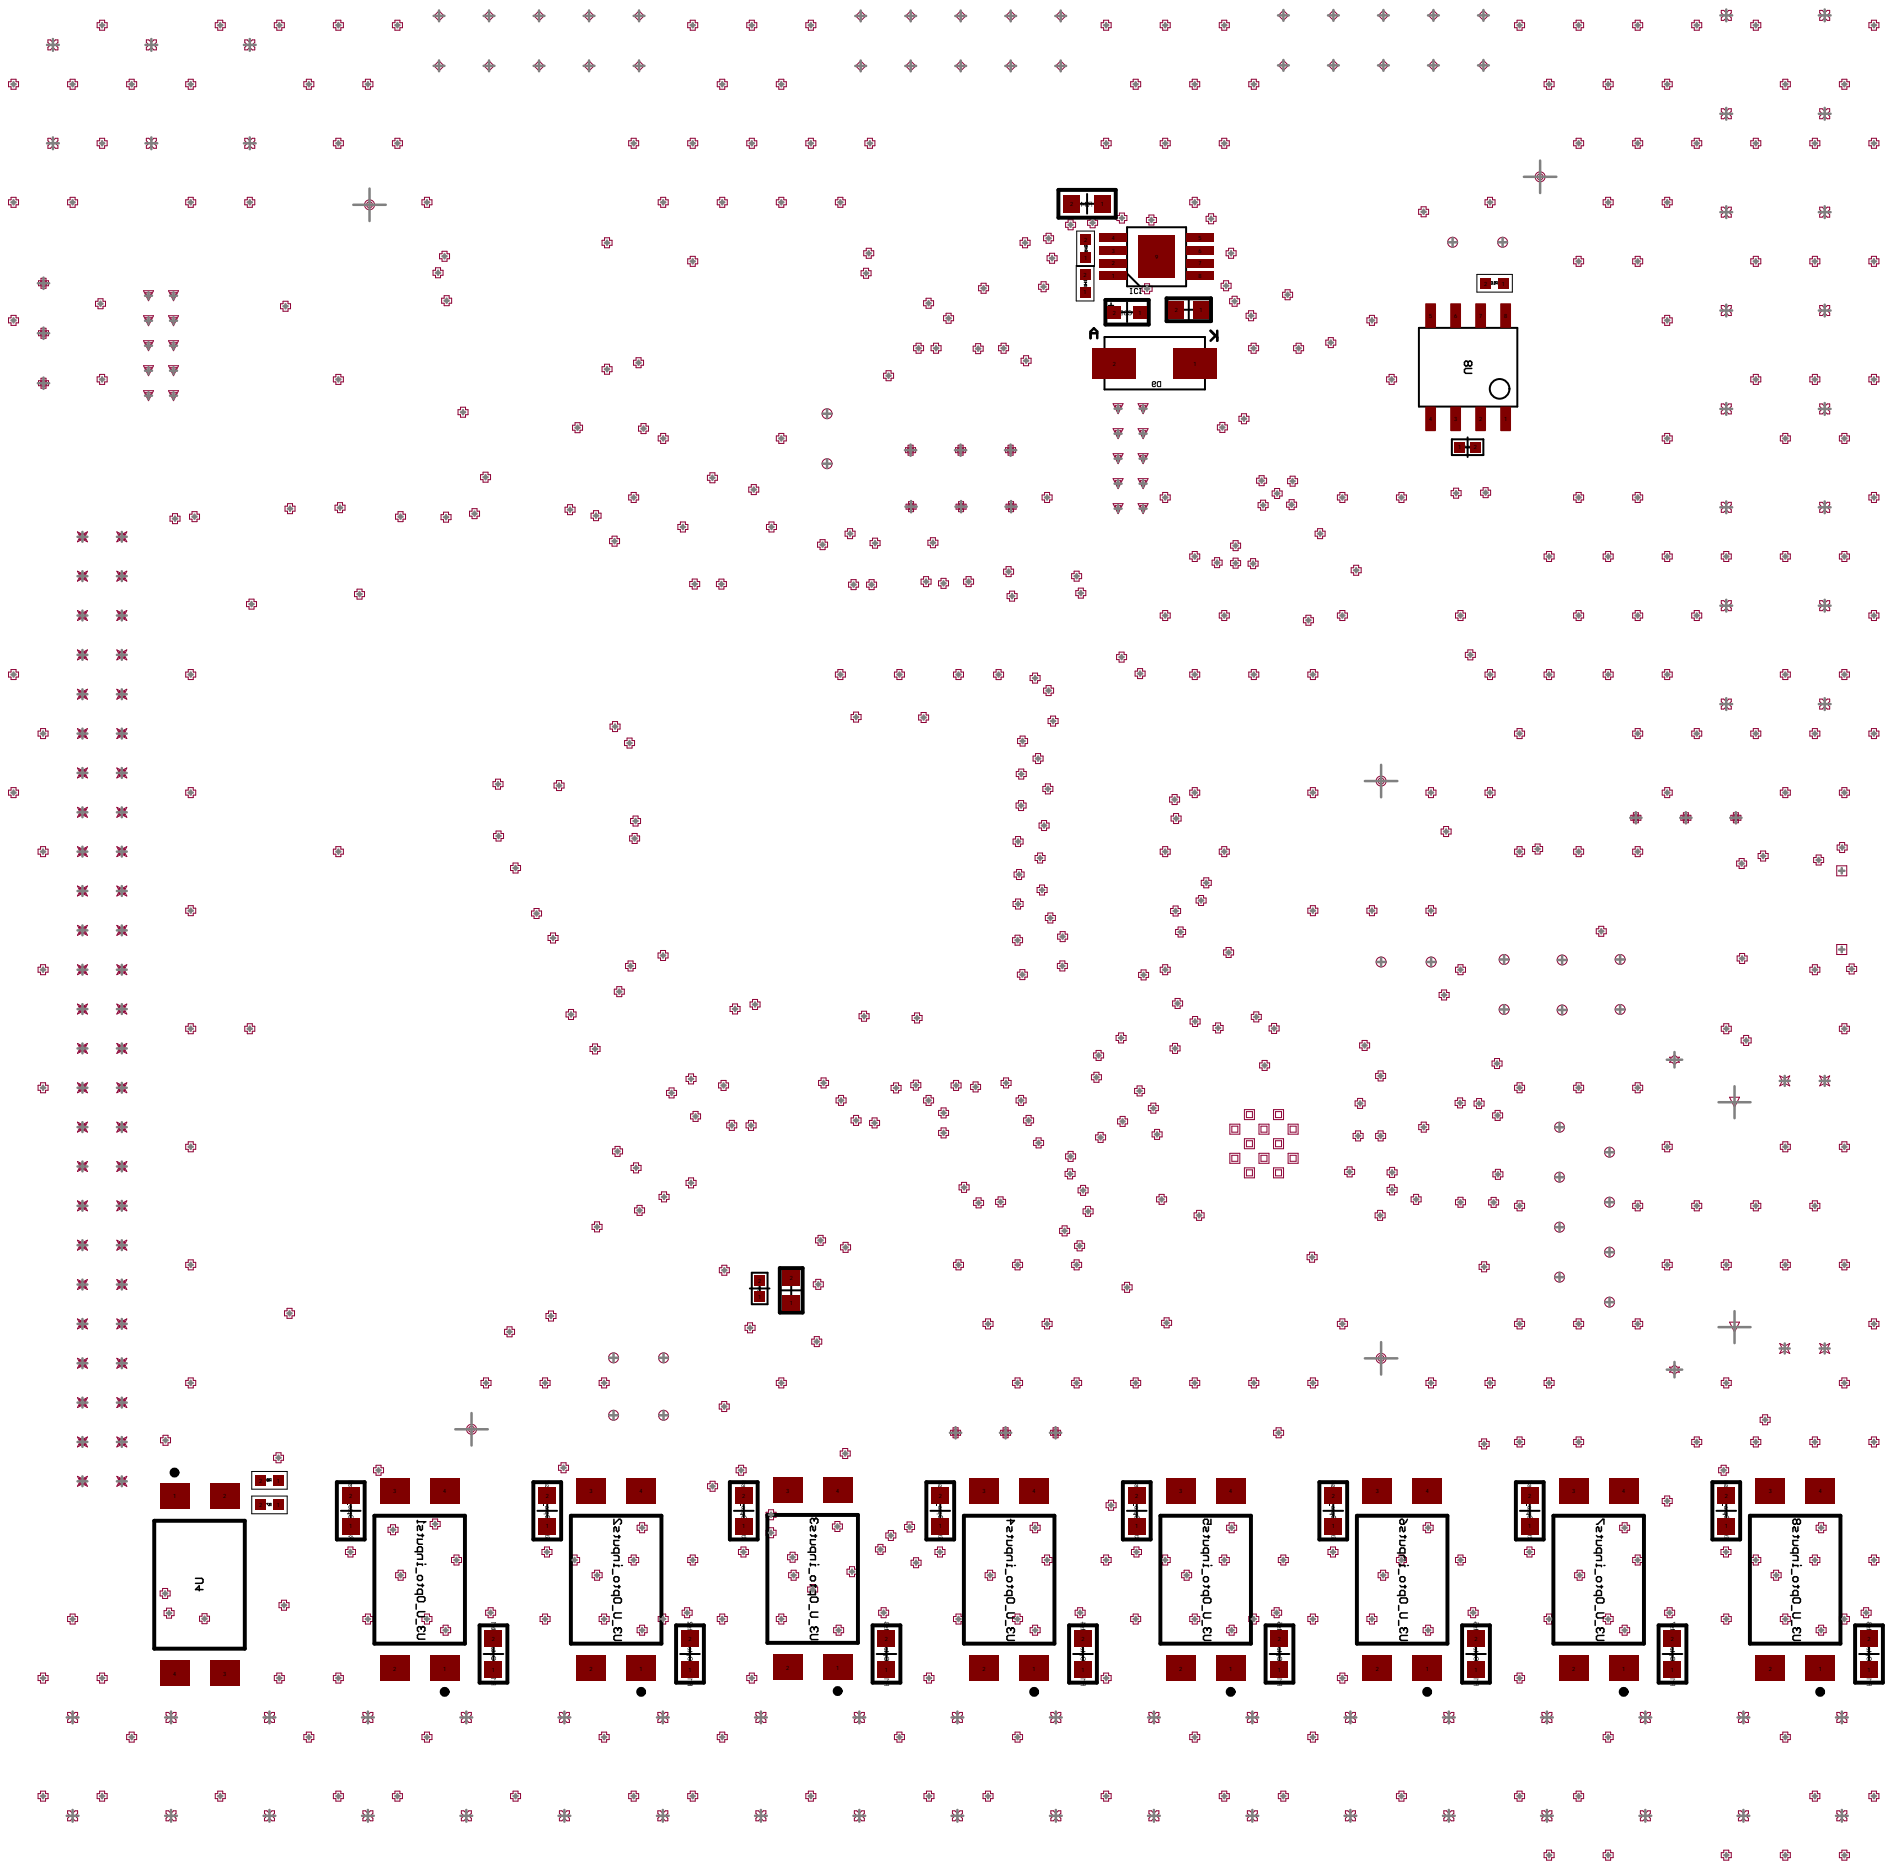
[picture p119: page 2]

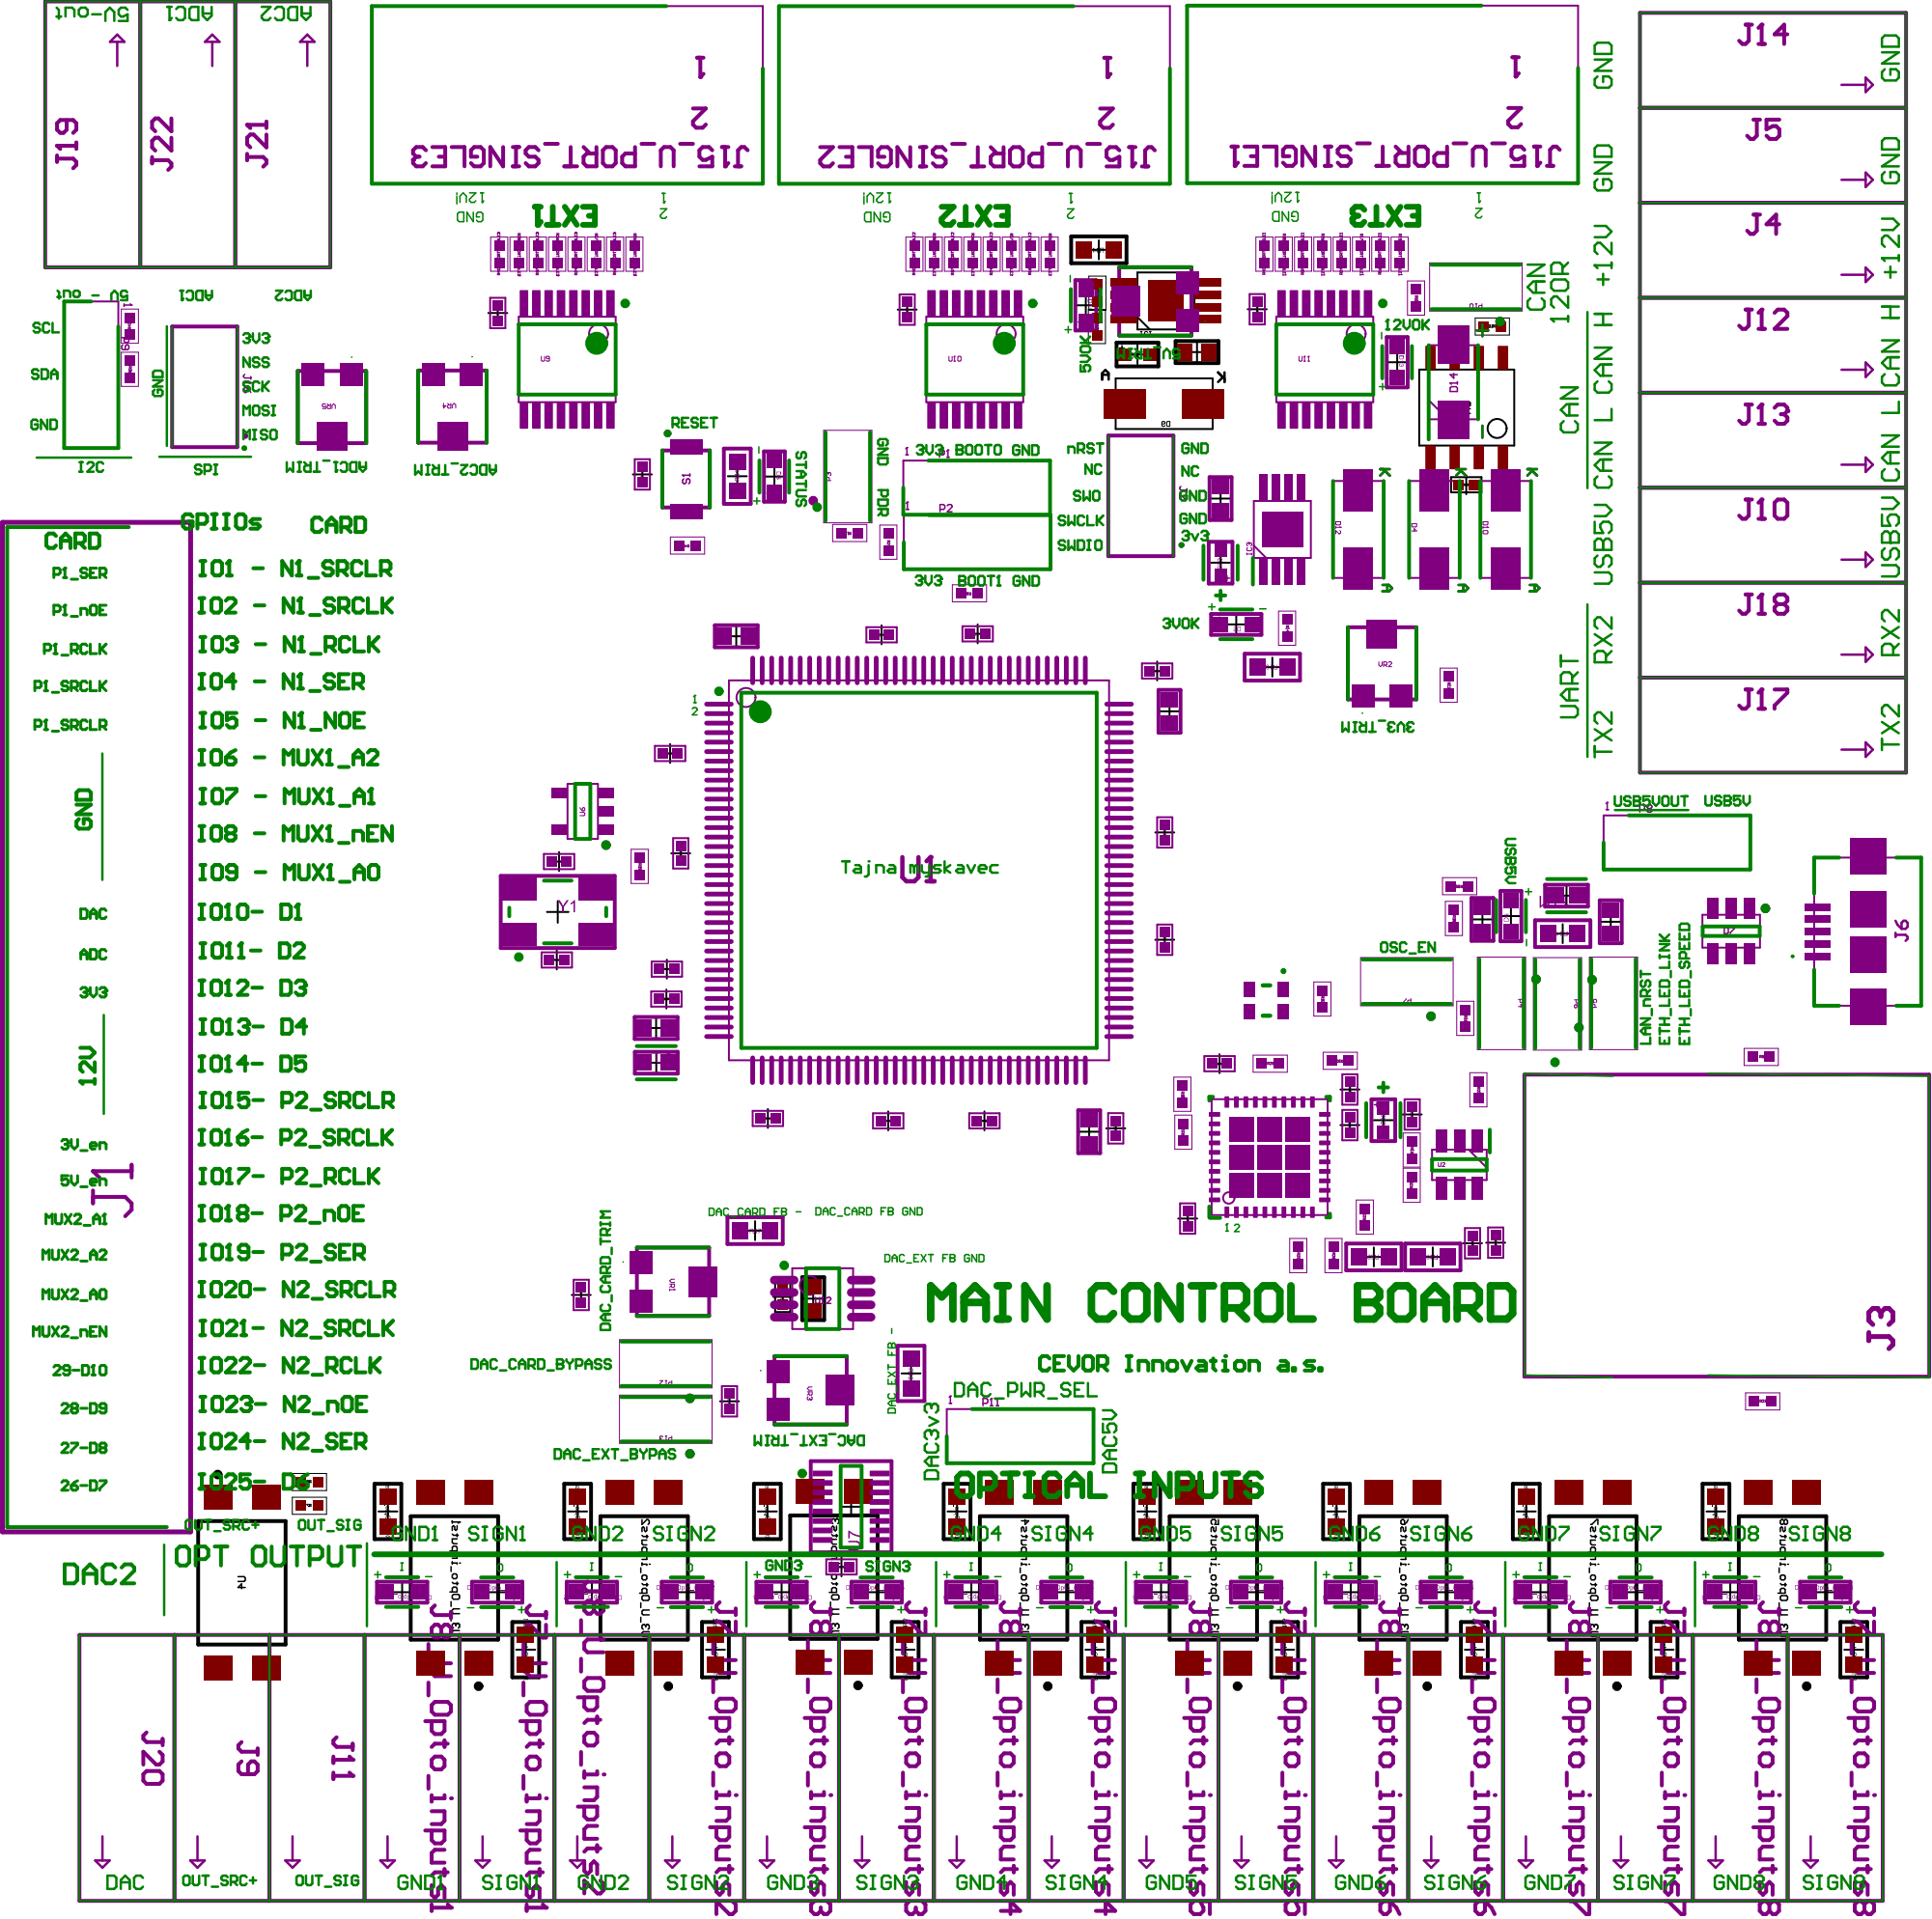
[picture p120: page 3]
