FilipPaul/DIPLOMKA/tex/aktualni_19_05_2023/obrazky/matlab_generated/VOLTAGE_TESTER/calib_DAC-eps-converted-to.pdf

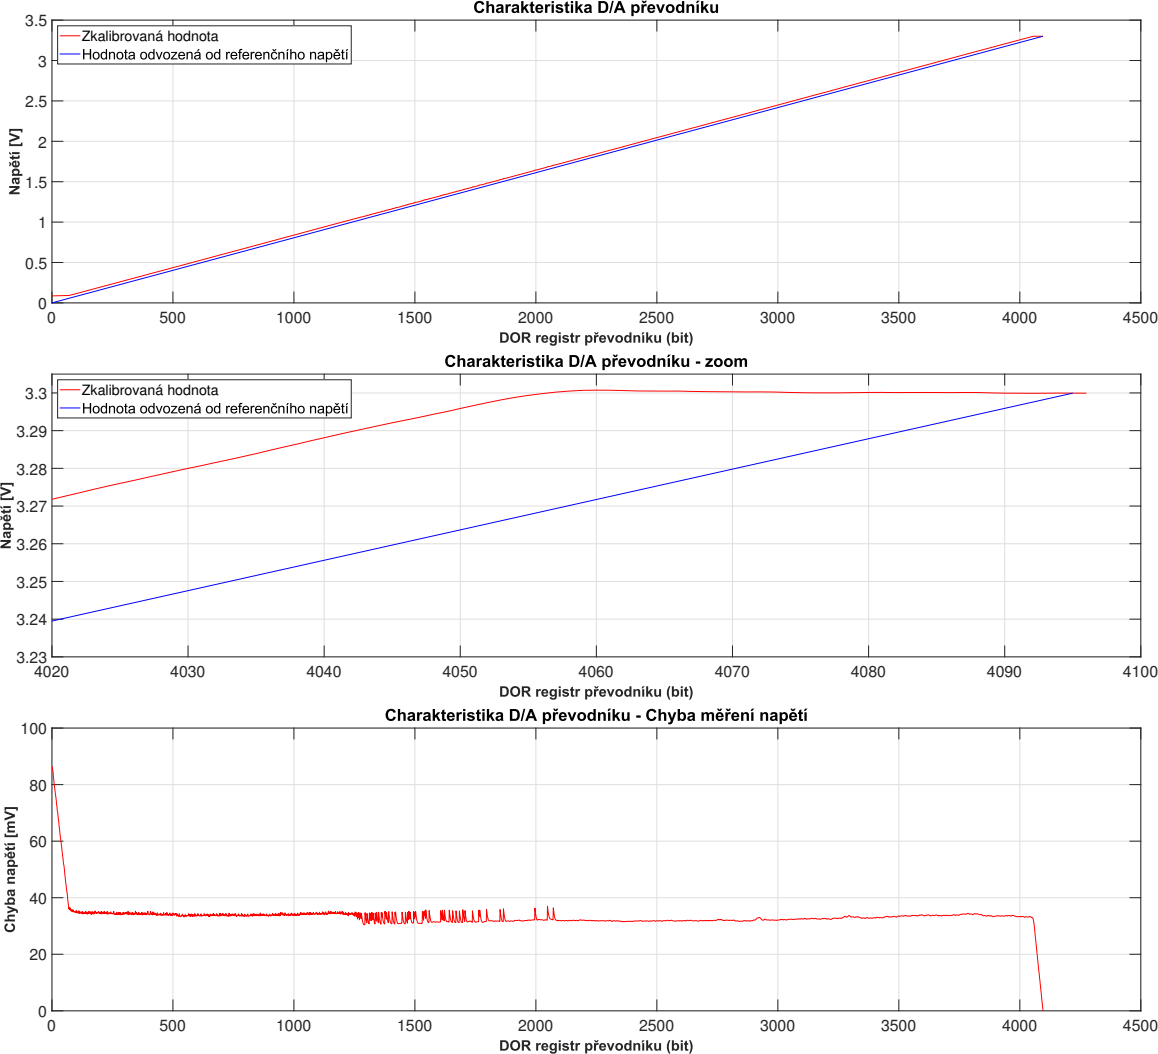
[picture p121: page 1]
Zkalibrovaná hodnota
