FilipPaul/DIPLOMKA/PCB_ovladaci_karta/Ovladaci_karta/Project Outputs for Ovladaci_karta/PCB Print/Drill Drawing/Guides.PDF

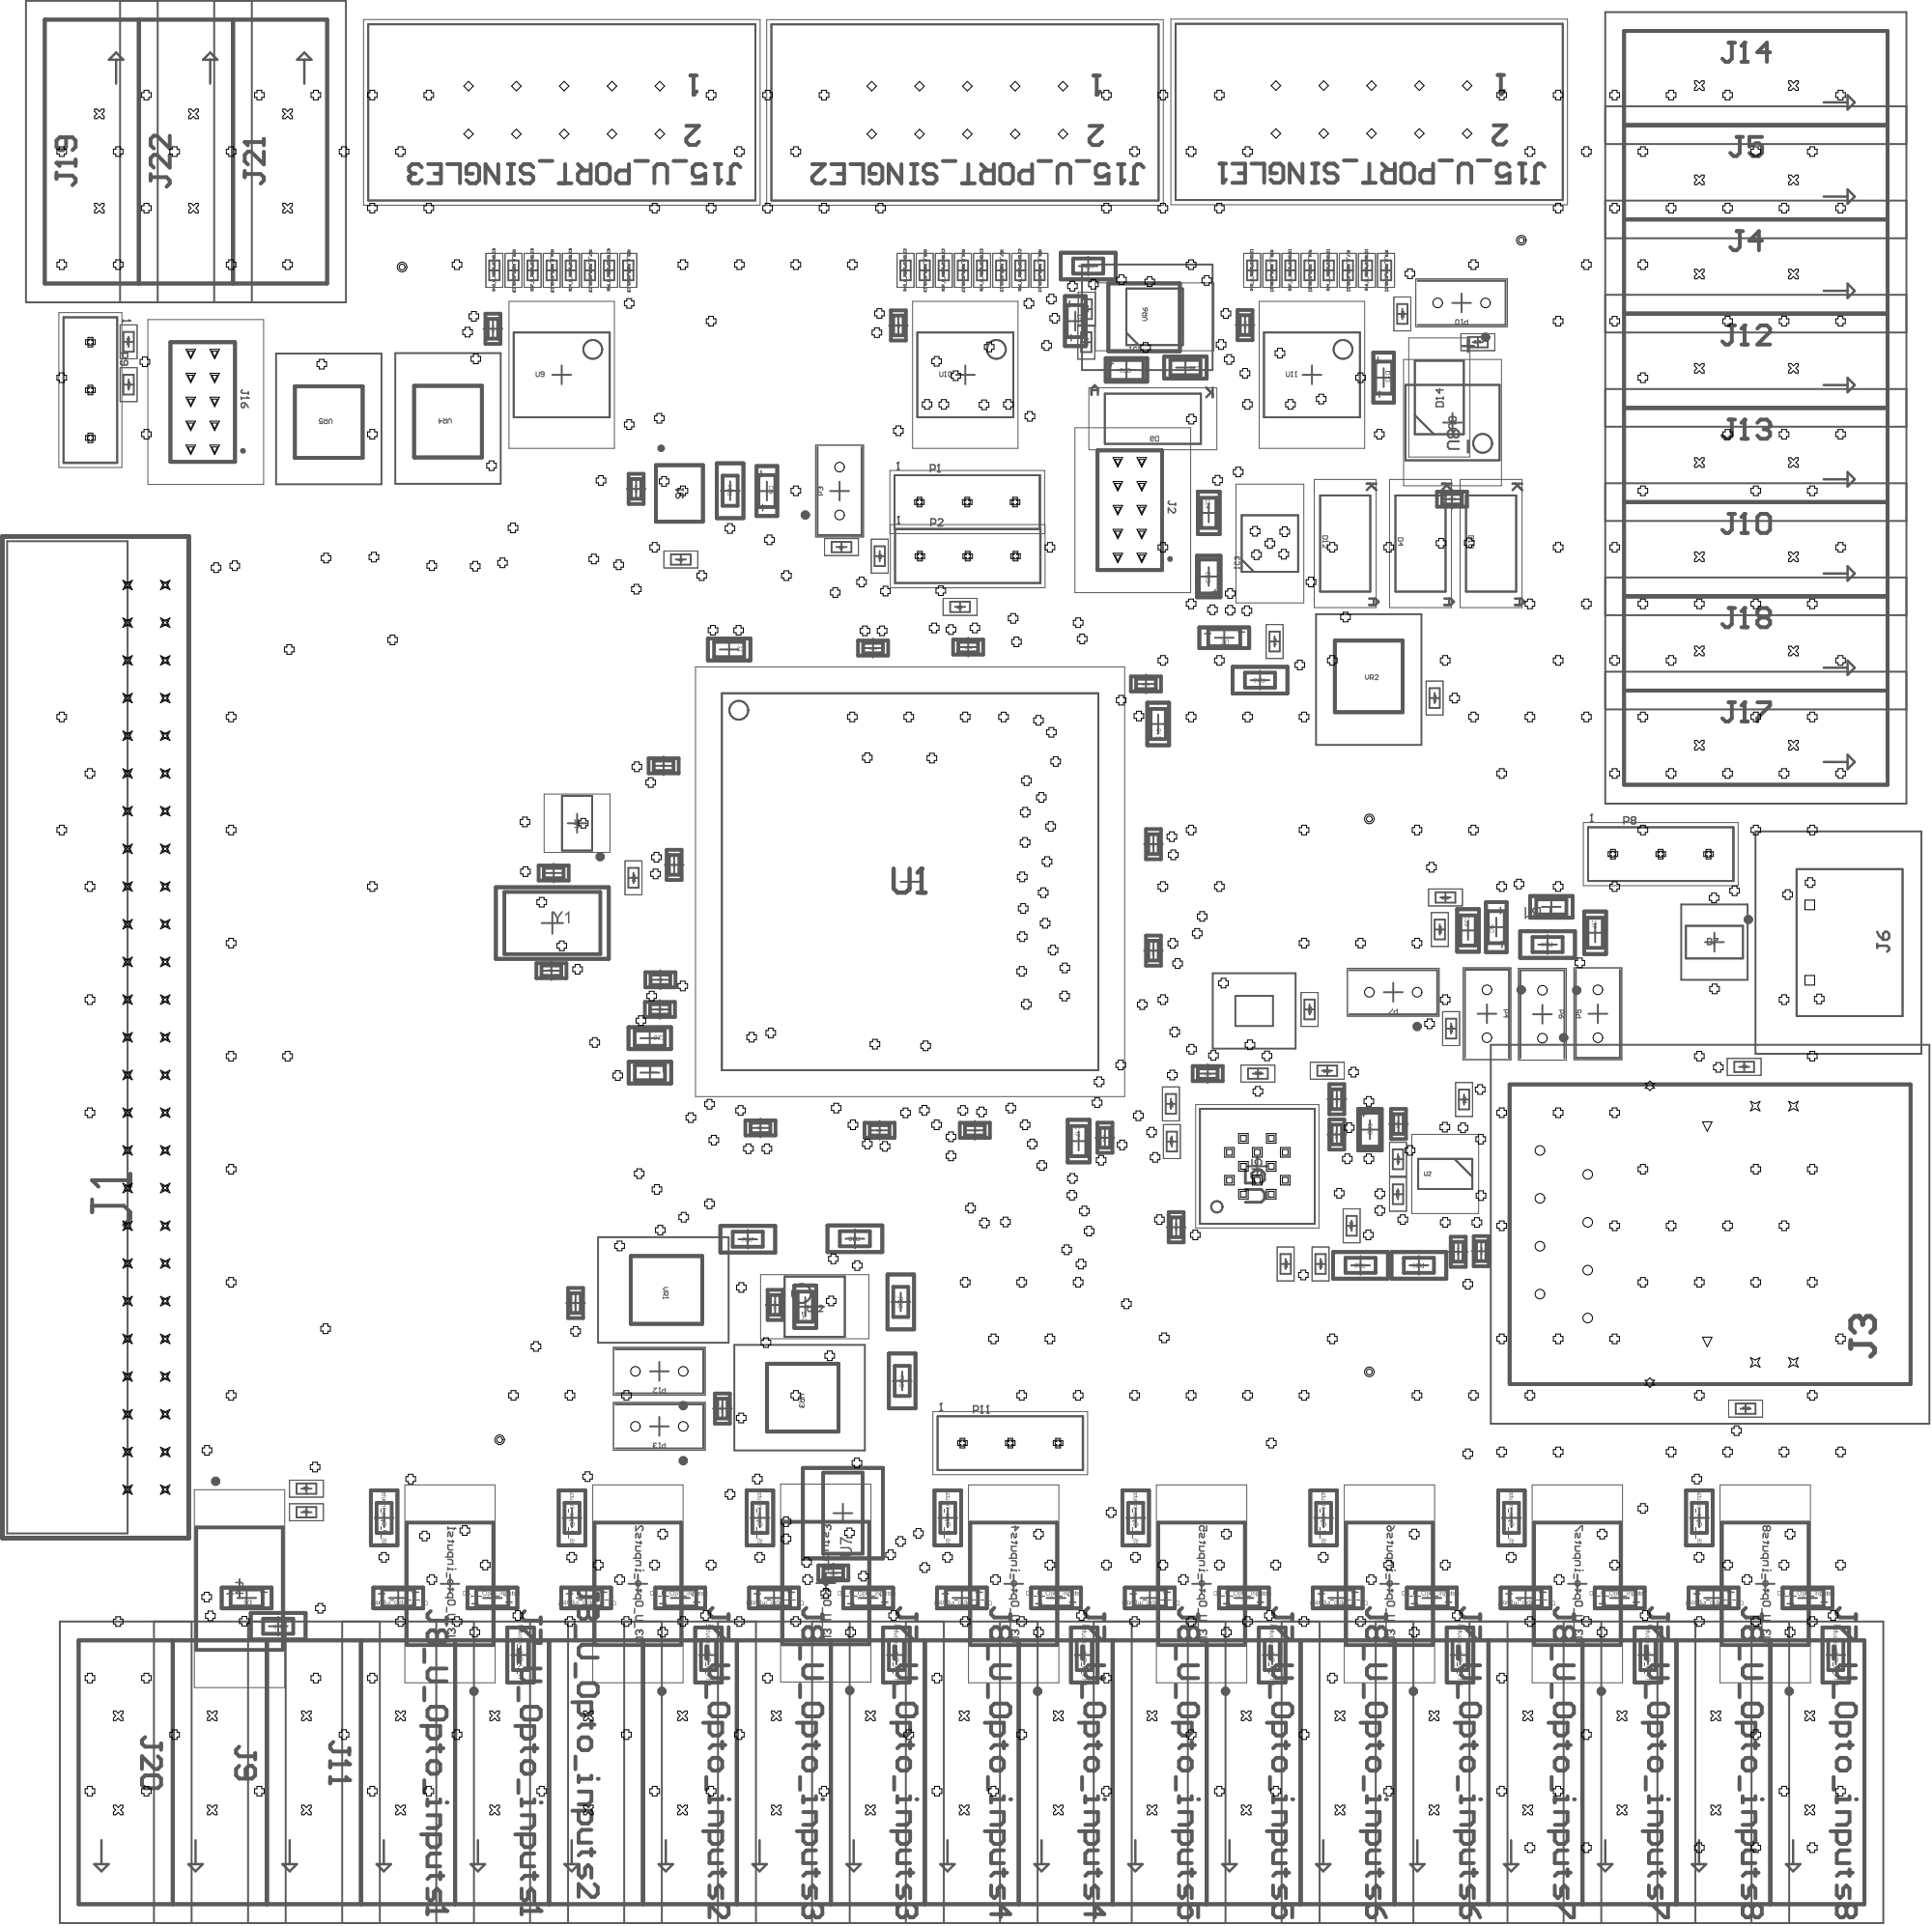
[picture p122: page 1]

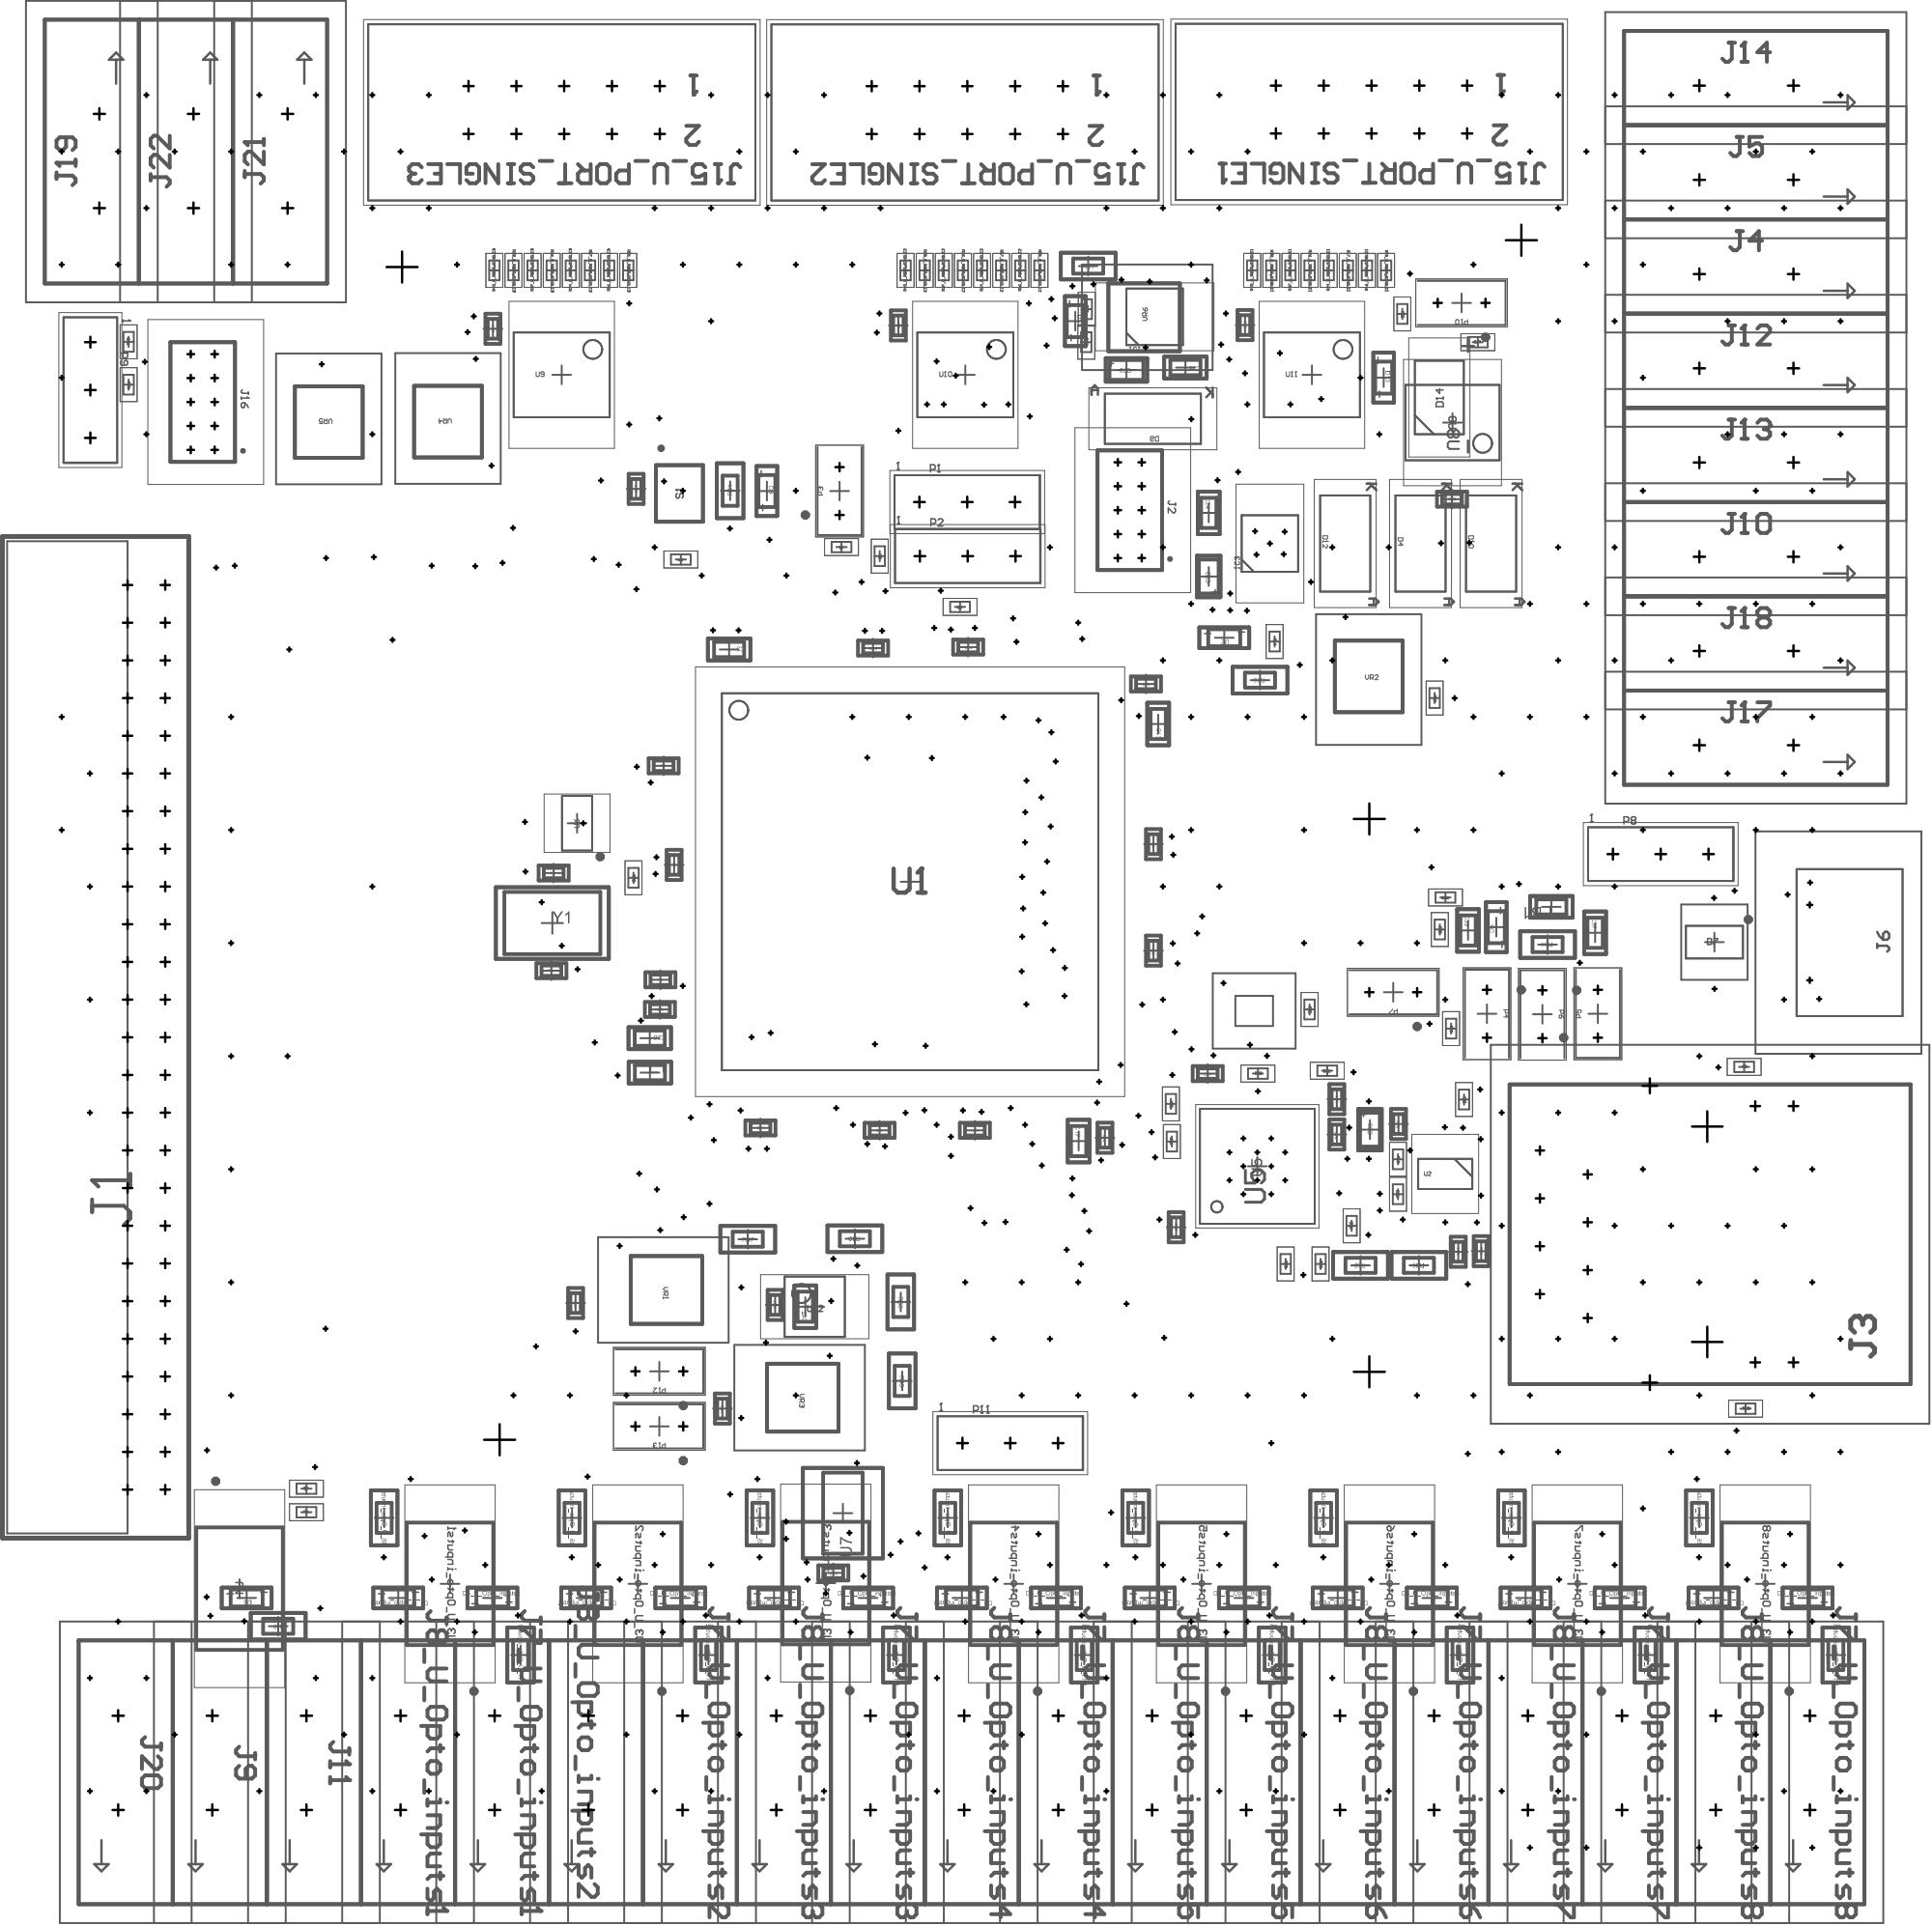
[picture p123: page 2]
