FilipPaul/DIPLOMKA/tex/aktualni_19_05_2023/pdf/Ovl_karta_pcb.PDF

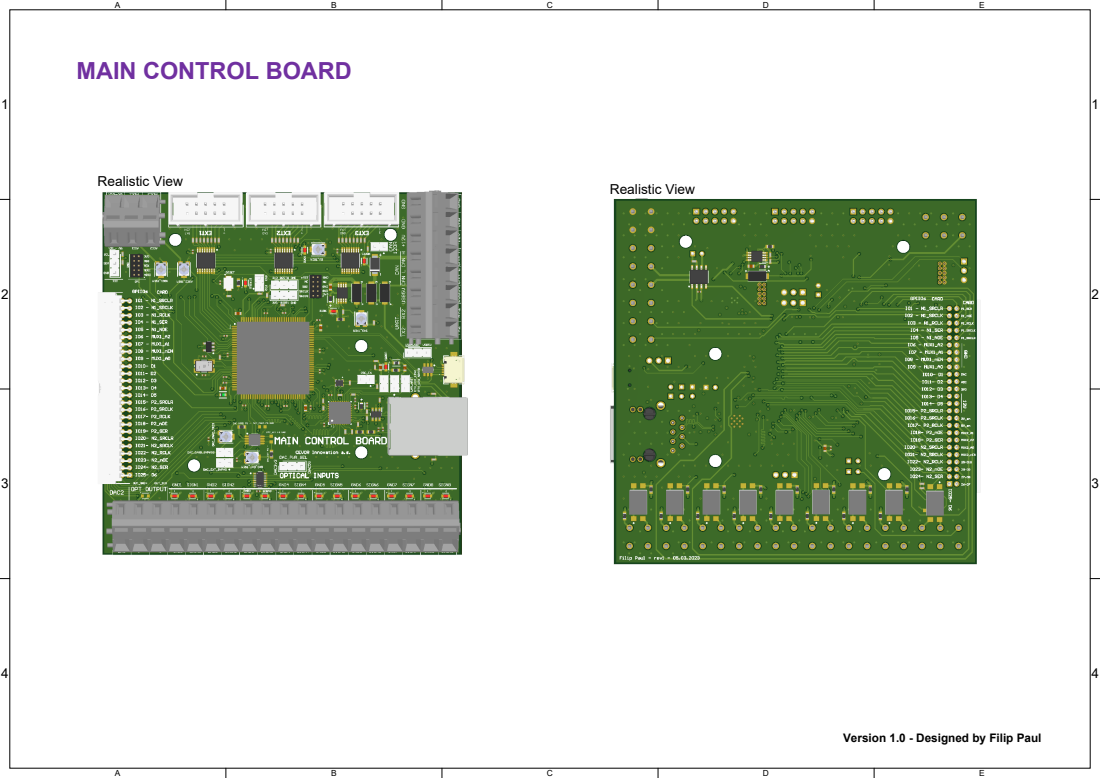
[picture p124: page 1]

Version 1.0 - Designed by Filip Paul

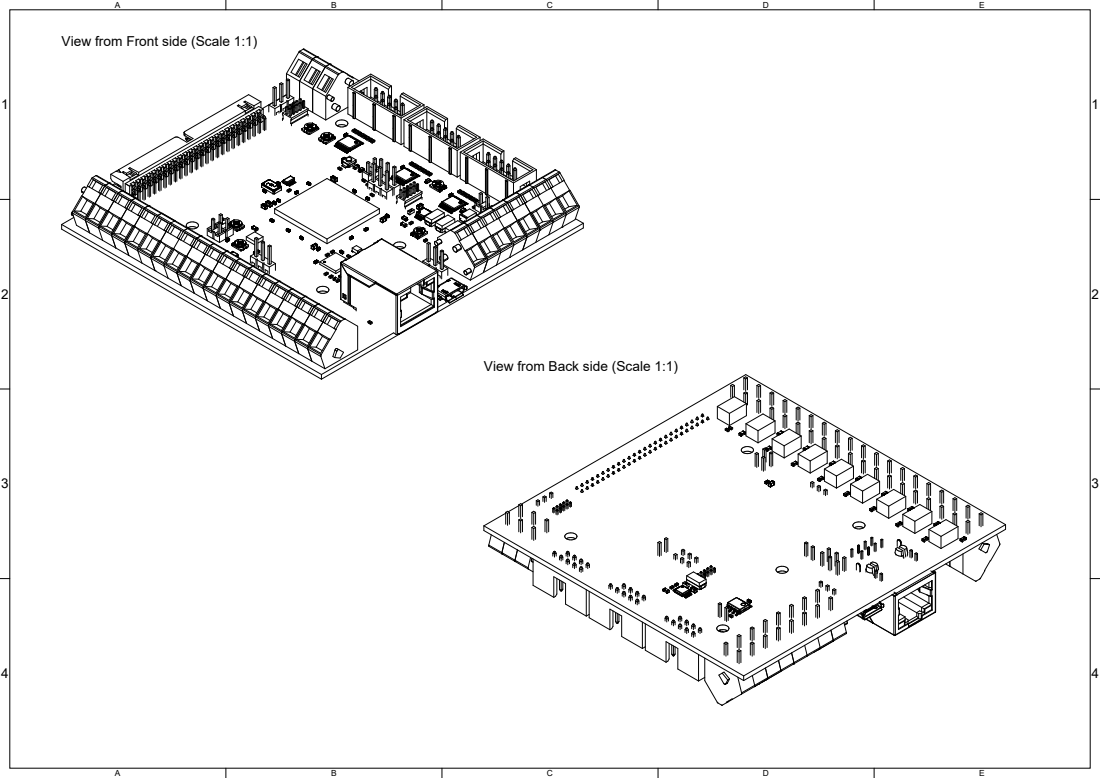
[picture p125: page 2]

View from Front side (Scale 1:1)

View from Back side (Scale 1:1)

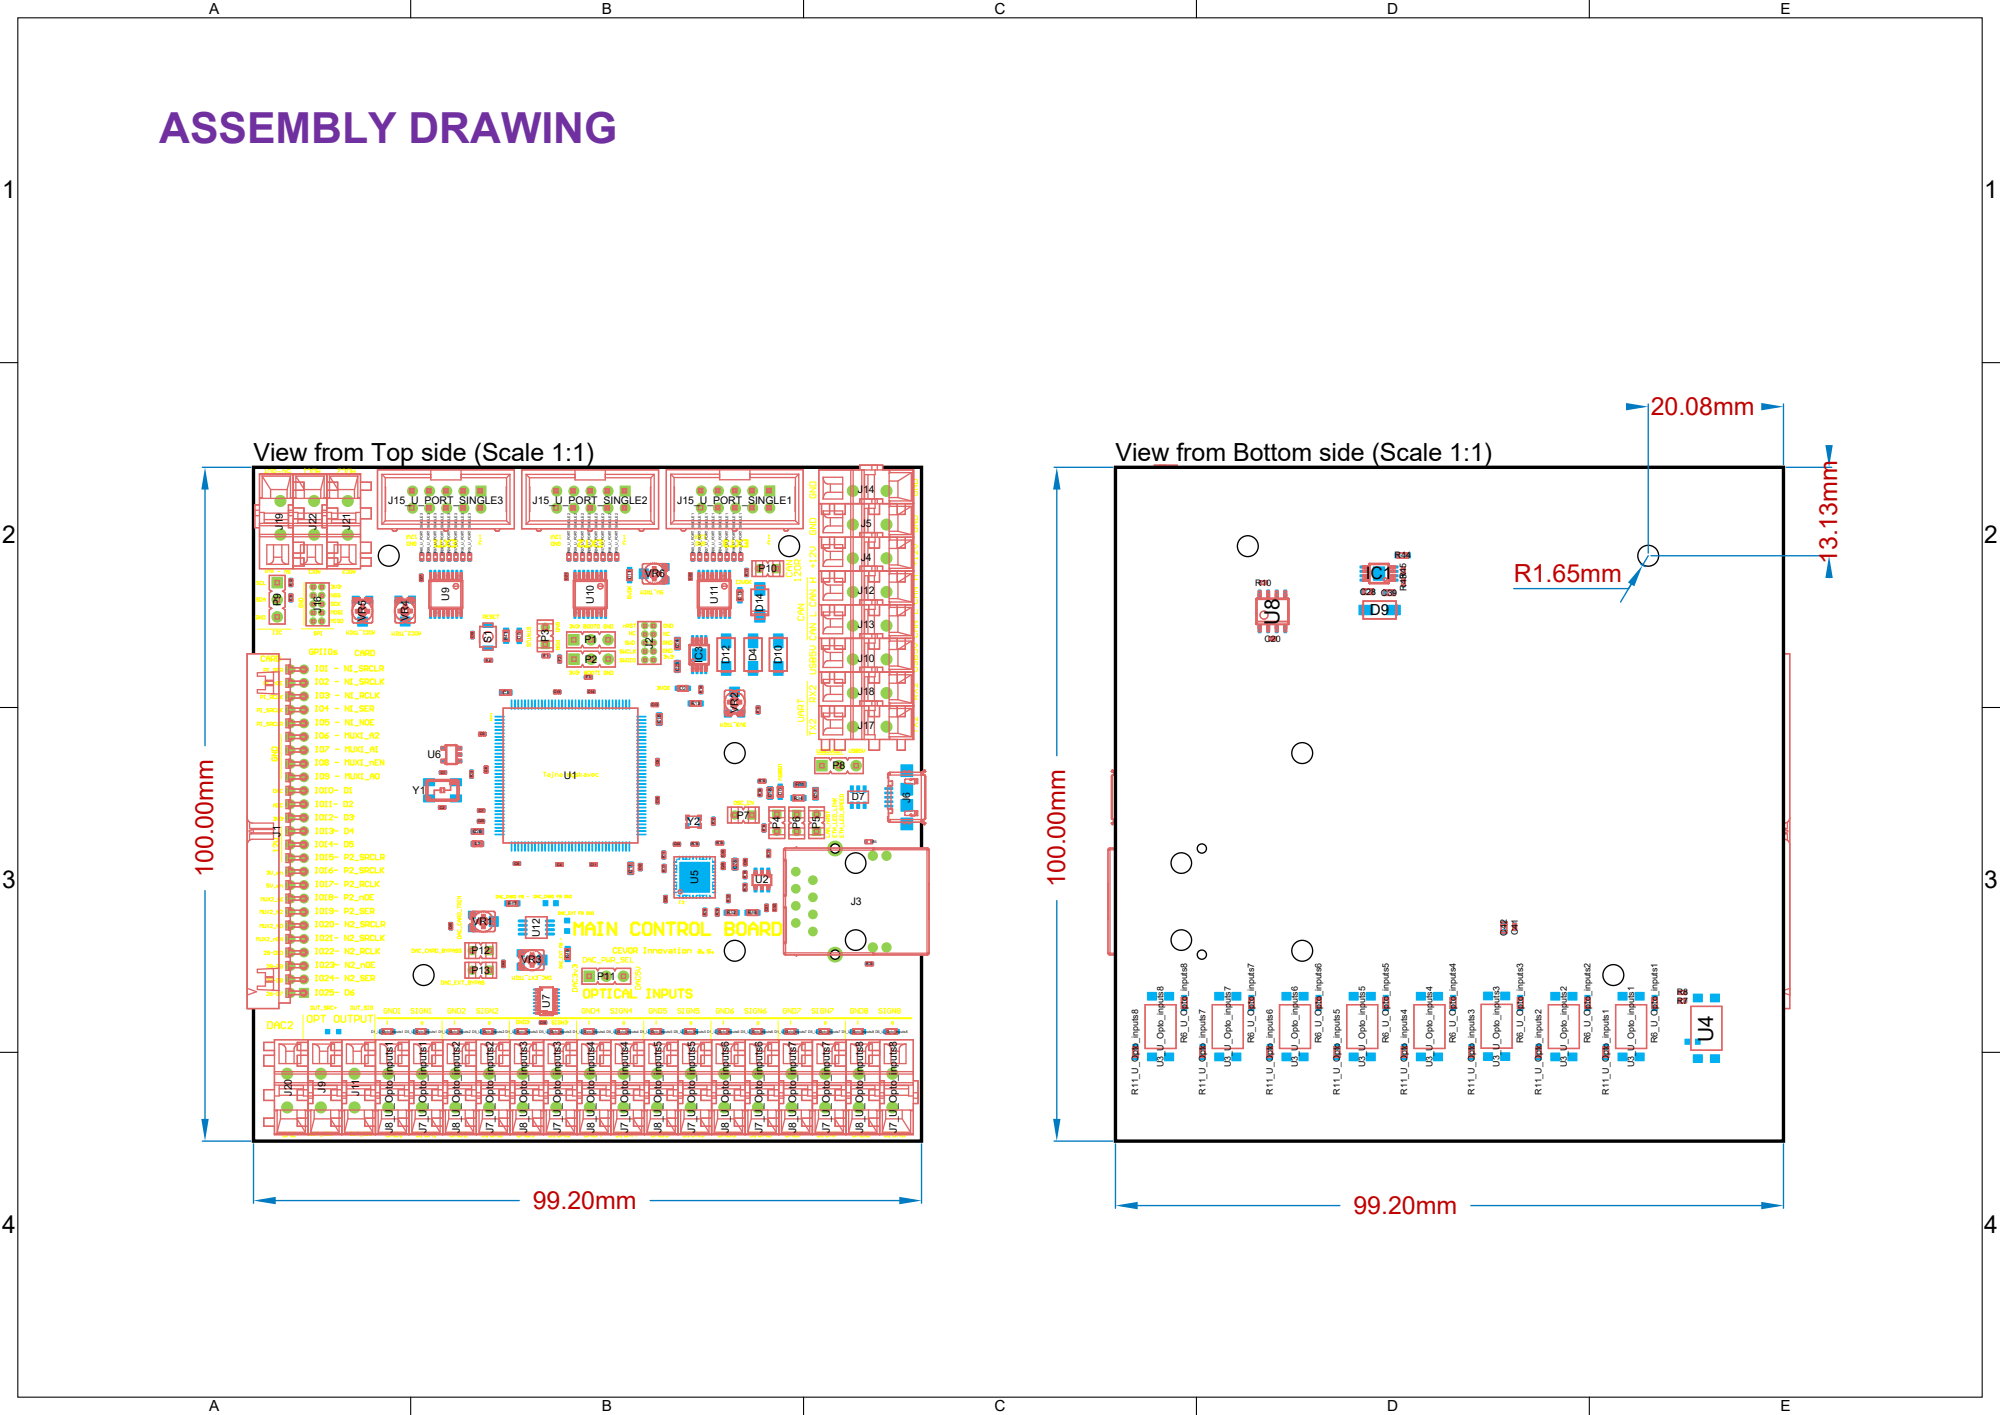
[picture p126: page 3]

View from Top side (Scale 1:1)

View from Bottom side (Scale 1:1)

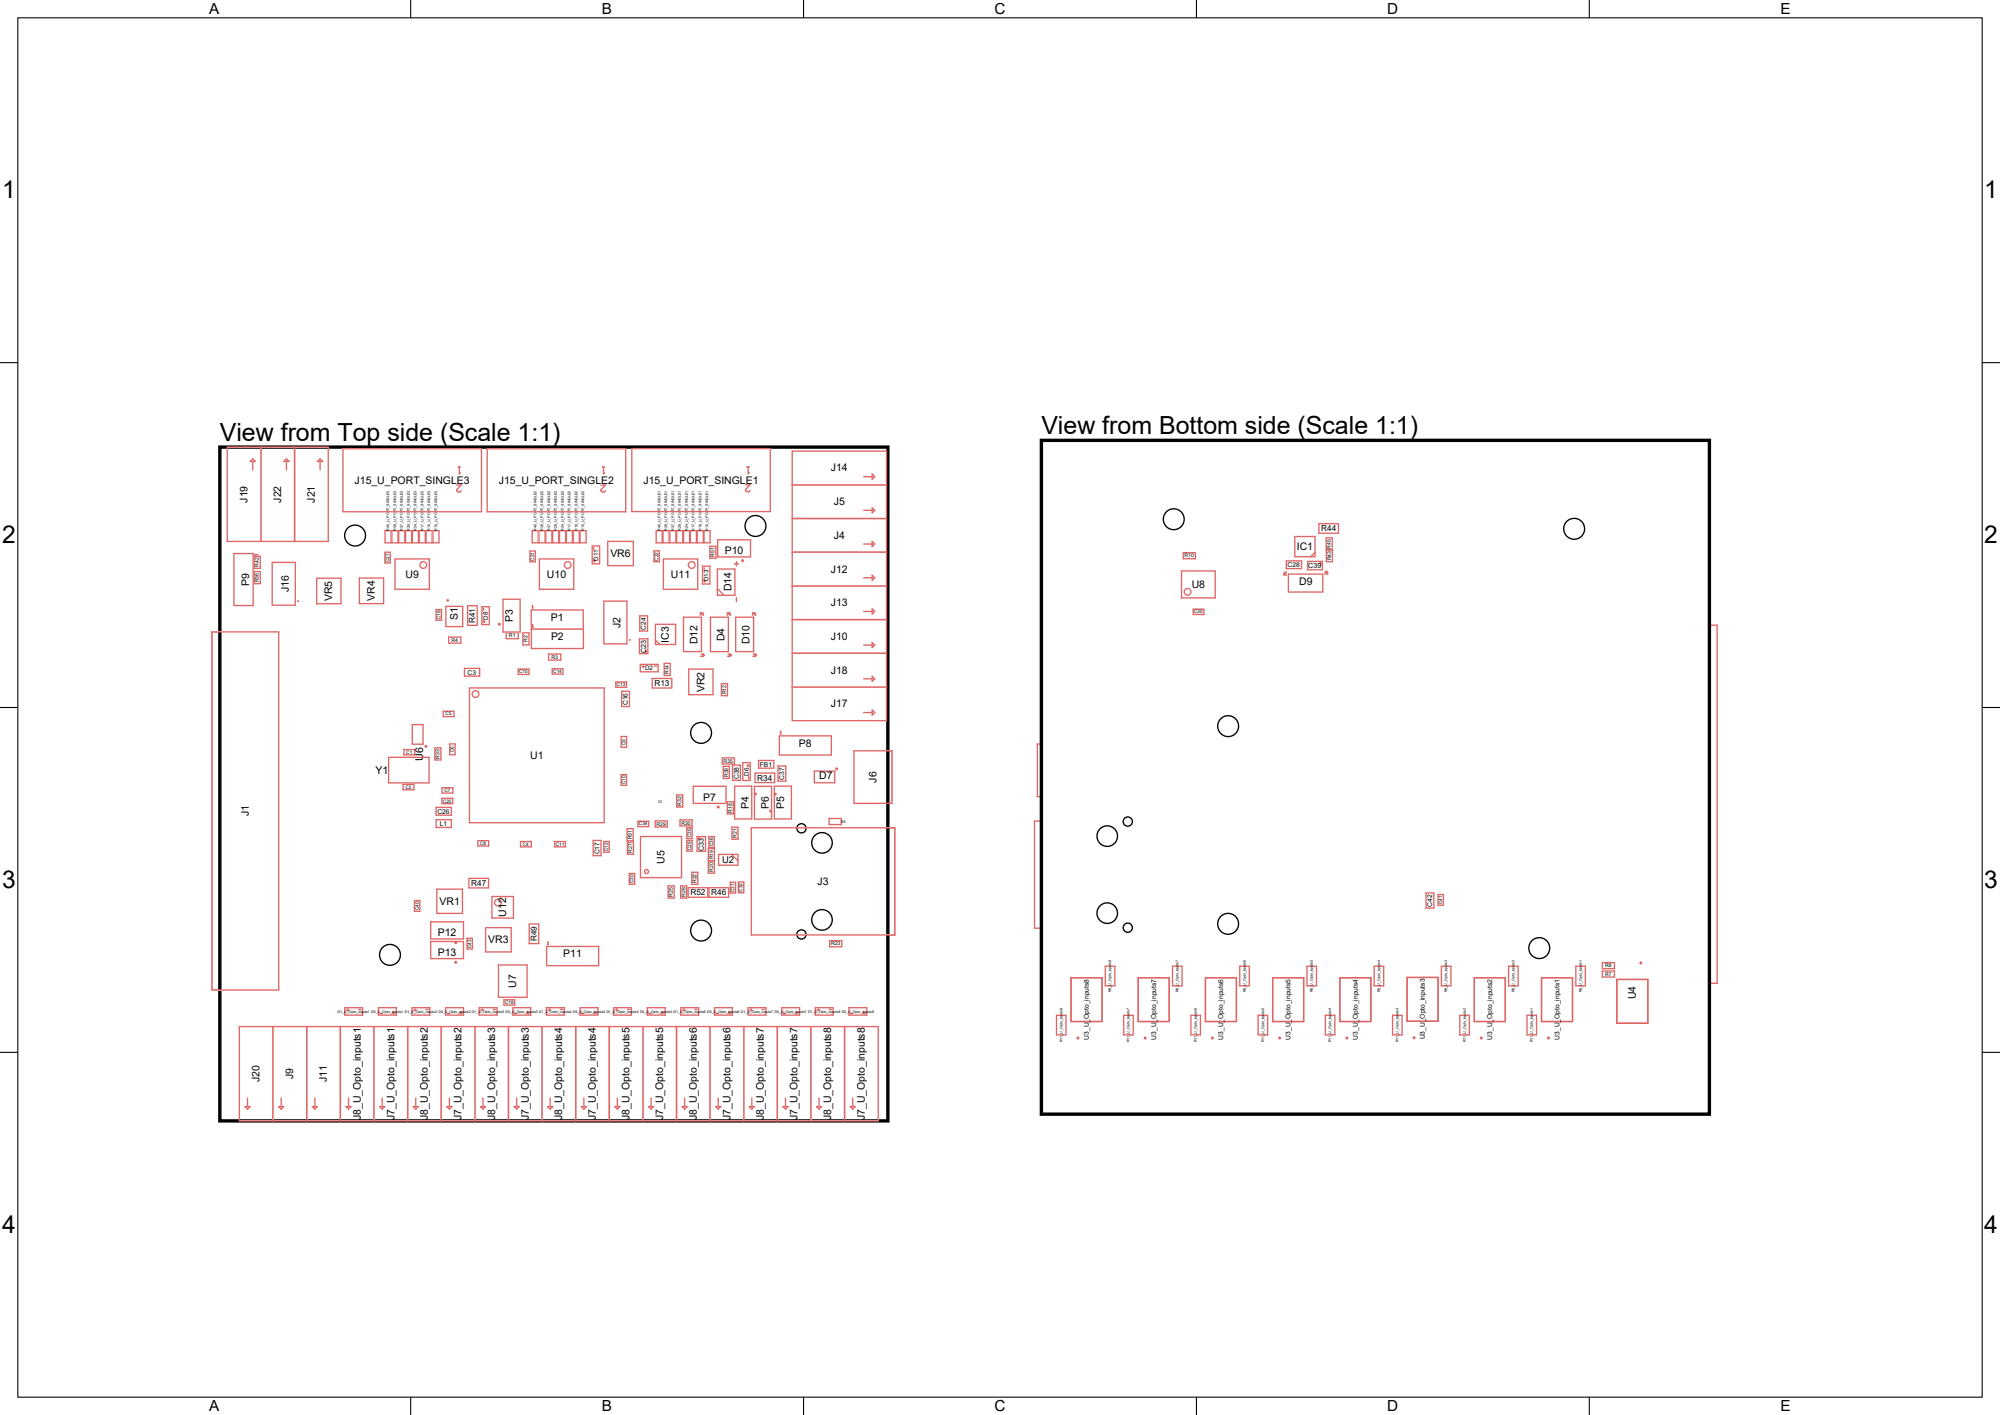
[picture p127: page 4]

View from Top side (Scale 1:1)

View from Bottom side (Scale 1:1)

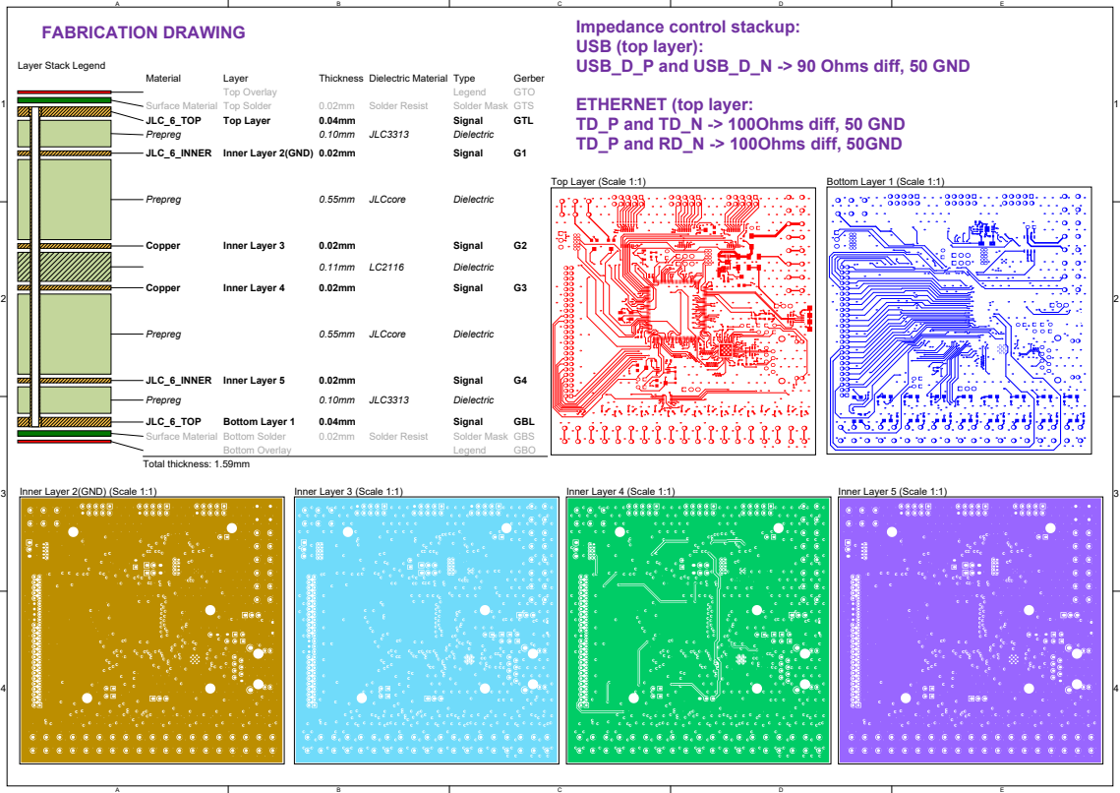
[picture p128: page 5]

USB (top layer):
USB_D_P and USB_D_N -> 90 Ohms diff, 50 GND
