FilipPaul/DIPLOMKA/tex/aktualni_19_05_2023/pdf/Merici_karta_pcb.pdf

A

B

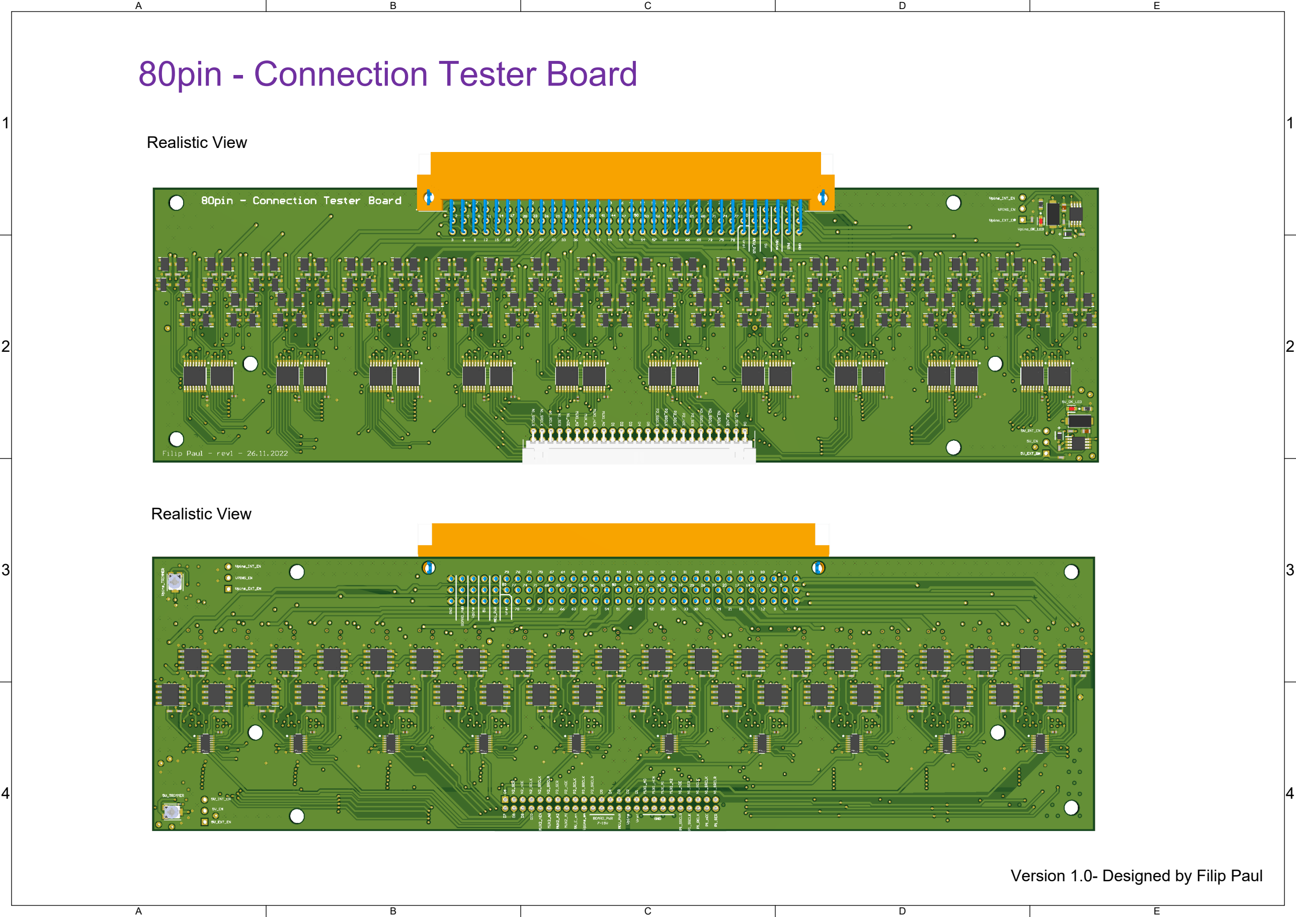
[picture p129: page 1]

C

D

E

1 | 1
2 | 2
3 | 3
4 | 4

# Realistic View

# Realistic View

# 80pin - Connection Tester Board

# Version 1.0- Designed by Filip Paul

1 | 1

# View from Top side (Scale 1:1)

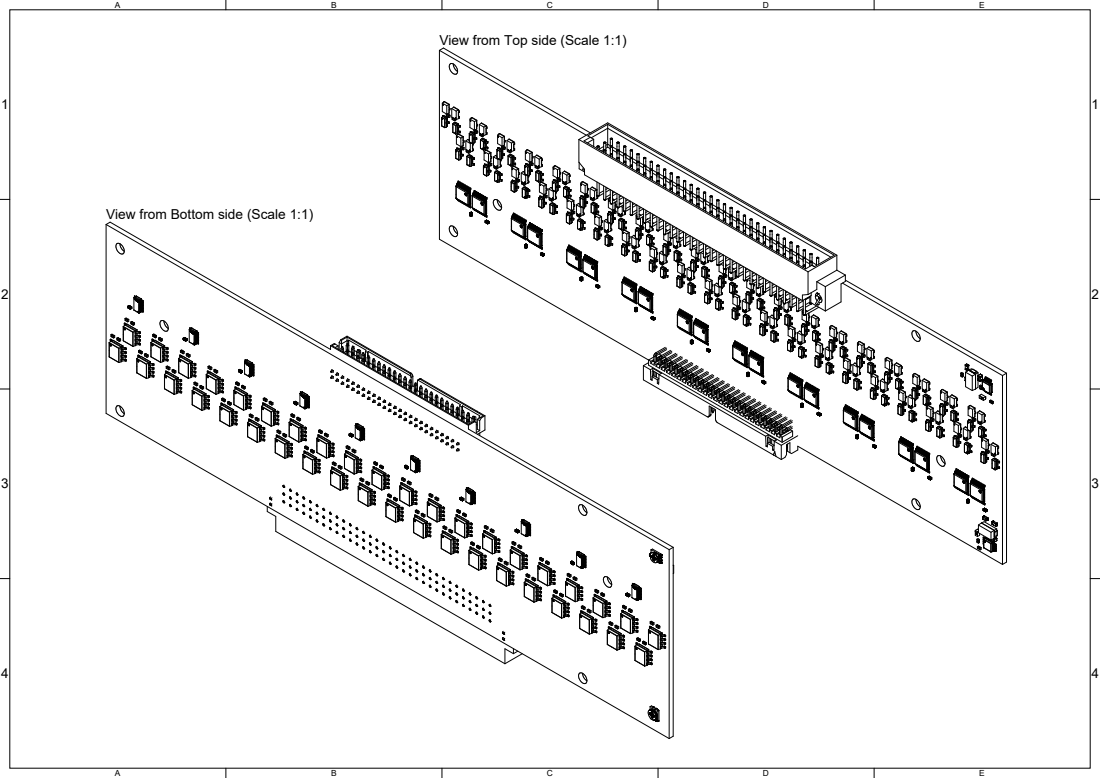
[picture p130: page 2]

View from Bottom side (Scale 1:1)

1 | 1

# ASSEMLY DRAWING

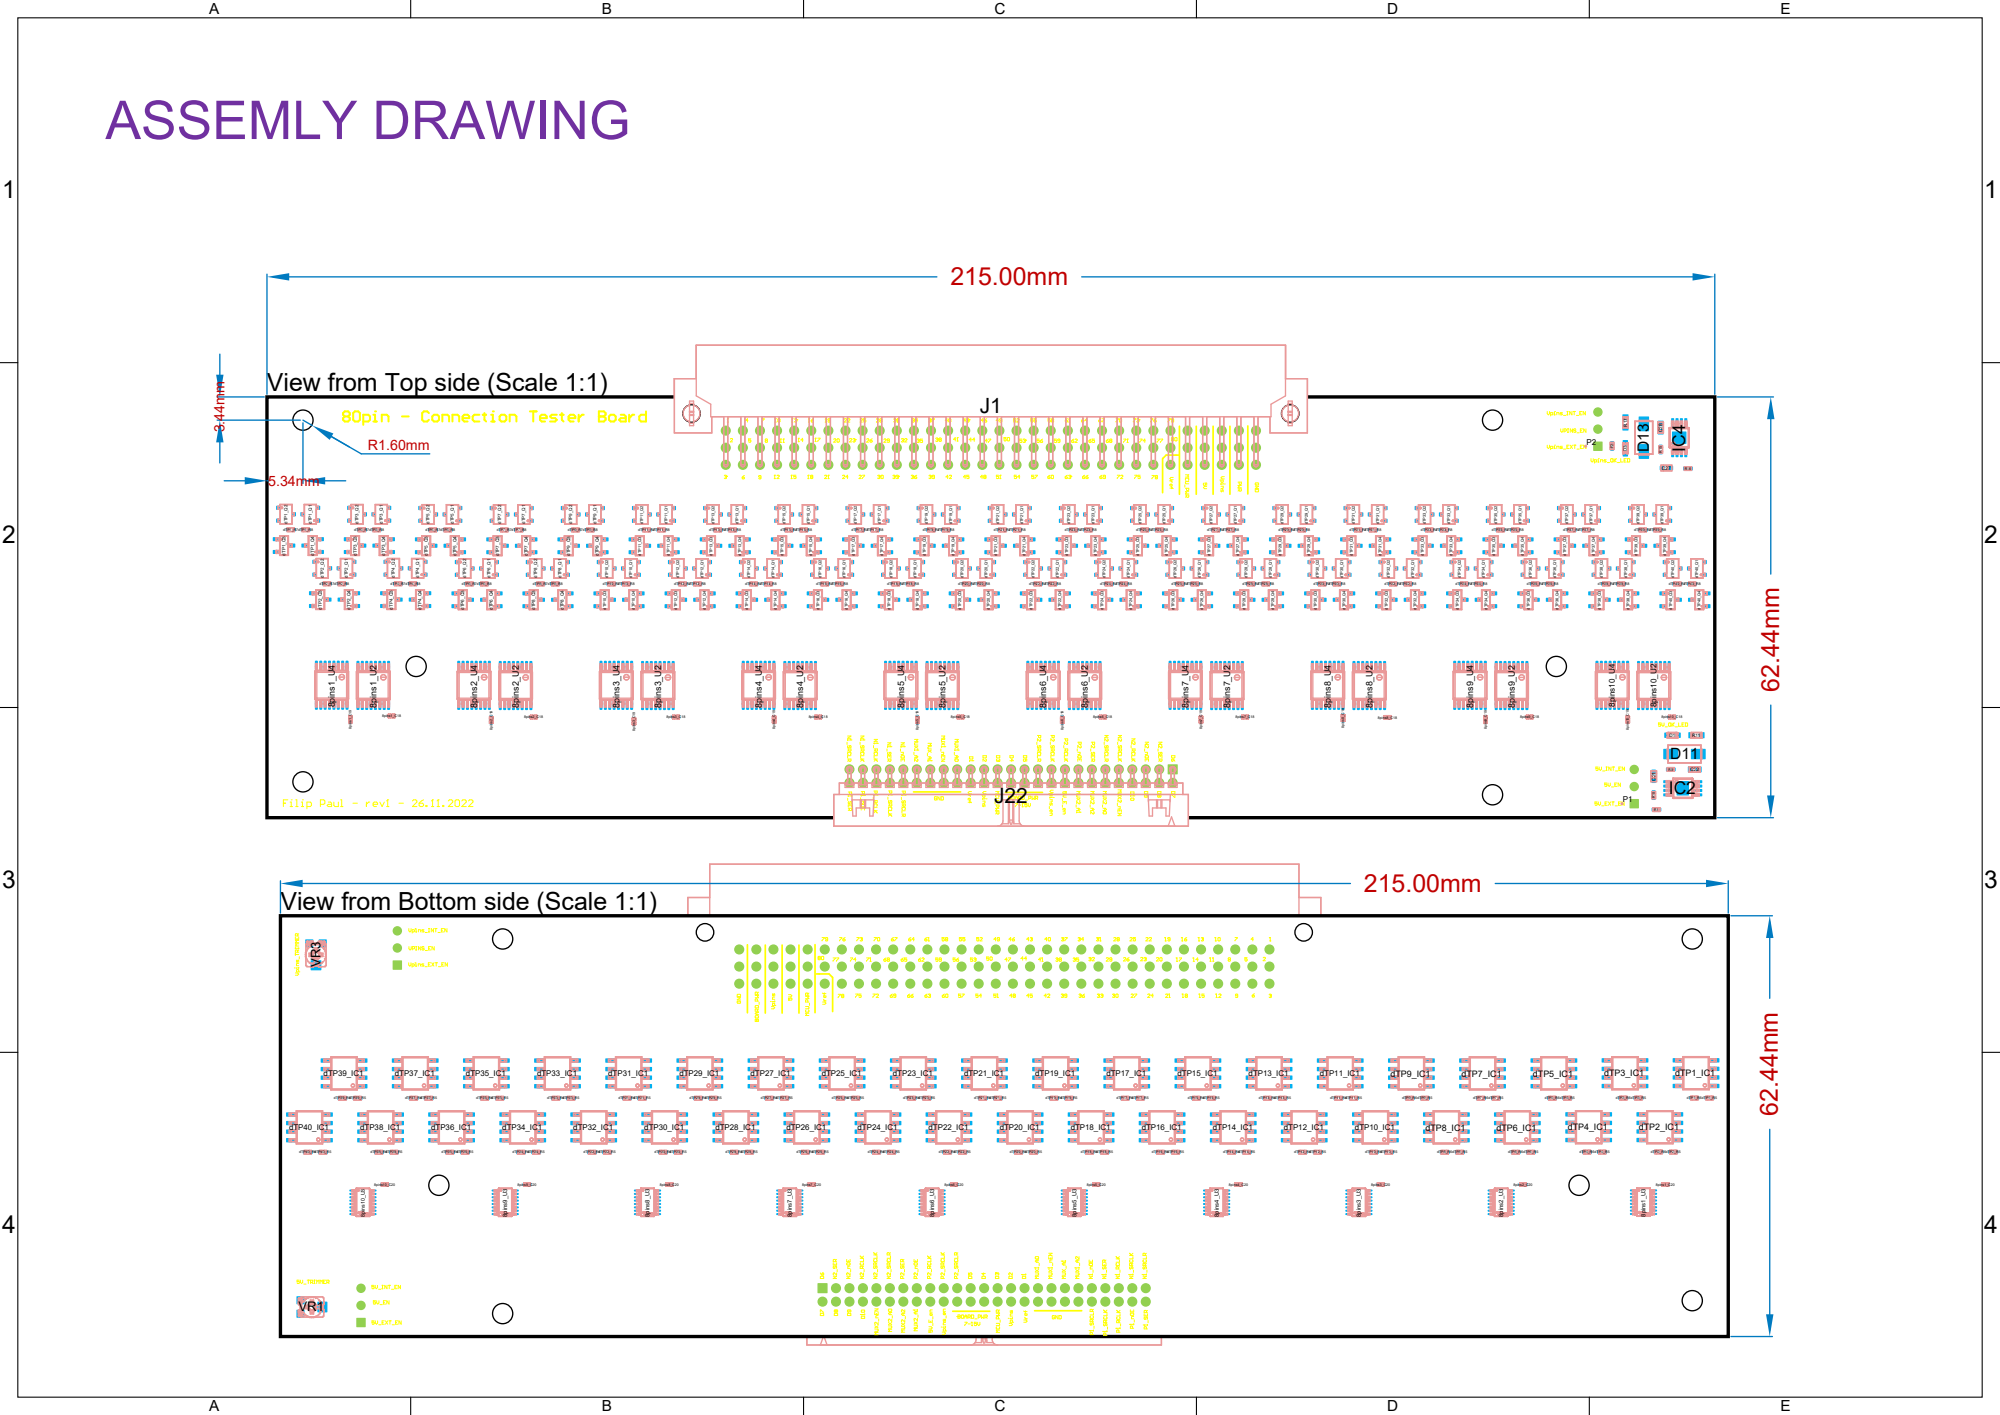
[picture p131: page 3]

View from Top side (Scale 1:1)

View from Bottom side (Scale 1:1)

1 | 1

# Top Layer (Scale 1:2)

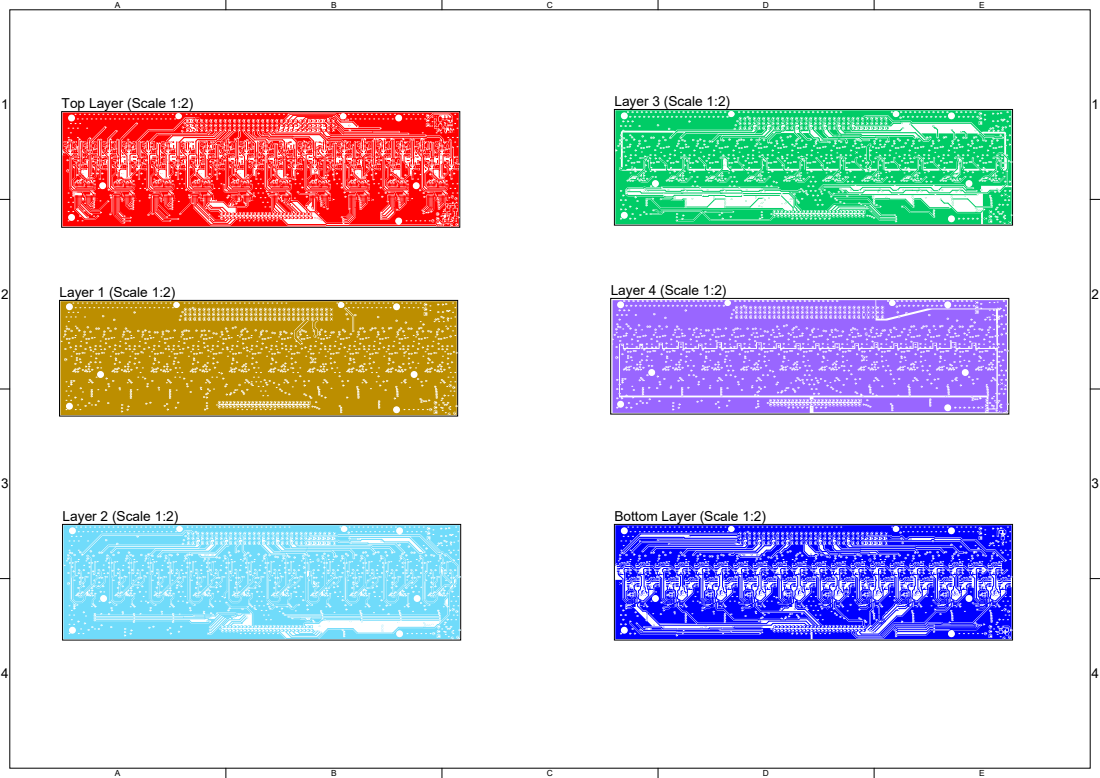
[picture p132: page 4]
Layer 1 (Scale 1:2); Layer 2 (Scale 1:2); Layer 3 (Scale 1:2); Layer 4 (Scale 1:2)

Bottom Layer (Scale 1:2)
