FilipPaul/DIPLOMKA/(list of files, drawings)

Other design files:
PCB_merici_karta/8pins_together.SchDoc
PCB_merici_karta/ALL_80_pins.SchDoc
PCB_merici_karta/ALL_channels.SchDoc
PCB_merici_karta/diplomka_hiearchical.PrjPcb
PCB_merici_karta/main_scheme.SchDoc
PCB_merici_karta/old/main_scheme.SchDoc
PCB_merici_karta/POWER.SchDoc
PCB_merici_karta/to_draw.SchDoc
PCB_merici_karta/TPs.SchDoc
PCB_merici_karta/trials/main_scheme.SchDoc
PCB_merici_karta/trials/main_scheme.~(862).SchDoc
PCB_ovladaci_karta/Ovladaci_karta/Ethernet.SchDoc
PCB_ovladaci_karta/Ovladaci_karta/LED_INDICATOR.SchDoc
PCB_ovladaci_karta/Ovladaci_karta/main_scheme.SchDoc
PCB_ovladaci_karta/Ovladaci_karta/Opto_inputs.SchDoc
PCB_ovladaci_karta/Ovladaci_karta/Opto_outputs.SchDoc
PCB_ovladaci_karta/Ovladaci_karta/Ovladaci_karta.PrjPcb
PCB_ovladaci_karta/Ovladaci_karta/PORT_SINGLE.SchDoc
PCB_ovladaci_karta/Ovladaci_karta/PORTS_DRIVER.SchDoc
PCB_ovladaci_karta/Ovladaci_karta/POWER.SchDoc
PCB_ovladaci_karta/Ovladaci_karta/testy.SchDoc
PCB_ovladaci_karta/Ovladaci_karta/USB.SchDoc
