FilipPaul/DIPLOMKA/CTRL_BOARD/Core/Src/main.c

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
/* Includes ------------------------------------------------------------------*/
#include "main.h"
#include "cmsis_os.h"
#include "lwip.h"
#include "usb_device.h"

/* USER CODE BEGIN Includes */
#include "usbd_cdc_if.h"
#include "stdio.h"
#include "tcpserver.h"
#include "globals.h"
/* USER CODE END Includes */

/* USER CODE BEGIN PM */
CAN_TxHeaderTypeDef CanTxHeader;
CAN_RxHeaderTypeDef CanRxHeader;
uint32_t CanTxMailbox;
uint8_t CanTxData[8];
uint8_t CanRxData[8];

HAL_StatusTypeDef status;
uint32_t Reg_Val;

/* USER CODE END PM */

ADC_HandleTypeDef hadc1;
ADC_HandleTypeDef hadc2;
ADC_HandleTypeDef hadc3;

CAN_HandleTypeDef hcan1;

DAC_HandleTypeDef hdac;

I2C_HandleTypeDef hi2c1;
I2C_HandleTypeDef hi2c2;

SPI_HandleTypeDef hspi2;

TIM_HandleTypeDef htim11;

UART_HandleTypeDef huart2;

osThreadId defaultTaskHandle;
/* USER CODE BEGIN PV */
extern int tcpecho_init();

/* USER CODE END PV */

void SystemClock_Config(void);
static void MX_GPIO_Init(void);
static void MX_ADC1_Init(void);
static void MX_ADC2_Init(void);
static void MX_DAC_Init(void);
static void MX_SPI2_Init(void);
static void MX_ADC3_Init(void);
static void MX_CAN1_Init(void);
static void MX_I2C1_Init(void);
static void MX_USART2_UART_Init(void);
static void MX_I2C2_Init(void);
static void MX_TIM11_Init(void);
void StartDefaultTask(void const * argument);

/* USER CODE BEGIN PFP */
//Redriect printf to USB CDC
int _write(int file, char *ptr, int len)
{
  CDC_Transmit_FS((uint8_t*)ptr, len);
  return len;
}


//overide HAL_CAN_RxFifo0MsgPendingCallback
__weak void HAL_CAN_RxFifo0MsgPendingCallback(CAN_HandleTypeDef *hcan)
{
  printf("CAN RX Callback\n");
}

/* USER CODE END PFP */

/**
  * @brief  The application entry point.
  * @retval int
  */
int main(void)
{
  /* MCU Configuration--------------------------------------------------------*/

  /* Reset of all peripherals, Initializes the Flash interface and the Systick. */
  HAL_Init();

  /* Configure the system clock */
  SystemClock_Config();

  /* Initialize all configured peripherals */
  MX_GPIO_Init();
  MX_ADC1_Init();
  MX_ADC2_Init();
  MX_DAC_Init();
  MX_SPI2_Init();
  MX_ADC3_Init();
  MX_CAN1_Init();
  MX_I2C1_Init();
  MX_USART2_UART_Init();
  MX_I2C2_Init();
  MX_TIM11_Init();
  /* USER CODE BEGIN 2 */
  HAL_TIM_Base_Start_IT(&htim11);
  /* USER CODE END 2 */

  /* USER CODE BEGIN RTOS_MUTEX */
  /* add mutexes, ... */
  /* USER CODE END RTOS_MUTEX */

  /* USER CODE BEGIN RTOS_SEMAPHORES */
  /* add semaphores, ... */
  /* USER CODE END RTOS_SEMAPHORES */

  /* USER CODE BEGIN RTOS_TIMERS */
  /* start timers, add new ones, ... */
  /* USER CODE END RTOS_TIMERS */

  /* USER CODE BEGIN RTOS_QUEUES */
  /* add queues, ... */
  /* USER CODE END RTOS_QUEUES */

  /* Create the thread(s) */
  /* definition and creation of defaultTask */
  osThreadDef(defaultTask, StartDefaultTask, osPriorityNormal, 0, 8192);
  defaultTaskHandle = osThreadCreate(osThread(defaultTask), NULL);

  /* USER CODE BEGIN RTOS_THREADS */
  /* add threads, ... */
  /* USER CODE END RTOS_THREADS */

  /* Start scheduler */
  osKernelStart();
  /* We should never get here as control is now taken by the scheduler */
  /* Infinite loop */
  /* USER CODE BEGIN WHILE */
  while (1)
  {
    /* USER CODE END WHILE */

    /* USER CODE BEGIN 3 */
  }
  /* USER CODE END 3 */
}

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
/* USER CODE BEGIN Header_StartDefaultTask */
/**
  * @brief  Function implementing the defaultTask thread.
  * @param  argument: Not used
  * @retval None
  */
/* USER CODE END Header_StartDefaultTask */
void StartDefaultTask(void const * argument)
{
  /* init code for USB_DEVICE */
  MX_USB_DEVICE_Init();

  /* init code for LWIP */
  MX_LWIP_Init();
  /* USER CODE BEGIN 5 */
  extern struct netif gnetif;
  status = HAL_ETH_ReadPHYRegister(&heth,PHY_BSR, 0x10, &Reg_Val);
  if((Reg_Val & 1UL) == 0UL){
    printf("TCP SERVER WILL START AFTER CABLE WILL BE PLUGED IN!!!\n\r");
  }
  else{
    printf("TCP SERVER STARTED\n\r");
    server_is_running_flag = 1;
    dhcp_start(&gnetif);
    tcp_server_init();
  }
 
  printf("TCP Server started\n");
  printf("DELAY 25us\n");
  _2500_ns_delay(40);
  printf("BOOTED FROM DFU\n");
  HAL_CAN_Start(&hcan1);
  HAL_CAN_ActivateNotification(&hcan1, CAN_IT_RX_FIFO0_MSG_PENDING);
  CanTxHeader.DLC = 1;
  CanTxHeader.ExtId = 0;
  CanTxHeader.IDE = CAN_ID_STD;
  CanTxHeader.RTR = CAN_RTR_DATA;
  CanTxHeader.StdId = 0x65;
  CanTxHeader.TransmitGlobalTime = DISABLE;

  CanTxData[0] = 0x3d;

  HAL_DAC_SetValue(&hdac, DAC_CHANNEL_1, DAC_ALIGN_12B_R, 0x0);
  HAL_GPIO_WritePin(MUXes_1to5_nEN_GPIO_Port, MUXes_1to5_nEN_Pin, GPIO_PIN_RESET);
  HAL_GPIO_WritePin(MUXes_1to5_A0_GPIO_Port, MUXes_1to5_A0_Pin, GPIO_PIN_RESET);
  HAL_GPIO_WritePin(MUXes_1to5_A1_GPIO_Port, MUXes_1to5_A1_Pin, GPIO_PIN_RESET);
  HAL_GPIO_WritePin(MUXes_1to5_A2_GPIO_Port, MUXes_1to5_A2_Pin, GPIO_PIN_RESET);
  HAL_GPIO_WritePin(NMOS_SHFT_1TO5_SRCLR_GPIO_Port, NMOS_SHFT_1TO5_SRCLR_Pin, GPIO_PIN_RESET);
  HAL_GPIO_WritePin(NMOS_SHFT_1TO5_NOE_GPIO_Port, NMOS_SHFT_1TO5_NOE_Pin, GPIO_PIN_RESET);

  HAL_GPIO_WritePin(MUXes_6to10_nEN_GPIO_Port, MUXes_6to10_nEN_Pin, GPIO_PIN_RESET);
  HAL_GPIO_WritePin(MUXes_6to10_A0_GPIO_Port, MUXes_6to10_A0_Pin, GPIO_PIN_RESET);
  HAL_GPIO_WritePin(MUXes_6to10_A1_GPIO_Port, MUXes_6to10_A1_Pin, GPIO_PIN_RESET);
  HAL_GPIO_WritePin(MUXes_6to10_A2_GPIO_Port, MUXes_6to10_A2_Pin, GPIO_PIN_RESET);
  HAL_GPIO_WritePin(NMOS_SHFT_6TO10_SRCLR_GPIO_Port, NMOS_SHFT_6TO10_SRCLR_Pin, GPIO_PIN_RESET);
  HAL_GPIO_WritePin(NMOS_SHFT_6TO10_NOE_GPIO_Port, NMOS_SHFT_6TO10_NOE_Pin, GPIO_PIN_RESET);
  /* Infinite loop */
  for(;;)
  {
    HAL_GPIO_TogglePin(STATUS_LED_GPIO_Port, STATUS_LED_Pin);
    //HAL_CAN_AddTxMessage(&hcan1, &CanTxHeader, CanTxData, &CanTxMailbox);

    

    if(server_is_running_flag == 0){
      status = HAL_ETH_ReadPHYRegister(&heth,PHY_BSR, 0x10, &Reg_Val);
      if((Reg_Val & 1UL) == 0UL){
        printf("TCP SERVER WILL START AFTER CABLE WILL BE PLUGED IN!!!\n\r");
      }
      else{
        printf("TCP SERVER STARTED\n\r");
        server_is_running_flag = 1;
        dhcp_start(&gnetif);
        tcp_server_init();
      }
    }
    

    osDelay(500);
  }
  /* USER CODE END 5 */
}

/**
  * @brief  Period elapsed callback in non blocking mode
  * @note   This function is called  when TIM14 interrupt took place, inside
  * HAL_TIM_IRQHandler(). It makes a direct call to HAL_IncTick() to increment
  * a global variable "uwTick" used as application time base.
  * @param  htim : TIM handle
  * @retval None
  */
void HAL_TIM_PeriodElapsedCallback(TIM_HandleTypeDef *htim)
{
  /* USER CODE BEGIN Callback 0 */
  if (htim->Instance == TIM11) {
    _us_tick++;
  }

  /* USER CODE END Callback 0 */
  if (htim->Instance == TIM14) {
    HAL_IncTick();
  }
}

/**
  * @brief  This function is executed in case of error occurrence.
  * @retval None
  */
void Error_Handler(void)
{
  /* USER CODE BEGIN Error_Handler_Debug */
  /* User can add his own implementation to report the HAL error return state */
  __disable_irq();
  while (1)
  {
  }
  /* USER CODE END Error_Handler_Debug */
}

#ifdef  USE_FULL_ASSERT
/**
  * @brief  Reports the name of the source file and the source line number
  *         where the assert_param error has occurred.
  * @param  file: pointer to the source file name
  * @param  line: assert_param error line source number
  * @retval None
  */
void assert_failed(uint8_t *file, uint32_t line)
{
  /* USER CODE BEGIN 6 */
  /* User can add his own implementation to report the file name and line number,
     ex: printf("Wrong parameters value: file %s on line %d\r\n", file, line) */
  /* USER CODE END 6 */
}
#endif /* USE_FULL_ASSERT */
