FilipPaul/DIPLOMKA/(commit log)

2023-03-07 recreating all active repositories
    [8pins_together.SchDoc, ALL_80_pins.SchDoc, ALL_channels.SchDoc, Bill of Materials-Ovladaci_karta.csv, Bill of Materials-diplomka_hiearchical.xlsx, Copy of Bill of Materials-Ovladaci_karta.xlsx, Ethernet.SchDoc, LED_INDICATOR.SchDoc]
2023-03-26 final PCB ovladaci karta
    [Bill of Materials-Ovladaci_karta.csv, Copy of Bill of Materials-Ovladaci_karta.xlsx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]
2023-04-05 assembly for tester
    [BOM-Ovladaci_karta(AssembledForTester).csv, BOM_EXCELL-Ovladaci_karta(AssembledForTester).xlsx, Bill of Materials-Ovladaci_karta.csv, Copy of Bill of Materials-Ovladaci_karta.xlsx, Ethernet.SchDoc, Opto_outputs.SchDoc, Ovladaci_karta.PrjPcb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]
